Liu3Beng-A/Dummy/docs/地轨PID默认值调整_20261017.md

# 地轨 PID 默认值调整（2026-10-17）

## 用户要求与范围

按用户截图，将地轨（节点7、57电机）默认位置环参数调整为：

| 参数 | 调整前的电机工厂默认 | 本轮默认 |
|---|---:|---:|
| KP | 350 | 150 |
| KV | 320 | 180 |
| KI | 25 | 25 |
| KD | 50 | 50 |

电机固件和新上位机保持一致，文档同步记录要求、修改和生效条件。截图中的“最近回读KP=250”是当时设备值，不作为旧工厂默认值。其他节点默认值、控制算法、控制频率、保护及存储分区均不调整；未授权或执行自动写入设备、烧录及Git提交。

## 源码改动

- `firmware_new/dummy-motor-fw/UserApp/main.cpp`：仅修改 `MOTOR_TYPE == 57` 工厂默认初始化的KP/KV及日期注释。CMake的 `motor-57` 目标显式定义该类型，运行时固定节点7。35、42、夹爪仍为原来的200/80/300/250。
- `Dummy上位机/app/protocol/constants.py`：定义 `RAIL_PID_DEFAULTS`，值为150/180/25/50。
- `Dummy上位机/app/core/parameter_edits.py`：首次创建motor/7的PID编辑状态时使用上述默认；其他节点和非PID参数沿用原逻辑。已有编辑状态不重建，不改界面布局。
- 新上位机模型、控制器及UI的参数测试覆盖节点7默认、切换节点、保留草稿和真实回读优先；此前PID内联说明检查一并回归。
- 本记录、上位机README、地轨方案、旧PID协议记录及SESSION同步最新要求；旧参数/协议历史不删除。

根目录 `串口助手_old.py` 没有电机工厂默认表，其PID初始0只是查询前占位，仍通过查询显示实际值；本轮未新增接口或改变其占位行为，也未改只供参考的 `串口助手.py`。

## 生效方式

电机配置加载仍是有效EEPROM优先。无有效配置或用户显式执行恢复默认流程时，新工厂默认才写入配置；仅升级固件不会覆盖已保存的PID，不需要为改PID清除编码器校准表。

新上位机选择节点7、首次尚未回读时，编辑框使用150/180/25/50，最近回读仍为空，不把本地初始值当成设备值，也不会自动发送。未改过的字段收到实际回读后采用真实值；已有草稿保留，回读单独更新。切换页面或节点不会用新默认覆盖草稿。

若现有设备也要采用这组值，可在失能后选择节点7，填入150/180/25/50，点击“保存PID”，再“读取PID”核对。该保存沿用现有 `#SET_PID 7 150 180 25 50`，直接写EEPROM；普通转发确认不等于EEPROM物理保存完成。本轮未替用户下发该指令。

## 构建与验证

统一构建命令：

```powershell
powershell -NoProfile -ExecutionPolicy Bypass -File .\tools\build_firmware.ps1 -ReleaseId 2026101703
python .\tools\verify_firmware_artifacts.py
```

五套ELF/MAP/HEX/BIN/manifest均在唯一当前目录 `firmware_artifacts/`：

- release：`2026101703`
- buildset：`B60B807480C2475D`
- source SHA256：`84e03afc0323228bb53b0d03328496539217f6faa8b604118e2b8efd3d177390`
- 相对17.02的生产源码摘要仅 `dummy-motor-fw/UserApp/main.cpp` 改变。主控、35、42、夹爪BIN去掉56字节固件身份后均与原版一致；只需为本次默认值变化更新57电机，仍遵守EEPROM优先。

| 目标 | Flash使用/余量（B） | linked RAM使用/余量（B） |
|---|---:|---:|
| 主控 | 615820 / 301684 | 125312 / 5760 |
| motor-35 | 96660 / 620 | 15576 / 4904 |
| motor-42 | 96660 / 620 | 15576 / 4904 |
| motor-57 | 96652 / 628 | 15576 / 4904 |
| motor-gripper | 96444 / 836 | 15576 / 4904 |

各目标Flash、linked RAM及相关 `.su` 栈记录相比17.02均无增量。电机的流式执行、编码器更新、20kHz回调和位置闭环六个热路函数，去除符号目标前的重定位地址后，解码指令及调用结构一致。最初逐字节比较因57链接中数学库地址重定位而拒绝，已保留该方法修正说明，没有将其当成控制算法变化或掩盖实机失败。

新上位机参数模型、控制器、UI及PID说明共51项测试通过，耗时32.348秒；覆盖未回读默认不伪造回读、不自动发送、节点往返保留草稿、实际值更新未修改字段并保留已修改字段。静态构建/栈记录不能代替实机调参、栈水位或20kHz周期测量，未声称这组PID已在本轮实机验证。

## 留证与后续

`firmware_artifacts/verification.json`、`CURRENT_RELEASE.txt`、`SHA256SUMS.txt`为本次当前产物记录。`firmware_artifacts/rail-pid-defaults-2026101703/`保留上一批48个正式产物/校验文件、基线哈希、链接差异审计及本轮测试/源码记录；历史包不是当前烧录来源。

现有17.02主控纯计算诊断能力保持，不据此恢复普通MoveL、连续手柄或任何尚未通过实机验收的路径。并行离线研究已获知正式身份与电机默认源发生外部授权变化，应继续使用其原冻结副本，不把新批次替代原研究证据。
