Liu3Beng-A/Dummy/docs/地轨电机加入方案.md

# 地轨电机加入方案（地轨仅加入 MoveJ，不加入 MoveL 逆解）

> **2026-10-17 当前参数**：按用户新要求，J7（57）工厂默认PID调整为 `KP=150、KV=180、KI=25、KD=50`，新上位机节点7未回读的初始编辑值同步。有效EEPROM仍优先，未自动覆盖设备现有值；其他节点默认值不变。要求、改动和验证见[地轨PID默认值调整记录](地轨PID默认值调整_20261017.md)。下文加入方案及旧参数均为历史记录，最新运动能力以源码及SESSION_STATUS为准。

> **2026-10-08 历史参数**：整体回退后，用户要求单独恢复J7（57）源码默认PID为`KP=350、KV=320、KI=25、KD=50`，已修改默认表并编译motor-57。已有有效EEPROM仍优先，不自动覆盖已保存参数。其余代码维持87288fb，PID事务/独立SAVE_PID仍未恢复。详见[SESSION_STATUS](SESSION_STATUS.md)。

> **2026-10-08 回退时状态（历史）**：已按用户要求恢复`87288fb23b20e1f35513e5a044fa25099d4d7122`，J7源码默认PID恢复`KP=300、KV=50、KI=30、KD=100`，有效EEPROM仍优先。本轮350/320/25/50默认值和PID事务改动均已撤销；下条保留为历史记录。详见[SESSION_STATUS](SESSION_STATUS.md)。

> **2026-10-08 历史参数试改（已撤销）**：按用户指定，J7（57）默认 PID 更新为 `KP=350、KV=320、KI=25、KD=50`，已有有效 EEPROM 仍优先；PID 应用/保存流程见 [PID调参与保存协议及测试说明](PID调参与保存协议及测试说明.md)。后续 2026-10-06 参数与测试结果保留为历史记录，不能视为新参数的实机验证。

> 编制日期：2026-10-01
> 编制人：Cursor Agent（用户授权任务）
> 涉及模块：`firmware_new/dummy-ref-core-fw`（主控）、`firmware_new/dummy-motor-fw`（电机驱动）
> 参考：`firmware/ref_core_f405`、`firmware/motor_fw_f103_57`
> 当前任务范围：**仅**加入地轨并打通 MoveJ 闭环。MoveL 逆解等高级特性本次**不**纳入。

> 2026-10-06 参数更新：J7（57）位置环 DCE 默认值采用用户实机确认的 `KP=300、KV=50、KI=30、KD=100`。100档地轨±90mm的三组SEQ往返方向差为16、25、23ms；仅降低KD到100的前一组仍相差547ms。新默认值只在EEPROM配置无效、启动初始化默认表时使用，已有有效EEPROM参数继续优先生效，不自动覆盖用户设置。57电流命令设置上限已开放到3.0A，默认电流仍为2.5A；本轮成功实测采用此前已回读确认的3.0A设置。其余章节保留加入地轨时的历史范围和方案，后续功能以当前源码及SESSION_STATUS为准。

---

## 1. 背景与目标

### 1.1 当前 firmware_new 状态（v2026-10-01）

`firmware_new` 是从 `firmware_old` 出发、逐步把 `firmware` 已积累功能搬迁过来的"重构目标树"。截至本次任务开始：

- **主控** `firmware_new/dummy-ref-core-fw/Robot/instances/dummy_robot.{h,cpp}`
  - `motorJ[0]` = ALL 广播代理（nodeID=0）
  - `motorJ[1..6]` = J1~J6 关节（nodeID=1~6，使用 `CtrlStepMotor`）
  - `hand` = `DummyHand`（**nodeID=7**，走 0x01 电流限制 / 0x02 角度协议，不走 0x07 限速位置环）
  - `motorJ[]` 数组长度只有 7（含 index 0），没有地轨位
  - `MoveJ()` 仅接 j1~j6 六个关节角
  - `MoveJoints()` / `IsMoving()` / `UpdateJointAngles()` / `Reboot()` 全部按 J1~J6 实现
  - 命令解析 `ParseCommand()` 解析 `>` / `&` / `@` 时只解 6 个浮点关节角 + 速度
  - OLED 显示 6 个关节角 + XYZ/ABC 笛卡尔位姿

- **电机端** `firmware_new/dummy-motor-fw/UserApp/`
  - `configurations.h` 中**已定义** `RAIL_FIXED_NODE_ID = 7`、`GRIPPER_FIXED_NODE_ID = 8`
  - `main.cpp` 中**仅**在 `#if MOTOR_TYPE == 8` 时强制 canNodeId = GRIPPER_FIXED_NODE_ID=8；57 电机段目前走的还是 DIP 拨码读到的 defaultNodeID（**未**强制为 7）
  - `main.cpp` 中 57 电机的默认 PID/DCE 参数 `(kp=200, kv=80, ki=300, kd=250)` 仍然等同于 35/42 通用值，**未**采用 `firmware/motor_fw_f103_57` 的 57 电机专属参数
  - `main.cpp` 中 57 电机电流限 3000 mA、`ratedCurrentAcc = 2*1000`（与 35/42 一致，**未**采用参考版本的 50 A/s 慢爬坡）
  - `CMakeLists.txt` 已配置 4 个目标 `motor-35 / motor-42 / motor-57 / motor-gripper` 一次产出 3+1 个 hex/binary

- **电机端** `firmware_new/dummy-motor-fw/Ctrl/Motor/`
  - `motor.h` 中**没有** `StallMode_t` 状态机、`ResetGoalsToCurrentPosition()` 等 57 电机专属字段
  - `motor.cpp` `CloseLoopControlTick()` 中**没有** STALL_LOCKED 闭环维持、`stallStartTick` 检测、`stallDetectRisingEdge` 上升沿等逻辑
  - `interface_can.cpp` 中**没有** 0x09 广播急停、0x5A/0x5B/0x5C 堵转相关命令、SetEnable 重构逻辑

### 1.2 PROJECT_GUIDANCE 协议（目标态）

依据 `.cursor/rules/PROJECT_GUIDANCE.mdc §1.1`：

| nodeID | 含义 | 备注 |
|---|---|---|
| 0 | ALL 广播代理 | 1 帧触发所有电机响应 |
| 1~6 | J1~J6 关节 | 与 MoveJ 顺序对齐 |
| **7** | **地轨** | **与关节同级别**，参与 `IsMoving()`、OLED 屏幕位置显示等 |
| **8** | **夹爪** | 最低级别，**不**参与 `IsMoving()`、**不**进 OLED |

也就是说：**当前代码里夹爪占了 ID=7，地轨尚不存在**。加入地轨要做的不只是新增 `motorJ[7]`，还要把夹爪的 ID 从 7 → 8 同步挪位。

### 1.3 本次任务目标（用户明确）

1. 主控固件：在 `firmware_new/dummy-ref-core-fw` 中加入地轨（nodeID=7），与 J1~J6 同级。
2. 电机固件：`firmware_new/dummy-motor-fw` 必须按 57 电机专属参数加入；保持 CMakeLists.txt 一次编译出 3 个电机固件（35 / 42 / 57）+ 1 个夹爪固件。
3. 地轨 ID **必须**为 7，电流、限速、PID/DCE、加速度等参数**参照**之前的版本（即 `firmware/motor_fw_f103_57` 与 `firmware/ref_core_f405` 的取值）。
4. **本次只加入 MoveJ**（点位同步），**不**做 MoveL 的地轨逆解；`MoveL()` 维持当前 J1~J6 IK，地轨位置保持不变。
5. 完成后输出一份方案文档（本文档），描述需要做什么工作。

---

## 2. 总体方案

### 2.1 节点表（最终态）

```
nodeID=0   → ALL 代理（占位）             CtrlStepMotor(_hcan, 0, …)
nodeID=1~6 → J1~J6 关节                   CtrlStepMotor(_hcan, 1..6, …)
nodeID=7   → J7 / 地轨                    CtrlStepMotor(_hcan, 7, true, 1, -250, 250)
nodeID=8   → 夹爪                          StepHand（继承 CtrlStepMotor, hcan, 8）
```

**`motorJ[]` 数组长度由 7 → 8**（索引 0 是 ALL 代理，1..6 是 J1~J6，7 是地轨）。`hand` 仍是独立指针，ID 由 7 改为 8。

### 2.2 复用现有 `CtrlStepMotor` 而不是新增类

参考 `firmware/ref_core_f405` 的做法：地轨电机使用与 J1~J6 **完全相同**的 `CtrlStepMotor` 类，不引入新的地轨驱动类。理由：

1. 电机端协议栈（0x01/0x07/0x14/0x15/0x17~0x1A 等）已通用，57 电机端固件只要烧同一份，**主控侧无需差异代码**。
3. reduction=1（直连丝杆 1605，5 mm/圈）；位置含义以"圈数 × 5 = mm"换算；
4. `angleLimitMin/Max = -250 / 250`（mm 单位）作为软限位栅栏，越界 MoveJ 一律拒绝（仿照参考 `firmware/ref_core_f405`）。

`firmware/ref_core_f405` 中地轨类多做了"伪°"换算和 `inverse=true`，本次实现要保留这个语义。

### 2.3 关于 StepHand（夹爪）

当前 `DummyHand` 实现类独占通道阶（独立 `CAN_TxHeaderTypeDef txHeader`、独立协议 0x01/0x02），但参考 `firmware/ref_core_f405` 已改用 `StepHand : public CtrlStepMotor`，更通用、命令集与关节一致。本期**保持**当前 `DummyHand` 类结构不变（最小变动原则），但把构造时的 nodeID 7 改为 8 即可。

如果将来要统一为 `StepHand`，可作单独一期任务。

---

## 3. 主控侧改动（`firmware_new/dummy-ref-core-fw`）

### 3.1 文件清单

| 文件 | 改动 |
|---|---|
| `Robot/instances/dummy_robot.h` | ① 增加 `RAIL_FIXED_NODE_ID = 7` 声明；② `motorJ[]` 长度 7→8；③ 加地轨成员（位置/目标位置）；④ 加 MoveJ 7 参数签名；⑤ 增加速度单位/上限常量；⑥ `hand` 注释更新 ID；⑧ 把 `jointAll` protocol 对象名仍指向 motorJ[ALL]，但要在 protocol list 里加 `rail`（可选）。 |
| `Robot/instances/dummy_robot.cpp` | ① 构造里 `new motorJ[7]` 并填构造参数；② `Delete` 循环 0..6 → 0..7；③ `Reboot()` 里给 motorJ[7] 多发一帧 0x7F 广播或保留现有 ALL 代理 1 帧（前者更稳）；④ `MoveJ()` 改为 7 参数（j1~j6 + j7_mm + speed），做地轨限位校验、计算 7 轴同步速度；⑤ `MoveJoints()` 改为 J1~J6 + 地轨电机分别下发；⑥ `UpdateJointAngles()` 轮询 1..7；⑦ `UpdateJointAnglesCallback()` 增加地轨位置回填；⑧ `IsMoving()` flag 改为 `0b01111110` (J1~J6 位为 1，地轨位 bit0 恒 0)；⑨ `Reboot()` 含 ALL 代理 1 帧即可，已能广播到 7 个电机。 |
| `UserApp/protocols/can_protocol.cpp` | 无需改动（`dummy.motorJ[id]->UpdateAngleCallback(...)` 已按 id 寻址，新加的 motorJ[7] 自动支持）。 |
| `UserApp/main.cpp` | ① `ThreadControlLoopFixUpdate()` 中 `MoveJoints()` 和 `UpdateJointPose6D()` 调用保持，UpdateJointAngles 轮询已包含地轨。② `ThreadOledUpdate()` 中加地轨显示位（详见 §3.6）。 |
| `Robot/instances/dummy_robot.h/.cpp` 增加地轨速度换算常量。 | `RAIL_MM_PER_CIRCLE = 5.0f`（丝杆 1605：5 mm/圈）。 |

### 3.2 `dummy_robot.h` 关键修改示意

```cpp
#define ALL 0
#define RAIL_FIXED_NODE_ID 7   // 与 configurations.h 对齐
#define RAIL_MM_PER_CIRCLE 5.0f // 丝杆1605

class DummyRobot {
    // ... 既有 REST_POSE 等 ...

    // 地轨状态变量（mm）
    float currentRailPos = 0.0f;
    float targetRailPos  = 0.0f;

    // 7 个电机的速度缓存（电机轴 r/s, 索引 0=地轨, 1..6=J1~J6）
    float dynamicJointSpeeds7[7] = {0};

    // motorJ: 0=ALL, 1..6=J1..J6, 7=J7/地轨
    CtrlStepMotor* motorJ[8] = {nullptr};
    DummyHand* hand = {nullptr};

    // MoveJ 加 2 个参数：_j7_mm 和 _speed
    bool MoveJ(float _j1, float _j2, float _j3, float _j4,
               float _j5, float _j6, float _j7_mm, float _speed = 0);

    // ... 其他既有 API ...

    auto MakeProtocolDefinitions() {
        return make_protocol_member_list(
            make_protocol_function("homing",         *this, &DummyRobot::Homing),
            make_protocol_function("resting",        *this, &DummyRobot::Resting),
            make_protocol_object("joint_1", motorJ[1]->MakeProtocolDefinitions()),
            make_protocol_object("joint_2", motorJ[2]->MakeProtocolDefinitions()),
            make_protocol_object("joint_3", motorJ[3]->MakeProtocolDefinitions()),
            make_protocol_object("joint_4", motorJ[4]->MakeProtocolDefinitions()),
            make_protocol_object("joint_5", motorJ[5]->MakeProtocolDefinitions()),
            make_protocol_object("joint_6", motorJ[6]->MakeProtocolDefinitions()),
            make_protocol_object("joint_all", motorJ[ALL]->MakeProtocolDefinitions()),
            make_protocol_object("hand", hand->MakeProtocolDefinitions()),
            make_protocol_function("reboot", *this, &DummyRobot::Reboot),
            make_protocol_function("set_enable", *this, &DummyRobot::SetEnable, "enable"),
            // ... 其他既有协议项保持 ...
            // move_j 参数加 j7 和 speed（默认 11 维持兼容，但本期以 8 参数为主）
            make_protocol_function("move_j", *this, &DummyRobot::MoveJ,
                                 "j1", "j2", "j3", "j4", "j5", "j6", "j7", "speed"),
            make_protocol_function("move_l", *this, &DummyRobot::MoveL,
                                   "x", "y", "z", "a", "b", "c")
            // ... 其他保持 ...
        );
    }
};
```

### 3.3 `dummy_robot.cpp` 关键修改

**构造与析构**：

```cpp
DummyRobot::DummyRobot(CAN_HandleTypeDef* _hcan) : hcan(_hcan) {
    motorJ[0] = new CtrlStepMotor(_hcan, 0, false, 1, -180, 180);
    motorJ[1] = new CtrlStepMotor(_hcan, 1, false, 50, -175, 175);
    motorJ[2] = new CtrlStepMotor(_hcan, 2, true,  50,  -75,  90);
    motorJ[3] = new CtrlStepMotor(_hcan, 3, true,  50,    0, 180);
    motorJ[4] = new CtrlStepMotor(_hcan, 4, true,  50, -270, 270);
    motorJ[5] = new CtrlStepMotor(_hcan, 5, true,  50, -100, 100);
    motorJ[6] = new CtrlStepMotor(_hcan, 6, true,  30, -180, 180);
    // [NEW] 地轨：直连丝杆1605, 5mm/圈, 软限位 -250~250 mm
    motorJ[7] = new CtrlStepMotor(_hcan, 7, true, 1, -250, 250);

    hand = new DummyHand(_hcan, 8);    // [FIX] 夹爪 ID: 7 → 8

    dof6Solver = new DOF6Kinematic(...);
}

DummyRobot::~DummyRobot() {
    for (int j = 0; j <= 7; j++)   // [FIX] 0..6 → 0..7
        delete motorJ[j];
    delete hand;
    delete dof6Solver;
}
```

**MoveJ**（核心：仿参考 `firmware/ref_core_f405` 的 7 轴版本，按当前 `firmware_new` 简化）：

```cpp
bool DummyRobot::MoveJ(float _j1, float _j2, float _j3, float _j4,
                       float _j5, float _j6, float _j7_mm, float _speed) {
    DOF6Kinematic::Joint6D_t targetJointsTmp(_j1, _j2, _j3, _j4, _j5, _j6);

    // 地轨限位
    if (_j7_mm > motorJ[7]->angleLimitMax || _j7_mm < motorJ[7]->angleLimitMin)
        return false;
    // 关节限位
    for (int j = 1; j <= 6; j++) {
        if (targetJointsTmp.a[j-1] > motorJ[j]->angleLimitMax ||
            targetJointsTmp.a[j-1] < motorJ[j]->angleLimitMin)
            return false;
    }

    // 本期简化版：先按用户给定 speed 直接下发（按各轴距离反推电机轴 r/s）
    // 后续同步抵达算法可参考 ComputeSyncSpeeds 实现，但本期不要求
    float slider = _speed > 0 ? _speed : (jointSpeedSlider); // 1~100
    float baseRps = slider * 0.30f;  // 100 → 30 r/s

    DOF6Kinematic::Joint6D_t deltaJoints = targetJointsTmp - currentJoints;
    float deltaRail = _j7_mm - currentRailPos;
    uint8_t idx;
    float maxJointAngle = AbsMaxOf6(deltaJoints, idx);
    float maxAbs = maxJointAngle;
    if (fabsf(deltaRail) > maxAbs) maxAbs = fabsf(deltaRail);
    // 单轴限速 30 r/s；地轨直连 reduction=1 直接 rps；关节 reduction=50 转/°×s/360
    for (int j = 1; j <= 6; j++) {
        float rps = fabsf(deltaJoints.a[j-1]) * motorJ[j]->reduction / 360.0f / maxAbs * baseRps;
        dynamicJointSpeeds7[j] = rps;
    }
    dynamicJointSpeeds7[0] = fabsf(deltaRail) / 5.0f / maxAbs * baseRps;

    jointsStateFlag = 0;
    targetJoints = targetJointsTmp;
    targetRailPos = _j7_mm;
    return true;
}
```

> ⚠️ **修订（2026-10-01 续）**：上示"按距离比例限速"是中间稿方案，存在**单位混用 + 没有物理上限 + 没有加速度约束**三大缺陷（详见 §3.3.1 §A）。**该方案将被 §3.3.1 物理同步算法替换**，但为了便于对照"为什么需要升级"，原始简化版保留在此处作为参考。下文 §3.3.1 为加强版方案，将由本次工作一并落地。
>
> 本期实现用最简单的"按距离比例限速"，**不**上 v2.7 那种"按梯形曲线模型+加速度感知的迭代同步抵达"。**为什么**：当前任务边界是"打通 MoveJ"，不是"上整套同步抵达算法"。`ComputeSyncSpeeds` 涉及加速度回填、梯形时间、迭代收敛，工程量大；本期先做基础联调，留 TODO 在 `MoveJ` 注释里。
>
> 如果用户后续要升级，再独立安排任务。

### 3.3.1 加强版：物理同步算法（梯形曲线 + 迭代收敛）

> **状态**：在 §3.3 简化版"按距离比例限速"基础上加强。本节方案与参考版本 `firmware/ref_core_f405/Robot/instances/dummy_robot.cpp:31-128` 的 `ComputeSyncSpeeds` v2.7 对齐。
>
> **简化版与加强版的关系**：简化版代码保留在 §3.3 作为对照（中间稿）；加强版代码将直接替换 §3.3 中 `MoveJ` 的速度分配段落。
>
> **索引约定**：本节数组索引 `[0..6]` 7 个槽位 — `i=0`=地轨，`i=1..6`=J1~J6。与 §3.3 的 `dynamicJointSpeeds7[7]` 索引相反（那里 `dynamicJointSpeeds7[0]`=地轨，`[1..6]`=关节）；调用时需做一次索引映射。

#### A. 为什么做加强版

简化版"按距离比例限速"存在三个根本缺陷，无法满足"7 轴同步抵达"的物理语义：

| 缺陷 | 说明 |
|---|---|
| **单位混用** | `maxAbs = max(maxJoint(°), |Δrail(mm)|)` 把"度"和"毫米"直接比大小。当 `J1=90°`+`rail=100mm` 时，`maxAbs=100`（mm 更大），关节会被压速；反之 `J1=180°`+`rail=50mm` 时，`maxAbs=180`，地轨被压速。同步语义取决于"哪个数字碰巧更大"，与物理无关。 |
| **没有物理上限** | 不查每轴 `ratedVelocity`（电机端 EEPROM 上限速 `velocityLimit`）。简化版下发的速度可能超过电机端能力，被电机端梯形曲线再次压回，结果是"主控说 3.33s 跑完，电机端 4.2s 才到位"，IsMoving() 的 FINISH 时间与主控预估不一致。 |
| **没有加速度约束** | 电机端 PositionTracker 走梯形加减速，主控的"瞬时到顶速"模型与电机端不一致。短距离运动（如 `J1=5°`）时，电机端因为距离太短会退化为三角形曲线（无匀速段），主控以为的匀速段在电机端根本不存在。 |

**对比示例**（`slider=100`、`V_max=30 r/s`、地轨与 J1 同跑、J1 用 `A=150 r/s²`）：

| 输入 | 简化版预估时间 | 加强版预估时间 | 差异原因 |
|---|---|---|---|
| `J1 90°`，`rail=0` | 3.0s | 0.825s（电机轴 20 r/s × 360/50=144°/s） | 简化版用 `baseRps=30` 给关节分摊，关节角速度 = 30°/s；加强版按 J1 物理 V_max=30 r/s 走，速度=144°/s |
| `J1 0°`，`rail=100mm` | 3.33s | 0.97s | 简化版按数值归一化；加强版按 rail 物理 V_max=30 r/s 走 |
| `J1 90°`，`rail=100mm` | 3.33s | ~1.1s | 加强版迭代收敛到 T_sync ≈ max(T_j1, T_rail) ≈ 1.1s |

物理同步版能正确利用每轴的物理上限，同步时间显著紧凑，且每轴速度不超过电机端 `velocityLimit`。

#### B. 算法概述

每个电机端跑自己的梯形曲线（`firmware_new/dummy-motor-fw/Ctrl/Motor/motion_planner.cpp PositionTracker`）。主控要为 7 个轴算出"同一时刻到达"的匀速段速度 `v_i`：

```
已知：
  D_i   — 各轴电机轴转数（关节: |Δ°| × reduction/360；地轨: |Δmm| / 5）
  V_max_i — 各轴额定速度（电机端 EEPROM velocityLimit；本期用主控常量）
  A_i   — 各轴额定加速度（电机端 EEPROM velocityAcc；本期用主控常量）
  sliderSpeed — 用户意图上限（slider × 0.30 r/s，slider∈[1,100]）

约束：
  各轴匀速段速度 v_i ≤ min(V_max_i, sliderSpeed)
  梯形曲线时间 T_i = timeTrapezoid(D_i, v_i, A_i)
  同步时间 T_sync = max_i(T_i) 最小化
```

**步骤 1**：把每个轴目标位移换算成电机轴圈数
```
D_motor[0] = |Δmm| / RAIL_MM_PER_CIRCLE   // 地轨 reduction=1
D_motor[i] = |Δ°| × MOTOR_REDUCTION[i] / 360   // i=1..6
```

**步骤 2**：单轴梯形曲线总时间 `timeTrapezoid(D, v, a)`
```
d_acc = v² / (2a)            // 单边加速距离
if 2*d_acc >= D:              // 距离太短 → 三角形（无匀速段）
    T = 2 × sqrt(D / a)
else:                          // 梯形（加速→匀速→减速）
    T = 2v/a + (D - 2*d_acc)/v = v/a + D/v
```

**步骤 3**：迭代收敛（最多 10 轮，一般 2~3 轮收敛）

- **初始预算**：`T_sync = max_i timeTrapezoid(D_i, min(V_max_i, sliderSpeed), A_i)`
- **每轮**：对每个轴解二次方程反推匀速段速度
  ```
  T = v/a + D/v
  → v² - (T·a)·v + D·a = 0
  → v = (T·a - sqrt((T·a)² - 4·D·a)) / 2
  ```
  - 钳制：`v = min(v, V_max_i, sliderSpeed)`
  - 用 `v` 重算 `timeTrapezoid(D_i, v, A_i)` → 新一轮的 `T_sync`
- **收敛**：`|T_new - T_sync| < 1e-3` 退出

**步骤 4**：输出 `outSpeeds[7]`（电机轴 r/s）+ `timeBudget`（同步总时间，秒）

> ⚠️ 二次方程判别式 `< 0` 处理：当 `T_sync` 不足某轴跑完所需最低三角形时间时，`disc<0`。钳到 0 让反推公式自然算出"刚够用"的速度，避免短距离运动突然飙到 cap。

#### C. 改动清单

**主控** `firmware_new/dummy-ref-core-fw`：

| 文件 | 改动 |
|---|---|
| `Robot/instances/dummy_robot.h` | ① 加 `constexpr uint8_t MOTOR_REDUCTION[7] = {1, 50, 50, 50, 50, 50, 30}`；② 加 `constexpr float SLIDER_CAPS_V[7] = {30, 30, 30, 30, 30, 30, 30}`（电机轴 r/s 上限，本期统一 30）；③ 加 `constexpr float JOINT_ACC_FALLBACK[7] = {30, 150, 100, 200, 200, 200, 200}`（r/s²，主控常量兜底）；④ 加 `float jointAccRuntime[7] = {30, 150, 100, 200, 200, 200, 200}`（运行时回填槽，本期用上面常量初始化，异步回填逻辑属 §9 #7 不在本期） |
| `Robot/instances/dummy_robot.cpp` | ① 加静态函数 `timeTrapezoid(D, v, a)`；② 加静态函数 `ComputeSyncSpeeds(deltaRails[7], sliderCaps[7], accel[7], sliderSpeed, outSpeeds[7])`；③ `MoveJ` 内的"按距离比例限速"段落替换为调用 `ComputeSyncSpeeds` 输出 `dynamicJointSpeeds7[7]`；④ 顺手把 `motorJ[7]` 构造参数从字面量 `7` 改为 `RAIL_FIXED_NODE_ID`（**已改**） |

**电机端** `firmware_new/dummy-motor-fw`：**不动**。

**串口助手** `串口助手_old.py`：**不动**。

**文档**：本文档 §3.3.1（新增）。

#### D. 关键参数取值

| 轴 | MOTOR_REDUCTION | SLIDER_CAPS_V (r/s) | JOINT_ACC_FALLBACK (r/s²) | 来源 |
|---|---|---|---|---|
| 地轨 (`id=7`) | 1 | 30 | 30 | 电机端 57 段 `velocityLimit`/`velocityAcc`（`main.cpp:75-76`） |
| J1 (`id=1`) | 50 | 30 | 150 | `DEFAULT_JOINT_ACCELERATION_BASES.a[0]=150` |
| J2 (`id=2`) | 50 | 30 | 100 | `.a[1]=100` |
| J3 (`id=3`) | 50 | 30 | 200 | `.a[2]=200` |
| J4 (`id=4`) | 50 | 30 | 200 | `.a[3]=200` |
| J5 (`id=5`) | 50 | 30 | 200 | `.a[4]=200` |
| J6 (`id=6`) | 30 | 30 | 200 | `.a[5]=200`（注意 reduction 与其它不同） |

> 注：`MOTOR_REDUCTION[6]=30` 对应 `motorJ[6] = new CtrlStepMotor(_hcan, 6, true, 30, -180, 180)`；地轨/其余关节 reduction 在主控 `dummy_robot.cpp:24-31`。

> 后续 §9 #7（PID/DCE/电流的运行时查询）落地时，可加入 `#GET_ACC` 协议回填 `jointAccRuntime[i]`，自动替换 `JOINT_ACC_FALLBACK[i]`。

#### E. 关键代码示意

```cpp
// dummy_robot.cpp（新增静态函数，文件作用域）

static float timeTrapezoid(float d, float v, float a) {
    if (d < 1e-6f || v < 1e-6f || a < 1e-6f) return 0;
    float d_acc = v * v / (2.0f * a);
    if (2.0f * d_acc >= d)
        return 2.0f * sqrtf(d / a);          // 三角形曲线
    return 2.0f * v / a + (d - 2.0f * d_acc) / v;  // 梯形曲线
}

static float ComputeSyncSpeeds(const float deltaRails[7],
                               const float sliderCaps[7],
                               const float accel[7],
                               float sliderSpeed,
                               float outSpeeds[7]) {
    // 步骤 1：距离 → 电机轴圈数（索引 0=地轨 mm，1..6=关节°）
    float distMotor[7];
    for (int i = 0; i < 7; i++) {
        distMotor[i] = (i == 0)
            ? fabsf(deltaRails[i]) / RAIL_MM_PER_CIRCLE
            : fabsf(deltaRails[i]) * (float)MOTOR_REDUCTION[i] / 360.0f;
    }

    // 步骤 2：初始预算 = 各轴在 sliderSpeed（钳到 cap）下的梯形时间，取 max
    float timeBudget = 0;
    for (int i = 0; i < 7; i++) {
        if (distMotor[i] < 1e-6f) continue;
        float a = (accel[i] > 1e-6f) ? accel[i] : JOINT_ACC_FALLBACK[i];
        float v = fminf(sliderSpeed, sliderCaps[i]);
        float t = timeTrapezoid(distMotor[i], v, a);
        if (t > timeBudget) timeBudget = t;
    }
    if (timeBudget < 1e-6f) {
        for (int i = 0; i < 7; i++) outSpeeds[i] = 0;
        return 0.0f;
    }

    // 步骤 3：迭代收敛（最多 10 轮）
    for (int iter = 0; iter < 10; iter++) {
        float newTimeBudget = 0;
        for (int i = 0; i < 7; i++) {
            if (distMotor[i] < 1e-6f) { outSpeeds[i] = 0; continue; }
            float a = (accel[i] > 1e-6f) ? accel[i] : JOINT_ACC_FALLBACK[i];
            float vc = sliderCaps[i];
            float disc = timeBudget * timeBudget - 4.0f * distMotor[i] / a;
            if (disc < 0) disc = 0;     // 临界抖动
            float v = (timeBudget - sqrtf(disc)) * a * 0.5f;
            if (v > vc) v = vc;
            if (v > sliderSpeed) v = sliderSpeed;
            outSpeeds[i] = v;
            float t = timeTrapezoid(distMotor[i], v, a);
            if (t > newTimeBudget) newTimeBudget = t;
        }
        if (fabsf(newTimeBudget - timeBudget) < 1e-3f) {
            timeBudget = newTimeBudget;
            break;
        }
        timeBudget = newTimeBudget;
    }
    return timeBudget;
}
```

`MoveJ` 中替换段：

```cpp
// 替换 §3.3 MoveJ 中"按距离比例限速"段（dummy_robot.cpp:103-122）
float slider = _speed > 0 ? _speed : 50.0f;
if (slider < 1) slider = 1;
if (slider > 100) slider = 100;
float sliderSpeedRps = slider * 0.30f;          // 100 → 30 r/s

// 各轴目标位移：索引 0=地轨 mm，1..6=关节°
float deltaRails[7] = {
    _j7_mm - currentRailPos,                    // 地轨 mm
    targetJointsTmp.a[0] - currentJoints.a[0],
    targetJointsTmp.a[1] - currentJoints.a[1],
    targetJointsTmp.a[2] - currentJoints.a[2],
    targetJointsTmp.a[3] - currentJoints.a[3],
    targetJointsTmp.a[4] - currentJoints.a[4],
    targetJointsTmp.a[5] - currentJoints.a[5],
};
float jointAcc[7] = {
    jointAccRuntime[0], jointAccRuntime[1], jointAccRuntime[2],
    jointAccRuntime[3], jointAccRuntime[4], jointAccRuntime[5],
    jointAccRuntime[6],
};

float outSpeeds[7] = {0};
float timeBudget = ComputeSyncSpeeds(deltaRails, SLIDER_CAPS_V, jointAcc,
                                    sliderSpeedRps, outSpeeds);
// （可选）Respond(*uart4StreamOutputPtr, "ok t=%.3f", timeBudget);

// 写回 dynamicJointSpeeds7：[0]=地轨，[1..6]=J1..J6
dynamicJointSpeeds7[0] = outSpeeds[0];
for (int j = 1; j <= 6; j++) {
    dynamicJointSpeeds7[j] = outSpeeds[j];
    dynamicJointSpeeds.a[j - 1] = outSpeeds[j];   // ServoJ 兼容旧字段
}

jointsStateFlag = 0;
targetJoints = targetJointsTmp;
targetRailPos = _j7_mm;
return true;
```

#### F. 测试用例（烧录后）

| 输入 | 期望同步时间 | 验证方式 |
|---|---|---|
| `>0,0,0,0,0,0,0,100`（不动） | 0（所有轴距离=0） | 串口助手日志；电机端无 CAN 0x07 下发 |
| `>0,0,90,0,0,0,0,100` | 0.825s | J3 电机端 0x22/0x23 回包 FINISH 时间 |
| `>0,0,0,0,0,0,100,100` | 0.97s | 地轨电机端 FINISH 时间 |
| `>0,0,90,0,0,0,100,100` | ~1.1s | 7 个电机 FINISH 时间聚集在 ±50ms |
| `>90,90,90,90,90,90,100,100`（全轴大动作） | ~2.5s | 7 个电机同时完成 |
| `>0,0,5,0,0,0,0,100`（短距离） | ~0.3s（三角形曲线） | 验证距离太短时退化为三角形 |

#### G. 不在本节范围（与 §9 一致）

- 电机端回填 `jointAccRuntime[i]`（task §9 #7）— 本节用 `JOINT_ACC_FALLBACK[i]` 兜底
- 串口助手 `_fill_joints` 修复（task 范围外，已知 bug）
- `#GETJPOS` 含 rail + `#REBOOT` 支持 7/8（task 范围外，已知 bug）

**MoveJoints**：分别下发 J1~J6 + 地轨。

```cpp
void DummyRobot::MoveJoints(DOF6Kinematic::Joint6D_t _joints) {
    for (int j = 1; j <= 6; j++) {
        motorJ[j]->SetAngleWithVelocityLimit(_joints.a[j-1] - initPose.a[j-1],
                                             dynamicJointSpeeds.a[j-1]);
    }
    // 地轨：mm → 电机轴圈数 = mm / 5
    motorJ[7]->SetAngleWithVelocityLimit(targetRailPos, dynamicJointSpeeds7[0]);
}
```

**UpdateJointAngles / UpdateJointAnglesCallback / IsMoving**：

```cpp
void DummyRobot::UpdateJointAngles() {
    // 简单轮询：本期先每帧查一个轴，1~7 循环（仿参考 v3.2 方案C）
    static int idx = 1;
    motorJ[idx]->UpdateAngle();
    idx = (idx >= 7) ? 1 : idx + 1;
}

void DummyRobot::UpdateJointAnglesCallback() {
    for (int i = 1; i <= 6; i++) {
        currentJoints.a[i-1] = motorJ[i]->angle + initPose.a[i-1];
        if (motorJ[i]->state == CtrlStepMotor::FINISH)
            jointsStateFlag |= (1 << i);
        else
            jointsStateFlag &= ~(1 << i);
    }
    // 地轨：motorJ[7]->angle 单位是"电机轴圈×360"（reduction=1）
    // 反推 mm: motorJ[7]->angle / 360 × 5
    currentRailPos = motorJ[7]->angle / 360.0f * RAIL_MM_PER_CIRCLE;
    // 地轨回包到位也置 bit7 标记（与 J1~J6 同样算"已到位"）
    // 但本期 IsMoving 用 6 个关节就够（地轨与臂同步），简化起见：
    // 地轨位 bit7 不强制置位，IsMoving 主要看 J1~J6 bit1~6
}

bool DummyRobot::IsMoving() {
    return jointsStateFlag != 0b01111110;  // bit1~6 全置位 → FINISH
    // 注：bit0/7 不参与判定。地轨走 motorJ[7]->state 自行判定。
}
```

**Reboot / SetEnable / !STOP**：参考 `firmware/ref_core_f405` 的设计：

```cpp
void DummyRobot::Reboot() {
    // ALL 代理 1 帧 → (0<<7)|0x7F = 0x7F, 触发 J1~J7 同时重启
    motorJ[ALL]->Reboot();
    hand->Reboot();
    osDelay(500);
    HAL_NVIC_SystemReset();
}

void DummyRobot::SetEnable(bool _enable) {
    motorJ[ALL]->SetEnable(_enable);   // ALL 代理广播使能（含地轨）
    hand->SetEnable(_enable);
    isEnabled = _enable;
    if (_enable) motorJ[ALL]->UpdateAngle();  // 预发一次回包请求
}
```

> 后期 `!STOP` 软停（按 PROJECT_GUIDANCE §1.1：夹爪不参与急停）接入时，本期 `Reboot/SetEnable` 不需要改；仅在 `CommandHandler::EmergencyStop` 中跳过 hand 即可。

**Homing / Resting**：仿参考实现：

```cpp
void DummyRobot::Homing() {
    float lastSpeed = jointSpeed;
    SetJointSpeed(10);
    MoveJ(0, 0, 90, 0, 0, 0, 0, 10);   // J1~J6 = 0,0,90,0,0,0 + 地轨 = 0mm
    MoveJoints(targetJoints);
    while (IsMoving()) osDelay(10);
    SetJointSpeed(lastSpeed);
}
```

**ParseCommand (`>`、`&` 命令解析)**：本期将命令格式由 6 关节改为 7 关节 + speed（参考实现）：

```cpp
case COMMAND_TARGET_POINT_SEQUENTIAL:
case COMMAND_TARGET_POINT_INTERRUPTABLE:
case COMMAND_CONTINUES_TRAJECTORY:
    if (_cmd[0] == '>' || _cmd[0] == '&') {
        // 新格式：>j1,j2,j3,j4,j5,j6,j7(rail),speed
        float j1, j2, j3, j4, j5, j6, j7, speed = 0;
        int argNum;
        if (_cmd[0] == '>')
            argNum = sscanf(_cmd.c_str(), ">%f,%f,%f,%f,%f,%f,%f,%f",
                            &j1, &j2, &j3, &j4, &j5, &j6, &j7, &speed);
        else
            argNum = sscanf(_cmd.c_str(), "&%f,%f,%f,%f,%f,%f,%f,%f",
                            &j1, &j2, &j3, &j4, &j5, &j6, &j7, &speed);

        if (argNum == 8) SetJointSpeed(speed);
        if (argNum >= 7) {
            if (MoveJ(j1, j2, j3, j4, j5, j6, j7, speed)) {
                MoveJoints(targetJoints);
                // 立刻回应 ok
                Respond(*usbStreamOutputPtr, "ok");
                Respond(*uart4StreamOutputPtr, "ok");
            }
        }
    }
    break;
```

> ⚠️ 串口助手_old需要同步支持新格式（`>j1,j2,j3,j4,j5,j6,j7,speed`）。`串口助手_old.py` 改起来不大，但要列入交付清单。

### 3.4 `MoveL` 不改

按用户明确要求，本期 **MoveL 不动**。`MoveL()` 仍只解 J1~J6 IK，地轨位置保持不变。在 `MoveL` 末尾补一句：

```cpp
// 本期：MoveL 不动地轨；地轨保持当前位置
targetRailPos = currentRailPos;
return MoveJ(/* new IK joints */, currentRailPos, 0);
```

（或者保持现有 `MoveL` 不返回地轨参数，在 caller（ParseCommand）处把 `targetRailPos` 同步为 currentRailPos。）

### 3.5 Reboot 验证

参考 `firmware/ref_core_f405` 的"ALL 代理 1 帧 + 夹爪 1 帧"模式，已经能把 J1~J7 + 夹爪（共 8 个电机）全部重启，无需在主控多发 1 帧地轨的 0x7F 帧。

### 3.6 OLED 显示（ThreadOledUpdate）

`firmware/ref_core_f405` 把地轨作为单独的 OLED 行，本期至少要在 J1~J6 行后加一项地轨 mm 值：

```cpp
oled.setCursor(0, 30);
oled.printf(">%3d|%3d|%3d|%3d|%3d|%3d|%3dmm",
            (int) roundf(dummy.currentJoints.a[0]),
            (int) roundf(dummy.currentJoints.a[1]),
            (int) roundf(dummy.currentJoints.a[2]),
            (int) roundf(dummy.currentJoints.a[3]),
            (int) roundf(dummy.currentJoints.a[4]),
            (int) roundf(dummy.currentJoints.a[5]),
            (int) roundf(dummy.currentRailPos));
```

按 PROJECT_GUIDANCE §1.1 "参与 OLED 屏幕位置显示"，地轨 mm 值需要显示。

### 3.7 串口助手同步

`串口助手.py` 中发送 `>` / `&` 指令处需要支持新格式（7 个关节 + 地轨 mm + 速度）。这是上位机层面的配套改动，**不**改固件逻辑。

---

## 4. 电机端改动（`firmware_new/dummy-motor-fw`）

### 4.1 文件清单

| 文件 | 改动 |
|---|---|
| `UserApp/configurations.h` | 已定义 `RAIL_FIXED_NODE_ID = 7`，无需改。 |
| `UserApp/main.cpp` | ① 57 电机段（`#if MOTOR_TYPE == 57`）的 boardConfig 默认值：电流2500mA、DCE kp=300/kv=50/ki=30/kd=100（2026-10-06实测更新）、stall protect 默认 true；② 57 电机段增加 `boardConfig.canNodeId = RAIL_FIXED_NODE_ID` 强制设置；③ 57 电机段 `ratedCurrentAcc = 50 * 1000`（mA/s）。 |
| `Ctrl/Motor/motor.h` | **本期不引入** StallMode 状态机（用户边界只到 MoveJ）。Stall Protect 默认开启在 main.cpp 里写死即可。 |
| `Ctrl/Motor/motor.cpp` | **本期不引入** STALL_LOCKED 闭环维持等代码。 |
| `UserApp/protocols/interface_can.cpp` | **本期不引入** 0x09 广播急停、0x5A/0x5B/0x5C 等命令。 |
| `CMakeLists.txt` | 已有 4 个目标，无需改。 |

### 4.2 `main.cpp` 中 57 电机参数改造

默认表最初参考 `firmware/motor_fw_f103_57/UserApp/main.cpp`，其中DCE四项已按2026-10-06的J7实机结果更新，结合 `firmware_new/dummy-motor-fw` 现有格式：

```cpp
#elif MOTOR_TYPE == 57
    boardConfig = BoardConfig_t{
        .configStatus = CONFIG_OK,
        .encoderHomeOffset = 0,
        .defaultMode = Motor::MODE_COMMAND_POSITION,
        // 57地轨电机：参考版本 currentLimit=2500~2800mA
        .currentLimit = 2500,                  // mA
        .velocityLimit = 30 * Motor::MOTOR_ONE_CIRCLE_SUBDIVIDE_STEPS,  // 30 r/s
        .velocityAcc   = 30 * Motor::MOTOR_ONE_CIRCLE_SUBDIVIDE_STEPS,  // 30 r/s²
        .calibrationCurrent = 2000,
        // J7 DCE defaults confirmed by the 2026-10-06 bidirectional 100-speed test.
        .dce_kp = 300, .dce_kv = 50, .dce_ki = 30, .dce_kd = 100,
        .motor_temperature = 0.0,
        .enableMotorOnBoot = false,
        .enableStallProtect = true,   // 57 地轨默认开启堵转保护
        .enableTempWatch = false,
    };
```

并在 57 段底部加：

```cpp
#if MOTOR_TYPE == 57
    motor.config.motionParams.ratedCurrentAcc = 50 * 1000;  // mA/s
    // 强制 nodeID（不读 DIP 开关）
    boardConfig.canNodeId = RAIL_FIXED_NODE_ID;
#elif MOTOR_TYPE == 8
    motor.config.motionParams.ratedCurrentAcc = 2 * 1000;   // mA/s（与通用一致）
    boardConfig.canNodeId = GRIPPER_FIXED_NODE_ID;
#endif
```

> 注：57 电机的 PID 参数（kp/ki/kd）和堵转保护开关的差异化逻辑（motor.config.ctrlParams.pid 与 .stallProtectSwitch）**本期不在 motor.h/.cpp 引入**，仅在 main.cpp 中通过 boardConfig 写 eeprom 默认值即可。这避免了与本期任务边界外的代码改动交叉。

### 4.3 一次产出 3 个电机固件

`firmware_new/dummy-motor-fw/CMakeLists.txt` 现状已经满足：

```cmake
set(MOTOR_TARGETS motor-35 motor-42 motor-57 motor-gripper)
set(MOTOR_TYPES 35 42 57 8)
foreach ... add_executable(${TARGET_NAME}.elf ...) ...
```

构建命令（PowerShell，参照 PROJECT_GUIDANCE §4.2）：

```powershell
cd E:\Dummy-code\firmware_new\dummy-motor-fw\build
cmake -G Ninja ..
ninja           # 默认 Debug；一次产出 4 个 hex/binary
```

产物：

- `build/motor-35.{elf,hex,bin}`
- `build/motor-42.{elf,hex,bin}`
- `build/motor-57.{elf,hex,bin}` ← **地轨固件，烧到 57 电机板**
- `build/motor-gripper.{elf,hex,bin}` ← 夹爪固件，烧到夹爪板

### 4.4 motor.h/motor.cpp/interface_can.cpp 不动

明确：**本期**（仅 MoveJ）**不**引入堵转状态机 / 0x09 广播急停 / 0x5A/0x5B/0x5C 命令。这意味着：

- 电机端 `motor.controller->stallMode`、`ResetGoalsToCurrentPosition()` 等不实现；
- 主控 `dummy_robot.cpp` 的 `Reboot()` 仍走 ALL 代理 1 帧（已覆盖 J1~J7），无需新增 0x09 广播帧；
- `!STOP` 软停本期沿用当前 `EmergencyStop` 实现（`MoveJ(currentJoints)`），夹爪保持不参与（按 PROJECT_GUIDANCE，但本期 `!STOP` 软停分支也不一定启用）。

---

## 5. 主控构建与烧录

### 5.1 构建命令

```powershell
cd E:\Dummy-code\firmware_new\dummy-ref-core-fw\build
cmake -G Ninja ..
ninja
```

产物：`build/dummy-ref-core-fw.elf` + `.hex` + `.bin`。

### 5.2 烧录

`stlink.cfg` 已存在，烧录：

```powershell
ST-LINK_CLI.exe -c SWD -p build/dummy-ref-core-fw.hex -V
```

---

## 6. 验收清单（测试矩阵）

| 项 | 命令 / 操作 | 期望 |
|---|---|---|
| ① ALL 广播使能 | `!START` | 电机反馈收到 0x01 帧，扭矩释放（地轨 J7 同步） |
| ② 关节点位同步 | `>0,0,90,0,0,0,0,30` | 7 轴同步抵达 ~30°/s 速度（地轨 6 mm/s ≈ 0.2 r/s）；IsMoving() 在末端返回 false |
| ③ 地轨单独走 | `>0,0,0,0,0,0,90,30` | 仅地轨运动；地轨 mm 位回读到主控；OLED `J7=90mm` |
| ④ 地轨限位 | `>0,0,0,0,0,0,300,30` | 返回 `error: joint out of limits` |
| ⑤ ALL 代理 reboot | `!REBOOT` | J1~J7 同时重启；地轨电机按相同策略重启 |
| ⑥ 夹爪 ID 验证 | `hand.set_enable(true)` | 0x01 帧 StdId = `(8<<7)\|0x01 = 0x401`，不是 0x381 |
| ⑦ OLED 显示 | 看主控 OLED | 显示 6 关节 + 1 地轨 mm |
| ⑧ 串口助手兼容 | `串口助手.py` `>` 指令 | 默认按新格式 `>j1,j2,j3,j4,j5,j6,j7,speed` 发 |

---

## 7. 风险与缓解

| 风险 | 缓解 |
|---|---|
| MoveJ 改 7 参数签名后，旧 `>` / `&` 6 参数指令不能用了 | 文档强制更新 + 串口助手同步；调试期保留 6 参数分支（仅 J1~J6，地轨不动）。 |
| ALL 代理 + 夹爪两帧 Reboot 时，地轨若已断电会被"延迟响应" | ALL 帧 + 500ms 延时足够；夹爪独立帧兜底；本期不增加 0x09 急停帧。 |
| 地轨 7 轴同步算法本期只按距离比例限速 | ~~后续单独任务上 v2.7 `ComputeSyncSpeeds`（按梯形曲线模型）。本期留 TODO。~~ **已升级**：本期由 §3.3.1 物理同步算法替换；参考 `firmware/ref_core_f405` 的 v2.7 实现，含梯形曲线 + 迭代收敛。每轴速度受 V_max 物理上限钳制，时间预算通过二次方程反推匀速段速度。 |
| 电机端 57 段参数与参考版本不完全一致（缺少 stall 状态机） | 用户明确边界如此；本期 main.cpp 仍按参考值写默认值，参数差异不影响正常 MoveJ。 |
| EEPROM 现有数据残留（非 57 的 boardConfig 结构） | 57 电机烧录后首次上电会因 `configStatus != CONFIG_OK` 走默认表，自动覆盖；不需要手动擦 flash。 |

---

## 8. 改动文件总结

### 8.1 主控（firmware_new/dummy-ref-core-fw）

- [x] `Robot/instances/dummy_robot.h`（加 `RAIL_FIXED_NODE_ID`、`RAIL_MM_PER_CIRCLE`、电机数组 8 槽、地轨字段、MoveJ 7 参数签名）
- [x] `Robot/instances/dummy_robot.cpp`（构造/析构/限位校验/MoveJ 限位/Reboot/Homing/Resting/ParseCommand 8 参数/EmergencyStop）
- [x] `UserApp/main.cpp`（OLED 加地轨显示）
- [x] `UserApp/protocols/can_protocol.cpp`（无需改，确认电机端 ID 回包协议兼容）
- [x] **统一性补丁**：把 `motorJ[7]` 构造参数从字面量 `7` 改为 `RAIL_FIXED_NODE_ID`（`dummy_robot.cpp:31`）
- [x] **§3.3.1 物理同步算法**：加 `timeTrapezoid` + `ComputeSyncSpeeds` 静态函数，`MoveJ` 速度分配从"按距离比例限速"替换为梯形曲线 + 迭代收敛

### 8.2 电机端（firmware_new/dummy-motor-fw）

- [ ] `UserApp/main.cpp`（57 电机参数 + RAIL_FIXED_NODE_ID 强制）

### 8.3 上位机

- [ ] `串口助手.py`（`>`/`&` 指令支持 7 关节 + speed）

### 8.4 文档

- [x] 本文档 `docs/地轨电机加入方案.md`

---

## 9. 不在本期范围（后续任务）

1. 堵转状态机（StallMode_t / ResetGoalsToCurrentPosition / 0x5A/0x5B/0x5C）。
2. 0x09 ALL 广播急停（`!STOP` 软停统一路径）。
3. MoveL 地轨逆解（地轨位置由 IK 输出联动）。
4. SRV / TRQ / MOTOR_TUNING 模式对接地轨。
5. `DummyHand` → `StepHand` 重构（与 J1~J7 共用 `CtrlStepMotor`）。
6. ~~v2.7 7 轴同步抵达算法（梯形曲线 + 加速度感知 + 迭代收敛）。~~ **已迁入 §3.3.1**，作为本期加强项。
7. PID/DCE/电流的运行时查询（jointAccRuntime[] / jointCurrentLimitRuntime[]）。
8. RGB 灯效模式与电机状态绑定。

---

## 10. 实施顺序（建议）

1. **电机端先**：改 `firmware_new/dummy-motor-fw/UserApp/main.cpp` 57 段参数；编译 4 个 hex/binary 验证 CMakeLists.txt 不破。
2. **主控先静态化**：改 `dummy_robot.h` 加地轨字段、改签名（不改语义），确保编译过。
3. **主控加功能**：改 `dummy_robot.cpp` 构造/析构/MoveJ 限位/Reboot/SetEnable/IsMoving/Homing/Resting/ParseCommand。
4. **主控 OLED**：在 `ThreadOledUpdate` 加地轨显示。
5. **主控统一性补丁**：把 `motorJ[7]` 构造参数从字面量 `7` 改为 `RAIL_FIXED_NODE_ID`。
6. **§3.3.1 物理同步算法集成**：在 `dummy_robot.h` 加 `MOTOR_REDUCTION[7]` / `SLIDER_CAPS_V[7]` / `JOINT_ACC_FALLBACK[7]` / `jointAccRuntime[7]`；在 `dummy_robot.cpp` 加 `timeTrapezoid` + `ComputeSyncSpeeds`，替换 `MoveJ` 速度分配段。
7. **串口助手**：更新发送格式。
8. **联合调试**：烧主控 + 烧 57 电机固件，按 §6 + §3.3.1 §F 验收清单逐项过。

---

## 附录 A：参考依据文件路径

- 主控参考：`firmware/ref_core_f405/Robot/instances/dummy_robot.{h,cpp}`
- 电机端参考：`firmware/motor_fw_f103_57/UserApp/{main.cpp,configurations.h}`
- 协议常量：`firmware_new/dummy-motor-fw/UserApp/configurations.h`（已有 RAIL_FIXED_NODE_ID）
- 现有主控：`firmware_new/dummy-ref-core-fw/Robot/instances/dummy_robot.{h,cpp}`
- 项目指南：`.cursor/rules/PROJECT_GUIDANCE.mdc`

---
