Liu3Beng-A/Dummy/docs/MoveL离线研究记录_20261015.md

# MoveL离线研究记录：七轴协调、速度损失与快速改向

日期：2026-10-15，时区Asia/Shanghai。本文是持续维护的研究记录，不是论文，也不是生产实施或硬件验收结论。

最新更新：第10.6～10.8节保存本轮最终结论：滑块永久延期根因修复且全帧动态合规，但快接续/短停车都存在响应退步，手柄快速改向仍未普遍解决，尚无可直接移植生产的统一候选。全部原B/D对照、失败、超出原探索计划的协议修订、新留出及独立审查保留。第9节588组守护exit0及第8节历史5448组exit3异常各自保留，不混写。

## 1 当前任务、授权与用途

用户要求继续集中研究主控轻量七轴跟随，报告分析结果，并及时保留过程和数据；未来可能根据最终方案写论文。本轮可继续修改两份既有离线测试源码，更新研究文档及生成离线产物；不改生产固件、协议或上位机，不连接/操作设备，不自动提交。论文目的不扩大授权，不预设已具有论文新颖性。

当前三项需求须同时考察：TCP近似直线；手柄/滑块快速短距离更新；地轨协调参与。用户未接受以逐点停稳替代连续跟随。主控继续求解，PC发送意图或目标；主机离线实验不等于采用PC运动后端。

源码入口：`tools/tests/cartesian_follow_lite_test.cpp`、`tools/tests/run_cartesian_follow_lite_test.py`。当前生产已有原生有限MoveL，不能把历史“仅终点IK转MoveJ”误写为现状；本离线原型不等于该生产执行链已验证。

## 2 证据保存规则

每批使用新的`firmware_artifacts/cartesian-follow-lite-*`目录，不覆盖已有结果，保留：

1. 冻结源码及SHA256、源身份清单、全部参数和初始姿态；实验分组的唯一标识与相对原方案差异。
2. Python、编译器、平台和数学实现模式，编译/运行实际命令及日志；环境不能确定时标未知，不补造版本。
3. 原始`results.json`、`traces.csv`、控制更新与电机分支观察，以及生成汇总和图的脚本。
4. 完成、拒绝、超限、停止、未完成样例；不得只挑好看的轨迹或把故意断反馈与普通失败混合平均。
5. 假设、预期可否证结果、实际观察、解释限制和后续变更。运行中的保护哈希批次不得同时修改受保护文档，研究文档在批次前后更新。

证据分层：研究假设→模型内观察→单因素/交互反事实对照→板上完整计算预算→硬件动态和几何测量。低一层证据不能替代高一层。当前未做真实PID、机械、编码器噪声、CAN/RTOS或完整F405周期测量；不声称实时预算、实机性能或新颖性已通过。

## 3 已有方案与可复现批次

保留A=`baseline`旧轻量跟随，B=`coordinated`最小共同进度/联合约束，C=`coordinated_brake_lead`制动相关前瞻。B/C仍发送位置目标＋各轴速度上限，无七轴共同执行时间戳；各电机PositionTracker独立决定加减速。七轴分工为选择地轨位后转换TCP，再调用六轴解析IK，不是通用七轴数值逆解器。

前一轮只读诊断批次：`firmware_artifacts/cartesian-follow-lite-20261015T062322788475Z`。精确数学与cmsis512插值数学各1548组，总3096组。每模式包含3控制器×12参数组×43场景/姿态组合。主要产物：`comparison.md`、`slowdown_analysis.md/.json/.png`、`slowdown_reasons.csv`、各数学模式`results.json`、`traces.csv`、`control_updates.csv`、`motor_observations.csv`、`observation_regression.json`、`snapshot/`和`source_identity.json`。最新研究矩阵另见第8节，不覆盖此批。

复现命令：

```powershell
python tools/tests/run_cartesian_follow_lite_test.py
```

以批次冻结脚本及编译日志为实际环境和命令依据。新增观察后每模式1548组原指标最大变化0，完整旧`traces.csv`字节一致；每模式约10.43亿次20kHz分支观察一致性检查无失败。该回归仅证明已比较样例输出未被观察器改变，不证明控制方案成功。

模型复用真实六轴IK/FK、TCP刚体变换和PositionTracker。20kHz执行电机参考，1ms采样FK，原轨迹5ms输出，速度使用20ms位移窗口。默认20ms主更新、60ms前瞻、TCP40mm/s；电机默认30r/s²，地轨5mm/转对应150mm/s²。三个主姿态；TCP朝向固定。没有实际电机位置闭环、载荷/摩擦/机械误差或真实通信时序。

## 4 最近诊断：已观察，未做因果消融

### 4.1 地轨配合为什么TCP约19mm/s

口径：19.36～19.39mm/s是TCP窗口均速，地轨约29.54mm/s；要求分别40/60mm/s。

|环节|默认B三个姿态的窗口均值|
|---|---:|
|输入、转向后、关节/曲率界后|40mm/s|
|反馈缩速后|20.948mm/s|
|共同参考推进|20.217mm/s|
|模型TCP|19.361～19.395mm/s|

J7在940ms主控窗口一直是主要误差来源，平均归一化倍率1.963，对应约0.982mm位置落后；0.5mm误差标尺使允许速度明显缩小。反馈缩速触发900ms。TCP主要是进度落后，平均横向偏离约0.001～0.015mm。

约950ms电机窗口内，J7距离制动456.15ms，加速493.80ms，巡航和速度帽制动0。0.500s快照：速度29.497mm/s，速度帽43.870mm/s，目标距离2.8987mm，按150mm/s²计算的制动距离2.9002mm。要求60mm/s时制动距离12mm；60ms前瞻仅对应3.6mm地轨行程，但实际目标距离还含小段和跟随误差，不可直接画等号。

结论范围：外层误差缩速和近目标本地制动同时存在；尚未确定各自独立因果贡献，不能把阶段速度差直接当成删项收益。

### 4.2 快速改向为什么延迟

短反向0.250s改向，0.500s松手；主控0.260s首次处理。B三个姿态参考归零为0.340/0.420/0.420s，新方向参考启动0.360/0.440/0.440s；原反向延迟120/195/200ms。参考转向制动100/180/180ms；改向到松手反馈缩速均0。

90°转向姿态0存在另一限制：新方向共同加速度约41mm/s²，由J4局部约束主导，曲率速度界约23mm/s；0.480s共同速度仍约5.76mm/s。它来自当前有限差分和保守系数，尚不能解释为实机物理极限。0.25～0.50s B三个姿态新Y净位移约0.346/0.203/0.639mm，须与偏差一并报告。

### 4.3 其他已知失败与未完成

C默认地轨配合f0/f1出现`branch_jump_over_12deg`，f2完成。不能一味加长前瞻或直接放宽12°门限。固定TCP移轨仍有明显途中漂移。80mm/s部分转向退化。排除故意丢反馈后B仍有有限目标较A失去完成，不能以多数改善宣称普遍通过。

10%介入/25%回收只是讨论基线，当前简化搜索只将一个样例最差余量约6.1%改善至13.6%。朝向拖动、完整工作空间、动态轨目标缓存策略、板上实时预算均未完成。

## 5 指标口径与公平比较

- 原`path_max_mm`对应控制器自身参考路径；主对照用独立用户意图路径的`intent_path_max_mm`。平滑转向若改变参考，必须同时保留原始意图、可执行参考和实际路线三者偏差，不能靠改参考获得虚假收益。
- 同时报告实际TCP/轨速度、沿线落后、横向偏离、操作净位移、停止/反向延迟、完成/拒绝、关节限位与动态边界。更慢、更少位移不能只记作几何改善。
- 主控原因按更新后保持时间统计且可重叠；电机分支按20kHz tick统计，不同窗口不得直接相加。CV包含启动/转向/停止时不得称稳态波动。
- “原反向延迟”和新增实际新方向启动阈值不同；参考归零不等于电机停止。1ms采样峰值不等于连续时间严格上界。
- 控制更新CSV在派送前取样，区分`sent_goal`和`goal_before_dispatch`。固定TCP移轨零切向时不直接使用沿线/横向分解。
- A旧停止使用模型内部速度，B/C不使用；不得在停止性能上隐去这一信息差异。外部IK次数不包括解析IK内部候选FK，不能换算完整F405预算。

## 6 本轮研究预注册：运行前计划保留

本节先于新批次写入；正式执行分组、任何必要偏离及新增假设须在结果中明确记录。本节是研究计划，不是测试通过声明。

### 6.1 研究R1：误差治理缩速×前瞻

假设H1：约19mm/s由外层进度误差缩速与本地制动耦合形成，单独归咎速度能力不足不充分。保留原A/B/C作回归锚点，在B旁加入仅供离线诊断的因子组合。正式预注册主要矩阵为固定前瞻60/120/240ms × 全局反馈缩速启用/禁用，共6组；其余普通B控制及安全门限保持，尤其保留反馈过期停止、过大误差连续停止、IK连续性拒绝和限位检查。每次清楚标记删改的唯一规则，不能静默取消其他检查。禁缩速组仅为机制消融，不能直接视作可部署候选。

主要参数组预定为`base60`、`acc10`、`speed20`、`speed2x`、`feedback20ms`、`zero_skew`、`skew6ms`；场景为`short_line_x`、`short_line_xyz`、`slider_short`、`rail_line`、`rail_hold_tcp`、`rapid_short_reverse`、`rapid_short_corner`，各3姿态。另加入第6.2节的2个诊断组后，8控制变体×7参数×7场景×3姿态=1176组/数学模式。旧A/B/C原1548组/数学模式全部继续运行回归；研究R0对应B的匹配组逐指标核对，以隔离分组开关本身的实现变化。

先用默认地轨配合三个姿态及固定TCP移轨检查机制，再对必要候选扩展原场景和反馈延迟对照。记录共同速度各阶段、地轨目标/制动距离、距离制动占时、误差来源、实际速度/几何偏差、完成/拒绝与调用量。单因素和交互结果分别列出，不把原因计时换算成因果百分比。

否证/降级条件：去缩速仍低速、增加前瞻不能稳定改善、速度提高但偏差/限位/失败恶化，都必须保留；结论只限定已测姿态、速度和模型。长前瞻若触发连续性拒绝，先记录失败位置与种类，不自动放宽12°门限。

### 6.2 研究R2：改向规则与局部约束审查

假设H2：短改向延迟部分由大于约20°的先停再转门限主动造成；90°转向f0重新起步还受局部导数/加速度限制。先还原触发、归零、新参考启动和模型实际响应各时间；分开90°与180°，不能把180°必经零速度当成可完全消除的算法开销。

本轮增加的2个消融组固定前瞻60ms，禁用先停再转，分别保留/禁用全局反馈缩速。它们仅回答门限的机制影响，不保证动态可执行。新增关节参考边界差分速度/加速度相对能力的倍率，防止参考方向突然切换制造表面跟手收益；该差分仍不是连续时间严格极值证明。普通安全门限维持不变。

审查路径参数的一阶/二阶有限差分是否在不同采样间距、缩小探测步长和数值数学模式下稳定；检查由哪个轴、哪项系数形成约41mm/s²，区分真实运动需求与数值/保守性。若开展速度矢量平滑候选，明确几何偏差预算与停止语义，不自动补走已松手的旧手柄位移；原先停再转作为对照保留。

如独立导数审查暴露新问题而需要追加实验，须作为独立批次/分组记录原因、假设及事后性，不将新增研究伪装成上述矩阵的预先计划。

评价必须同时使用原意图偏差、净位移、实际方向启动、停止距离、关节速度/加速度和失败率。单纯提前改变参考切向、实际电机尚未响应不能算收益。

### 6.3 本轮结果登记

运行前状态为待完成，未预填结果。现已完成主矩阵，正式批次、结果、完整性异常、独立审查及事后诊断追加在第8节；本节预注册设计保留，不能按观察结果倒改研究计划。

## 7 与后续论文的关系

潜在研究主题是资源受限主控中七轴冗余分配、既有位置执行器与笛卡尔在线协调的关系，尚未确定论文问题、贡献、文献差异或目标刊会。本文及冻结批次可作为未来复现材料；未做文献审查前不宣称方法新颖，未做实机前不声称实机精度、速度或实时性。失败、撤回方案及负结果同样保留。

本轮结束后优先根据可否证数据选择下一步，而不是为了论文形成而保留无收益复杂度。生产移植、协议变化、资源预算和硬件验收另行按用户授权讨论。

## 8 本轮执行结果与新的问题定位（2026-10-15）

### 8.1 实际执行、环境与结果入口

主批：`firmware_artifacts/cartesian-follow-lite-20261015T065643160059Z`。命令为：

```powershell
python tools/tests/run_cartesian_follow_lite_test.py --research
```

UTC起止为06:56:43.458285～07:04:52.485606，对应北京时间14:56:43～15:04:52。Python3.11.7 64位，Windows10.0.26200；MSVC按日志使用C++17、O2、W4、EHsc、fp:precise构建，cmsis512另定义CMSIS_INTERPOLATED。实际完整命令、可执行文件与输入SHA256见`source_identity.json`，不以此主机运行总时长代替F40520ms预算。

实际执行原计划的8控制变体×7参数×7场景×3姿态=1176组/模式，两模式新增2352组；旧A/B/C各1548组/模式继续运行，共5448组。未把研究失效组或故障停止组从矩阵删除。禁用全局反馈缩速时，位置/速度修正、硬误差停止、限位和IK检查仍保留，不能简称去掉全部反馈。

模型回归：各模式旧1548组原指标最大差0、旧trace字节一致；R0匹配原B各147组全部结果字段一致（仅标签不同）。旧观察每模式约10.43亿、新研究约7.32亿次分支一致性检查通过，控制CSV/结果导出核对通过。模型执行无error；不等于全部运动完成。

入口清单：

- 主批`research_analysis.md`、`research_results.csv`、`research_feedback_pairs.csv`、`rail_distance_envelope.json`、`protocol.json`、`protocol_snapshot/`、`source_identity.json`、`evidence_manifest.json`及两数学模式`research/`原始数据。
- `firmware_artifacts/movel-turn-analysis-20261015/phase2_matrix_analysis.md`：主矩阵完成后的独立解释与qref指标重构核对，不是新增运动控制实验。
- `firmware_artifacts/movel-derivative-audit-20261015/report.md`：4860条逐轴导数及55条/模式远点失败的独立离线审查，保留全部输入、源码、编译命令、哈希和失败。
- 同目录`phase2_report.md`及`phase2_extract.json`、`phase2_windows.json`、逐轴FK替换CSV、`phase2_manifest.json`：固定世界TCP移轨最大漂移的分段时间定位与几何重建，属于看到终点参考问题后的独立诊断。
- `firmware_artifacts/movel-research-notes-20261015/posthoc-20261015T070448590608Z/report.md`：明确标记的事后辅助速度窗口。
- `firmware_artifacts/movel-research-notes-20261015/primary_sources.md`：一手资料起点，不是系统文献综述，未移植其中算法或形成新颖性判断。

### 8.2 完整性异常：不得标整批全部通过

主批`source_identity.json`保留`exit_code=3`、`sources_unchanged=true`、`protected_unchanged=true`、`formal_artifacts_unchanged=false`。运行期间17份源码inputs及6份保护文档的哈希未变，但`firmware_artifacts/`顶层30项正式产物被并行构建改写。当前主控manifest的release2026101505、buildset BF63E123A86A4079及约06:59UTC写入时间仅用于佐证并行变化；本研究没有构建或修改生产固件，也不将离线结果绑定该正式版本。

此异常不通过改写退出码、覆盖源身份或回滚并行产物消除。可以报告模型运行、冻结输入、原运动输出回归和诊断导出核对成功；不能写成完整批次所有检查通过。后续复现实验应避开同目录正式产物的并行构建，或明确协调隔离运行时段。

逐项变化与写入时刻证据另存`firmware_artifacts/movel-research-notes-20261015/artifact_guard_incident.md/.json`，保留完整性异常的独立索引。

### 8.3 H1结果：前瞻与治理缩速确实耦合，直接禁缩速不可用

默认地轨配合，precise三个姿态全部列出于主报告。以下均为原先定义的主窗口，包含部分启动：

|固定前瞻/全局缩速|TCP主窗口均速mm/s（三姿态）|同例完成|主要情况|
|---|---|---:|---|
|60ms/开|19.361 / 19.393 / 19.395|3/3|距离制动约456ms，缩速900ms|
|60ms/关|27.922 / 26.608 / 28.046|0/3|全部tracking_over_12x_for_3updates|
|120ms/开|27.361 / 27.392 / 27.394|3/3|距离制动约415ms，缩速720ms|
|120ms/关|32.271 / 32.300 / 32.301|3/3|有更大参考落后，仍有距离制动|
|240ms/开或关|36.403 / 36.411 / 36.411|3/3|该例距离制动和缩速均0，两组输出一致|

两数学模式在这些主要趋势上一致。60ms仅取消缩速不能维持原轨速，且积累误差直至保护；说明原缩速既造成减慢，也在约束跟随误差，不能整体删除。增加前瞻能改善该场景的本地制动条件并减少误差缩速，但不足以证明固定长前瞻适合全部路径。

理想化必要距离解释：轨60mm/s、加速度150mm/s²需12mm制动距离；60ms＋20ms下一段名义领先4.8mm，仍需约7.2mm落后才能达到该目标间距，而硬误差标尺0.5mm×12为6mm并连续3次触发停止。120ms对应8.4mm名义领先、需约3.6mm落后；240ms对应15.6mm名义领先。该估算解释潜在冲突，不是闭环稳定性、精确速度或全路径可执行性的证明。

全矩阵负结果必须同时报告，precise如下。每设置有147个运动样例，其中105个有限目标；“拒绝组数”分母为147，不应与有限目标未完成数直接等同：

|设置|有限目标完成/105|拒绝组数/147|参考离散加速度>1.01倍组数/147|
|---|---:|---:|---:|
|60ms/开（原B）|100|4|36|
|60ms/关|78|29|38|
|120ms/开|100|4|36|
|120ms/关|93|14|36|
|240ms/开|89|18|35|
|240ms/关|86|21|35|
|60ms禁转向gate/缩速开|99|21|75|
|60ms禁转向gate/缩速关|73|55|77|

CMSIS两项禁缩速设置的完成数略有差异，完整表保留在主报告。240ms缩速开有16条branch_jump和2条跟随停止，有限完成降到89/105，不能作为默认最终值。固定世界TCP移轨最差漂移由约4.04mm改善到约3.86mm后基本不再改善，也没有解决全程固定TCP问题。

### 8.4 事后辅助速度窗口：单独保存，不替换主指标

看到主矩阵启动轨迹后，另提出0.8～1.2s与1.0～1.2s辅助窗口，属于事后诊断。以保存的5ms轨迹中的20ms位移速度求均值，口径不同于主指标1ms采样。所有8设置、3姿态、两模式及失败一并保留，未挑选最优时窗替组背书。

240ms默认地轨例1.0～1.2s三个姿态约40mm/s（precise40.004/40.013/39.999），说明该主窗口36.4包含启动影响；60ms缩速开同窗口约19.7，120ms开约28.2。不得因此用事后40替换预注册36.4，不能将失败组的辅助速度当正常巡航。完整原始值、主窗口对照及失败标记见posthoc报告。

### 8.5 H2结果：禁转向gate变快但参考动态不可接受，原B也有漏洞

默认短反向禁gate、保留缩速后，三个姿态原定义延迟从120/195/200降到46/78/67ms，但关节qref边界差分加速度最高为模型能力4.554/11.018/9.208倍；独立路径偏差由0.363/0.058/1.181mm升到1.764/7.278/5.054mm，姿态1触发跟随停止。90°转向最高约27.66倍且出现保护，不能把更早响应当作可执行改进。

更重要的新发现：原B并非已经动态自洽。默认`slider_short`三个姿态参考加速度约7.18/3.40/1.59倍；`rail_hold_tcp/base60/f2`约13.51倍的终点参考突变仍被原样保留。方向变化未超过gate、终点收尾等环节可能绕过标量共同速度的预期约束。先停再转或反馈开关均未修复这些路径/方向变化下的参考问题。

**固定TCP最大漂移的后续时间定位，不能称为巡航漂移。** 独立phase2审查对默认姿态2严格分段，保留全程最大为主指标：

|precise前瞻|t<2.0s最大漂移mm|t<2.12s最大漂移mm|全程最大mm/峰值时刻|
|---|---:|---:|---|
|60ms|0.076585|1.917895|4.040862 / 2.174s|
|120ms|0.051565|1.644090|3.858089 / 2.175s|
|240ms|0.051565|1.644090|3.858089 / 2.175s|

共同地轨参考在2.14s到40mm并置共同速度为零，最大漂移在其后34～36ms出现；CMSIS同样集中在停止阶段。该分段是事后机制诊断，不能用前两秒小误差替代全程最大验收，也不能外推其他姿态或实机。

但并非只在最终硬夹持时才出问题：120ms样例2.0s共同速度仍15.6386mm/s、允许速度已5.0291、剩余路径2.355mm、局部加速度界仅5.6121mm/s²。按该局部界恒定估算停止距离约21.8mm，说明当前状态已无法依靠同一局部界在剩余距离停下；这不是整条变化路径的严格停止证明。J3参考加速度2.08s已为模型界1.10倍，2.12s升到3.15倍，2.16s前馈骤零达13.51倍。必须先处理终点前可制动性及最后几步连续接续，不能只改最后一次位置夹持就宣称解决。

峰值时刻模型实际参考相对共同参考，J3落后约1.188°而轨只落后0.0626mm。FK重建误差约4.2e-8mm；将六轴替换为共同参考、保留实际轨，漂移约0.0626mm；只替换轨仍3.819mm。说明该时刻主要几何不一致在机械臂多轴组合，但单轴几何替换没有重跑动态，误差也互相抵消，不能计算独立因果贡献或仅凭J3误差最大判单轴根因。不能把3.858mm直接当作普通位置/速度接口巡航能力不足的独立证据；接口剩余能力应在参考修复后复测。

这里的倍率来自关节参考边界离散差分，揭示主控参考可能要求电机无法忠实追随的变化；不是实际电机超过加速度，也不是连续时间严格极值。Phase2逐点回归36组旧参考序列摘要一致，CSV重构与C++日志微差来自10位有效数字后二次差分。Phase2原文“CMSIS仍在运行”为当时阶段性说明；目前两模式主矩阵已完成，最新以主报告为准。

### 8.6 独立导数与远guide审查：41不主要是数值噪声，部分跳支拒绝是时间范围混淆

导数审查使用前一诊断批次冻结状态，共18状态×3数学模式×多种差分/步长，保留4860条逐轴结果，无失败过滤。double_reference仅是离线机械类型替换参考，不是固件位级参考。

姿态0在0.36s转Y，原0.5mm前向差分J4梯度3.399044°/mm、曲率−0.116638°/mm²，复现41.305731mm/s²。中心0.25mm double参考为3.426484°/mm、−0.107301°/mm²，同规则40.974951mm/s²。因此约41主要来自局部几何敏感与保守预算，不能靠改float或缩步长期待变成400。未计算完整雅可比奇异值，不直接定性为严格奇异点。

65%起步加速度预算把该状态约63.04的全额局部上界降至40.97；30%曲率预算也有保守性。带符号链式关系`q_ddot=q_s*s_ddot+q_ss*s_dot²`可形成共同加速度区间；本次仅静态核对，0.65预算下40mm/s该状态不可行，全额预算下存在区间。不能因此取消余量或保证整条路线40mm/s。公式属于既有运动学关系，非项目新贡献。

从既有CSV可重建的C远点失败55条/模式（不是全矩阵所有失败），按0.1mm连续求解且每步保留12°门限：precise47条连续到达、8条仍无IK；cmsis51248/7；double47/8。默认rail_line f0/f1累计约12.06°被直接拒绝，但小步最大仅约0.125°/0.119°，这两例不支持真实分支跳变解释。0.1mm密集链可能需约100次IK，仅为离线证据，不能照搬20ms主控循环。端点几何可连续也不保证独立电机实际沿中间路径走。

### 8.7 结论调整、未完成与下一候选

本轮主要预注册矩阵按计划执行；另保存独立导数审查、完成后矩阵解释和明确事后窗口。它们不回填成预先计划，不因有利数据改主指标。

当前没有可直接移植的最终控制器。推荐后续分别验证：

1. 先保证终点前仍有可制动路径及最后几步连续接续，再修小角度切向变化和松手/路径切换的qref约束；比较关节参考及电机20kHz输出，不仅限制一个路径速度标量。固定TCP例不能只修最终硬夹持，也不把停止阶段峰值误称为巡航能力不足。
2. 远guide采用有界、可缓存的中间路径连续验证；近下一段仍保留严格检查，真正no_ik/限位/分支变化继续拒绝。原47条只是验证机制入口，不采用无界密集搜索。
3. 再单独研究与速度、制动和正常滞后相关的前瞻，以及区分沿线落后/横向偏差的误差治理；不直接全关缩速，不直接固定240ms。
4. 七轴动态分配和带符号加速度区间之后做独立对照，保持余量与失效策略；当前快速转向锁轨，不把其J4约束当整个七轴系统的能力。

未完成：真实机械/PID/反馈/CAN/RTOS，F405完整周期耗时与RAM/栈/Flash，完整10%/25%回收、姿态拖动和完整工作空间、已有生产MoveL执行故障及普通MoveJ实机基线。论文一手资料只是入口，尚未系统相关工作和新颖性比较。

## 9 继续研究：终点、方向变化与远guide的独立可行性试验

### 9.1 运行前范围与否证条件

用户继续授权离线研究，保持第1、2节范围与潜在论文证据要求。先在三个全新、互不覆盖的artifact目录制作冻结副本原型，不先把候选合入两份公共测试源，更不改变生产。每个试验先保存protocol及实际源码/输入/环境/命令，再运行；中途修改算法必须另记修订，旧失败保留。其结果属于对已有问题的后续研究，不回填第6节为原始预注册。

1. **终点可制动性**：真实IK采样固定世界TCP、地轨0→40mm的整路径，审查带符号共同加速度区间，区分绝对值保守分配与未来约束收紧；先比较保留65%关节加速度预算的整路径保守速度/加速度及精确终点候选。必须同时报告完成/时间、qref离散动态与PositionTracker实际TCP漂移。若仅减小参考加速度仍漂移，不能宣称普通位置/速度接口已经可用。
2. **方向连续变化**：保留原B，对笛卡尔速度向量有界变化，并检查下一关节参考的离散速度/加速度，以固定最多12个近点IK候选回退；无可行下一步明确记录失败，不能冻结或跳变冒充通过。开发场景为三姿态的短滑块、短90°和反向，speed20及20ms反馈延迟为留出配置；轨固定，避免混入分配因素。该单步检查不自动保证后续仍可行，有限目标启发式也不是停止证明。
3. **远guide有界连续验证**：对既有55条/数学模式失败记录，比较固定2/4/8段或明确计数的逐级方案，顺序seed、每段保留12°及限位/FK检查；保留真实无解负例，并与旧0.1mm密集链的几何结果比较。必须报告总/最坏IK次数、失败类型和端点一致性，不能用增加段数掩盖无限工作量，也不能把几何可达当动态可执行或F405实时通过。

各试验只处理其明确的因素，不合成一个未经对照的“最终控制器”。结果后再决定哪部分值得进入两份离线公共测试文件。本轮不做实机、F405计时、固件构建或设备操作；上一批完整性异常继续保留。

### 9.2 有界guide执行对照：运行前协议

独立几何研究`movel-guide-budget-v2-20261015-20261015T072759139457Z`完成后，才新增公共两测试源的独立入口`--guide-budget-only`；这是后续新协议，不称其结果预见于9.1以前。A/B/C默认算法和旧研究矩阵保留。候选D沿用原C的制动相关前瞻，仅远guide直接失败且类型为`branch_jump_over_12deg`时，在同一路径的位置及轨位取中点，以原近点为seed检查中点，再以中点为seed检查端点。每段继续全部原IK、限位、12°检查；任一步失败拒绝，不重试直接no_ik/限位。每更新最多3次guide IK，原两probe及下一边界IK另计，本矩阵无轨搜索，整更新最多6次外部IK。调用次数不是F405耗时。

固定矩阵：原C和D各147组＝7配置（base60/acc10/speed20/speed2x/feedback20ms/zero_skew/skew6ms）×7场景（短X/XYZ、短滑块、地轨配合、固定TCP移轨、短反向/90°）×3姿态；两数学模式合计588组。原C各147组与上一冻结主批全部旧结果字段严格回归；新增计数字段不冒充旧有字段。所有配置和场景均导出20ms控制更新及原5ms轨迹，实际主指标仍为1ms FK及原速度窗口。主要指标为有限完成/105、拒绝类型/147、参考离散a超限组数及峰值、独立意图几何误差、原窗口TCP速度、响应和调用峰值。不得把避免guide拒绝等同于通过动态或终点；也不改主窗口/保护阈值来改善分数。

命令：`python tools/tests/run_cartesian_follow_lite_test.py --guide-budget-only`。运行前冻结17输入及6文档，运行后继续检查源码、文档和顶层正式产物。运行期暂停编辑保护文件；独立子研究使用各自已冻结副本。若正式产物再次并行变化仍如实记异常，不回滚他人产物。结果待运行完成后追加。

### 9.3 有界guide结果：误拒绝修复成立，动态缺陷仍在

批次`firmware_artifacts/cartesian-follow-lite-20261015T073533280234Z`，两数学模式各294组，共588组；退出码0，冻结源码、6份文档及顶层正式产物运行前后均一致。原C每模式147组全部旧字段（含嵌套诊断）严格回归，矩阵、外部IK工作上限、诊断计时/导出核对通过。新计数是观察字段，不改变旧A/B/C默认算法。默认入口和旧研究入口继续保留。

|每数学模式|原C|C＋仅跳变误拒绝时中点重试D|
|---|---:|---:|
|有限目标完成/105|86|103|
|拒绝样例/147|21|4|
|拒绝类型|18跳变、2无IK、1跟随保护|2无IK、2跟随保护|
|参考离散a>1.01倍样例/147|36|36|
|guide重试更新/成功|0/0|207/207|
|最大guide IK/完整更新外部IK|1/4|3/6|

两数学模式计数一致；precise参考a最高29.3175倍，CMSIS29.7202倍，D未修该缺陷。恢复几何求解后也可能进入后续跟随保护，不能把消除18条跳变拒绝说成18条完整成功。

默认地轨配合D三姿态均完成，原主窗口TCP速度约36.403/36.411/36.411mm/s，TCP路径max约0.228/0.286/0.024mm（precise）。原C前两姿态原本中途拒绝，第三姿态原样完成；这是C与D的单项对照。与B约19mm/s相比还包含C原有的制动相关前瞻差异，不能将全部速度收益都归因本次中点修复。

独立几何研究目录`movel-guide-budget-v2-20261015-20261015T072759139457Z`保留2401条方法/路径记录。原55失败/模式中precise47、CMSIS48条可用两段恢复；4/8段无新增覆盖，剩余为真实no_ik。合法反向全部通过，不可达与轨+251mm负例全拒绝。直接尝试＋中点重试最多3guide IK，而旧0.1mm密集诊断最多159次；密集链是离线几何参照。公共D沿用原IK内部FK位置0.1mm及旋转矩阵元素误差门限，并未额外引入几何子研究的0.05mm/0.05°独立审计阈值。局部合法几何变化仍可达约9.82°，不等于20ms动态允许变化。

公共矩阵全量导出20ms控制更新和5ms轨迹；1ms电机原始观察保持原选定子集，不声称全矩阵1ms原始轨迹齐全。所有主指标仍由1ms FK计算。详见该批`guide_budget_analysis.md`、`guide_budget_pairs.csv`、`source_identity.json`和冻结源码。

### 9.4 固定TCP移轨：几何可达余量与提前减速

独立目录`movel-stop-feasibility-v2-20261015-20261015T072438Z`保留初始协议、三次修订、真实IK/FK/PositionTracker冻结副本、路径和尾部采样、无效候选、两数学模式全部结果及原始轨迹。本研究是有限目标整路径可行基线，不是可直接合入手柄的控制器。

**问题姿态不是普通内域目标。** f2固定世界TCP移轨，沿同一数值IK支路40.155mm仍有解、40.160mm无解；40mm目标距该方向边缘仅约0.16mm，但终点最小关节限位余量约18.33%。未计算Jacobian，不能称严格奇异；此结果说明单靠10%/25%关节限位余量不足以衡量几何可达和路径动态余量。

末端J3局部q_s约−7.46°/mm、q_ss约−25°/mm²；宽±1mm拟合只得到约−5.59/−4.27，明显平滑掉端部变化。带符号共同加速度区间也可能为空，不能仅靠取消绝对值保守分配解决。原B同姿态轨目标20/30/35/40mm，precise最大漂移分别0.0579/0.1066/0.1582/4.0409mm，参考a倍率0.65/0.65/0.65/13.514；40mm压力例不能泛化为普通地轨路径都不行。

整段候选预采样40mm路径，按未来约束构造前后向可制动速度包络，初末速度0，分段恒定路径加速度精确取样；总预算65%＝曲率30%＋切向35%，导数按细尾部多窗口最大值再留系数。它是经验保守离散估计，不是连续严格极值证明。模型结果如下（precise，CMSIS趋势一致）：

|姿态|原B60ms全程漂移mm|新包络60ms漂移mm|新包络120ms漂移mm|新参考a峰值/物理A|新参考结束s|
|---|---:|---:|---:|---:|---:|
|f0|1.496|4.052|0.069|0.306|2.674|
|f1|0.996|2.889|0.091|0.398|2.491|
|f2|4.041|0.065|0.051|0.292|2.807|

三姿态新包络120ms在两数学模式均完成，全部漂移约0.05～0.10mm、参考a<0.41倍；CMSIS结束约2.48～2.89s。此结果表明该位置＋速度帽接口在这个模型和修复参考下存在可行停止样例，未证明通用接口/实机性能。相同包络60ms仍有f0/f1严重漂移，说明参考合规后前瞻和独立电机跟随问题仍须处理。原B60ms与新包络120ms不是单因素对照，不能把全部改善只归提前减速。

候选使用预定整段时序，替换了旧在线推进/全局误差缩速，保留原局部前馈/位置与估速修正及goal/cap；未实现完整在线陈旧反馈/硬误差停止契约。只覆盖固定世界TCP、轨正向、三姿态，不得将其整体直接移植生产。固定V1/2的f2虽能完成却需40.1/24.1s，5s原时限不完成，负面时间代价完整保留；原B另跑45s并确认前5s轨迹相同。

固定计划参数按precise筛选，再由两数学模式共用；不能称每模式所有标记valid候选均已动态仿真。`settled_at`为100ms稳定窗口起点，实际完成识别再晚99ms；当前样例距离5s边界充足，不改变完成计数，后续边界例必须按识别时刻判断。参考结束时间与稳定/完成识别时刻分别保留。

计算量：全路径0.05mm采样801节点/姿态，另有尾部0.005mm密扫及拟合；每数学模式主路径与尾部共6118次外部IK，不含ModelChecks与解析内部FK。前后各800次松弛，运行每20ms仍2次外部IK，未缓存。t/s/v三列double运行表裸数据19,224B，容器容量另计；改float为9,612B仅估算，未实施。若同时保留2×801×7的double导数系数还需89,712B裸数据，不能只按运行表估主控内存；现实现是主机诊断，不是固件资源设计。该完整离线预扫描并未证明适合每20ms在线重做。主机耗时不等于F405，实际RAM/栈/Flash与保护集成尚未验证。新增汇总未独立统计姿态旋转误差，不能把XYZ小漂移写成完整TCP姿态合格。

### 9.5 方向连续候选被否决：单步动态合规不足

独立目录`movel-turn-feasibility-v2-20261015-20261015T072459Z`第一阶段108组＝原B/矢量候选×3配置×3场景×3姿态×2数学模式。base60为开发，speed20和feedback20ms为留出；原B各27组全部旧字段严格回归，运行期输入/文档/正式产物哈希均未变。候选最多12次近点回退IK＋1guide，所有接受步离散参考a≤0.64914倍物理能力；未取得F405预算证据。

候选仍不可用：base60滑块f0在0.66s找不到其预设搜索线上的可接受步，明确失败；这不代表所有控制方向都无解。90°转向f0意图偏差从B0.413mm增至12.323mm；反向延迟120/195/200变为116/237/222ms，没有普遍收益。看到失败后未调参覆盖。

第二阶段仅分析冻结数据：f0在0.26s候选速度仍vx39.293、vy0.707mm/s，0.48s仍vx35.050、vy4.950；改向到松手继续旧X9.237mm，松手后再走4.623mm，参考也如此，反馈缩速始终为1。其沿“旧速度→期望速度”单线缩小修正保留了太多旧方向速度；缺少拐角偏差预算、替代制动方向与未来可停止性，不能归咎电机滞后。

原B反向延迟按事件拆分：采样10ms＋参考减速间隔80/160/160ms＋归零到新方向更新20ms＋到原TCP指标10/5/10ms。gate累计100/180/180包含零速更新后的一个20ms统计区间，不应全部称物理必需制动时间。按当时实际轴速/完整物理A算“全部轴归零”的独立轴必要下界约45/109/92ms；忽略笛卡尔和曲率、余量等约束，且不是TCP开始反向紧下界，不能相减承诺优化量。

### 9.6 当前判断与下一步边界

1. 主控路线继续，没有算力不足的证据。本轮唯一合入公共离线源的是有界远guide重试及独立对照入口；生产没有修改。
2. 有限目标优先研究“整路径可达/动态预检→提前减速→连续终点”，先把密集离线包络压缩成有界节点和保守验证，再测算力，不直接搬801节点扫描。
3. 手柄不能照搬整段预扫描，也不能仅逐步矢量滤波或q/a限幅。下一候选应明确允许的拐角偏差、偏差预算内可停止/可转向的短前瞻，以及无可行过渡的受控退路；保留先制动再转向作保守对照，不直接禁gate。
4. 地轨策略需同时考虑关节限位余量、沿目标方向的几何可达余量和未来可制动能力。完整10%/25%分配、姿态输入、真实反馈保护、F405资源与耗时及硬件验证仍未完成。

论文用途保持：同等保存成功与失败、组合改动与单因素区别、留出配置、修订协议和原始指标，不用模型结果声明实机或新颖性。第8节旧批完整性异常不被新批exit0覆盖。

### 9.7 本轮证据复核入口

`firmware_artifacts/movel-v2-synthesis-20261015/validate_and_index.py`只读重核各批冻结manifest与原始结果，另存新的UTC时间戳索引，不改实验。首次复核：guide公共批56文件、几何子研究54文件、方向子研究74文件、停止子研究131文件，全部SHA256零差异；公共原C各147组全部旧字段严格一致，D没有触发重试的样例也逐字段一致（仅标签不同），工作次数上限再次确认。索引包含四批全部文件、后续独立交叉评审和6份最终文档哈希；后续再次执行产生新索引，旧索引保留。

几何子研究`review.md`为公共代码只读交叉检查；`stop_cross_review.json`及配套评审为终点独立核对：44组候选qref离散v/a匹配原始20ms重构，22对60/120ms的参考路径/时间/v/a完全相同，可用于分离这两前瞻的模型执行差异。完整停止对照74动态组（另6次扫描阶段重复原B），方向108组，公共guide588组分别保留，不把几何采样点数混作运动实验组数或统计独立重复。

## 10 继续研究：手柄快速改向与滑块连续更新

### 10.1 用户授权与运行前方向

用户明确要求重点解决快速改向和滑块连续更新，保留现有对照，过程和数据及时保存，不改生产固件或操作设备。先在全新artifact独立目录冻结副本做候选；原B、D及上一轮失败矢量方案都保留。根维护本文和SESSION_STATUS，只有有证据支持的候选再考虑进入两份公共离线源，不把研究授权扩大到生产、协议、上位机或提交。

- **手柄**：验证显式旧方向制动、停车锚点/有界短路径预检，按实际20ms边界连续接续到最新意图。小角变化也须受关节动态约束；先建立未来可停止的保守基线，再判断是否获得响应收益。不能简单硬删一个20ms等待而忽略最后梯形位移。
- **滑块**：验证从当前参考/运动状态接到最新完整目标的缓存短路径，目标不变时继续原路径，有变化才重新接续；固定候选时长和固定未来检查站，检查末端及参考速度归零帧。每包不重新从零速起步，不排队消费历史目标。路径可圆滑但必须报告相对用户意图和实时目标的偏离。
- **共同边界**：先锁轨，分离在线输入因素；继续真实IK/FK、20ms位置反馈/估速、原硬误差和陈旧保护、普通goal/cap及PositionTracker，不用oracle速度作控制。目标离散参考v/a≤.75物理V/.65物理A，全部失败保留。每候选有明确IK/检查次数上限；主机可运行不代表F405实时或资源通过。

各子研究先保存独立protocol再运行。开发base60三姿态；speed20、speed2x、feedback20ms为不调参留出。保留既有短90°/反向/滑块突变场景，增加连续小角方向变化、平滑拖动、往返及突变后保持；新场景公式、随机性、指标与修改时点记入各protocol。最多两阶段探索，失败后改参数须先登记修订，不能覆盖原批。

### 10.2 指标补充：保留旧口径，防止低运动量获益

旧reverse_delay只需20ms位移达到微弱反向阈值，不能等同有用响应；全局意图折线最近距离在180°回走时可能很小，也不能单独证明跟随好。继续保存旧指标，并增加：改向后50/100/200ms及到松手的新方向净进展、达到10%/50%请求速度并保持40ms的时间、从改向实际点算旧向最大尾行、松手后总路程/旧向尾行、对当前目标的同步误差和停止后稳定误差。所有值带完成/保护/拒绝状态，不跨失败样例做不加标记的均值。

qref离散动态须覆盖启动、每次目标替换、松手、终点及速度归零，失败前后也需单独核对，不能只统计接受步后声称完整安全。1mm/2mm等偏差预算仅作研究候选，用户尚未确认产品容差。当前姿态朝向固定，不把结果扩展为姿态拖动或完整地轨自动回收。

### 10.3 阶段检查点：成功、否决与指标纠正均保留

以下为继续实验前保存的阶段事实，不是本轮最终结论。三个独立研究目录：

- `movel-joystick-v3-20261015T074918857Z`：四主批918组及15只读重放，B/D原字段和轨迹严格回归；全部运行期公共源/保护文档/正式产物哈希一致。固定32帧停车尾巴的第一版虽动态合规却走偏，否决；第二版最短{4,8,16,32}尾巴及局部投影出现零刹车候选抢先接受、掩盖进展的缺陷，失败保留。2b只改静止优先级，仍低速；2c才在同三个可行候选中按到请求速度距离选取，属于目标选择策略变化，不能称观测等价。此确定性缺陷纠正和后续策略变化在各自protocol先记后跑，明确超出最初两阶段探索计划，所有旧结果保留；看到过的留出不再称未调参，新加speed30。
- 最终2c参考全帧a≤.644倍物理A，0拒绝，但不等于跟手：base60 f0反向10%/50%速度响应102/137ms，对照B129/169ms；f0转90°新Y仅.084mm。f1转90°新Y.916mm、旧X尾行5.430mm（B3.958），f1/f2反向至松手仍净沿旧方向。只读原因记录确认f0局部提案有效，停车后缀却被旧向tailCeiling挡住，不能归因算力或完全物理不可行。更新平均约18次外部IK、最高134，未测F405。
- `movel-slider-v3-20261015T0747581122820Z`：第一版9站之前候选36组出现尾部拒绝；第二版288组每数学45/48完成，但speed2x三例永久延期，四时长全部过短。第三版看到留出后明确再登记（旧留出变已观察），引入关节位移/加速度时长估计、完整20ms关节缓存及≤128帧上限，新增1.5x速度/10ms反馈＋6ms偏斜/70Hz输入留出，540组内候选180/180到最新目标，0拒绝，全帧a≤.598；旧B/D严格回归，守护通过。峰值136外部IK/更新，理论520，双精度双缓存约20KB，不能直接当生产小改。
- 滑块第三版的完成性不等于响应全部改善：base60 f0突变保持进1mm并持续100ms延迟2596→938ms、延期54→4；但往返f0仍1149ms，smooth三个姿态525/236/364ms，较第二版262/197/278ms更慢。拖动期同步最新目标误差均值约5.6～6.0mm，含最初6mm目标跳变，不能冒充纯几何偏差。第三版固定时长估计已静态证实会排除可行短曲线：smooth f0 t=.30旧快.54s完整可行，却首选.66s；t=.60快.60s可行却首选.62s。往返hold附近两组候选均失败，还受非零初速/4mm几何控制点界限制，不全是时长问题。

独立审查`movel-online-audit-v3-20261015T074633Z`保存全帧、事件进展、尾行、同步目标与速度表。旧accepted-only会漏故障冻结：上轮矢量候选slider f0在.66s失败的完整游标二差分约9.024A，但不能直接等同故障实际发送的制动曲线。原B降至20mm/s后反向进展和尾行显著改善，代价每段请求位移减半；不能把降速称纯算法收益，也不能把必要独立轴停时当可达最优时间。

根的`movel-local-steering-v3-20261015`另存静态3D投影两批：.65线性预算仅17/36下一步通过，改.60线性裕量/.65真验后36/36通过，两数学一致，但不是整段控制器；可能引入Z和短暂反向Y，仍须几何预算。第一批raw失败导出回退速度的观测错误在下一批修正并保留说明。输入要求审查显示旧短滑块活动目标采样差分峰值123mm/s、二差分7013mm/s²；这是目标变化要求，非实际机器人速度。最新绝对目标并非必须逐点到达，条件性速度误差下界不能替代完成/响应检验，也不能为停止更新后长期死等开脱。

### 10.4 后续修订的先验登记范围

看到上述阶段结果后，增加一轮有明确依据的滑块对照，属于探索性后续，不能回填为最初预注册：保留第三版全部曲线/关节预算/完整缓存验收/保护/128帧上限，先尝试原四个快速时长（全帧验证），全失败才试加速度相关四时长救援，重复时长去重，最多8候选，理论外部IK上限1036。验证是否兼得可接受的短接续与不永久死等，非预设一定改善。已观察过的配置全部标探索，新增1.25x速度、80Hz和不同跳变时刻作为新留出，不再据这些结果调参。若仍继续旧缓存造成长尾，明确保留问题，不把最终完成当快速跟手。

另做一次手柄停车约束一致性的独立静态审计：提案限制Cartesian Δv，但旧停车尾巴是否允许更大Cartesian减速，从而让tailCeiling比新提案可停车范围更紧。先验证代码与冻结状态，不直接放宽偏差或宣称根因，若假设不符同样保存否定。

### 10.5 第四阶段完成后的判断与最后一个机制对照

滑块第四阶段`movel-slider-v3-20261015T0747581122820Z/phase4`共1176组，两数学模式各588＝B/D/E/F×147场景；F294/294到最新目标、无拒绝，全帧a≤.599402，最高188外部IK/更新，全部旧B/D/E540组旧字段完全一致、运行期守护通过。独立配对F对E：进1mm持续100ms的延迟192例变快、68变慢、34相同，配对中位改善26ms；base60 f0 smooth525→380ms、往返1149→234ms、突变938→933ms。

但新留出`jump_shift/speed125x/f2`退步876ms（322→1198ms），hold后500ms同步误差.050→14.716mm，两数学一致；旧意图全程max仍达6.115mm。F不能据多数改善选作统一默认。已排除“只要更快首个可行时长就解决连续更新”的判断；新目标无法接续时继续旧终点，仍会制造明显尾行。

手柄静态审计`movel-joystick-consistency-v3-20261015T081421542Z`确认：旧N4缓存允许500mm/s²，而新提案速度球按400约束，搜索族与缓存停车锚点不一致。原协议400仅是提案球，并未承诺全轨迹Cartesian硬上限；不能称物理关节A违规。把400也施于停车尾后，N4→N8，余停车距离1.2→2.8mm，但原primary N8仍需2.886893mm（超.086893），N4又需401.195mm/s²，单改不能解决f0新Y响应；独立32X刹车可行。未追加手柄控制器矩阵，旧918组及416文件索引保留。

基于上述明确失败，增加第五阶段**单机制**探索，另建独立目录，不覆盖F：只在最新目标接续全部失败时，尝试沿当前参考切向制动的停车cache，时间固定4/8/16/32个20ms帧；全帧真实IK、原.60A/.75V、终端静态帧和该停车段Cartesian400检查。停车不冒充接受最新目标。停车cache建立后不因再次失败重建推迟终点；继续该已验cache，每轮仍可试接最新目标。无可行停车cache保留原已验cache，明确计数，不冻结或放宽保护。

先precise/base60三姿态×四输入的G/F共24组开发，F严格回归；若无实质改善或出现硬拒绝，保留否决不扩。若有改善，再按其运行前protocol覆盖已知反例和新的输入时序/速度留出，不据留出调参。这个对照是看到第四阶段留出后追加的机制研究，不能回填为原先未见留出或预注册；它可能偏离新目标路线，必须同时报告同步误差、旧向尾行和完成，不以停车可行代替跟手。此轮仍不改公共两源、生产或设备。

### 10.6 第五阶段：短停车能救部分长尾，不能一律启用

独立目录`movel-slider-stop-fallback-v5-20261015T0825289937840Z`，开发24组F/G均完成，原F旧字段严格回归。独立门限发现往返f2的1mm持续100ms响应707→184ms，改善523ms；但突变保持f1/f2慢140/234ms。按先验至少一项≥100ms真实收益、无新增完成/动态失败的扩条件，保留全部退步后执行768组既定验证，不再调参。新增未见速度55mm/s、全新点及.18/.38s时序，旧配置明确已观察。

|第五阶段扩展，两数学合计|F快接续＋慢救援|G接不上时试短停车|
|---|---:|---:|
|到最新目标/样例|384/384|384/384|
|硬拒绝|0|0|
|全帧参考a最高/物理A|同原F约.600|.599094|
|观察最高外部IK/更新|188|189|
|理论外部IK/更新上限|1036|1100|

G对F384配对：78更快、146更慢、160相同，配对中位变化0；两组边际保持响应中位380→407ms，不能拿边际中位替代配对结果。最大改善548ms、最差退步440ms；新90对为34快/28慢/28同。没有证据支持统一默认G。

**机制有效的明确样例**：已知`jump_shift/speed125x/f2`最后目标.44s到来，F到.78才受理、G.48受理，受理等待340→40ms；停车cache_kind2不计受理。真正1mm持续100ms响应1198→745ms，500ms同步误差14.716→4.845mm，保持后实际路程22.922→10.298mm，旧全局路径误差4.619→.998mm，确有减少旧目标追赶的收益。

**必须保留的新反例**：新55mm/s、新时序/点的f0，1mm响应227→667ms，退440ms，500ms误差.027→2.106mm。停车在此延缓了更好的后续接续。smooth/base60拖动期同步误差f0均值6.315→6.363mm，f1/f2基本不变，不能把救部分停止长尾说成拖动全程跟手改善。

两模式G合计264次停车切换、412次停车时长试探、488次沿同一停车缓存继续；最新目标延期752帧＝264切换＋488继续，不是752条不同目标。四停车时长全失败0，停车未冒充目标受理、停车cache未因重试重建/延期终点；独立语义审查通过。停车段重构Cartesian A最高382.701mm/s²，满足其400预算；原目标Hermite和完整G轨迹不据此宣称Cartesian全程硬限400。

### 10.7 本轮最终判断：哪些已解决，哪些仍不满足

**已解决/确认**：

1. 滑块长期不受理最新目标的一个确定根因是候选时间全部过短，反复重试相同候选不会恢复；关节加速度相关时长救援和完整20ms缓存验证消除了本矩阵永久延期。
2. 参考启动/替换/终点/零速的完整动态可以约束在预算内，不能继续用仅接受帧的统计掩盖故障冻结。最后滑块E/F/G普通运行没有该隐藏超限。
3. “新目标接不上就跑完整旧目标”会制造可避免长尾，短停车是可行备选，但不是统一规则；只选最短可行T也不是统一规则。
4. 手柄的局部速度投影、有限停车后缀确能生成动态合规参考，f0反向有真实收益；旧候选顺序抢占和停车集合保守性已用等价观测/完整回归定位。

**仍未解决/不作生产结论**：

- 手柄40mm/s快速转90°/反向仍有姿态没有足够新向进展，不能靠低误差、无拒绝或微弱起动阈值宣布通过。
- 滑块虽然最终全到位，仍有约0.5～1.3s甚至更长的目标追赶和数毫米同步误差；拖动时和松开后收尾要分开评价。输入停止后的静态目标不能继续用高频目标解释死等/长尾。
- E/F/G各有更好、更差的历史状态，不能事后按单例选最好结果合成一个并不存在的控制器。下一策略必须明确偏差/旧向尾行/响应与速度的预算，以及何时继续旧cache、何时停车、何时接受新段；不能无目的叠加开关或只缩时间。
- 地轨本轮锁定以分离在线输入，TCP朝向固定；不外推完整七轴余量回收、旋转拖动、碰撞/负载/真实传输与生产STOP契约。

下一研究优先方向：手柄先比较速度与可停车时间协同的低工作量策略，保留20/30/40mm/s的运动量和响应对照；不把降速伪装成同等速度的算法提速。滑块以完整验证缓存为可行基线，研究按当前状态/新意图选择过渡，并区分连续目标流与释放后有限目标收尾；目标流估速/前馈等尚未试验，不能当本轮已实现。原重计算候选暂不合入公共两源或生产。

### 10.8 工作量、保存与论文证据边界

本轮主仿真组次：手柄918；滑块前三阶段864＋第四1176＋第五开发24/扩展768，共3750组次，包含重复对照，不是3750个统计独立样本。另有至少111组只读重放、静态机制诊断与全网格；不能把几何采样点/指标重读累加成新的运动实验组数。

原B/D及重复E/F全部已有JSON字段和相应完整轨迹按批严格回归；运行期公共源码、6保护文档及顶层正式产物守护均通过。原测试源本轮未改，全部新算法仅存独立artifact生成副本。本轮未构建/修改生产固件、协议、UI或操作设备/提交；第8节旧异常仍保留。

成本依然偏大：手柄最终最高134外部IK/更新、滑块F188、G189，原B/D对应最多4/6；内部候选FK和其他工作另计。模型求解不推进模拟时钟，所有计算假定在该控制边界完成，**50Hz离线运行不能证明F405在20ms内算完**，也不能由此反推F405算力不足。缓存每份最多130点（起点＋128运动＋静态终帧），双q/XYZ cache裸double内容20,800B，不含vector容量/分配器/临时IK栈；float/static/分批/压采样均未实施或验资源。

证据入口：

- 手柄：`movel-joystick-v3-20261015T074918857Z/LATEST_RESULT.md`及918组/只读机制/轨迹等价核对；一致性审计另在`movel-joystick-consistency-v3-20261015T081421542Z/report.md`。
- 滑块：`movel-slider-v3-20261015T0747581122820Z/report.md`、`phase4/`，第五阶段独立`movel-slider-stop-fallback-v5-20261015T0825289937840Z/`；旧阶段和每次失败索引不覆盖。
- 独立指标：`movel-online-audit-v3-20261015T074633Z`、`movel-online-audit-v4-20261015T081654Z`、`movel-online-audit-v5-20261015T082852Z`，含全部配对/同步/完成/延期/停车语义以及新留出。
- 根补充：`movel-local-steering-v3-20261015`保存静态投影与输入条件性界；`movel-online-synthesis-v3-20261015`保存独立索引、报告插图/PNG/PDF/采样CSV及绘图脚本。图是结果之后选取的两项收益和两项反例说明，不替换原全量主指标。
- 主机编译器当前安装信息另只读补录，注明为post-run，不能据此证明过去编译器二进制始终未变；一次Windows编码导出失败及修复保留，未改实验数据。

每批冻结原型/输入、协议与修订、新留出身份、实际编译运行命令/环境、原始1ms/20ms数据、失败/未完成/延期、保护与预算、独立审计及SHA256均保留。未来可能论文用途不变；这仍是模型工程研究，未做系统文献/新颖性比较或硬件/实时验收，不预设论文贡献。

最终根复核入口：`python firmware_artifacts/movel-online-synthesis-v3-20261015/final_validate_and_index.py`，读取8份冻结索引（416/257/66/114/56/58/108/80文件）全部SHA256零差异，重复E/F原字段再次严格一致，并确认两份公共测试源与本轮开始原件完全相同。每次另写UTC索引，含全部证据与6份更新后文档哈希；旧索引不覆盖。`audit_run_counts.py`另逐结果JSON核对3750主组次，与静态点/只读重放分离。

## 11. 解释当前方案并准备F405实测（2026-10-15）

用户要求先解释方案，再准备主控实际测试，确认具备USB虚拟串口和ST-Link。当前只读核对与资料准备，不改/构建/烧录固件、不连接串口/调试目标、不发运动、不提交。新增`docs/MoveL主控实测准备_20261015.md`说明最新意图、参考状态连续接续、完整缓存验证、普通位置/速度上限与生产有限q/v/a路径区别；F/G仍是各有退步的候选，锁轨固定朝向研究不外推在线七轴回收。

只读确认本地正式五套当前产物15.05/buildset4C897E4408E84445、20份ELF/MAP/BIN/HEX哈希与verification一致，设备版本未知。主控linked RAM余37184B，原型double双cache裸20800B不能放8KB栈，float化/固定容器须独立回归。command task阻塞队列，当前无在线50Hz follower调度；不能插进1kHz泵冒充接入。

新发现现有IKCHECK的wall_us使用HAL_GetTick(TIM6)与SysTick拼接的micros，代码没有保证两时基相位同步，存在约1ms跳变风险。现有命令仅做FK/IK数值初筛；正式建议局部DWT单源计时，不改全局micros。先身份/数值初筛→有界组件工作量→冻结原型完整20ms无运动回放→计算与普通MoveJ基线通过后另议运动。全更新墙钟含抢占、重建帧与缓存帧分开、P95/P99/max/超期/截断/栈heap均记录；不以单IK平均推导整轮通过。

具体诊断固件改动文件与门禁已列准备文档，尚待确认后实施；USB初筛也未执行。只读审计、文档与哈希另存新artifact准备批次，旧3750研究/失败/索引不改，论文用途和边界持续保留。

## 12. 15.06主控组件计算诊断实现与构建检查（2026-10-15）

用户批准纯计算诊断、编译/资源、一次工作区快照与持续保存数据；审计发现Fibre启动可绕过ASCII忙门禁后，用户另外批准dummy_robot.cpp启动/标定补充。实现及协议见[主控纯计算诊断_2026101506](主控纯计算诊断_2026101506.md)，本轮未打开串口/ST-Link目标、烧录或发设备运动。

新增独立无设备依赖的CartBench核心、USB #CBENCH v1、普通command任务有界执行、DWT单源计时和采集器。仅B层组件工作量：FK、预先位姿IK、FK+IK、TCP/限位连续选解、单轨候选、不可达IK；不把重复189次IK称完整F/G更新。128条固定结果区3584B，不新增任务栈/双轨迹缓存、不更改真实关节/轨目标或原运动算法。START公共入口与独立标定lease封住诊断预约竞态；STOP/DISABLE仍保留，诊断取消仅置标志。

构建两次，第一批71B5D52A759245DF保存first-build；明确补入IsMotionBusy门禁后重新生成身份，最终五套2026101506/A44FF1D6374E4FE0/source8a2abcfc02666c29ca7f2258892ea09034932f9492bd4ff8d6a9bbffc357da1a，epoch1792071728。Core Flash537904（比15.05+11076）、SRAM静态80316/linked97728（+3840，余33344）；四电机除56B身份外BIN一致、20k热路一致、最小Flash余620及linked RAM余4904保持。现有RWX链接警告保留，未改分区。

主机语义验证：核心precise/CMSIS512各478断言/61样本；适配真实片段各876断言，涵盖门禁、重入、DWT、状态、容量、内部checkpoint取消/环境变化、预算和真实启动/标定包装；采集器25项覆盖真实紧凑协议、64B响应边界、异步身份/Fake USB及零周期异常。原有限MoveL集成两模式各10277338检查通过，大量来自整数步进点穷举，不作为独立性能实验数。所有假时钟数据只检验逻辑，不是F405或PC真实耗时。

反例/修订继续保存：核心第二批133449因并行header API追加产生hash守护失败（计算断言通过，但不标整批通过）；适配早期测试未匹配CSV协议及假时钟预算预期过紧两失败批保留；原先设计长行超现Respond限制，在实现中改为DATA/RESULT紧凑CSV并测试最大字段，未实际发板。最终成功核心133607、适配134158和主批采集器日志明确分开。

主批`firmware_artifacts/movel-core-compute-diagnostic-20261015T132944589870Z/`保留改前git差异/源哈希/15.05镜像、首试编、最终五套镜像/日志/verification/源码冻结、resource-and-isolation-audit.json、既有回归、组件/适配/采集器证据索引与提交身份。旧离线批次保持不动。后续仍可能用于论文，未定贡献、不作新颖性或实机合格结论。

尚待硬件：独立DWT与HAL尺度初筛、真实FK/IK/完整组件耗时、栈水位、开串口行为与负载；20ms是目标节拍，尚无唤醒抖动证明。预算只能在work边界检查，可能超一个work；checksum/计数/守护包含在样本内，setup单列。完整F/G在线回放、手柄普遍快速改向、滑块接续策略及七轴回收仍未完成，不由此次编译通过替代。新snapshot包含工作区此前已存在的退回/灯效/上位机改动，其范围和提交号在主批另存，未推送。
