Liu3Beng-A/Dummy/docs/固件STOP异常调查交接_20261010.md

# Dummy机械臂固件STOP异常调查交接

截至北京时间2026年10月10日15:49这轮实机日志。项目在 `E:\Dummy-code`，目标是 `firmware_new` 主控和电机固件，以及根目录的 `串口助手_old.py`。

当前尚未解决的问题是：普通堵转检测开启时，HOME或MoveJ运动会出现保护通信超时，最近集中在J6。用户把电源输出限流从1A改到10A后，先前校准过程中疑似多板重新初始化的问题不再出现；后续通信超时仍存在，应分别审视这两组现象。

用户本次要求暂停继续分析和优化，先交接已有信息给新的对话及模型。最新建议的 `.04` 优化没有实施、没有构建、没有实机结果。当前最后交付为 `.03`。文中的根因推断供独立复核，不作为后续修改的前提。

## 工作范围与授权状态

必须遵守仓库及用户提供的AGENTS.md。修改任何代码、配置或项目文件前，明确文件与内容，等用户确认。只读分析可继续；不自行连接设备、发送串口、烧录、擦EEPROM、改参数或Git提交。已完成的历史修改不能作为新修改的无限授权。

- 主控：`firmware_new/dummy-ref-core-fw/`。
- 电机：`firmware_new/dummy-motor-fw/`，同一工程生成35、42、57、gripper四目标。修改前核对板型定义，不能手改全局类型让多个目标混淆。
- 目标助手：`串口助手_old.py`；`串口助手.py`仅供参考，禁止修改。Tkinter更新须走UI线程。
- `firmware/`为已知积累缺陷的参考版，只对照思路；`firmware_old/`为较早基线。
- `esp32/`禁止修改。
- 另一聊天正在修改 `Dummy上位机/` 和 `docs/SESSION_STATUS.md`。不要碰这些文件，也不要把其中其他任务状态当作本调查结论。
- 本调查独立记录为 `docs/固件版本查询与同步烧录_20261010.md`；冻结交付包不可覆盖或改写历史清单。
- 夜间调查自动化已暂停，当前不依赖定时任务继续工作。

## 系统背景与命令语义

硬件为STM32F405主控、8块STM32F103电机驱动。主控项目使用FreeRTOS；电机控制为20kHz回调，F103没有硬件浮点单元，诊断报告CPU为72MHz。CAN标准帧ID为 `(nodeID << 7) | cmdCode`。

| 节点 | 实物与本次烧录目标 | 系统行为 |
|---|---|---|
| 0 | ALL代理；版本查询中另定义为主控CORE | 不可把FW_VERSION的0当广播 |
| J1～J3 | M42，motor-42 | 机械臂关节 |
| J4～J6 | M35，motor-35 | 机械臂关节，当前重点J6 |
| J7 | M57，motor-57 | 地轨，参与IsMoving和OLED |
| J8 | GRIPPER，motor-gripper | 夹爪，不参与IsMoving和OLED |

校准命令 `!CALIBRATION`：J1～J6不进行寻限位运动，只将真实REST姿态当前位置绑定为 `{0,-75,180,0,0,0}`；J7/J8执行SEEK、BACKOFF、RETOUCH、RETURN，完成后八轴失能并保存。不能在任意机械姿态把当前坐标标成REST。

`!HOME`与 `!RESET`都是运动命令；RESET为回REST，不是MCU复位。`#ENC_CAL n`为磁编码器校准，成功后电机软件复位，协议仅确认dispatched，没有完成回执。START不会自动开启普通堵转检测，SYNC_ACC只读取加速度并更新主控缓存。

当前日志为INT模式（mode=2）。`accepted MOVEJ`只表示任务被接受，不能单凭该行证明到位。速度、加速度单位已经统一为r/s、r/s²；MOTION里的goal、real、d为电机圈，不能直接当关节角度。

## 用户确认的实物信息

1. 使用ST-LINK Utility，主要烧录BIN，选择的是两个 `firmware_new/.../build` 目录，不是旧 `cmake-build-debug`。历史烧录没有全片擦除。
2. 曾用助手手动恢复电机默认参数，之后仍有失败；不支持通过重复恢复默认定位当前故障。
3. 校准失败早期，用户实测电源最大输出限流误设为1A；改为10A后校准通过。10A是电源允许输出上限，不是每轴实际电流。未测板端电压，也没有RCC复位原因快照，因此电压跌落机制仍是解释而非直接测量结果。
4. 后续09:51测试时所有ST-LINK线已拔掉。通信使用USB串口。不要继续默认当前问题是ST-LINK连接造成。
5. 用户看到夹爪有小幅松开、再夹紧、最后张开；有一轮失败发生在地轨碰物理限位时。后来另一次失败发生于夹爪闭合。
6. 最新“J6重新安装”已澄清为拆装电机／驱动板，不是重新烧录。日志随后包含ENC_CAL6和完整机械校准，仍复现通信超时。没有证据表明已经替换为另一块已知正常驱动板。

## 历次交付与当前构建

| 发布版本 | 批次 | 主要变化与实机状态 |
|---|---|---|
| 20261010.01 | C4D78A5E8C046679 | 九板版本查询、old助手同步、同批身份和构建依赖。09:48九板查询一致。未实现RCC启动原因诊断。 |
| 20261010.02 | AE3091CF257B46DA | 增加CAN_DIAG：主控真实QUERY发送、电机QUERY接收、PROBE队列与真实发送、主控匹配／拒收、DWT控制与轮询计时。11:01启用检测的HOME仍失败。 |
| 20261010.03 | F08D62A917C34EB5 | 两层STOP/CAL中的精确MOTION_STATUS查询门禁修复；电机ADC DMA关闭无业务用途HT/TC通知，采样、DMA更新和TE保持。11:37以后HOME通过，J6有实际运动时仍失败；15:45～15:49再次复现。 |
| 拟议20261010.04 | 尚无 | 正常编码器样本跳变预算改用等价32位除法。用户尚未同意实施；当前暂停分析。 |

`.03`冻结目录：`E:\Dummy-code\build\firmware_release\20261010_03_F08D62A917C34EB5`。两个生产build目录曾与该包的BIN／HEX核对一致，时间戳相同本身不是身份依据。新对话如需确认当前状态，应读取manifest和文件摘要，不自行构建覆盖。

`.03`共同身份：release `2026101003`，epoch `1791602124`，UTC `2026-10-10T03:15:24+00:00`，北京时间11:15:24；生产输入SHA256 `a995daf385ad410e5053db105abfbf3b1128aaf39e48e5185e9bfac9d7836582`，486个生产输入。

| BIN | 字节数／精确读回长度 | 应用区余量 | SHA256 |
|---|---|---:|---|
| Core-STM32F4-fw.bin | 453724／0x6EC5C | sector0～7内70564B | 7016BDA98839EC32AD5291A6FC4BBD785FFDBDD2A1C89F481FCC5C61F719CF38 |
| motor-35.bin | 96476／0x178DC | 804B | 016896395EFC86EFAB8156178D91CCF9122DE6C8E3BA30C977FDB926E3824769 |
| motor-42.bin | 96476／0x178DC | 804B | E9AFE4268B40711E2C0E8C901C9A8170222ACD59C3FFE8A84F4E3701B5167054 |
| motor-57.bin | 96460／0x178CC | 820B | 3541C8D08685496D3844830000AC70FF0C7E457B185DAF2C644DF874534DD62B |
| motor-gripper.bin | 96420／0x178A4 | 860B | B4A7D97E198CAF4977927BBFB42F5F6372333D1730FEEA6621BB328EAC464386 |

35和42代码逻辑相同不意味着BIN相同；本批嵌入的板型身份不同，摘要不同。最后几份实机日志没有九板版本查询，不能仅凭本地存在`.03`产物就证明当时每块板均烧了`.03`。已确认九板`.02`身份的10:56日志也不能替后来的`.03`测试证明身份。

已完成离线验证包括主控命令／诊断1652项、old助手隐藏Tk与FakePort507项、ADC/DMA143项，以及既有主控TX512项、电机CAN148项和四板型选择器各21313项的测试记录／源摘要核对。两工程Release/Ninja构建成功，五目标身份、容量、HEX记录与BIN覆盖字节核对通过。离线HAL及输入有桩，不能证明真实ISR时间或实机故障已修复。原RWX链接警告仍存在。

### 生产文件的已完成修改

版本身份涉及两工程CMakeLists、`firmware_new/cmake/firmware_identity.cmake`、共享协议、主控解析、电机回复、old助手。身份包含实际生产源码、共享头、CMake、链接脚本及主控实际CMSIS库，排除build、文档和上位机。已补源码增删／身份重算／链接输入依赖；不能把旧依赖缺口继续当作当前构建机制。历史改动的完整清单见独立调查文档及各批manifest。

`.02`诊断涉及：共享 `firmware_new/protection_protocol.h`；电机 `Core/Src/can.c`、`Core/Inc/can.h`、`UserApp/main.cpp`、`Ctrl/Motor/stall_protection.cpp`；主控 `Bsp/communication/interface_can.cpp/.hpp`、`Robot/instances/protection_coordinator.cpp/.h`、`UserApp/protocols/ascii_protocol.cpp`；根目录old助手。

`.03`新增修改仅三个源码文件：

- `串口助手_old.py`：入队和写线程共用只读白名单加入精确 `#MOTION_STATUS`。
- `firmware_new/dummy-ref-core-fw/UserApp/protocols/ascii_protocol.cpp`：锁判定前处理精确MOTION查询。
- `firmware_new/dummy-motor-fw/Core/Src/adc.c`：HAL_ADC_Start_DMA成功后关闭DMA_IT_HT和DMA_IT_TC，保留DMA_IT_TE。

当前Git工作区包含已授权固件改动和另一聊天上位机改动，没有由本聊天执行Git提交。不要把未提交状态误判为当前版本未构建，也不要清理或回滚他人的改动。

## 主要测试时间线

| 时间 | 操作与结果 | 判读限制 |
|---|---|---|
| 10月9日21:38～22:16 | 校准中BAD_TASK、task0、失能、疑似重新初始化；MoveJ后启动假定坐标再现 | 缺RCC原因；早期与新版恢复参数／重烧交错，不能将所有日志视为同一版本 |
| 10月10日09:03～09:51 | 地轨或夹爪校准失败，ST-LINK已拔、恢复默认仍失败 | 用户后来发现电源限流1A |
| 09:58～10:01 | 电源改10A，校准成功；检测开启的HOME仍J2通信超时，关闭检测后运动通过 | 供电问题与后续通信问题应分别复核 |
| 10:14～10:15 | J2/J3 LAST无触发记录，HOME通信超时，九板`.01`查询一致 | 尚无CAN_DIAG计数 |
| 10:56 | 九板`.02`一致；只有失能诊断，没有运动 | 不能作为修复通过证据 |
| 11:01 | `.02`启用检测HOME失败；J2/J3轮询停顿约971/976ms，时钟偏移新增相近幅度 | MOTION查询被助手拦截，失能后才可读，后来`.03`修复 |
| 11:37～11:40 | 校准及HOME成功；后续MoveJ／RESET两次J6通信超时 | 成功HOME中J6 d=0，未覆盖J6位移；缺J6诊断 |
| 15:31～15:33 | J6 detect0；HOME4391ms、RESET6238ms完成，六次MoveJ被接受，无保护STOP | 仅失能基线，无结束诊断；accepted不证明各任务到位 |
| 15:45～15:46 | 七轴ENABLE1并SAVE；HOME4356ms完成；MoveJ、RESET均J6超时，取得前后诊断 | 该轮有SAVE，但已在运动前约31秒完成 |
| 15:46～15:49 | J6拆装后ENC_CAL6、机械CAL完成；HOME4413ms完成，相同MoveJ仍J6超时 | ENC_CAL预期复位，禁止跨该复位直接对比累计数 |

## 最新实机证据

### J6开启检测时的同次启动前后对比

以下来自最新完整日志前半段，三次boot均65361，电机和主控统计连续。

| J6诊断 | START后运动前 | MoveJ失败后 | RESET失败后 |
|---|---:|---:|---:|
| up／m_at，ms | 43178／43240 | 61418／62480 | 82770／84800 |
| m_at减up，ms | 62 | 1062 | 2030 |
| ctl_max，CPU周期 | 3069 | 3345 | 3345 |
| ctl_max，us | 42.625 | 46.458 | 46.458 |
| ctl_gap，CPU周期 | 1592442 | 1592442 | 1592442 |
| ctl_late | 812 | 1316 | 1382 |
| pollgap，ms | 100.339 | 995.947 | 995.947 |
| 电机query_rx／probe_q／txok | 256／256／256 | 369／369／369 | 498／498／498 |
| 主控m_txok／m_match | 256／256 | 376／369 | 511／498 |
| merge／full／age／tries／m_reject | 全0 | 全0 | 全0 |
| rx_ovr位图 | 512 | 512 | 512 |

日志事实：两次STOP直接报PROTECTION_STATUS_TIMEOUT，probe年龄1002／1003ms；随后COMMUNICATION_TIMEOUT、CANCELLED_STOP；两次J6 LAST无触发记录。加速度实际为30r/s²，仍复现此前a200条件下同类错误。

既有推断：同板主控与电机HAL时基差先新增1000ms、再新增968ms，接近DWT约996ms轮询停顿；控制入口峰值没有新增一秒间隔，支持低优先级CAN、主循环和SysTick服务受阻而控制回调继续执行。此解释较强，但仍需新模型复核时基、计数和调度实现，不能直接宣布完整ISR超预算为唯一根因。

主控TXOK与J6软件QUERY接收累计差为0→7→13，收到QUERY后电机入队、真实回复TXOK、主控匹配均相等。关注缺口在主控发送到电机接收入口之间，但两芯片快照不同步，TXOK只说明总线发送成功，不能说目标J6收到，也不能精确称丢了7／13帧。

基线已存在约22ms控制入口间隔、100ms轮询峰值和FIFO0溢出位图；不能归给之后运动。位图512不是512次，且不变不能排除新增同类溢出。保存已完成后才回复saved，当前没有延迟31秒至运动才擦写的证据。

### 重新校准后的第三次失败

15:46:56发送ENC_CAL6；15:47:35开始机械CAL，15:48:01完整完成。15:49:03 HOME开始并成功4413ms。15:49:15.901发送 `>90,0,90,90,90,90,90,35`，15:49:17.000 J6 PROTECTION_STATUS_TIMEOUT，probe1005ms、rx902ms、flags03；之后COMMUNICATION_TIMEOUT、CANCELLED_STOP。

结束J6诊断：up132737、m_at260840、boot65362，ctl_max3372周期＝46.833us、pollgap69695658周期＝967.995ms、ctl_late1101；query_rx／probe_q／txok均666，merge/full/age/tries0。主控累计统计跨ENC_CAL继续增长，不能与重启后电机666直接相减算丢帧。

LAST无触发记录，LIVE detect1、fb1、bad_total0、peak_ms0、event0、trigger_reasonNONE。重新校准没有消除故障，但这些查询是事后快照，不是连续实时轨迹。

boot65361→65362与磁校准成功后HAL_NVIC_SystemReset相符，源码在 `Ctrl/Sensor/Encoder/encoder_calibrator_base.cpp:381–382`。没有第三轮运动前同boot基线，不能用这次boot变化证明第三次MoveJ自发复位。flags07→03与机械坐标捕获清除ASSUMED_BOOT相符。

### 检测关闭的成功对照

15:31日志START前J6为SWITCH_OFF、detect0、enabled0。START及SYNC_ACC不修改ENABLE，后续没有开启检测命令。HOME、RESET明确完成，MoveJ只确认被接受，期间无保护STOP。

唯一J6诊断在失能时：ctl_max2021周期＝28.069us、ctl_late0、pollgap7174周期＝99.64us，query／TX／match均133，rx_ovr0。该基线不是运动路径，因此不能把28.07→42.63us直接称为检测开启带来的纯耗时增量。通信看门狗在ENABLE门禁前，关闭普通检测并没有直接关闭这两个通信超时保护。

## 已核实的代码入口

行号为本次交接时定位，后续改动可能移动；新模型应以实际文件为准。

| 文件与位置 | 已核实行为 |
|---|---|
| 主控Robot/instances/protection_coordinator.cpp:578–612 | Health以HAL时钟判断超过1000ms保护回复失效；HealthFault调用BeginStop(false)。 |
| 电机Ctrl/Motor/stall_protection.cpp:606–644 | TickProtection先处理编码器和通信watchdog，再检查普通检测ENABLE；通信watchdog按20kHz调用次数计时。 |
| 同文件:559–569 | 只有isLocal且reason为STALL才冻结普通堵转触发快照；COMMUNICATION_TIMEOUT采用非本地STALL路径。 |
| 电机Core/Src/can.c:426附近 | 保护QUERY接收计数位于软件接收入口；不是CAN总线上所有收到帧的计数。 |
| 主控Bsp/communication/interface_can.cpp:88附近 | m_txok来自真实发送完成结果，不只是放入邮箱。 |
| 电机UserApp/main.cpp:217–238 | DWT起止包围入口统计、清UIF、编码器SPI和motor.Tick20kHz；尾部统计及异常出入栈不在测量内。 |
| 电机Core/Src/stm32f1xx_it.c:359附近 | TIM4_IRQHandler直接调用回调后return；generic HAL_TIM_IRQHandler不可达，ELF为直接跳转。 |
| 电机Core/Src/adc.c:78–82 | `.03`关闭ADC DMA HT/TC；持续采样和DMA数据更新保持。 |
| 电机Ctrl/Motor/motor.cpp:83–99 | 编码器有效性和单圈跳变预算；当前正常样本调用软件64位除法。 |
| 电机UserApp/protocols/interface_can.cpp:185附近 | velocityLimit可运行时修改，不能把预算在启动时永久缓存。 |
| 电机Ctrl/Motor/motion_planner.cpp:233附近 | 制动距离原表达式含binary32舍入，直接换精确整数不保证等价。 |
| 电机Ctrl/Sensor/Encoder/encoder_calibrator_base.cpp:381–382 | ENC_CAL成功后软件复位。 |
| 主控Robot/instances/dummy_robot.cpp:1569附近 | MOTION复制任务缓存；real与f/age可能来自不同更新时间，不能把事后打印当报错瞬间一致快照。 |

### 计时解释的边界

20kHz周期为50us。现有ctl_max包含SPI重试及motor控制链，但不覆盖异常硬件入出栈、开始读DWT前的少量指令、结束读DWT后的max/late更新及函数尾部。ctl_max46.46～46.83us接近预算不等于已经证明完整ISR超过50us；最大值也不是平均占用。不能凭静态指令数报告WCET。

TIM4为priority0，CAN和SysTick为3。历史ADC两通道、两半字DMA circular的HT/TC通知机会约47.6k/s，同为priority0；`.03`已关闭HT/TC。DMA采样总线活动仍在，不能把它等同于47.6k次普通IRQ，也不能继续把旧IRQ当当前产物必然原因。I2C未启用。SPI最多三次尝试在现有ctl_max范围内；最终成功的重试未必增加bad_total。

既有解释认为：通信中断／主循环受压制，约一秒后按控制tick推进的通信watchdog进入保护，跳过普通检测等工作后低优先级恢复。这与时长相容，但还没有完整ISR累计占用、入口相位或外部波形证据。

## 已排除或削弱的方向

- 普通堵转阈值直接触发最近三次J6 STOP：日志入口为通信超时，LAST无触发，event及peak为0。实物是否有阻挡与该软件入口是不同问题。
- 只靠降低加速度解决：a200和a30均复现。不要把高加速度作为必要条件。
- 机械校准或编码器表旧数据单独解释：重新ENC_CAL与机械CAL后仍失败，方向已削弱；不能据此完全排除SPI、硬件接触或重试负荷。
- 最近两次失败自发MCU重启：boot和计数连续。第三轮boot变化有ENC_CAL前置复位，应单独对待。
- 新回复在PROBE队列过期／队满、主控nonce拒绝就是本轮原因：相关计数均0。本地确有“合并PROBE只换负载，不刷新创建时间／重试预算”代码行为，但本轮没有计数支持它触发。
- MOTOR_DEFAULT主控残留批量任务，等未来失能再同时复位：夜间核实没有这种后台队列；电机受理即擦／核验／复位或清失败状态，旧nonce／txn只重放结果；GUI超时不自动恢复参数重试。不能拿首次裸ok证明受理。
- 主控EEPROM损坏、必须全片擦除：没有支持本轮根因的证据。重复擦除会丢失校准和参数并增加变量。
- 用户始终烧错旧cmake-build-debug：旧路径确实陈旧，但用户明确手动选择build，且曾九板版本一致。后续每轮身份仍需单独核对。

以上是既有审计结论，允许新模型用具体反证推翻；不要把“未见证据”写成全系统永不可能。

## 尚未实施的方案与其他问题

最后提议只改 `Ctrl/Motor/motor.cpp`：transportMissingTicks为0时，以32位有符号velocityLimit除20000，再扩成64位加64；非零保留原64位乘除。运行时速度上限每tick读取，不改变跳变拒绝、计数和坐标更新。现motor-35 ELF正常路径确实调用__aeabi_ldivmod；可确定减少一次软件除法，尚不能保证改善多少时间或解释为何仅J6受影响。35／42使用公共逻辑。

该提议未获实施授权，`.04`不存在。此前仅做了内存中的数学设计对照，包含正负边界与随机值；不是生产回归、ARM实测或完整ISR验证。其他反馈有效性复用、电流上限重复查询优化、制动公式调整也未实施。

直接将浮点制动距离改为精确整数会改变舍入。例如a=30×51200、v=1535999时，原binary32链得到767998，精确整数v²/(2a)为767999。不可把“看似等价”的大改混入首次优化。

夜间曾识别其他独立问题：主控一次反馈无效即保护，而电机本地连续5ms才故障；START接受ASSUMED_BOOT坐标，多圈原点在重启后无法只靠单圈编码器恢复；J8复位丢CAL上下文影响STOP受理；context合并可能覆盖失败信息；ENC_CAL与机械CAL门禁存在特定前置操作下互斥缺口；RGB正常DMA回调造成errors与frames同增的假错误计数。这些没有作为本次控制逻辑修复实施，应复核现代码再确认。RCC_CSR／FLASH_OBR启动原因和独立boot计数也没有实现，不要把CAN_DIAG原有boot命名空间当新BOOT诊断。

## 烧录和持久数据边界

现有交付推荐BIN，起始地址0x08000000。主控只擦sector0～7，保留sector11 RGB；电机只擦page0～94，95～126编码器表、127参数必须保留。电机应用限95KiB＝97280B，新增诊断／优化须实际链接核容量。

编码器表0x08017C00～0x0801FBFF，参数0x0801FC00～0x0801FFFF。应用区显式擦除后Program & Verify选BIN、Skip Flash erase、Verify after programming；九板同批完成后断开ST-LINK，再正常上电核对身份。遇RDP读保护，不自行解除，解除可能全片擦除。

版本身份不等于应用逐字节一致。只读核验使用HotPlug下Compare device memory with file，或从起始地址按manifest精确BIN长度读回比较SHA256，不能用Program & Verify冒充只读比较。HEX覆盖记录与BIN一致但含padding空洞：主控56B，电机4B。按HEX烧录后的整个范围不能不加区分地与BIN完整SHA比较。

## 现有查询与复测约束

以下记录既有查询能力，当前交接不要求用户立即重做测试。`#FW_VERSION 0`查主控，1～8查电机；九板逐条等待end，可带请求号1～65535。`#CAN_DIAG 6`查J6，不支持0广播，也可带请求号。`#STALL_STATUS 6 LAST`读取普通堵转触发快照，`#STALL_STATUS 6`为LIVE；校准快照对应CAL_STATUS。`.03`中的精确 `#MOTION_STATUS`可在STOP内直接读取，不需要先DISABLE。

后续若复测，先核对九板身份、可信坐标和相同起点，仅RAM切换ENABLE，不额外STALL_SAVE／CAL_SAVE／恢复默认。读START后的基线，再执行单次有实际位移的任务，成功或STOP后先LAST、CAN_DIAG，再LIVE、MOTION；每条等待end。取证前不要START、失能、复位或重校准，运动中不持续刷诊断。

CAN_DIAG统计本次启动累计值，查询自身也增加收发统计。PROBE、诊断、MOTION的flags字段属于不同消息，不能互套位含义。MOTION ms是任务计时，START／运动可改变起点，不是通用uptime。原boot为启动命名空间，存在初始化seed和回绕规则，不能独立当严格单调启动次数；应结合uptime和同启动累计数。

## 原始日志索引

所有文件名均为 `已粘贴的文本.txt`，完整路径统一为 `C:\Users\Liu3Beng\.codex\attachments\<下表ID>\已粘贴的文本.txt`。附件文件保留原样。交接后的新对话如在同一机器可直接读取；如果迁移环境，本文件后面的摘录可先使用，但不能替代完整上下文。

| 日期及日志时间 | 附件ID | 用途 |
|---|---|---|
| 10月9日21:38 | 7a6a48f8-3c33-489a-9d00-105f920b337f | 最初校准／MoveJ异常，含旧版与重烧交错 |
| 10月9日22:04 | f61dccb1-74c3-4799-8c4d-ca48772115b9 | 默认恢复相关测试 |
| 10月9日22:16 | 8dae8bb1-f4c9-4e66-9ae0-ae57339da23b | 校准BAD_TASK／重新初始化疑点 |
| 10月10日09:03 | 72d3ac4a-4638-4c4d-8de4-7b225b45d8f3 | 校准失败 |
| 09:05 | 1099fbbe-384b-4d27-b467-7a7ed03f1524 | 第二轮校准／运动报告 |
| 09:48 | 9c34c205-2684-4866-a48f-9e6f8dcfdb4a | 九板版本、J7返回时失败；较早另贴04334f14-ded1-407b-b10a-bca33342c74f |
| 09:51 | 20a79da6-bb51-4796-9ebb-67aee9aaecf5 | 恢复默认后校准仍失败，用户补充夹爪闭合；另贴d8605648-c905-4c46-83a9-c57bb6a1f8d9 |
| 09:58 | 53595737-988f-4be1-bc2c-690927fe7ac7 | 电源修正后校准成功、HOME超时及关闭检测对照；另贴90b4bd9b-2180-4552-8aa1-27cf96e971c9 |
| 10:14 | 6fabf87a-c054-47f0-ba20-64e13eb2073b | 无STALL记录，版本一致 |
| 10:56 | 2651552d-55b3-4f6c-aa44-fd4f1cfc6c8c | `.02`九板查询、只有失能诊断 |
| 11:00～11:02 | e30b106c-608f-4fbe-b7e3-467e6eb6e0d7 | `.02`HOME失败、J2/J3时序证据、MOTION门禁 |
| 11:37～11:40 | 4cb21b55-50c7-4a6a-9116-cd90d9b0e07d | HOME通过，MoveJ／RESET J6失败 |
| 15:31～15:33 | 694b706b-07f3-4308-b7f9-61060cfdc756 | J6检测关闭成功对照 |
| 15:45～15:46 | b505337a-0146-4ea5-8f58-417637576da3 | ENABLE1、前后诊断、两次J6失败 |
| 15:45～15:49 | 468d0363-7b54-442a-8b1f-0df0006ca7ca | 最新完整扩展版，应优先读；增加ENC_CAL、机械CAL后第三次失败 |

RGB配置返回中包含字面量RGB_STATE STOP，它只是状态灯配置名称，不能按字符串STOP计作保护停机。应读取PROTECT／STALL／STOP locked实际事件。

## 原始日志摘录

下面由附件原文按明确条件选取。分段可以不连续，省略行不代表没有发生；每个代码块内保留原时间、内容和顺序。后续模型应先看最新完整扩展日志，再查对照与历史。

### 检测关闭时的LIVE状态和HOME结果

来源：`C:\Users\Liu3Beng\.codex\attachments\694b706b-07f3-4308-b7f9-61060cfdc756\已粘贴的文本.txt`。按时间范围 15:31:26.000 至 15:31:39.079 选取，共38行。

```text
[15:31:27.065] [TX] #STALL_STATUS 6
[15:31:27.075] [RX] ok STALL_STATUS [6] pending
[15:31:27.137] [RX] STALL_STATUS [6] req=48770 session=0 at_ms=30079
[15:31:27.138] [RX] STALL_STATUS [6] mode=0 reqmode=0 phase=0 gate=SWITCH_OFF
[15:31:27.139] [RX] STALL_STATUS [6] intent=0 fb=1 enabled=0 detect=0
[15:31:27.139] [RX] STALL_STATUS [6] unmet=0 stop_lock=0
[15:31:27.160] [RX] STALL_STATUS [6] I_cmd=0 I_filt=0 I_thr=1.5 A
[15:31:27.162] [RX] STALL_STATUS [6] v_raw=0 r/s
[15:31:27.163] [RX] STALL_STATUS [6] v_filt=0 v_thr=0.02 r/s
[15:31:27.163] [RX] STALL_STATUS [6] err=0 err_thr=0.0416602 r
[15:31:27.183] [RX] STALL_STATUS [6] timer_ms=0 need_ms=300
[15:31:27.183] [RX] STALL_STATUS [6] peak_ms=0
[15:31:27.184] [RX] STALL_STATUS [6] clear=NONE detail=0
[15:31:27.184] [RX] STALL_STATUS [6] last_ms=0
[15:31:27.205] [RX] STALL_STATUS [6] bad_total=0
[15:31:27.206] [RX] STALL_STATUS [6] bad_run_peak_ms=0
[15:31:27.207] [RX] STALL_STATUS [6] startup_left_ms=0
[15:31:27.208] [RX] STALL_STATUS [6] record=LIVE event=00000000
[15:31:27.217] [RX] STALL_STATUS [6] v_ref=0 r/s
[15:31:27.217] [RX] STALL_STATUS [6] goal_err=0 r
[15:31:27.219] [RX] STALL_STATUS [6] dir=0 stall_dir=0
[15:31:27.219] [RX] STALL_STATUS [6] trigger_reason=NONE
[15:31:27.241] [RX] STALL_STATUS [6] end req=48770
[15:31:27.849] [TX] #STALL_STATUS 6 LAST
[15:31:27.853] [RX] ok STALL_STATUS [6] pending
[15:31:27.904] [RX] STALL_STATUS [6] no_trigger_record req=48771
[15:31:27.904] [RX] STALL_STATUS [6] end req=48771
[15:31:31.236] [TX] !HOME
[15:31:31.243] [RX] error DISABLED
[15:31:32.847] [TX] !START
[15:31:32.894] [RX] Start pending
[15:31:34.154] [TX] #GET_CMDMODE 1
[15:31:34.154] [RX] Started ok
[15:31:34.164] [RX] ok CMDMODE mode=2 busy=0 issued=0 req=1
[15:31:34.676] [TX] !HOME
[15:31:34.683] [RX] queued HOME id=1 mode=INT
[15:31:34.684] [RX] Home pending
[15:31:39.079] [RX] ok HOME id=1 ms=4391
```

### 检测关闭时RESET完成

来源：`C:\Users\Liu3Beng\.codex\attachments\694b706b-07f3-4308-b7f9-61060cfdc756\已粘贴的文本.txt`。按时间范围 15:33:10.000 至 15:33:16.632 选取，共4行。

```text
[15:33:10.384] [TX] !RESET
[15:33:10.386] [RX] queued RESET id=8 mode=INT
[15:33:10.397] [RX] Reset pending
[15:33:16.632] [RX] ok RESET id=8 ms=6238
```

### 七轴检测开启并保存

来源：`C:\Users\Liu3Beng\.codex\attachments\468d0363-7b54-442a-8b1f-0df0006ca7ca\已粘贴的文本.txt`。按时间范围 15:45:22.479 至 15:45:24.904 选取，共18行。

```text
[15:45:22.479] [TX] #STALL_SET 0 ENABLE 1
[15:45:22.482] [RX] ok #STALL_SET pending
[15:45:22.544] [RX] ok STALL_SET [1] ENABLE=1
[15:45:22.608] [RX] ok STALL_SET [2] ENABLE=1
[15:45:22.660] [RX] ok STALL_SET [3] ENABLE=1
[15:45:22.723] [RX] ok STALL_SET [4] ENABLE=1
[15:45:22.785] [RX] ok STALL_SET [5] ENABLE=1
[15:45:22.848] [RX] ok STALL_SET [6] ENABLE=1
[15:45:22.900] [RX] ok STALL_SET [7] ENABLE=1
[15:45:24.164] [TX] #STALL_SAVE 0
[15:45:24.176] [RX] ok #STALL_SAVE pending
[15:45:24.259] [RX] ok STALL_SAVE [1] saved
[15:45:24.363] [RX] ok STALL_SAVE [2] saved
[15:45:24.467] [RX] ok STALL_SAVE [3] saved
[15:45:24.562] [RX] ok STALL_SAVE [4] saved
[15:45:24.666] [RX] ok STALL_SAVE [5] saved
[15:45:24.780] [RX] ok STALL_SAVE [6] saved
[15:45:24.904] [RX] ok STALL_SAVE [7] saved
```

### START后J6诊断基线

来源：`C:\Users\Liu3Beng\.codex\attachments\468d0363-7b54-442a-8b1f-0df0006ca7ca\已粘贴的文本.txt`。按时间范围 15:45:37.196 至 15:45:42.001 选取，共33行。

```text
[15:45:37.196] [TX] !START
[15:45:37.233] [RX] Start pending
[15:45:38.464] [TX] #GET_CMDMODE 1
[15:45:38.464] [RX] Started ok
[15:45:38.471] [RX] ok CMDMODE mode=2 busy=0 issued=0 req=1
[15:45:41.673] [TX] #CAN_DIAG 6 17601
[15:45:41.680] [RX] ok CAN_DIAG [6] req=17601 pending
[15:45:41.743] [RX] CAN_DIAG [6] req=17601 schema=1 type=M35 dwt=1
[15:45:41.743] [RX] CAN_DIAG [6] req=17601 up=43178 cpu=72000000
[15:45:41.744] [RX] CAN_DIAG [6] req=17601 ctl_max=3069 ctl_gap=1592442
[15:45:41.744] [RX] CAN_DIAG [6] req=17601 ctl_late=812 pollgap=7224430
[15:45:41.765] [RX] CAN_DIAG [6] req=17601 rx_ovr=512 query_rx=256
[15:45:41.767] [RX] CAN_DIAG [6] req=17601 probe_q=256 merge=0
[15:45:41.767] [RX] CAN_DIAG [6] req=17601 txok=256 alst=0
[15:45:41.768] [RX] CAN_DIAG [6] req=17601 terr=0 full=0
[15:45:41.791] [RX] CAN_DIAG [6] req=17601 age=0 tries=0
[15:45:41.792] [RX] CAN_DIAG [6] req=17601 nonce_rx=48282 nonce_tx=48282
[15:45:41.792] [RX] CAN_DIAG [6] req=17601 last_tx=43128 last_rx=43128
[15:45:41.793] [RX] CAN_DIAG [6] req=17601 depth=0 peak=3 head=00 flags=00
[15:45:41.803] [RX] CAN_DIAG [6] req=17601 head_age=0 boot=65361
[15:45:41.805] [RX] CAN_DIAG [6] req=17601 m_q=256 m_txok=256
[15:45:41.805] [RX] CAN_DIAG [6] req=17601 m_alst=0 m_terr=0
[15:45:41.806] [RX] CAN_DIAG [6] req=17601 m_abort=0 m_rx=256
[15:45:41.828] [RX] CAN_DIAG [6] req=17601 m_match=256 m_reject=0
[15:45:41.828] [RX] CAN_DIAG [6] req=17601 m_sent=48282 m_got=48282 m_txn=48282
[15:45:41.829] [RX] CAN_DIAG [6] req=17601 m_rxage=85 m_pbage=90
[15:45:41.831] [RX] CAN_DIAG [6] req=17601 m_at=43240
[15:45:41.851] [INFO] CAN_SUMMARY J6 req=17601 已确认完整诊断 type=M35 boot=65361 up=43178ms；计数包含查询本身，需比较同次启动的前后读数
[15:45:41.929] [INFO] CAN_SUMMARY J6 req=17601 probe 收到=256 入队=256 合并=0 TXOK=256 过期丢=0 尝试丢=0 队满=0
[15:45:41.944] [INFO] CAN_SUMMARY J6 req=17601 nonce 电机RX/TX=48282/48282 主控sent/got/TXOK=48282/48282/48282 匹配=256 拒绝=0 RX溢出位图=0x00000200
[15:45:41.967] [INFO] CAN_SUMMARY J6 req=17601 控制观测max=42.62us/3069cycles 周期预算=50us/3600cycles 占比=85.2%
[15:45:41.978] [INFO] CAN_SUMMARY J6 req=17601 控制入口gap=22117.25us late=812 主循环gap=100339.31us；观测值需结合前后计数，不能单独判定 STOP 根因
[15:45:42.001] [RX] CAN_DIAG [6] req=17601 end
```

### 首次MoveJ失败和J6结束诊断

来源：`C:\Users\Liu3Beng\.codex\attachments\468d0363-7b54-442a-8b1f-0df0006ca7ca\已粘贴的文本.txt`。按时间范围 15:45:47.203 至 15:46:04.392 选取，共47行。

```text
[15:45:47.203] [TX] !HOME
[15:45:47.209] [RX] queued HOME id=1 mode=INT
[15:45:47.211] [RX] Home pending
[15:45:51.566] [RX] ok HOME id=1 ms=4356
[15:45:54.899] [INFO] 已存储: #1 [90.0,0.0,90.0,90.0,90.0,90.0,90.0]
[15:45:55.658] [TX] >90,0,90,90,90,90,90,35
[15:45:55.663] [RX] queued MOVEJ id=2 mode=INT
[15:45:55.664] [RX] accepted MOVEJ id=2
[15:45:56.757] [RX] PROTECT J6 failed reason=PROTECTION_STATUS_TIMEOUT
[15:45:56.758] [RX] PROTECT J6 age rx=878 probe=1002 flags=07
[15:45:56.759] [RX] PROTECT J6 queued=350 rx=344 retry=3
[15:45:56.760] [RX] PROTECT CAN alst=3 terr=0 full=0
[15:45:56.877] [RX] STALL J6 phase=6 reason=COMMUNICATION_TIMEOUT
[15:45:56.883] [RX] STALL J6 phase=5 reason=CANCELLED_STOP
[15:45:57.240] [RX] STOP locked
[15:46:00.939] [TX] #CAN_DIAG 6 17602
[15:46:00.945] [RX] ok CAN_DIAG [6] req=17602 pending
[15:46:00.987] [RX] CAN_DIAG [6] req=17602 schema=1 type=M35 dwt=1
[15:46:00.989] [RX] CAN_DIAG [6] req=17602 up=61418 cpu=72000000
[15:46:00.990] [RX] CAN_DIAG [6] req=17602 ctl_max=3345 ctl_gap=1592442
[15:46:00.991] [RX] CAN_DIAG [6] req=17602 ctl_late=1316 pollgap=71708214
[15:46:01.011] [RX] CAN_DIAG [6] req=17602 rx_ovr=512 query_rx=369
[15:46:01.012] [RX] CAN_DIAG [6] req=17602 probe_q=369 merge=0
[15:46:01.013] [RX] CAN_DIAG [6] req=17602 txok=369 alst=0
[15:46:01.014] [RX] CAN_DIAG [6] req=17602 terr=0 full=0
[15:46:01.024] [RX] CAN_DIAG [6] req=17602 age=0 tries=0
[15:46:01.025] [RX] CAN_DIAG [6] req=17602 nonce_rx=49238 nonce_tx=49238
[15:46:01.027] [RX] CAN_DIAG [6] req=17602 last_tx=61329 last_rx=61328
[15:46:01.029] [RX] CAN_DIAG [6] req=17602 depth=0 peak=3 head=00 flags=00
[15:46:01.048] [RX] CAN_DIAG [6] req=17602 head_age=0 boot=65361
[15:46:01.051] [RX] CAN_DIAG [6] req=17602 m_q=376 m_txok=376
[15:46:01.052] [RX] CAN_DIAG [6] req=17602 m_alst=0 m_terr=0
[15:46:01.053] [RX] CAN_DIAG [6] req=17602 m_abort=0 m_rx=369
[15:46:01.071] [RX] CAN_DIAG [6] req=17602 m_match=369 m_reject=0
[15:46:01.073] [RX] CAN_DIAG [6] req=17602 m_sent=49238 m_got=49238 m_txn=49238
[15:46:01.074] [RX] CAN_DIAG [6] req=17602 m_rxage=65 m_pbage=130
[15:46:01.075] [RX] CAN_DIAG [6] req=17602 m_at=62480
[15:46:01.085] [INFO] CAN_SUMMARY J6 req=17602 已确认完整诊断 type=M35 boot=65361 up=61418ms；计数包含查询本身，需比较同次启动的前后读数
[15:46:01.086] [INFO] CAN_SUMMARY J6 req=17602 probe 收到=369 入队=369 合并=0 TXOK=369 过期丢=0 尝试丢=0 队满=0
[15:46:01.087] [INFO] CAN_SUMMARY J6 req=17602 nonce 电机RX/TX=49238/49238 主控sent/got/TXOK=49238/49238/49238 匹配=369 拒绝=0 RX溢出位图=0x00000200
[15:46:01.089] [INFO] CAN_SUMMARY J6 req=17602 控制观测max=46.46us/3345cycles 周期预算=50us/3600cycles 占比=92.9%
[15:46:01.090] [INFO] CAN_SUMMARY J6 req=17602 控制入口gap=22117.25us late=1316 主循环gap=995947.42us；观测值需结合前后计数，不能单独判定 STOP 根因
[15:46:01.093] [RX] CAN_DIAG [6] req=17602 end
[15:46:04.335] [TX] #STALL_STATUS 6 LAST
[15:46:04.339] [RX] ok STALL_STATUS [6] pending
[15:46:04.390] [RX] STALL_STATUS [6] no_trigger_record req=17603
[15:46:04.392] [RX] STALL_STATUS [6] end req=17603
```

### 随后RESET失败和同次启动诊断

来源：`C:\Users\Liu3Beng\.codex\attachments\468d0363-7b54-442a-8b1f-0df0006ca7ca\已粘贴的文本.txt`。按时间范围 15:46:14.000 至 15:46:23.420 选取，共44行。

```text
[15:46:14.563] [TX] !START
[15:46:14.572] [RX] Start pending
[15:46:15.776] [TX] #GET_CMDMODE 2
[15:46:15.777] [RX] Started ok
[15:46:15.786] [RX] ok CMDMODE mode=2 busy=0 issued=2 req=2
[15:46:16.328] [TX] !RESET
[15:46:16.340] [RX] queued RESET id=3 mode=INT
[15:46:16.340] [RX] Reset pending
[15:46:17.462] [RX] error RESET id=3 reason=CANCELLED
[15:46:17.472] [RX] PROTECT J6 failed reason=PROTECTION_STATUS_TIMEOUT
[15:46:17.474] [RX] PROTECT J6 age rx=953 probe=1003 flags=07
[15:46:17.475] [RX] PROTECT J6 queued=475 rx=462 retry=7
[15:46:17.475] [RX] PROTECT CAN alst=11 terr=0 full=0
[15:46:17.526] [RX] STALL J6 phase=6 reason=COMMUNICATION_TIMEOUT
[15:46:17.547] [RX] STALL J6 phase=5 reason=CANCELLED_STOP
[15:46:17.754] [RX] STOP locked
[15:46:23.242] [TX] #CAN_DIAG 6 17603
[15:46:23.249] [RX] ok CAN_DIAG [6] req=17603 pending
[15:46:23.314] [RX] CAN_DIAG [6] req=17603 schema=1 type=M35 dwt=1
[15:46:23.314] [RX] CAN_DIAG [6] req=17603 up=82770 cpu=72000000
[15:46:23.315] [RX] CAN_DIAG [6] req=17603 ctl_max=3345 ctl_gap=1592442
[15:46:23.317] [RX] CAN_DIAG [6] req=17603 ctl_late=1382 pollgap=71708214
[15:46:23.327] [RX] CAN_DIAG [6] req=17603 rx_ovr=512 query_rx=498
[15:46:23.327] [RX] CAN_DIAG [6] req=17603 probe_q=498 merge=0
[15:46:23.328] [RX] CAN_DIAG [6] req=17603 txok=498 alst=1
[15:46:23.329] [RX] CAN_DIAG [6] req=17603 terr=0 full=0
[15:46:23.350] [RX] CAN_DIAG [6] req=17603 age=0 tries=0
[15:46:23.350] [RX] CAN_DIAG [6] req=17603 nonce_rx=50311 nonce_tx=50311
[15:46:23.351] [RX] CAN_DIAG [6] req=17603 last_tx=82680 last_rx=82680
[15:46:23.351] [RX] CAN_DIAG [6] req=17603 depth=0 peak=3 head=00 flags=00
[15:46:23.373] [RX] CAN_DIAG [6] req=17603 head_age=0 boot=65361
[15:46:23.374] [RX] CAN_DIAG [6] req=17603 m_q=511 m_txok=511
[15:46:23.375] [RX] CAN_DIAG [6] req=17603 m_alst=0 m_terr=0
[15:46:23.375] [RX] CAN_DIAG [6] req=17603 m_abort=0 m_rx=498
[15:46:23.395] [RX] CAN_DIAG [6] req=17603 m_match=498 m_reject=0
[15:46:23.396] [RX] CAN_DIAG [6] req=17603 m_sent=50311 m_got=50311 m_txn=50311
[15:46:23.398] [RX] CAN_DIAG [6] req=17603 m_rxage=5 m_pbage=130
[15:46:23.399] [RX] CAN_DIAG [6] req=17603 m_at=84800
[15:46:23.409] [INFO] CAN_SUMMARY J6 req=17603 已确认完整诊断 type=M35 boot=65361 up=82770ms；计数包含查询本身，需比较同次启动的前后读数
[15:46:23.410] [INFO] CAN_SUMMARY J6 req=17603 probe 收到=498 入队=498 合并=0 TXOK=498 过期丢=0 尝试丢=0 队满=0
[15:46:23.410] [INFO] CAN_SUMMARY J6 req=17603 nonce 电机RX/TX=50311/50311 主控sent/got/TXOK=50311/50311/50311 匹配=498 拒绝=0 RX溢出位图=0x00000200
[15:46:23.412] [INFO] CAN_SUMMARY J6 req=17603 控制观测max=46.46us/3345cycles 周期预算=50us/3600cycles 占比=92.9%
[15:46:23.412] [INFO] CAN_SUMMARY J6 req=17603 控制入口gap=22117.25us late=1382 主循环gap=995947.42us；观测值需结合前后计数，不能单独判定 STOP 根因
[15:46:23.414] [RX] CAN_DIAG [6] req=17603 end
```

### J6磁校准及机械校准过程

来源：`C:\Users\Liu3Beng\.codex\attachments\468d0363-7b54-442a-8b1f-0df0006ca7ca\已粘贴的文本.txt`。按时间范围 15:46:56.107 至 15:48:01.155 选取，共54行。

```text
[15:46:56.107] [TX] #ENC_CAL 6
[15:46:56.111] [INFO] 磁编码器校准 CAN 帧已提交；协议没有完成回执，请观察电机校准及重启结果
[15:46:56.169] [RX] ok ENC_CAL [6] dispatched
[15:47:35.436] [TX] !CALIBRATION
[15:47:35.462] [RX] !CALIBRATION pending
[15:47:35.625] [RX] CAL J3 phase=8 reason=NONE
[15:47:35.635] [RX] CAL J4 phase=8 reason=NONE
[15:47:35.656] [RX] CAL J5 phase=8 reason=NONE
[15:47:35.677] [RX] CAL J6 phase=8 reason=NONE
[15:47:35.698] [RX] CAL J7 phase=8 reason=NONE
[15:47:35.719] [RX] CAL J8 phase=8 reason=NONE
[15:47:35.740] [RX] CAL J1 phase=8 reason=NONE
[15:47:35.762] [RX] CAL J2 phase=8 reason=NONE
[15:47:35.844] [RX] CAL J3 phase=13 reason=NONE
[15:47:35.897] [RX] CAL J6 phase=13 reason=NONE
[15:47:35.919] [RX] CAL J1 phase=13 reason=NONE
[15:47:35.939] [RX] CAL J2 phase=13 reason=NONE
[15:47:35.960] [RX] CAL J4 phase=13 reason=NONE
[15:47:35.982] [RX] CAL J5 phase=13 reason=NONE
[15:47:35.982] [RX] CAL WAIT 1000ms
[15:47:36.982] [RX] CAL J7 SEEK
[15:47:36.982] [RX] CAL J8 SEEK
[15:47:37.005] [RX] CAL J7 phase=9 reason=NONE
[15:47:37.026] [RX] CAL J8 phase=9 reason=NONE
[15:47:39.703] [RX] CAL J8 phase=10 reason=NONE
[15:47:40.462] [RX] CAL J8 phase=11 reason=NONE
[15:47:41.741] [RX] CAL J8 phase=12 reason=NONE
[15:47:44.462] [RX] CAL J8 phase=13 reason=NONE
[15:47:44.577] [RX] CAL J7 phase=10 reason=NONE
[15:47:45.803] [RX] CAL J7 phase=11 reason=NONE
[15:47:48.159] [RX] CAL J7 phase=12 reason=NONE
[15:47:59.905] [RX] CAL J7 phase=13 reason=NONE
[15:47:59.905] [RX] CAL DISABLING
[15:48:00.000] [RX] Disabled ok
[15:48:00.001] [RX] CAL SAVING
[15:48:00.104] [RX] CAL J1 phase=16 reason=NONE
[15:48:00.228] [RX] CAL J2 phase=16 reason=NONE
[15:48:00.344] [RX] CAL J3 phase=16 reason=NONE
[15:48:00.467] [RX] CAL J4 phase=16 reason=NONE
[15:48:00.582] [RX] CAL J5 phase=16 reason=NONE
[15:48:00.728] [RX] CAL J6 phase=16 reason=NONE
[15:48:00.843] [RX] CAL J7 phase=16 reason=NONE
[15:48:00.960] [RX] CAL J8 phase=16 reason=NONE
[15:48:00.981] [RX] CAL J3 phase=0 reason=NONE
[15:48:01.001] [RX] CAL J4 phase=0 reason=NONE
[15:48:01.024] [RX] CAL J5 phase=0 reason=NONE
[15:48:01.045] [RX] CAL J6 phase=0 reason=NONE
[15:48:01.067] [RX] CAL J7 phase=0 reason=NONE
[15:48:01.086] [RX] CAL J8 phase=0 reason=NONE
[15:48:01.107] [RX] CAL J1 phase=0 reason=NONE
[15:48:01.129] [RX] CAL J2 phase=0 reason=NONE
[15:48:01.130] [INFO] 校准、八轴失能与 EEPROM 保存完成；再次 START 将保持当前位置
[15:48:01.154] [RX] !CALIBRATION ok
[15:48:01.155] [RX] Disabled ok
```

### 机械校准后再次MoveJ失败及J6诊断

来源：`C:\Users\Liu3Beng\.codex\attachments\468d0363-7b54-442a-8b1f-0df0006ca7ca\已粘贴的文本.txt`。按时间范围 15:49:02.073 至 15:49:19.476 选取，共48行。

```text
[15:49:02.073] [TX] !START
[15:49:02.079] [RX] Start pending
[15:49:03.328] [TX] #GET_CMDMODE 3
[15:49:03.329] [RX] Started ok
[15:49:03.338] [RX] ok CMDMODE mode=2 busy=0 issued=3 req=3
[15:49:03.895] [TX] !HOME
[15:49:03.901] [RX] queued HOME id=4 mode=INT
[15:49:03.901] [RX] Home pending
[15:49:08.316] [RX] ok HOME id=4 ms=4413
[15:49:13.531] [INFO] 已存储: #2 [-90.0,0.0,0.0,-90.0,-90.0,-90.0,-90.0]
[15:49:15.901] [TX] >90,0,90,90,90,90,90,35
[15:49:15.906] [RX] queued MOVEJ id=5 mode=INT
[15:49:15.906] [RX] accepted MOVEJ id=5
[15:49:17.000] [RX] PROTECT J6 failed reason=PROTECTION_STATUS_TIMEOUT
[15:49:17.000] [RX] PROTECT J6 age rx=902 probe=1005 flags=03
[15:49:17.001] [RX] PROTECT J6 queued=1432 rx=1395 retry=21
[15:49:17.002] [RX] PROTECT CAN alst=58 terr=0 full=0
[15:49:17.095] [RX] STALL J6 phase=6 reason=COMMUNICATION_TIMEOUT
[15:49:17.137] [RX] STALL J6 phase=5 reason=CANCELLED_STOP
[15:49:17.468] [RX] STOP locked
[15:49:19.289] [TX] #CAN_DIAG 6 17604
[15:49:19.291] [RX] ok CAN_DIAG [6] req=17604 pending
[15:49:19.375] [RX] CAN_DIAG [6] req=17604 schema=1 type=M35 dwt=1
[15:49:19.375] [RX] CAN_DIAG [6] req=17604 up=132737 cpu=72000000
[15:49:19.376] [RX] CAN_DIAG [6] req=17604 ctl_max=3372 ctl_gap=1593429
[15:49:19.377] [RX] CAN_DIAG [6] req=17604 ctl_late=1101 pollgap=69695658
[15:49:19.399] [RX] CAN_DIAG [6] req=17604 rx_ovr=512 query_rx=666
[15:49:19.400] [RX] CAN_DIAG [6] req=17604 probe_q=666 merge=0
[15:49:19.400] [RX] CAN_DIAG [6] req=17604 txok=666 alst=1
[15:49:19.403] [RX] CAN_DIAG [6] req=17604 terr=0 full=0
[15:49:19.413] [RX] CAN_DIAG [6] req=17604 age=0 tries=0
[15:49:19.414] [RX] CAN_DIAG [6] req=17604 nonce_rx=57764 nonce_tx=57764
[15:49:19.415] [RX] CAN_DIAG [6] req=17604 last_tx=132728 last_rx=132727
[15:49:19.416] [RX] CAN_DIAG [6] req=17604 depth=0 peak=3 head=00 flags=00
[15:49:19.435] [RX] CAN_DIAG [6] req=17604 head_age=0 boot=65362
[15:49:19.435] [RX] CAN_DIAG [6] req=17604 m_q=1447 m_txok=1443
[15:49:19.436] [RX] CAN_DIAG [6] req=17604 m_alst=4 m_terr=0
[15:49:19.438] [RX] CAN_DIAG [6] req=17604 m_abort=0 m_rx=1410
[15:49:19.457] [RX] CAN_DIAG [6] req=17604 m_match=1410 m_reject=0
[15:49:19.458] [RX] CAN_DIAG [6] req=17604 m_sent=57764 m_got=57764 m_txn=57764
[15:49:19.458] [RX] CAN_DIAG [6] req=17604 m_rxage=50 m_pbage=50
[15:49:19.461] [RX] CAN_DIAG [6] req=17604 m_at=260840
[15:49:19.469] [INFO] CAN_SUMMARY J6 req=17604 已确认完整诊断 type=M35 boot=65362 up=132737ms；计数包含查询本身，需比较同次启动的前后读数
[15:49:19.470] [INFO] CAN_SUMMARY J6 req=17604 probe 收到=666 入队=666 合并=0 TXOK=666 过期丢=0 尝试丢=0 队满=0
[15:49:19.470] [INFO] CAN_SUMMARY J6 req=17604 nonce 电机RX/TX=57764/57764 主控sent/got/TXOK=57764/57764/57764 匹配=1410 拒绝=0 RX溢出位图=0x00000200
[15:49:19.473] [INFO] CAN_SUMMARY J6 req=17604 控制观测max=46.83us/3372cycles 周期预算=50us/3600cycles 占比=93.7%
[15:49:19.474] [INFO] CAN_SUMMARY J6 req=17604 控制入口gap=22130.96us late=1101 主循环gap=967995.25us；观测值需结合前后计数，不能单独判定 STOP 根因
[15:49:19.476] [RX] CAN_DIAG [6] req=17604 end
```

### 第三次失败后J6 LAST和LIVE

来源：`C:\Users\Liu3Beng\.codex\attachments\468d0363-7b54-442a-8b1f-0df0006ca7ca\已粘贴的文本.txt`。按时间范围 15:49:25.113 至 15:49:25.753 选取，共27行。

```text
[15:49:25.113] [TX] #STALL_STATUS 6 LAST
[15:49:25.118] [RX] ok STALL_STATUS [6] pending
[15:49:25.170] [RX] STALL_STATUS [6] no_trigger_record req=17606
[15:49:25.172] [RX] STALL_STATUS [6] end req=17606
[15:49:25.592] [TX] #STALL_STATUS 6
[15:49:25.595] [RX] ok STALL_STATUS [6] pending
[15:49:25.658] [RX] STALL_STATUS [6] req=17607 session=1 at_ms=139018
[15:49:25.658] [RX] STALL_STATUS [6] mode=1 reqmode=1 phase=5 gate=PROTECTED
[15:49:25.659] [RX] STALL_STATUS [6] intent=0 fb=1 enabled=1 detect=1
[15:49:25.659] [RX] STALL_STATUS [6] unmet=0 stop_lock=1
[15:49:25.670] [RX] STALL_STATUS [6] I_cmd=-0.267 I_filt=0 I_thr=1.5 A
[15:49:25.670] [RX] STALL_STATUS [6] v_raw=-0.0250195 r/s
[15:49:25.671] [RX] STALL_STATUS [6] v_filt=0 v_thr=0.02 r/s
[15:49:25.671] [RX] STALL_STATUS [6] err=5.85937e-05 err_thr=0.0416602 r
[15:49:25.693] [RX] STALL_STATUS [6] timer_ms=0 need_ms=300
[15:49:25.694] [RX] STALL_STATUS [6] peak_ms=0
[15:49:25.696] [RX] STALL_STATUS [6] clear=NONE detail=0
[15:49:25.699] [RX] STALL_STATUS [6] last_ms=0
[15:49:25.717] [RX] STALL_STATUS [6] bad_total=0
[15:49:25.717] [RX] STALL_STATUS [6] bad_run_peak_ms=0
[15:49:25.718] [RX] STALL_STATUS [6] startup_left_ms=0
[15:49:25.720] [RX] STALL_STATUS [6] record=LIVE event=00000000
[15:49:25.730] [RX] STALL_STATUS [6] v_ref=0 r/s
[15:49:25.731] [RX] STALL_STATUS [6] goal_err=5.85937e-05 r
[15:49:25.732] [RX] STALL_STATUS [6] dir=0 stall_dir=-1
[15:49:25.733] [RX] STALL_STATUS [6] trigger_reason=NONE
[15:49:25.753] [RX] STALL_STATUS [6] end req=17607
```

## 给新对话的读取顺序

先读本文件和最新完整468d日志，再读15:31关闭检测对照。确认同一原始测试的b505与468d前半段没有被重复统计为四次失败。随后读独立调查文档、.03 manifest、当前源码和近期diff，必要时再核对11:01及11:37完整日志。

先区分直接保护入口与根因；重新验证DWT范围、HAL时基、CAN实际收发和普通检测开关的执行路径。可以推翻既有推断，但须给出日志时刻及代码依据。若发现新的修改方向，先列文件、作用、风险及验证范围，等待用户确认。本交接没有承诺继续执行.04。

可复制提示词位于同目录 `固件STOP异常_新对话提示词_20261010.txt`。
