Liu3Beng-A/Dummy/docs/固件版本查询与同步烧录_20261010.md

# 固件版本查询与同步烧录（2026-10-10）

当前交付 `20261010.03`：在已有九板版本查询和 CAN_DIAG 诊断基础上，修正 STOP/CAL 期间的精确 `#MOTION_STATUS` 查询门禁，关闭电机 ADC DMA 无业务用途的半传输/完成中断通知。已同步 `串口助手_old.py`，主控和四种电机完成同批构建。运动、校准、STOP/START、堵转判断、CAN重试及Flash布局保持原逻辑；没有操作设备、重写EEPROM、烧录或提交Git。HOME是否恢复正常仍需下述实机测试。

## 20261010.03：本次修改与交付

用户“执行，执行完告诉我怎么测试”确认后，实施此前明确列出的三个源码文件及本文更新：

| 文件 | 修改及作用 |
|---|---|
| `串口助手_old.py` | 在入队与写线程共用的只读白名单增加精确 `#MOTION_STATUS`，STOP/CAL下无需先失能即可发送 |
| `firmware_new/dummy-ref-core-fw/UserApp/protocols/ascii_protocol.cpp` | 在STOP/CAL锁判定前处理精确查询，USB/UART4入口均有效；其它指令仍按原门禁处理 |
| `firmware_new/dummy-motor-fw/Core/Src/adc.c` | 仅在 `HAL_ADC_Start_DMA` 成功后关闭 `DMA_IT_HT | DMA_IT_TC`；ADC连续采样、两通道、DMA circular内存更新及TE错误通知保留 |

此前HOME直接触发的是 `PROTECTION_STATUS_TIMEOUT`，随后部分电机发生 `COMMUNICATION_TIMEOUT`，并无普通STALL触发记录，所以不会执行堵转回退。`.02`已测到J2/J3主循环发送轮询最大间隔接近971/976ms，电机HAL毫秒进展也落后相近幅度。ADC空回调通知每秒约4.76万次，与20kHz控制同为最高优先级，是已核实的额外中断负担。本次先移除这项负担，未放宽保护超时或堵转阈值；仍不能仅凭离线构建断言它解释了全部实机延迟。

### 同批身份与文件

- 版本：`20261010.03`
- 批次：`F08D62A917C34EB5`
- UTC时间：`2026-10-10T03:15:24+00:00`（北京时间11:15:24）
- 共同生产输入SHA256：`a995daf385ad410e5053db105abfbf3b1128aaf39e48e5185e9bfac9d7836582`，486个输入
- 冻结目录：[20261010_03_F08D62A917C34EB5](../build/firmware_release/20261010_03_F08D62A917C34EB5/)
- 烧录说明：[烧录说明.txt](../build/firmware_release/20261010_03_F08D62A917C34EB5/烧录说明.txt)
- 文件摘要：[manifest.json](../build/firmware_release/20261010_03_F08D62A917C34EB5/manifest.json)

| 板卡 | BIN文件 | 长度/精确读回长度 | 电机应用区余量 |
|---|---|---|---:|
| 主控 | Core-STM32F4-fw.bin | 453724 B / 0x6EC5C | — |
| J1～J3，M42 | motor-42.bin | 96476 B / 0x178DC | 804 B |
| J4～J6，M35 | motor-35.bin | 96476 B / 0x178DC | 804 B |
| J7，M57 | motor-57.bin | 96460 B / 0x178CC | 820 B |
| J8，GRIPPER | motor-gripper.bin | 96420 B / 0x178A4 | 860 B |

主控与八块电机板全部更新同批BIN，起始地址均为 `0x08000000`。主控只擦sector0～7，电机只擦page0～94；之后Program & Verify选择BIN、Skip Flash erase及Verify after programming。保留电机编码器表/参数页与主控RGB配置，不全片擦除、不恢复默认、不重写EEPROM。完成九板后断开ST-LINK，再正常上电。详细保留区及只读核验见本文烧录章节。

### 测试流程：先保持检测启用

1. 关闭旧助手，运行更新后的根目录 `串口助手_old.py`，开启完整日志。供电保持已验证的10A输出限流设置。烧录后先用“整组版本查询”核对九板：均为 `.03`、上述批次/时间/摘要，板型按上表。手动查询则按 `#FW_VERSION 0` 到 `#FW_VERSION 8` 逐条发送；0是主控，不能只查0判断九板一致。
2. 建立可信坐标。按此前成功的流程，在J1～J6真实处于REST姿态 `{0,-75,180,0,0,0}` 时执行机械校准，等 `!CALIBRATION ok`。烧录重启后不能直接沿用旧RAM多圈原点，也不要在任意姿态把当前位置标成REST。地轨和夹爪校准应正常退让、复触和返回。
3. 仅RAM启用普通堵转检测，不SAVE、不恢复默认。逐条发送，上一条成功后再发下一条；ENABLE需等七轴确认，START需等成功回执：

```text
!DISABLE
#STALL_SET 0 ENABLE 1
!START
```

4. 从有实际位移的REST起点读取基线，每条等 `end`，然后执行HOME。运动中不连续轮询诊断：

```text
#CAN_DIAG 2
#CAN_DIAG 3
!HOME
```

5. 不论HOME成功或STOP，都尽快逐条读取下面完整记录。每条等 `end` 或明确错误再发下一条。若先报其他轴的错误，优先查该轴的CAN_DIAG与LAST，再补J2/J3。**STOP期间现在直接查MOTION，无需先DISABLE**；取证完成前不要START、失能、复位、重校准或改参数。

```text
#CAN_DIAG 2
#CAN_DIAG 3
#STALL_STATUS 2 LAST
#STALL_STATUS 3 LAST
#STALL_STATUS 2
#STALL_STATUS 3
#MOTION_STATUS
```

6. 若HOME成功，在运动完成后可额外发送 `!STOP`，等STOP确认，再发送精确 `#MOTION_STATUS`，验证助手确有TX且主控返回状态，随后才 `!DISABLE`。查询不要附加参数或后缀。若HOME已自行STOP，第5步已覆盖此检查。
7. 第一轮成功后，用此前成功的方式回到相同REST起点，启用检测再重复2～3次有实际位移的HOME。已经到HOME时再次零位移HOME不能证明负载运动正常。若再次失败，先保存第5步证据，暂停重复运动；把从连接、版本、校准、START到结束查询的完整日志发回，并注明实际运动/停机情况及任何断电复位时刻。

### 如何判断

- 功能通过：启用检测时真实HOME完成，未再出现 `PROTECTION_STATUS_TIMEOUT` / `COMMUNICATION_TIMEOUT`；STOP中MOTION查询产生TX并正常回包。
- 时序改善：同次启动的前后 `pollgap` 不再新增接近一秒的最大间隔，`m_at-up` 的差值增长不再接近一秒。两芯片起始计时有偏移，应比较同板前后差值，不要求绝对差等于零。
- `ctl_late`看前后增量；`rx_ovr`是累计位图，不是次数。若基线已有0x200且结束仍为0x200，不能声称本轮新溢出，也不能证明没有再溢出。
- `ctl_max`只量控制函数观测区域。移除其它ADC中断后，它仍可能接近原46μs，不能要求该值明显下降才算改善，也不能只凭它小于50μs认定完整CPU预算健康。
- 若仍为通信超时且LAST无触发记录，继续沿CAN接收/前台调度证据定位。若出现真实STALL及LAST快照，再依据电流、速度、误差和持续时间讨论阈值及回退。

验证：主控实际命令/诊断源码抽取1652项（含旧版本协议339项）、助手隐藏Tk与入队/写线程门禁507项、ADC/DMA初始化及HAL错误处理143项通过；未改变的主控TX512项、电机CAN148项、四板型选择器/旧STALL/CAL各21313项回归记录已重新核对被测源码摘要。两个工程Release/Ninja构建成功，五个BIN内身份均匹配，HEX记录校验和及覆盖字节与BIN一致，未占保留区。生产输入在构建前后摘要一致。

新的ADC硬件采样及HOME效果尚未在实物上验证；原链接器的RWX段警告仍存在，本次未改链接布局。最终测试结果归档在本批包的 `tests/` 和 `manifest.json`。两个旧批次冻结包保留原样，以下 `.02/.01` 章节属于历史记录。

## 后续实机证据与当前状态（2026-10-10）

### 最新15:45～15:49：J6拆装、磁编码器校准及机械校准后仍通信超时

用户确认“重新安装”指拆装电机／驱动板，并非重新烧录。完整日志 `468d0363-7b54-442a-8b1f-0df0006ca7ca/已粘贴的文本.txt` 先启用并保存七轴普通检测，START后HOME成功4356ms，随后的MoveJ及RESET分别在15:45:56.757、15:46:17.472因J6 PROTECTION_STATUS_TIMEOUT停止。两次匹配探测回复年龄1002/1003ms，随后J6报告COMMUNICATION_TIMEOUT及CANCELLED_STOP；LAST均no_trigger_record。RESET在此处为回REST运动，不是MCU复位。

| J6同次启动诊断 | START后运动前 | MoveJ失败后 | RESET失败后 |
|---|---:|---:|---:|
| boot | 65361 | 65361 | 65361 |
| up / m_at，ms | 43178 / 43240 | 61418 / 62480 | 82770 / 84800 |
| m_at减up，ms | 62 | 1062 | 2030 |
| ctl_max，us | 42.625 | 46.458 | 46.458 |
| ctl_late | 812 | 1316 | 1382 |
| pollgap，ms | 100.339 | 995.947 | 995.947 |
| 电机query/probe/TXOK及主控匹配 | 256 | 369 | 498 |
| 主控TXOK | 256 | 376 | 511 |

boot及累计计数连续；主控与电机HAL时基差先增加1000ms，再增加968ms，和约996ms的DWT发送轮询间隔相符。控制入口最大间隔仍为原约22ms，未出现一秒入口间隔。这支持运动期间电机前台、CAN及SysTick服务受阻，而控制中断继续执行；不支持把这两次异常直接解释为整板重启。约22ms入口峰值和100ms轮询峰值在运动前已存在，不能指定为MoveJ新增。STALL_SAVE在运动前约31秒已完成，代码在saved回复前清除待保存标志，无证据为运动中延迟保存造成停顿。

电机合并、队满、过期丢、尝试丢及主控编号拒收均为0。主控TXOK与电机QUERY_RX累计差由0增至7、13，值得查接收执行机会和FIFO；两芯片快照不同步，不能严格说恰好丢7/13帧，TXOK也不证明目标J6已经接收。rx_ovr=512是早已置位的黏滞位图，其不变不能排除新增同类溢出。本轮实际J6加速度30r/s²，仍发生旧a200条件下的同类超时，故高加速度并非必要触发条件。15:31检测关闭对照的基线是在失能状态采集，不能将其28.07us与本轮START后42.625us的差直接当普通检测纯增量。

后半段15:46:56执行ENC_CAL6，15:47:35开始机械校准，15:48:01完整成功并保存。随后START和HOME成功4413ms；15:49:15.901相同MoveJ再次在15:49:17.000报J6 PROTECTION_STATUS_TIMEOUT（probe1005ms、rx902ms），随后COMMUNICATION_TIMEOUT、CANCELLED_STOP。J6 LAST仍无触发记录，LIVE的bad_total、peak_ms、event均为0，trigger_reason=NONE。结束诊断ctl_max46.833us、pollgap967.995ms，说明重新校准未消除这一运行时问题。

此时boot65361变为65362；`Ctrl/Sensor/Encoder/encoder_calibrator_base.cpp:381–382`在ENC_CAL成功后本就调用HAL_NVIC_SystemReset，且电机uptime减少符合该前置操作。不能把这次boot变化宣称为第三次MoveJ中的自发重启，也不能跨该复位用主控／电机累计计数相减。前两次flags07、机械校准后flags03的变化也符合清除ASSUMED_BOOT。

当前源码与实际motor-35 ELF已确认正常编码器样本在`Ctrl/Motor/motor.cpp:89–90`调用软件64位除法。候选最小优化是在transportMissingTicks为0时使用等价32位有符号除法，再扩为64位并加64；缺帧时保留原64位乘除补偿及有效性／累计规则。每tick读取动态速度上限，不在启动时缓存，不改保护阈值、时限、控制频率或制动公式。该候选尚未获新文件范围确认，未修改motor.cpp、未生成新批次。

现有DWT观测包括编码器SPI及整条motor.Tick20kHz，但不包含硬件异常入出栈和观测结束后的统计／函数尾部。TIM4_IRQHandler实际为直接跳转，通用HAL_TIM_IRQHandler不可达；当前`.03`产物已关闭ADC HT/TC，不能继续用旧约47.6kHz空DMA中断解释当前源码。46.46～46.83us并非完整ISR占用，单项最大值也不是平均CPU占用；尚需优化后的同条件对照，必要时再独立测完整时序。最新日志未查询九板版本，当前板上身份仍须在下一轮确认。

本阶段仅同步此前已授权的本调查文档，没有新增固件／助手修改、构建或设备操作；冻结`.03`包和另一聊天的SESSION_STATUS均未改动。下一步不重复恢复默认或全片擦除，先确认最小等价优化范围，再同批交付与复测。

### 最新15:31～15:33：J6检测关闭时未再报告通信超时

用户日志 `694b706b-07f3-4308-b7f9-61060cfdc756/已粘贴的文本.txt`：HOME明确完成4391ms，六次MoveJ均接受，最终RESET明确完成6238ms，期间没有PROTECTION_STATUS_TIMEOUT、COMMUNICATION_TIMEOUT或STOP。INT模式的accepted MOVEJ只表示接受计划，不能单凭这些回包判定六次都到位。

关键前提：START前J6为gate=SWITCH_OFF、detect=0、enabled=0，随后没有STALL_SET开启。START只使能驱动、更新坐标边界和方向profile，不修改原ENABLE；SYNC_ACC只查询加速度并更新主控缓存，也不会开启检测。因此本轮是J6普通检测关闭时的成功对照，不能据此宣布开启检测条件下已修复。电机通信看门狗及主控通信保护不依赖普通检测ENABLE，故本轮仍有通信保护在运行。

CAN_DIAG6仅在START前采集，up22079ms、m_at22119ms，ctl_max28.07us、ctl_late0、pollgap99.64us、rx_ovr0；电机query/probe/TXOK及主控match均133，merge/full/age/tries/reject均0。这证明失能基线正常，不能代表运动期间耗时。日志没有九板身份查询、启用检测反向对照或运动结束后的J6诊断。下一步在可信且相同起始姿态，仅RAM执行STALL_SET0 ENABLE1并确认J6 detect1，再START，读取J6基线、重复相同运动并读取J6结束/故障快照，不SAVE、不恢复默认或重刷。没有新增源码修改。

### 最新11:37～11:40：HOME通过，J6运动仍发生通信超时

用户日志 `4cb21b55-50c7-4a6a-9116-cd90d9b0e07d/已粘贴的文本.txt`：校准完整成功，11:38:49.844 HOME开始，4377ms后成功。J2/J3在HOME、后续MoveJ和RESET前后，累计pollgap均保持约82.812/83.189ms，主控m_at减电机up的差约57～60ms，没有再增加旧日志中的约一秒滞后。HOME前已存在的ctl_gap约22ms/pollgap约83ms不是本轮HOME新增停顿；此前已经进行CAL保存，不能仅凭累计峰值定位发生阶段。ctl_late仍增长，故不能宣布全部控制时序问题已解决。

两次后续失败均是J6：MoveJ在11:39:29.053报PROTECTION_STATUS_TIMEOUT（probe1001ms、rx965ms）；RESET在11:39:58.958报同类错误（probe1003ms、rx894ms）。随后J6均报告COMMUNICATION_TIMEOUT及CANCELLED_STOP。主控HealthFault调用普通STOP，电机通信看门狗也以非本地STALL方式停止；日志统一的STALL事件前缀不等于普通堵转触发，因此此路径不执行堵转回退。RESET在此处是回REST的运动命令，不是MCU复位。

重要覆盖差别：成功HOME中的J6规划位移d=0、速度v=0；MoveJ才让J6走7.5电机圈，RESET随后让J6走4.3398圈，两次都失败。因此HOME通过不能证明J6负载运动正常。MOTION记录支持J6目标曾送达并被接受，合格运动回复在任务开始约0.2～0.25s后停止更新。real坐标缓存和f/age来自不同更新路径，不能拿较晚打印的real作为该回复停止时刻的实测坐标。

本轮只查询了J1～J3的CAN_DIAG和STALL，没有J6，也没有九板版本查询。不能凭健康节点排除J6运行停滞、重启或固件批次不匹配。两次STOP内MOTION_STATUS均TX并正常返回，查询门禁修复已获得用户实测证据。

下一步先只读取：九板整组版本，及 `#CAN_DIAG 6`、`#STALL_STATUS 6 LAST`、`#STALL_STATUS 6`。如果当前仍是同次启动，末尾失能不清除CAN_DIAG累计峰值，这些读数仍有价值；不要为此恢复默认或全片擦除。后续需要运动复测时，必须在相同起点取J6基线，并在STOP后优先读取J6，再补其它节点。本次仅同步调查文档，没有新增固件/助手修改，没有改动已冻结交付包。

### 最新 11:01：HOME 已复现，低优先级执行明显停滞

日志 `e30b106c-608f-4fbe-b7e3-467e6eb6e0d7/已粘贴的文本.txt`：11:01:19 START成功；11:01:29.942 HOME；约1063ms后取消，主控J2 `PROTECTION_STATUS_TIMEOUT`（probe1002ms、rx889ms），随后J1～J5出现 `COMMUNICATION_TIMEOUT`。J2/J3 LAST均无STALL触发记录。直接STOP原因依然是保护通信超时，不是普通堵转阈值触发，因此没有堵转回退。

| 观测 | J2：START后基线→HOME失败后 | J3：START后基线→HOME失败后 |
|---|---|---|
| 控制函数观测最大耗时 | 2977→3345周期（41.35→46.46μs） | 2962→3337周期（41.14→46.35μs） |
| ctl_late | 48→486（新增438） | 19→267（新增248） |
| 主循环发送轮询最大间隔 | 53002→69904673周期（0.736→970.898ms） | 50757→70285542周期（0.705→976.188ms） |
| RX FIFO溢出位图 | 0→0 | 0→512（新增FIFO0溢出证据，不是512次） |
| PROBE合并/队满/年龄丢弃/尝试耗尽 | 均0→0 | 均0→0 |
| 主控编号拒收 | 0→0 | 0→0 |
| 控制入口最大间隔 | 4832周期，仍67.11μs | 4840周期，仍67.22μs |

同时比较同板主控 `m_at` 与电机 `up`：J2差从30ms增至1001ms，新增971ms；J3差从31ms增至1008ms，新增977ms，几乎与DWT轮询大间隔一致。两次查询到首行均约70ms，不是诊断收集多等了一秒；源码的DWT读数使用32位无符号减法，正常跨回绕不会虚增一秒。这强烈支持运动期间电机前台/CAN/SysTick的进展被持续压制。控制入口仍连续，区别于整板停住或一次一秒长的控制ISR。观察不是完整ISR WCET，不能用46μs小于50μs排除其它高优先级中断与进入退出开销共同耗尽余量。

本日志没有SAVE、默认恢复或磁编码器校准；正常HOME/START未发现会触发长时间Flash写入的路径。主控TXOK累计比电机QUERY_RX多6，但两芯片快照不同步，不能严格解释为正好丢6帧。已获得J3 RX FIFO0溢出实证，但尚不能唯一认定ADC、TIM4完整开销或连续CAN ISR哪项造成全部延迟。此轮应优先处理执行预算与接收处理延迟，不先改堵转阈值或1000ms保护时限。

已核实一个不承担业务处理的高频中断来源：电机 `Core/Src/adc.c` 配置ADC连续两通道、DMA circular长度2，ADC时钟12MHz、每转换252周期，HT/TC硬件通知机会合计约47.62k/s。DMA1_Channel1与TIM4都priority0，CAN/SysTick为3。半/全回调只有HAL weak空业务函数；应用仅直接读取DMA数组取温度，没有依赖这些回调或HAL_ADC_GetState的控制路径。该项现已在用户确认后的`.03`实施最小修改，实际改善仍待实机复测。

### STOP期间 MOTION_STATUS 被拦截：已确认两层原因

用户在11:01:40、11:01:49、11:02:13收到助手WARN，未产生TX；11:02:18 DISABLE后才成功查询。这是助手的只读白名单缺 `#MOTION_STATUS`，且主控也在处理该命令之前先返回STOP_LOCKED。助手 `串口助手_old.py:1975` 的同一白名单用于send_cmd入队和写线程；主控 `ascii_protocol.cpp:207` 的锁判定先于 `HandleMotionCommand:227`，USB/UART均按此顺序。仅改助手仍会被主控拒绝。

此前测试流程遗漏了这项现有门禁。此轮CAN_DIAG与STALL查询均发生在DISABLE之前，关键数据已保留；后来读取的MOTION仍能显示被取消任务的1063ms记录，但它的age已经增加、控制现场也已失能，不能当即时现场。`.03`现已修正两层门禁，后续STOP中直接读取MOTION。

用户已确认这三个文件和本文的修改及同批构建，结果见顶部`.03`交付章节。MOTION查询只复制/打印缓存，不发CAN、不发运动指令或写Flash；没有扩大到所有GET指令。原`.02`冻结包和其归档文档保持原样。

### 最新 10:56～10:57：诊断版已烧录，尚只有失能基线

用户新日志 `2651552d-55b3-4f6c-aa44-fd4f1cfc6c8c/已粘贴的文本.txt` 已确认九板均为 `20261010.02 / AE3091CF257B46DA`，时间、生产摘要和板型匹配。七轴仅 RAM 设置 ENABLE=1，随后查询 J1/J2/J3 的 CAN_DIAG 与 J2/J3 STALL。该日志没有 START、HOME、MoveJ 或 STOP 事件；J2/J3 明确 `gate=DISABLED、enabled=0、session=0、detect=1`，最后 MOTION 为 id0、send0、plan0、moving0。因此这份记录是失能基线，不能作为运动成功/失败或已修复证据。

J2 电机 QUERY RX/PROBE入队/TXOK 均为 366，主控匹配 366、拒收 0；主控入邮箱 367、TXOK366、ALST1。J3 相应电机计数和主控匹配均为393、拒收0，主控入邮箱396、TXOK393、ALST3；电机另有 ALST1 但重试送出成功。两个节点 merge/full/age/tries 都是0，ctl_late都是0。控制观测最大耗时 J2为2081周期（28.90μs）、J3为2080周期（28.89μs）；这是失能路径的观测，不是运动时最大耗时或全部CPU占用。控制入口最大间隔约67μs仍体现调度延迟，不能因为ctl_late=0认定所有20kHz入口严格准时。

J1的 `rx_ovr=512=0x200` 表示该板本次启动后曾出现 RX FIFO0 溢出；它是累计位图，不代表512次或512帧。无发生时刻、没有HOME复现，不能将其指定为此前J2的STOP根因。新日志没有提示再次恢复EEPROM或全片擦除的必要。

下一步保留完整日志：建立可信原点，从REST起点 START成功后重新读取J2/J3 CAN_DIAG基线，执行有实际位移的HOME，再立即读取两节点诊断以及LAST/LIVE/MOTION；具体顺序见本文诊断版测试章节。旧失能基线可用于同次启动比较，但新增START后基线更能区分准备阶段和运动阶段计数。

用户发现电源最大输出限流被设为 1A，改为 10A 后此前校准异常不再出现。09:58:52～09:59:19 日志确认 J7/J8 均完成 SEEK/BACKOFF/RETOUCH/RETURN/DONE，随后八轴失能、保存并返回 `!CALIBRATION ok`。电源限流是此前校准失败的重要原因；限流引起电压下降、使电机重新初始化，是与旧日志相符的机制推断，尚未测板端电压或读取 RCC 复位原因。10A 是电源允许的最大输出，不代表每个电机被强制输入 10A。

此前 09:48 整组查询已确认九板身份一致：版本 `20261010.01`、批次 `C4D78A5E8C046679`、时间和源码摘要均匹配；J1～J3 为 M42，J4～J6 为 M35，J7 为 M57，J8 为 GRIPPER。烧录与测试由用户执行。本聊天未连接设备。

HOME 仍有另一项未解决问题：09:59:47.591 和 10:00:53.516 均为 `PROTECT J2 failed reason=PROTECTION_STATUS_TIMEOUT`，匹配保护探测回复已过期 1004ms；任意保护帧接收年龄分别为 903ms、787ms。随后电机报告 J2 或 J3 的 `COMMUNICATION_TIMEOUT`，再出现 `CANCELLED_STOP`。这两轮直接停机入口是通信保护，不是电流/速度/误差/持续时间条件触发的 `STALL`，因此普通 STOP 不进行堵转回退。第一轮只查询了 J1 的 LAST，不能用 J1 无记录证明 J2 的检测状态。

10:01:43 用户执行 `#STALL_SET 0 ENABLE 0`，随后 `#STALL_SAVE 0`；七轴均确认。10:01:56 HOME 成功（4362ms），之后多轮 MoveJ 和 RESET 也成功，用户确认电机运动正常。源码显示主控 `Health()` 不读取检测 ENABLE；电机通信看门狗位于 ENABLE 门禁之前。因此关闭检测没有直接屏蔽这两个通信保护。该对照支持检测启用时的执行路径、运算预算或共享状态影响通信，但同时进行了参数提交和保存，还需仅切换 RAM ENABLE 的反向对照，不能宣布具体软件根因已确定。

只读核对当前 motor-42 ELF：普通检测的两次 Filter 使用 Cortex-M3 硬件 32 位 SDIV；`IsOrdinaryPositionArrival(false)` 为整数比较，没有额外 64 位除法或软件浮点调用。TIM4 20kHz 与 ADC DMA 中断优先级为 0，CAN 中断为 3，电机发送队列在主循环处理，存在负荷影响通信的可能；尚未测量 ISR 耗时、CAN 延迟或电机端 FIFO 溢出，不能用静态指令数证明超时。

当前无需全片擦除或重复恢复 EEPROM，也没有授权或实施控制/保护逻辑修复。普通堵转检测已被用户保存为关闭；这个状态用于故障对照，不能作为保护功能已修复的验收结果。

下一轮针对 HOME 的最小对照：保持同一供电、起始姿态和速度，从 REST 到 HOME 有实际位移；失能状态仅 RAM 设置 `#STALL_SET 0 ENABLE 1`，等七轴确认，不执行 SAVE，再 START/HOME。失败后在 START、DISABLE 或断电前，逐条读取报错轴及通信超时轴的 `#STALL_STATUS <node> LAST` 和 LIVE，再读取 `#MOTION_STATUS`。之后仅 RAM 关闭检测，在相同起始姿态重复。不能在已经到 HOME 时发送零位移 HOME，当作启用检测的复测。真实 STALL 才产生 LAST 触发快照，通信超时可能没有该记录。

### 10:14 反向对照已完成

新日志 `6fabf87a-c054-47f0-ba20-64e13eb2073b/已粘贴的文本.txt`：10:14:41 仅 RAM 重新启用七轴检测，没有 SAVE；10:14:56.978 HOME，约 1523ms 后取消，主控报 J2 `PROTECTION_STATUS_TIMEOUT`。报错时 `rx=120ms`、`probe=1001ms`、`flags=07`，本轮没有电机 `COMMUNICATION_TIMEOUT` 事件。因此 SAVE 不是复现必要条件；J2 近期仍有通信，但保护请求的匹配证明没有刷新，不能将本轮等同于电机整板失联。

J2/J3 的 LAST 均为 `no_trigger_record`；LIVE 均 `peak_ms=0`、`bad_total=0`、`trigger_reason=NONE`。这是通信保护停机，而非普通 STALL 触发。STOP 后的 LIVE 是事后快照，滤波值在门禁关闭后可以保留，不能把这些值视为报错瞬间的完整轨迹。10:15:31 再次九板版本查询全部一致。`flags=07` 含 ASSUMED_BOOT，但 START 可以保留该标志而绑定有效 profile，这个单独读数不能证明故障瞬间复位。较晚查询的 MOTION 数据是已取消任务的记录，不是当前实时位置。

只读新增候选：电机 `Core/Src/can.c` 合并新的 PROBE_REPLY（0x36）时只替换负载，不更新原创建时间及重试预算；发送轮询仍按原 100ms/16次预算丢弃。新回复可能继承旧帧的过期时间；PROBE 和带编号的位置回复共用有限队列，队满也没有对外丢弃统计。这些行为已在代码核实，但尚无实机计数证明本次触发了该路径，不能直接宣称为唯一根因。

针对这项证据，用户已回复“可以”，确认以下文件范围的小型只读诊断：逐段记录主控 QUERY 实际发送、板端 QUERY 收到、PROBE 入队/合并/丢弃/实际发送、主控收到/编号拒收，并测控制回调耗时。随后完成实现、离线测试与同批构建；尚未实机复测。电机应用区仍为 95KiB，没有占用编码器表或参数区。

本轮已确认并实施的文件范围如下：

| 模块 | 文件 | 拟修改内容 |
|---|---|---|
| 共享协议 | `firmware_new/protection_protocol.h` | 独立诊断 selector、标识和字段定义；旧回包不得冒充新数据 |
| 电机 CAN | `firmware_new/dummy-motor-fw/Core/Src/can.c`、`Core/Inc/can.h` | 接收/发送/合并/丢弃及最后请求编号的 RAM 统计与快照接口 |
| 电机控制入口及诊断 | `firmware_new/dummy-motor-fw/UserApp/main.cpp`、`Ctrl/Motor/stall_protection.cpp` | 控制回调耗时记录、诊断回包；不在中断打印 |
| 主控 CAN | `firmware_new/dummy-ref-core-fw/Bsp/communication/interface_can.cpp`、`interface_can.hpp` | 保护查询实际 TX 完成及失败统计 |
| 主控协调器及串口入口 | `firmware_new/dummy-ref-core-fw/Robot/instances/protection_coordinator.cpp`、`protection_coordinator.h`、`UserApp/protocols/ascii_protocol.cpp` | 保护回复匹配/拒绝统计、新只读查询及完整回包校验 |
| 目标助手及独立记录 | `串口助手_old.py`、本文档 | 同步新查询入口、结果解析和测试步骤 |

已更新两工程 build 生成物，并交付新版本、新批次的五目标冻结包和清单。此范围仅统计诊断，不包括修改队列重试策略、堵转阈值、STOP/START、运动公式、ADC 通知或 Flash 分区。首次链接超出应用区 964B；将新增计数所在的 `MotorCanProtectionResult` 保留为一个不可内联函数，避免六个 ISR 包装函数重复展开，最终四目标均通过原容量边界。原判断、重试与中断优先级未变。

## 20261010.02 诊断版：历史交付与测试流程

版本 `20261010.02`，统一批次 `AE3091CF257B46DA`，UTC 时间 `2026-10-10T02:36:17+00:00`（北京时间 10:36:17）。两工程共同生产输入 SHA256 为 `6dc1f9481446889abc92bd92559ae18c650e062f163e2333b66b2510c6831a62`，共 486 个输入。构建前后逐文件摘要均核对一致。

冻结包：[20261010_02_AE3091CF257B46DA](../build/firmware_release/20261010_02_AE3091CF257B46DA/)，文件摘要与实际编译/链接清单见包内 `manifest.json`。生产 build 目录也已更新；推荐烧录冻结包，避免后续编译覆盖。根目录 `串口助手_old.py` 已同步，包内另保存相同文件用于核对。

| 目标 | BIN 长度 | 精确读回长度 | 应用区余量 |
|---|---:|---|---:|
| Core-STM32F4-fw.bin | 453684 B | 0x6EC34 | 应用擦除 sector 0～7 内余 70604 B |
| motor-35.bin | 96460 B | 0x178CC | 820 B |
| motor-42.bin | 96460 B | 0x178CC | 820 B |
| motor-57.bin | 96444 B | 0x178BC | 836 B |
| motor-gripper.bin | 96404 B | 0x17894 | 876 B |

九板仍需全部同批：主控用 Core 文件；已确认实物 J1～J3 用 motor-42，J4～J6 用 motor-35，J7 用 motor-57，J8 用 motor-gripper。统一使用 BIN、地址 `0x08000000`。按本文烧录章节只擦应用区，随后 `Skip Flash erase` + `Verify after programming`，保留编码器表、参数页与主控 RGB 配置；无需全片擦除或重写主控 EEPROM。全部烧录完成后拔掉 ST-LINK，再正常上电。`boot` 字段不是新增 RCC 复位原因诊断。

### 查询与读数含义

```text
#CAN_DIAG 2
#CAN_DIAG 3
```

支持单个电机节点 1～8；此命令不支持节点 0。可选第二参数为请求号 1～65535，例如 `#CAN_DIAG 2 1001`。助手手动发送与按钮都会分配显式请求号；按钮“CAN诊断（参数节点）”读取电机参数页当前节点，选择 ALL 会拦截。STOP 或 CAL 锁定时仍可查询。每次等待同节点、同请求的 `end` 或明确错误再发送下一条；没有自动连续采样。

传输使用独立 selector 6，24 个 CAN word 带 CND1、schema、selector、板型与 DWT 标志；主控缓存乱序字段并验证完整 mask。文本含 43 个必需字段，助手完整校验后才生成 `CAN_SUMMARY`。旧固件会超时；旧 STALL/CAL 快照或部分行不能冒充完整诊断。原版本查询仍为 selector 7，STALL/CAL 查询含义不变。

| 字段 | 解释 |
|---|---|
| `query_rx`、`nonce_rx`、`last_rx` | 电机收到保护 QUERY 的次数、最后编号、HAL 毫秒时刻 |
| `probe_q`、`merge`、`full` | PROBE 新入队次数、合并次数、队满丢弃次数 |
| `txok`、`alst`、`terr`、`nonce_tx`、`last_tx` | 电机 PROBE 真实 TXOK、仲裁丢失、发送错误及最后成功编号/毫秒时刻；入邮箱不计为送达 |
| `age`、`tries` | 按原 100ms 年龄/16 次尝试预算丢弃的 PROBE 次数；这两个字段不是时间 |
| `depth`、`peak`、`head`、`head_age`、`flags` | 保护队列当前/历史峰值深度、队头命令及年龄；flags bit0=拥有邮箱、bit1=正在取消 |
| `rx_ovr` | RX FIFO 溢出错误累计位图：0x200=FIFO0，0x400=FIFO1；不是次数或丢帧数 |
| `m_q`、`m_txok`、`m_alst`、`m_terr`、`m_abort` | 主控对该节点 QUERY 的入邮箱、真实 TXOK、仲裁丢失、发送错误、取消次数 |
| `m_rx`、`m_match`、`m_reject` | 主控收到该节点 PROBE 的总数、按原规则匹配数、编号不匹配拒收数 |
| `m_sent`、`m_got`、`m_txn` | 主控当前已发请求编号、最后收到编号、最后真实 TXOK 的请求编号 |
| `m_at`、`m_rxage`、`m_pbage` | 主控快照真实 HAL 毫秒，以及任意保护帧/匹配探测回复的年龄 |
| `up`、`boot` | 电机 HAL 毫秒与原有启动命名空间；boot 不保证单调递增，不能独立当严格复位计数 |
| `cpu`、`dwt` | CPU Hz 与 DWT 可用标志；dwt=0 时零计时不代表健康 |
| `ctl_max`、`ctl_gap`、`pollgap`、`ctl_late` | 控制回调观测最大耗时、入口最大间隔、发送轮询最大间隔（前三者为 CPU 周期），以及耗时达到 50μs 预算或退出时 UPDATE 已置位的次数 |

计数在 RAM 中累积，不写 Flash、不提供清零命令；32 位计数可自然回绕。主控节点统计在恢复该节点默认值时可能重建，因此本测试不执行恢复参数。用同次启动的前后增量定位；计数并非故障瞬间自动冻结，而且运动结束到查询完成之间仍可能继续增长。电机 24 word 是同一快照；主控本地计数在开始打印时另取快照，两个芯片时刻没有同步，不能要求逐个请求的瞬时计数严格相等。

DWT 换算 `微秒 = 周期 × 1000000 / cpu`，20kHz 周期预算为 50μs。观测包含记录入口间隔到 Tick 返回的区域，未覆盖完整 ISR 入栈/出栈及统计尾部，不是完整硬件 WCET。最大间隔也会受 ADC 中断等影响；诊断本身增加少量 RAM 写入和执行时间。只有异常前后增量及对照实验才能支持具体根因，不能凭一个最大值宣布问题已修复或已经定位。

### 第一轮：启用检测，复现 HOME 并立即取证

1. 关闭旧助手，重新运行根目录更新后的 `串口助手_old.py`，打开日志记录。九板整组版本应全部为 `.02`、上述同批号与摘要，且板型正确。异常或缺板时先纠正烧录。
2. 使用此前成功的方法建立可信坐标与机械校准。烧录后重新上电会重新初始化坐标，需要让 J1～J6 处于规定 REST 姿态再进行校准；不要在任意姿态把当前坐标标成 REST。完成后地轨/夹爪应返回正常位置。保留同一供电、速度与起始姿态。
3. 失能后仅在 RAM 启用检测，等待七轴确认，不 SAVE：

```text
!DISABLE
#STALL_SET 0 ENABLE 1
!START
```

4. 等 START 成功，在有实际位移的 REST 起点逐条取基线，等上一条 `end` 再发送下一条，然后 HOME。若已经位于 HOME，零位移的 HOME 不能作为复测。

```text
#CAN_DIAG 2
#CAN_DIAG 3
!HOME
```

5. 出现 STOP 后保持电源和串口连接，不 START、不 DISABLE、不重新校准、不恢复默认。尽快逐条发送以下查询，均等到 `end` 或明确错误；若报错轴不是 J2，首先查实际报错轴，再查 J2/J3。

```text
#CAN_DIAG 2
#CAN_DIAG 3
#STALL_STATUS 2 LAST
#STALL_STATUS 3 LAST
#STALL_STATUS 2
#STALL_STATUS 3
#MOTION_STATUS
```

6. 若 HOME 成功，同样立即查询两个 CAN_DIAG，保存成功回执与前后完整日志。不要只发送 `CAN_SUMMARY`，原始 21 行含核对所需字段。补充停机时哪几个轴仍在运动、有无驱动灯变化；任何手动复位/断电都要注明时刻。

### 第二轮：RAM 关闭检测的相同位移对照（需要时）

第一轮取证完整后再失能、仅 RAM 执行 `#STALL_SET 0 ENABLE 0`，不 SAVE。坐标仍可信时，用此前成功方式回到相同 REST 起点；出现重新初始化证据时先重新建立坐标，不能直接用旧多圈位置继续。然后 START → 两节点 CAN_DIAG 基线 → HOME → 两节点 CAN_DIAG 结束快照。速度、供电、负载与位移尽量一致。不要在运动中频繁轮询诊断，避免额外流量干扰对照。

两轮完整日志将区分：主控 QUERY 未实际送出、板端没有收到、PROBE 被合并/过期/队满丢弃、发送失败、主控拒收编号，以及控制或发送轮询被长时间延后。ALST 增加只说明仲裁未赢，不等于线路损坏；TXOK 表示总线上被确认，不能单独证明指定主控成功处理。若计数指向 CAN 物理问题，再检查终端电阻、接线和板端供电；若计数指向软件队列或时间预算，再提出具体修复。

### 实际修改、验证与剩余问题

最新修改限于上表 12 个已确认文件以及构建/交付产物。主控查询统计使用独立邮箱标记，避免影响原 motion metadata；电机计数贴合原入队、合并、重试、丢弃路径，DWT 在控制回调与发送轮询中取值，没有在中断打印。

主控 TX 生产函数抽取测试 512 项、电机 CAN/队列/DWT 抽取测试 148 项、主控诊断/旧版本协议抽取测试 1194 项、助手完整字段及隐藏 Tk 测试 441 项均通过。四型电机选择器、版本及旧 STALL/CAL 回归各 21313 项通过（合计 85252 项，含逐字段验证的重复组合），详见交付包测试记录。两个工程 Release/Ninja 构建成功，五 BIN 嵌入身份一致；HEX 校验和与覆盖字节核对通过，只有已知对齐空洞。离线测试不能替代九板实机复现。

HOME 通信超时尚未修复；本次没有调整保护阈值，也没有新增 RCC 启动原因、修改 ADC 中断、CAN 重试或控制算法。下一步依据用户的 `.02` 前后诊断日志决定修复范围。

## 初次交付时的调查结论（保留历史）

不能认为“固件已经证明没有问题”。近期地轨日志中，MoveJ 的明确停机入口是 `PROTECTION_STATUS_TIMEOUT`：主控超过 1000ms 未得到匹配的保护状态探测回复，随后执行普通 STOP。该停机入口不会执行堵转回退。`LAST` 没有堵转记录也支持这一轮没有收到本地堵转事件，但不能据此证明实物没有阻挡。

09:04 校准中夹爪已完成 BACKOFF/RETOUCH/RETURN/DONE，随后地轨状态变为 IDLE/task0，并出现 BAD_TASK。用户确认发生在地轨物理限位处；运行上下文消失值得怀疑重新初始化，但没有启动原因寄存器证据，尚不能判定是供电、复位线、软件复位或其他原因。两份日志之间用户主动断电复位，不能跨日志拿运行计时证明异常重启。

本次版本功能先解决“板上究竟是哪份固件、是否九板同批”的证据缺口。它不提供 RCC 复位原因、启动次数或实时 ISR 耗时，也不修复以上停机问题。

## 版本查询

启动根目录 `串口助手_old.py`。连接后发送 `!DISABLE`，等主控确认失能，再点击查询区的“查询固件版本”。它逐条查询主控与 J1～J8，等待每板完整回复或超时，最后打印 `FW_SUMMARY`。

也可以逐条手动发送，等上一条 `end` 或明确错误后再查下一板：

```text
#FW_VERSION 0
#FW_VERSION 1
#FW_VERSION 2
#FW_VERSION 3
#FW_VERSION 4
#FW_VERSION 5
#FW_VERSION 6
#FW_VERSION 7
#FW_VERSION 8
```

**此命令的 0 专指主控，不是广播；其他指令原有 0=ALL 语义没有改变。** 手动版本查询只读，可在 STOP 或校准锁定期间使用。整组按钮要求已确认失能，并结束其他批量任务。

可选的第二个参数是十进制请求号 1～65535，例如 `#FW_VERSION 7 1234`。省略时主控自动分配。整组按钮显式提供请求号，按节点+请求号匹配，不把迟到回复、裸 `ok` 或部分回复当成成功。

每板有六行正式回复：

```text
FW_VERSION [7] req=1234 v=20261010.01 type=M57
FW_VERSION [7] req=1234 epoch=<UTC Unix秒>
FW_VERSION [7] req=1234 group=<16位十六进制批次>
FW_VERSION [7] req=1234 h0=<源码摘要前32位>
FW_VERSION [7] req=1234 h1=<源码摘要后32位>
FW_VERSION [7] req=1234 end
```

发布版本 `v`、UTC 时间 `epoch`、构建批次 `group`、拼接 `h0+h1` 的 SHA256 应在九板完全一致。类型应为主控 CORE、J7 M57、J8 GRIPPER；J1～J6 按实物选 M35/M42/M57，不能为了让类型相同而给不同型号刷同一个文件。

旧主控可能只返回裸 `ok`；旧电机不支持新 selector，会超时。助手会报告缺失或未匹配，不能据此认定整组已更新。版本查询显示的是固件内编译的身份，不等价于逐字节读回验证全部应用 Flash。

## 同一批构建的约束

五个目标共享同一发布版本、显式批次号、UTC 时间和生产输入摘要。摘要包含两个固件工程的生产目录、共享协议头、实际 CMake、链接脚本和主控 CMSIS 库，排除 build、文档和上位机文件。它不会把无关 Git HEAD 当成固件源码版本。

源码增删、链接脚本和实际库的依赖已登记。生产输入变化会重新配置身份；复用历史批次但改变源码、版本或时间会拒绝配置。每个 build 目录还记录编译工具和选项，历史约束依赖该目录中的登记文件，删除 build 也会删除其历史。因此以后每次交付都使用新批次号，并重新核对两工程和五产物。

主控与电机 `build/generated/fw_build_manifest.txt` 保留工具链、编译选项和各输入文件摘要。最终交付还记录五 BIN/HEX/ELF 的文件摘要、准确长度和烧录地址。

## 烧录：保留校准与参数，不全片擦除

本次没有证据表明主控持久数据损坏，不需要为了排查而重写主控 EEPROM。主控的 RGB 持久设置和电机的编码器校准表、参数页应保留。全片擦除会丢失这些数据，且无法判定 STOP 的根因。

使用 ST-LINK Utility，对九块板分别执行以下步骤。烧录是用户执行的操作，本聊天没有操作设备。

1. 用本次交付目录内的文件，核对板卡型号与文件名。必要时先备份保留区；有读保护时不要解保护，解保护可能触发全片擦除。
2. 在 `Target → Erase Sectors` 中**只选择应用范围**。不选择全片擦除。
3. 用 `Program & Verify` 选择对应 **BIN**，起始地址显式填 `0x08000000`。应用区已经擦除后勾选 `Skip Flash erase` 和 `Verify after programming`。
4. 记录板号、文件、验证结果。全部九块板完成，再断开 ST-LINK，正常上电并通过 USB 查询整组版本。

| 板卡 | 文件 | 当前应用擦除范围 | 保留范围 |
|---|---|---|---|
| STM32F405 主控 | Core-STM32F4-fw.bin | sector 0～7，0x08000000～0x0807FFFF | RGB 位于 sector 11，不能擦 |
| J1～J6 | 按实物选 motor-35.bin / motor-42.bin / motor-57.bin | page 0～94，0x08000000～0x08017BFF | page 95～126 编码器表、page 127 参数 |
| J7 地轨 | motor-57.bin | 同上 | 同上 |
| J8 夹爪 | motor-gripper.bin | 同上 | 同上 |

电机保留区：编码器表 `0x08017C00～0x0801FBFF`；参数页 `0x0801FC00～0x0801FFFF`。链接脚本仍限定应用 95KiB，没有挪用这些保留区。

BIN 从起始地址连续定义所有字节，适合按清单精确长度读回后比较 SHA256。HEX 在向量表与 `.text` 间存在对齐空洞，不能把按 HEX 烧录后的整个范围直接与 BIN 的 SHA256 比较；既有 HEX 烧录应比较 HEX 记录覆盖的地址，或重新按上述 BIN 流程烧录。

只读核验可在 HotPlug 模式使用 `Compare device memory with file`，或从 `0x08000000` 按清单 BIN 长度保存读回文件再算摘要。不要把 `Program & Verify` 当作只读比对工具。

## 初次交付建议的实机测试（历史）

先完成整组版本查询并保存完整串口日志。如果有缺失、不一致或板卡类型不符，先纠正烧录，再进行运动测试。

1. 失能状态查询 `#FW_VERSION 0` 和 `#FW_VERSION 7`，记录版本及时间，确认板上支持新协议。
2. 地轨从距物理限位有余量的位置开始，一轮只测试机械校准。记录实物碰限位、松开、再次接触、回程的阶段；不要同时测试 MoveJ 或恢复参数。
3. 出现 STOP 后先不要 START、重校准、断电或恢复默认。逐条查询 `#CAL_STATUS 7 LAST`、`#CAL_STATUS 7`、`#STALL_STATUS 7 LAST`、`#STALL_STATUS 7`、`#MOTION_STATUS`；每条等到 `end` 后再发送下一条。
4. 保存错误前后完整日志，并补充地轨停机瞬间是否卡在限位、驱动灯是否变化、有无其他板同时异常。版本查询可核对身份，不能证明有没有发生复位。
5. 若同批固件仍复现 IDLE/task0/BAD_TASK 或 PROTECTION_STATUS_TIMEOUT，下一步另行实现启动原因/计数诊断，再结合实测供电、复位线、CAN 与控制中断时序定位；不先调堵转阈值，也不通过反复撞限位寻找现象。

本次离线验证可以证明版本传输、解析、构建身份及产物布局。后续九板查询与成功校准证据见本文开头；HOME 通信超时仍需继续定位。

## 20261010.01 构建与交付（历史）

- 发布版本：`20261010.01`
- 统一批次：`C4D78A5E8C046679`
- UTC 构建时间：`2026-10-10T01:29:38+00:00`（北京时间 09:29:38）
- 生产输入 SHA256：`a28837246ed6fff5c6ba83faf9030436f7497c72603791ae7efb4fe3976ba293`
- 冻结目录：[20261010_01_C4D78A5E8C046679](../build/firmware_release/20261010_01_C4D78A5E8C046679/)
- 完整文件摘要、地址、构建命令及源清单：[manifest.json](../build/firmware_release/20261010_01_C4D78A5E8C046679/manifest.json)。生产 `build` 目录也包含同批产物；建议烧录冻结目录，避免日后编译覆盖。

| 目标 | 本次 BIN 长度 | 精确读回长度 | 电机应用余量 |
|---|---:|---|---:|
| Core-STM32F4-fw.bin | 450356 B | 0x6DF34 | — |
| motor-35.bin | 96564 B | 0x17934 | 716 B |
| motor-42.bin | 96564 B | 0x17934 | 716 B |
| motor-57.bin | 96556 B | 0x1792C | 724 B |
| motor-gripper.bin | 96516 B | 0x17904 | 764 B |

五个 BIN 均已验证包含正确的 14 字段版本标识；两工程的共同身份与当前生产源码摘要一致。五个 HEX 的记录校验和正确，覆盖字节与 BIN 一致；主控有 56 字节、电机各有 4 字节对齐空洞，均已单独核实。

验证包括提取生产代码的主控版本协议测试、电机四类型版本/既有 STALL/CAL 兼容测试、串口助手协议与隐藏 Tk 布局测试，均通过。两个工程使用原优化和原链接布局完成 Release/Ninja 构建；没有新增 BOOT 诊断或修改控制中断。

隔离构建副本验证了历史批次的拒绝规则：改变源码、发布时间、发布版本或编译选项后复用同一批次均明确失败；原输入重复配置成功。Ninja 生成依赖覆盖全部 486 个共同生产输入，并包含实际链接脚本、主控库及 HEX/BIN 产物。生产文件和交付产物在隔离测试前后摘要一致。

本聊天完成了离线构建与测试；用户随后完成九板烧录、整组版本查询及实机测试。版本已匹配，电源限流修正后校准成功；启用普通堵转检测时 HOME 的通信超时仍未解决。未新增复位/时序诊断，未修改控制或保护逻辑。
