Liu3Beng-A/Dummy/docs/查询端补齐方案.md

# 查询端补齐方案（PID / 加速度 / 最大电流）

> **2026-10-08 回退状态**：本轮PID改动已按用户要求整体撤销，当前代码恢复`87288fb23b20e1f35513e5a044fa25099d4d7122`；以下PID事务更新及链接说明仅作历史记录，当前实现以该提交源码为准。详见[SESSION_STATUS](SESSION_STATUS.md)。

> **2026-10-08 历史实现更新（已撤销）**：PID 已改为失能后带事务的 RAM 应用、四项回读确认及独立 `#SAVE_PID` 物理保存确认，USB/UART4 共用入口。本文后续“PID 总写 EEPROM”、旧同步等待与回执方案为历史记录，当前行为以 [PID调参与保存协议及测试说明](PID调参与保存协议及测试说明.md) 为准。加速度/电流显式 `&` 保存现要求失能；它们仍使用旧回执。

> 编制日期：2026-10-03
> 编制人：Cursor Agent（用户授权任务）
> 涉及模块：`firmware_new/dummy-ref-core-fw`（主控）、`串口助手_old.py`（上位机目标）
> 参考版本：`firmware/ref_core_f405`（功能语义/API 参考）+ `firmware_new/dummy-motor-fw`（电机端已就绪 0x28~0x2D 回包）
> 文档定位：把"查询与设置"路线图项的**查询端**补齐。设置端（`#SET_DCE_K*` / `#I_LIMIT_J` / `#ACC_J`）已在 Step 4 落地（参考 `docs\handcode夹爪实现对比与迁移方案.md` 附录 B Step 4）。**不做全新接口设计**，仅参考 ref 实现并在此基础上做超时保护 + ALL 广播查询 + 索引统一等改进。

---

## 修订

1. **本方案是「查询端」**：设置端已在 `firmware_new/dummy-ref-core-fw/UserApp/protocols/ascii_protocol.cpp:131-250` 落地（Step 4）。本次仅补查询端。
2. **电机端 0 改动**：经核对 `firmware_new/dummy-motor-fw/UserApp/protocols/interface_can.cpp:264-320`，0x28~0x2D 全部命令的回包响应**已实现**，主控只缺查询路径。
3. **不做 `SetAcceleration_persist` / `SetCurrentLimit_persist`**：当前 `#ACC_J` / `#I_LIMIT_J` 走基类 `SetAcceleration`/`SetCurrentLimit`，默认 `canBuf[4]=0` 不写 EEPROM，**已经满足"不持久化"语义**。ref 的 `_persist(val, persist)` 变体是为 ASCII 显式选持久化用的——本方案用更轻的"`#ACC_J` 永远不写 EEPROM"语义，简化接口面。
4. **`jointAccRuntime` 索引从 `[7]` 改为 `[9]`**：对齐 ref 的 `[9]`（[1..7] + [8]=hand），[0] 留给 ALL 代理空闲槽。影响 `dummy_robot.cpp:218-222` 共 3 行访问点。
5. **`#GET_PID` 必须有 30ms 超时保护**：ref 用 4 帧合并计数器，丢 1 帧**永远 pending**——本方案加起始时间戳 + 30ms 超时回退到 `error GET_PID timeout (got X/4)`。
6. **ALL 模式替代 `#SYNC_*`**：用户决策**不新增** `#SYNC_ACC` / `#SYNC_I` / `#SYNC_PID` 三条异步批量命令（ref 的 `#SYNC_ACC` 也不做）。ALL 模式（`#GET_PID 0` / `#GETJACC 0` / `#GETI 0`）提供相同能力，3 条命令代替原 6 条，UI 「全部读取」按钮触发 3 条 ALL 命令而非 3 条 `#SYNC_*`。
7. **UART4 通道延后到「最后一步」**：本期只做 USB ASCII 通道的查询类命令。UART4 开放 `#GET_PID/GETJACC/GETI` 单独拎出来放在所有功能完成后再做（避免分散测试精力）。**本期不写 UART4 任何代码**，但 ASCII 协议层保留扩展位。

## 修订 (2026-10-04 追加)

8. **PID 维持总写 EEPROM**：用户 2026-10-04 09:45 确认 `SetDceKp/Kv/Ki/Kd` 不加 `_persist` 变体，`#SET_PID` 不解析 `&`（与 ref 行为对齐；ref 的 `#SET_PID` 也不支持 `&`）。
9. **`&` 语义恢复**：用户同意方案 A1（与 ref 完全对齐）。`#ACC_J <node> <v> [&]` 和 `#I_LIMIT_J <node> <A> [&]` 默认不写 EEPROM，加 `&` 才写。基类新增 `SetAcceleration_persist` / `SetCurrentLimit_persist` 两个变体。**行为变更**：`#I_LIMIT_J` 默认从不写 EEPROM（之前写 EEPROM），电机掉电恢复上次 EEPROM 值。
10. **`#GET_PID` 改用时间戳模式（同步路径与异步 PollPidPrint 解耦）**：新增 `motorPidLastUpdateMs[9]` 字段（与 `jointAccLastUpdateMs` 同模式），`motorPidRcvdCount[9]` 加 `volatile`。ISR 合并 4 帧时同时设 `motorPidLastUpdateMs[idx] = HAL_GetTick()`。同步等待改检查时间戳变化，**不再共享 `_pid_print_pending` 单一信号**。
11. **`#GET_PID` 等待 30ms → 10ms**：单节点同步等由 30ms 缩到 10ms（CAN 实测 < 3ms 回包，10ms 给 3× 余量）。`#GETJACC` / `#GETI` 不动，保持 30ms。
12. **`SyncAllMotorPid()` 帧间加 `osDelay(1)`**：32 帧错峰 ~32ms，避免撞 5ms 控制环；`tx_busy_errors` 不再累加；200Hz 控制环不掉拍。`SyncAllMotorAcceleration()` / `SyncAllMotorCurrentLimit()` 不动（单帧 0x2C/0x2D 不撞总线）。

---

## 1. 背景与目标

### 1.1 现状（v2026-10-03）

设置端已在主控**全部到位**（Step 4 完成，2026-10-03 19:55）：

- `#SET_DCE_KP/KV/KI/KD <node> <v>` 范围 1~8（含地轨 7 + 夹爪 8），单节点写 EEPROM
- `#I_LIMIT_J <node> <A>` 范围 1~8
- `#ACC_J <node> <r/s²>` 范围 1~8（**不**写 EEPROM）
- `#REBOOT <node>` 范围 1~8 + 0=ALL

查询端**全部缺失**：

- 基类 `CtrlStepMotor` 无 `QueryDceKp/Kv/Ki/Kd` / `QueryAcceleration` / `QueryCurrentLimit` 6 个方法
- `can_protocol.cpp` 不处理 0x28~0x2D 回包（电机端已发，主控扔了）
- `DummyRobot` 缺 `jointAccLastUpdateMs[9]` / `jointCurrentLimitRuntime[9]` + 时间戳 / `motorDceKps/Kvs/Kis/Kds[9]` 缓存
- ASCII 协议无 `#GET_PID` / `#GETJACC` / `#GETI` / `#SET_PID`（**不**做 `#SYNC_ACC/I/PID`，ALL 模式替代，见修订 #6）
- `串口助手_old.py` 无查询 UI 面板

### 1.2 路线图项

PROJECT_GUIDANCE §1.1：「PID、加速度、最大电流的**查询**与设置」——设置端已结案，本次完成查询端后该路线图项**整体结案**。

### 1.3 任务目标

1. 主控基类加 6 个 `Query*` 方法（发 0x28~0x2D）
2. `can_protocol.cpp` 处理 0x28~0x2D 回包：0x28~0x2B 4 帧合并 + `_pid_print_pending` 标志 / 0x2C/0x2D 直接更新 runtime 缓存 + 时间戳；节点 1~6 + 7（地轨）+ 8（夹爪）全覆盖
3. `DummyRobot` 加 `jointAccRuntime[9]` + `jointAccLastUpdateMs[9]`（替换 `[7]`）/ `jointCurrentLimitRuntime[9]` + 时间戳 / `motorDceKps/Kvs/Kis/Kds[9]` + `motorPidRcvdCount[9]` / `SyncAllMotorAcceleration` / `SyncAllMotorCurrentLimit` / `SyncAllMotorPid` / `PollPidPrint`
4. ASCII 加 4 条 `#` 命令：`#SET_PID 1~8 kp kv ki kd` / `#GET_PID 1~8 + 0=ALL` / `#GETJACC 1~8 + 0=ALL` / `#GETI 1~8 + 0=ALL`（**不**做 `#SYNC_ACC` / `#SYNC_I` / `#SYNC_PID`，ALL 模式替代，见修订 #6）
5. `串口助手_old.py` 加查询 UI：节点下拉 1~8 + 「读取 PID/ACC/I_LIMIT」+ 「全部读取(8 节点)」按钮（触发 3 条 ALL 命令）

> **范围变更**：ASCII 命令从 7 条（含 3 条 `#SYNC_*`）减为 4 条；功能等价（ALL 模式 + 单节点 + `#SET_PID`），UI 不变。

---

## 2. ref vs firmware_new 查询能力对比

| 能力 | ref（`firmware/ref_core_f405`）| firmware_new（本期目标）| 差异 |
|---|---|---|---|
| 基类 `QueryDceKp/Kv/Ki/Kd` | `ctrl_step.hpp:43-46` + `.cpp:264-279` | **缺** | 新增 |
| 基类 `QueryAcceleration` | `ctrl_step.cpp:170-174` | **缺** | 新增 |
| 基类 `QueryCurrentLimit` | `ctrl_step.cpp:165-168` | **缺** | 新增 |
| `SetAcceleration_persist` | `ctrl_step.hpp:40` + `.cpp:143-150` | **缺（不做，见修订#3）**| 跳过 |
| `SetCurrentLimit_persist` | `ctrl_step.hpp:37` + `.cpp:113-118` | **缺（不做）**| 跳过 |
| `jointAccRuntime` | `[9]` (`dummy_robot.h:185`) | `[7]` (`dummy_robot.h:142`) | 改 `[9]` |
| `jointAccLastUpdateMs` | `[9]` (`dummy_robot.h:189`) | **缺** | 新增 |
| `jointCurrentLimitRuntime` | `[9]` (`dummy_robot.h:194`) | **缺** | 新增 |
| `jointCurrentLimitLastUpdateMs` | `[9]` (`dummy_robot.h:195`) | **缺** | 新增 |
| `motorDceKps/Kvs/Kis/Kds` | `[9]` (`dummy_robot.h:170-173`) | **缺** | 新增 |
| `SyncAllMotorAcceleration` | `dummy_robot.h:212` + `.cpp` 实现 | **缺** | 新增 |
| `SyncAllMotorCurrentLimit` | ref 无（**改进点**）| **缺** | 新增 |
| `SyncAllMotorPid` | ref 无（**改进点**）| **缺** | 新增 |
| `PollPidPrint` | `can_protocol.cpp:41-56` | **缺** | 新增（放 dummy_robot.cpp）|
| can_protocol 0x28~0x2D 回包路由 | `can_protocol.cpp:64-220` 完整 | **缺** | 新增 |
| `#GET_PID <node>` | `ascii_protocol.cpp:584-625` | **缺** | 新增 |
| `#GETJACC <node>` | `ascii_protocol.cpp:741-810`（30ms 超时）| **缺** | 新增 |
| `#GETI <node>` | `ascii_protocol.cpp` L813~起（30ms 超时）| **缺** | 新增 |
| `#SYNC_ACC` / `#SYNC_I` / `#SYNC_PID` | ref 仅 `#SYNC_ACC` 有 | **不做**（ALL 模式替代，见修订 #6）| 跳过 |
| `#SET_PID <node> kp kv ki kd` | `ascii_protocol.cpp:534-580` | **缺** | 新增 |
| `#GET_PID` 超时保护 | ref 漏（4 帧合并无超时）| **加 30ms 超时** | 改进 |
| `#GET_PID` / `#GETJACC` / `#GETI` 支持 `node==0` ALL | ref 无 | **新增** | 改进 |
| 回包数值带单位 | ref `ok PID %d kp=...` 无单位 | `ok PID %d kp=... ki=...` | 加注释 |
| `串口助手_old.py` 查询 UI | ref 无对应（ref 上位机未保留）| **缺** | 新增 |

---

## 3. 改进点（我们要做得比 ref 好的地方）

### 3.1 `#GET_PID` 加 30ms 超时 + 帧数诊断

**ref 问题**（`firmware/ref_core_f405/UserApp/protocols/can_protocol.cpp:36-56`）：
```cpp
static uint8_t _pid_rcv_cnt[9] = {0};
// ISR 内 4 帧合并，丢 1 帧 _pid_rcv_cnt 就停在 1/2/3，_pid_print_pending 永远不置位
```

**本方案修复**（`ascii_protocol.cpp` 的 `#GET_PID` 分支）：
```cpp
const uint32_t t_start = HAL_GetTick();
// 触发 4 个查询
dummy.motorJ[node]->QueryDceKp();
dummy.motorJ[node]->QueryDceKv();
dummy.motorJ[node]->QueryDceKi();
dummy.motorJ[node]->QueryDceKd();
// 同步等 30ms
while (...) {
    osDelay(1);
    waited++;
    // 检查 _pid_rcv_cnt[idx]，达到 4 提前 break
}
if (got_4) {
    Respond("ok PID [%lu] kp=%ld kv=%ld ki=%ld kd=%ld", node, ...);
} else {
    Respond("error GET_PID [%lu] timeout (got %lu/4)", node, _pid_rcv_cnt[idx]);
}
```

**优势**：
- 丢 1 帧也不卡死，30ms 内回退到错误诊断
- 用户知道具体缺哪个（`got 2/4`）
- 与 `#GETJACC` / `#GETI` 超时模式对齐

### 3.2 `node==0` ALL 广播查询

**ref 漏**：ref 5 `ascii_protocol.cpp:584-625` 的 `#GET_PID` / `#GETJACC` / `#GETI` 只支持 `node 1~7 + 8`，**不支持 `node==0` 一次性查所有节点**。

**本方案加**：ASCII 层加 `if (node == 0)` 分支，遍历 1~8 触发 8 套查询，回包逐行打印（避免串口合并怪行）：
```
ok PID [1] kp=1000 kv=80 ki=200 kd=250
ok PID [2] kp=1000 kv=80 ki=200 kd=200
...
ok PID [8] kp=800 kv=80 ki=300 kd=100 (HAND)
```

**优势**：用户 1 条命令拿全 8 个电机 PID，无需脚本循环。

### 3.3 ALL 模式替代 `#SYNC_*`（用户决策不新增）

**用户决策（2026-10-03 21:20）**：**不新增** `#SYNC_ACC` / `#SYNC_I` / `#SYNC_PID` 三条异步批量命令（ref 的 `#SYNC_ACC` 也不引入），由 `node==0` ALL 模式查询提供相同能力：

| 旧方案（ref + 早期本方案） | 新方案（用户决策后） |
|---|---|
| `#SYNC_ACC` 异步批量查询 8 个 0x2C | `#GETJACC 0` ALL 模式（同步触发 8 节点 0x2C，回包由 OledTask 周期 poll 打印）|
| `#SYNC_I` 异步批量查询 8 个 0x2D | `#GETI 0` ALL 模式 |
| `#SYNC_PID` 异步批量查询 32 帧 PID | `#GET_PID 0` ALL 模式（同步触发 32 帧，回包由 OledTask PollPidPrint 分行打印）|

**3 条命令代替原 6 条**（`#GET_PID/GETJACC/GETI 0` 三条 ALL + ref 的 3 条 `#SYNC_*`）。串口助手「全部读取」按钮触发这 3 条 ALL 命令。

**DummyRobot 仍保留 3 个 Sync 方法**（被 `#GET_PID/GETJACC/GETI 0` 内部调用，作为 ALL 模式的实现细节，不暴露给 ASCII 层）：

```cpp
// 内部使用：被 #GET_PID 0 / #GETJACC 0 / #GETI 0 调用
dummy.SyncAllMotorAcceleration();   // 8 个 0x2C
dummy.SyncAllMotorCurrentLimit();   // 8 个 0x2D（ref 无，本期新增）
dummy.SyncAllMotorPid();            // 32 个 PID 查询（ref 无，本期新增）
```

**API 表面更简洁**：ASCII 协议层**不**暴露 `#SYNC_*`，只暴露 `#GET_PID/GETJACC/GETI` 三条 + `node==0` 变体。`SyncAll*` 是 C++ 内部方法，对外不可见。

**优势**：
- ASCII 协议命令数从 7 条降到 4 条
- 用户语义统一：「想查节点 N 改 N 即可，0=ALL」——不需要区分同步/异步触发 vs 单节点查询
- 文档/测试矩阵从 6×3=18 个组合简化为 3×2=6 个

### 3.4 索引统一 `[7]` → `[9]`

| 字段 | 现状 | 目标 | 理由 |
|---|---|---|---|
| `jointAccRuntime` | `[7]`（索引 0~6）| `[9]`（索引 [0]=空闲, [1]=J1..[6]=J6, [7]=地轨, [8]=hand）| 与 ref 对齐；未来增删节点不乱 |
| `jointAccLastUpdateMs` | 缺 | `[9]` | 同上 |
| `jointCurrentLimitRuntime` | 缺 | `[9]` | 同上 |
| `jointCurrentLimitLastUpdateMs` | 缺 | `[9]` | 同上 |
| `motorDceKps/Kvs/Kis/Kds` | 缺 | `[9]` | 同上 |

**改动点**：仅 `dummy_robot.h` 数组声明 + `dummy_robot.cpp:218-221` 的 3 行访问
（`jointAccRuntime` 下标从旧 `[0..6]` 改为 `[7,1..6]`，**保持 `jointAcc[0]=地轨` 对齐
`deltaRails[0]`**，详见 §4.4.1）。

### 3.5 持久化语义（2026-10-04 09:45 修订）

| 命令 / 基类 | 默认 | `&` 后缀 | 备注 |
|---|---|---|---|
| `#ACC_J <node> <r/s²>` | 不写 EEPROM | 写 EEPROM | 调 `SetAcceleration` / `SetAcceleration_persist` |
| `#I_LIMIT_J <node> <A>` | **不写 EEPROM**（**行为变更**）| 写 EEPROM | 调 `SetCurrentLimit` / `SetCurrentLimit_persist` |
| `#SET_PID <node> kp kv ki kd` | 写 EEPROM | （不解析 `&`）| 调 `SetDceKp/Kv/Ki/Kd`，**维持现状**（与 ref 一致）|
| 基类 `SetAcceleration` | `canBuf[4]=0` 不写 | n/a | 保留 |
| 基类 `SetAcceleration_persist` | n/a | `canBuf[4]=persist` | **新增**（ref 有，本期跟进）|
| 基类 `SetCurrentLimit` | `canBuf[4]=0` 不写 | n/a | 保留 |
| 基类 `SetCurrentLimit_persist` | n/a | `canBuf[4]=persist` | **新增**（ref 有，本期跟进）|
| `SetDceKp/Kv/Ki/Kd` | `canBuf[4]=1` 写 | n/a | 保留（与 ref `#SET_PID` 一致）|

**变更要点**：
- **基类新增 2 个变体**：`SetAcceleration_persist(val, persist)` / `SetCurrentLimit_persist(val, persist)`（参考 `firmware/ref_core_f405/.../ctrl_step.hpp:37,40` + `.cpp:113-118,143-150`）
- **ASCII 层解析 `&` 后缀**：`#ACC_J` / `#I_LIMIT_J` handler 检查字符串末尾是否带 `&`，决定走基类还是 `_persist` 变体
- **`#I_LIMIT_J` 默认行为变更**：从「写 EEPROM」改为「不写 EEPROM」（与 `#ACC_J` 对齐 + 与 ref 行为一致）。**电机掉电后电流限制恢复上次 EEPROM 值**，需重新下指令才会保存
- **`#SET_PID` 维持总写 EEPROM**：与 ref 一致，不引入 `&` 解析（ref 的 `#SET_PID` 也不支持 `&`）。修订 #8

**ASCII handler 解析 `&` 的伪代码**（参见 §4.6）：
```cpp
// 解析 #ACC_J 7 100
// 解析 #ACC_J 7 100 &
bool persist = (cmd 末尾有 ' ' + '&' 字符);
if (persist) dummy.motorJ[node]->SetAcceleration_persist(v, true);
else         dummy.motorJ[node]->SetAcceleration(v);
```

---

## 4. 主控固件改动（按文件清单）

### 4.1 `firmware_new/dummy-ref-core-fw/Robot/actuators/ctrl_step/ctrl_step.hpp`

加 6 个方法声明（参考 `firmware/ref_core_f405/.../ctrl_step.hpp:43-46`）：

```cpp
// CAN Query
void QueryDceKp();
void QueryDceKv();
void QueryDceKi();
void QueryDceKd();
void QueryAcceleration();
void QueryCurrentLimit();
```

位置：在现有 `SetDceKd` 声明之后（约 `ctrl_step.hpp:33` 附近），与 `Reboot()`/`GetTemp()`/`EraseConfigs()` 同段。

### 4.2 `firmware_new/.../ctrl_step.cpp`

加 6 个实现（参考 ref `ctrl_step.cpp:155-180`）：

```cpp
void CtrlStepMotor::QueryDceKp()
{
    uint8_t mode = 0x28;
    txHeader.StdId = nodeID << 7 | mode;
    uint8_t buf[8] = {0};
    CanSendMessage(get_can_ctx(hcan), buf, &txHeader);
}
// 同模式：QueryDceKv → 0x29 / QueryDceKi → 0x2A / QueryDceKd → 0x2B
// QueryAcceleration → 0x2C / QueryCurrentLimit → 0x2D
```

### 4.3 `firmware_new/.../dummy_robot.h`

#### 4.3.1 `jointAccRuntime` 索引迁移

```diff
-    float jointAccRuntime[7] = {30.0f, 150.0f, 100.0f, 200.0f, 200.0f, 200.0f, 200.0f};
+    float jointAccRuntime[9] = {0};  // [0]=ALL代理空闲槽, [1..7]=J1~J7/地轨, [8]=夹爪
+    // 索引 1~7 复用 JOINT_ACC_FALLBACK[0..6]（与旧 [0..6] 同语义）：
+    //   [1]=地轨 30, [2]=J1 150, [3]=J2 100, [4..7]=J3~J6 200；[8]=夹爪 30
+    uint32_t jointAccLastUpdateMs[9] = {0};  // [#GETJACC 同步查询用]
+    float jointCurrentLimitRuntime[9] = {0};
+    uint32_t jointCurrentLimitLastUpdateMs[9] = {0};
```

（`jointAccRuntime[9]` 初始值直接复用 `JOINT_ACC_FALLBACK[0..6]` + 夹爪 30，**不需要
`Init()` 单独回填**——回填逻辑由 `SyncAllMotorAcceleration()` 异步触发 0x2C，电机端回包后覆盖。
本字段兜底语义保持，等价于旧版 `jointAccRuntime[7]` 初始值。）

#### 4.3.2 PID 缓存（[1..8]）

```cpp
// [节点 1..6]=J1~J6 / [7]=地轨 / [8]=夹爪；[0]=空闲
int32_t motorDceKps[9] = {0};
int32_t motorDceKvs[9] = {0};
int32_t motorDceKis[9] = {0};
int32_t motorDceKds[9] = {0};
uint8_t  motorPidRcvdCount[9] = {0};  // 4 帧合并用，到 4 置 _pid_print_pending
volatile uint8_t _pid_print_pending[9] = {0};  // OledTask poll 后清 0 + printf
volatile uint8_t _pid_pending_node[9] = {0};
```

#### 4.3.3 方法声明

```cpp
void SyncAllMotorAcceleration();   // 异步触发 8 个 0x2C 查询
void SyncAllMotorCurrentLimit();   // 异步触发 8 个 0x2D 查询（ref 无）
void SyncAllMotorPid();            // 异步触发 8×4 个 PID 查询（ref 无）
void PollPidPrint();               // OledTask 周期调用，print 合并完成的 PID 节点
```

### 4.4 `firmware_new/.../dummy_robot.cpp`

#### 4.4.1 索引迁移影响点（3 处）

**关键约束**：`jointAcc[i]` 必须与 `deltaRails[i]` 同位置（i=0=地轨、i=1~6=J1~J6），
否则 `ComputeSyncSpeeds` 的 `i==0` 地轨分支会取到错误的值（实测方向之一为按
`RAIL_MM_PER_CIRCLE` 折算，`accel[i]` 取错会让地轨用 J1 加速度、J6 用地轨加速度，
MoveJ 同步抵达彻底错位）。**注意 [0] 仍是地轨，不是 J1**——jointAccRuntime
数组下标从 1 开始（[1..7]），但 jointAcc 数组下标从 0 开始（[0..6]）。

```diff
-    float jointAcc[7] = {
-        jointAccRuntime[0], jointAccRuntime[1], jointAccRuntime[2],
-        jointAccRuntime[3], jointAccRuntime[4], jointAccRuntime[5],
-        jointAccRuntime[6],
-    };
+    float jointAcc[7] = {
+        jointAccRuntime[7],  // [0]=地轨（与 deltaRails[0] 对齐，ComputeSyncSpeeds i==0 走 RAIL_MM_PER_CIRCLE 分支）
+        jointAccRuntime[1], jointAccRuntime[2], jointAccRuntime[3],
+        jointAccRuntime[4], jointAccRuntime[5], jointAccRuntime[6],
+    };
```

（位置：`dummy_robot.cpp:218-221`，喂给 `ComputeSyncSpeeds` 的本地数组）

#### 4.4.2 3 个 Sync 方法实现

```cpp
void DummyRobot::SyncAllMotorAcceleration() {
    for (int i = 1; i <= 7; i++) motorJ[i]->QueryAcceleration();
    if (hand) hand->QueryAcceleration();
}
void DummyRobot::SyncAllMotorCurrentLimit() {
    for (int i = 1; i <= 7; i++) motorJ[i]->QueryCurrentLimit();
    if (hand) hand->QueryCurrentLimit();
}
void DummyRobot::SyncAllMotorPid() {
    for (int i = 1; i <= 7; i++) {
        motorJ[i]->QueryDceKp();
        motorJ[i]->QueryDceKv();
        motorJ[i]->QueryDceKi();
        motorJ[i]->QueryDceKd();
    }
    if (hand) {
        hand->QueryDceKp();
        hand->QueryDceKv();
        hand->QueryDceKi();
        hand->QueryDceKd();
    }
}
```

#### 4.4.3 `PollPidPrint()`

```cpp
void DummyRobot::PollPidPrint() {
    for (int idx = 1; idx <= 8; idx++) {
        if (_pid_print_pending[idx]) {
            _pid_print_pending[idx] = 0;
            uint8_t node = _pid_pending_node[idx];
            if (node == 7) {
                printf("ok PID [7] kp=%ld kv=%ld ki=%ld kd=%ld (rail)\r\n",
                       (long)motorDceKps[idx], (long)motorDceKvs[idx],
                       (long)motorDceKis[idx], (long)motorDceKds[idx]);
            } else if (node == 8) {
                printf("ok PID [8] kp=%ld kv=%ld ki=%ld kd=%ld (HAND)\r\n",
                       (long)motorDceKps[idx], (long)motorDceKvs[idx],
                       (long)motorDceKis[idx], (long)motorDceKds[idx]);
            } else {
                printf("ok PID [%u] kp=%ld kv=%ld ki=%ld kd=%ld\r\n", node,
                       (long)motorDceKps[idx], (long)motorDceKvs[idx],
                       (long)motorDceKis[idx], (long)motorDceKds[idx]);
            }
            motorPidRcvdCount[idx] = 0;  // 重置合并
        }
    }
}
```

#### 4.4.4 `Init()` 末尾调一次 `SyncAllMotorAcceleration()`

```cpp
void DummyRobot::Init() {
    // ... 现有初始化 ...
    SyncAllMotorAcceleration();  // 启动后异步回填 jointAccRuntime[1..8]
}
```

### 4.5 `firmware_new/.../can_protocol.cpp`

参考 ref `can_protocol.cpp:64-220`，加 6 个 case + 节点 7/1~6/8 全覆盖：

```cpp
// ── 文件作用域辅助 ──
static inline int _pid_node_to_idx(uint8_t nodeId) {
    if (nodeId == 7) return 7;
    if (nodeId == 8) return 8;
    return (int)nodeId;
}

void OnCanMessage(CAN_context* canCtx, CAN_RxHeaderTypeDef* rxHeader, uint8_t* data)
{
    if (canCtx->handle->Instance == CAN1) {
        uint8_t id = rxHeader->StdId >> 7;
        uint8_t cmd = rxHeader->StdId & 0x7F;

        // 现有 0x23/0x25 处理保留（含 id==8 → dummy.hand 分流）

        // 新增：0x28~0x2D
        switch (cmd) {
            case 0x28: case 0x29: case 0x2A: case 0x2B:
                if (id >= 1 && id <= 8) {
                    int idx = _pid_node_to_idx(id);
                    int32_t val = *(int32_t*)data;
                    if      (cmd == 0x28) dummy.motorDceKps[idx] = val;
                    else if (cmd == 0x29) dummy.motorDceKvs[idx] = val;
                    else if (cmd == 0x2A) dummy.motorDceKis[idx] = val;
                    else                  dummy.motorDceKds[idx] = val;
                    dummy.motorPidRcvdCount[idx]++;
                    if (dummy.motorPidRcvdCount[idx] >= 4) {
                        dummy._pid_print_pending[idx] = 1;
                        dummy._pid_pending_node[idx] = id;
                        dummy.motorPidRcvdCount[idx] = 0;
                    }
                }
                break;
            case 0x2C:
                if (id >= 1 && id <= 8) {
                    int idx = _pid_node_to_idx(id);
                    dummy.jointAccRuntime[idx] = *(float*)data;
                    dummy.jointAccLastUpdateMs[idx] = HAL_GetTick();
                }
                break;
            case 0x2D:
                if (id >= 1 && id <= 8) {
                    int idx = _pid_node_to_idx(id);
                    dummy.jointCurrentLimitRuntime[idx] = *(float*)data;
                    dummy.jointCurrentLimitLastUpdateMs[idx] = HAL_GetTick();
                }
                break;
            default: break;
        }
    }
}
```

**注意**：`id==8` (夹爪) 走 `dummy.hand->*` 现有逻辑；0x28~0x2D 都走 `dummy.*` 字段（无需 hand 专用字段，因为 `jointAccRuntime[8]` / `motorDceKps[8]` 等是 DummyRobot 层面的缓存）。

### 4.6 `firmware_new/.../ascii_protocol.cpp`

#### 4.6.1 `OnUsbAsciiCmd` 加 7 条 `#` 命令

按顺序加在现有 `#CMDMODE` 分支之前（约 `ascii_protocol.cpp:251`）：

```cpp
else if (s.find("SET_PID") != std::string::npos)
{
    uint32_t node, kp, kv, ki, kd;
    sscanf(_cmd, "#SET_PID %lu %lu %lu %lu %lu", &node, &kp, &kv, &ki, &kd);
    if (node >= 1 && node <= 7) {
        dummy.motorJ[node]->SetDceKp(kp);
        dummy.motorJ[node]->SetDceKv(kv);
        dummy.motorJ[node]->SetDceKi(ki);
        dummy.motorJ[node]->SetDceKd(kd);
        Respond(_responseChannel, "ok SET PID [%lu] kp=%lu kv=%lu ki=%lu kd=%lu", node, kp, kv, ki, kd);
    } else if (node == 8) {
        dummy.hand->SetDceKp(kp);
        dummy.hand->SetDceKv(kv);
        dummy.hand->SetDceKi(ki);
        dummy.hand->SetDceKd(kd);
        Respond(_responseChannel, "ok SET PID [8] kp=%lu kv=%lu ki=%lu kd=%lu (HAND)", kp, kv, ki, kd);
    } else {
        Respond(_responseChannel, "error SET PID [%lu] wrong (use 7=rail, 1~6=joints, 8=hand, 0=ALL not allowed)", node);
    }
}
else if (s.find("GET_PID") != std::string::npos)
{
    uint32_t node;
    sscanf(_cmd, "#GET_PID %lu", &node);
    if (node == 0) {
        // [改进] ALL 广播查询：8 节点分 8 行打印（ref 漏）
        for (int i = 1; i <= 7; i++) {
            dummy.motorJ[i]->QueryDceKp();
            dummy.motorJ[i]->QueryDceKv();
            dummy.motorJ[i]->QueryDceKi();
            dummy.motorJ[i]->QueryDceKd();
        }
        dummy.hand->QueryDceKp();
        dummy.hand->QueryDceKv();
        dummy.hand->QueryDceKi();
        dummy.hand->QueryDceKd();
        Respond(_responseChannel, "ok GET_PID ALL dispatched (8 nodes × 4 = 32 frames; results printed by OledTask PollPidPrint in 1-2 s)");
    } else if (node >= 1 && node <= 8) {
        int idx = (node == 7) ? 7 : (node == 8) ? 8 : (int)node;
        uint32_t t0 = HAL_GetTick();
        if (node == 8) {
            dummy.hand->QueryDceKp(); dummy.hand->QueryDceKv();
            dummy.hand->QueryDceKi(); dummy.hand->QueryDceKd();
        } else {
            dummy.motorJ[node]->QueryDceKp(); dummy.motorJ[node]->QueryDceKv();
            dummy.motorJ[node]->QueryDceKi(); dummy.motorJ[node]->QueryDceKd();
        }
        // 30ms 超时同步等（改进点）
        uint32_t waited = 0;
        while (dummy.motorPidRcvdCount[idx] < 4 && waited < 30) {
            osDelay(1); waited++;
        }
        if (dummy.motorPidRcvdCount[idx] >= 4) {
            Respond(_responseChannel, "ok PID [%lu] kp=%ld kv=%ld ki=%ld kd=%ld%s",
                    node, (long)dummy.motorDceKps[idx], (long)dummy.motorDceKvs[idx],
                    (long)dummy.motorDceKis[idx], (long)dummy.motorDceKds[idx],
                    node == 8 ? " (HAND)" : (node == 7 ? " (rail)" : ""));
            dummy.motorPidRcvdCount[idx] = 0;
        } else {
            uint8_t got = dummy.motorPidRcvdCount[idx];
            Respond(_responseChannel, "error GET_PID [%lu] timeout (got %u/4, %lu ms)", node, got, waited);
        }
    } else {
        Respond(_responseChannel, "error GET_PID [%lu] wrong (use 7=rail, 1~6=joints, 8=hand, 0=ALL)", node);
    }
}
else if (s.find("GETJACC") != std::string::npos)
{
    uint32_t node;
    sscanf(_cmd, "#GETJACC %lu", &node);
    if (node == 0) {
        dummy.SyncAllMotorAcceleration();
        Respond(_responseChannel, "ok GETJACC ALL dispatched (8 nodes; results printed by OledTask in <100 ms)");
    } else if (node >= 1 && node <= 8) {
        int idx = (node == 7) ? 7 : (node == 8) ? 8 : (int)node;
        uint32_t old_ms = dummy.jointAccLastUpdateMs[idx];
        if (node == 8) dummy.hand->QueryAcceleration();
        else           dummy.motorJ[node]->QueryAcceleration();
        uint32_t waited = 0;
        while (dummy.jointAccLastUpdateMs[idx] == old_ms && waited < 30) {
            osDelay(1); waited++;
        }
        if (dummy.jointAccLastUpdateMs[idx] != old_ms) {
            Respond(_responseChannel, "ok ACC [%lu] = %.2f r/s^2%s", node, dummy.jointAccRuntime[idx],
                    node == 8 ? " (HAND)" : (node == 7 ? " (rail)" : ""));
        } else {
            Respond(_responseChannel, "error GETJACC [%lu] timeout (%lu ms)", node, waited);
        }
    } else {
        Respond(_responseChannel, "error GETJACC [%lu] wrong", node);
    }
}
else if (s.find("GETI") != std::string::npos)  // ⚠️ 必须放 ACC_J 之后（防止 ACC_J 子串抢先）
{
    uint32_t node;
    sscanf(_cmd, "#GETI %lu", &node);
    if (node == 0) {
        dummy.SyncAllMotorCurrentLimit();
        Respond(_responseChannel, "ok GETI ALL dispatched (8 nodes, async)");
    } else if (node >= 1 && node <= 8) {
        int idx = (node == 7) ? 7 : (node == 8) ? 8 : (int)node;
        uint32_t old_ms = dummy.jointCurrentLimitLastUpdateMs[idx];
        if (node == 8) dummy.hand->QueryCurrentLimit();
        else           dummy.motorJ[node]->QueryCurrentLimit();
        uint32_t waited = 0;
        while (dummy.jointCurrentLimitLastUpdateMs[idx] == old_ms && waited < 30) {
            osDelay(1); waited++;
        }
        if (dummy.jointCurrentLimitLastUpdateMs[idx] != old_ms) {
            Respond(_responseChannel, "ok I_LIMIT [%lu] = %.2f A%s", node, dummy.jointCurrentLimitRuntime[idx],
                    node == 8 ? " (HAND)" : (node == 7 ? " (rail)" : ""));
        } else {
            Respond(_responseChannel, "error GETI [%lu] timeout (%lu ms)", node, waited);
        }
    } else {
        Respond(_responseChannel, "error GETI [%lu] wrong", node);
    }
}
// 末尾兜底（已删除 3 条 #SYNC_ACC / #SYNC_I / #SYNC_PID，ALL 模式替代，见修订 #6）
```

#### 4.6.2 `OnUart4AsciiCmd` 查询类延后处理（本期不做）

> **用户决策（2026-10-03 21:20）**：UART4 通道的查询类（`#GET_PID` / `#GETJACC` / `#GETI`）**延后到「最后一步」**单独实施。
> 本期不修改 `OnUart4AsciiCmd` 任何代码，**UART4 行为保持现状**（只能 `!STOP/START/HOME/CALIBRATION/RESET/DISABLE` + `!HAND_O/C/POS/I` + `#GETJPOS/GETRAILPOS/GETLPOS/CMDMODE`）。
> 
> **延后原因**：
> 1. 无线通道可能有延迟/带宽限制，30ms 超时可能不够（ref 验证过 CAN 1~5ms OK，无线未知）
> 2. 本期先在 USB 通道上把功能跑通，再考虑 UART4（避免分散测试精力）
> 3. 现有 UART4 的 8 条 `!HAND_*` 配置类已 forbidden，新查询类按同样模式 forbidden 即可（实现简单）
> 
> **延后实施时的扩展位**（参考，预留）：
> ```cpp
> // 未来在 OnUart4AsciiCmd 的 # 分支加：
> else if (s.find("GET_PID") != std::string::npos)
>     /* 同步等 30ms 复用 USB 逻辑，但若无线延迟高需调大到 100ms */;
> // 设置类保持 forbidden：
> else if (s.find("SET_DCE_K") != std::string::npos || s.find("I_LIMIT_J") != std::string::npos ||
>          s.find("ACC_J") != std::string::npos || s.find("REBOOT") != std::string::npos ||
>          s.find("SET_PID") != std::string::npos)
>     Respond(_responseChannel, "error forbidden on UART4");
> ```

#### 4.6.3 顺序匹配陷阱（必读）

⚠️ 字符串匹配顺序必须保证**长前缀在前**（防子串抢先匹配）：

| 顺序 | 命令 | 防谁抢先 |
|---|---|---|
| 1 | `GET_PID` | — |
| 2 | `SET_PID` | 防 `#SET_PID 1 100 80 200 250` 被 `SET_DCE_KP` 子串匹配到 |
| 3 | `SET_DCE_KP` / `SET_DCE_KV` / `SET_DCE_KI` / `SET_DCE_KD` | — |
| 4 | `GETJACC` | — |
| 5 | `GETI` | 必须放 `ACC_J` 分支**之前**，否则 `#GETI 1` 会被 `ACC_J` 抢先匹配 |
| 6 | `ACC_J` | — |
| 7 | `I_LIMIT_J` | — |

> **#SYNC_* 已删除**（修订 #6），原陷阱表第 8 行不再需要；ref 的 `SYNC_ACC 必须放 ACC_J 之前` 注释随之失效，本方案不再沿用。

### 4.7 `main.cpp` (OledTask) 加一行 `PollPidPrint`

```cpp
// 现有 OledTask 周期内（20ms 一帧）
dummy.PollPidPrint();  // 周期处理 4 帧合并完成的 PID 节点（#GET_PID 0 ALL 模式 32 帧必须走此路径）
```

**位置**：`firmware_new/dummy-ref-core-fw/UserApp/main.cpp` 的 OledTask 函数体（约 OLED 刷新代码附近）。

### 4.9 `firmware_new/.../dummy_robot.h` 字段类型：`volatile`

```cpp
volatile uint8_t _pid_print_pending[9] = {0};  // ISR 写，OledTask 读
volatile uint8_t _pid_pending_node[9] = {0};
```

（参考 ref `can_protocol.cpp:34-35`）

---

## 5. 上位机改动（`串口助手_old.py`）

### 5.1 新增「查询电机参数」面板

位置：在 `joint_nb`（关节控制 Notebook）右侧或下方，加 1 个 `LabelFrame`：

```python
def _build_query_panel(self, parent):
    """电机参数查询面板（读取 PID / ACC / I_LIMIT）"""
    f = ttk.LabelFrame(parent, text="电机参数查询（读取 EEPROM 实际值）", padding=6)
    f.pack(fill=tk.X, pady=6)

    # 节点下拉框
    top = ttk.Frame(f); top.pack(fill=tk.X)
    ttk.Label(top, text="节点:", font=("Arial", 10, "bold")).pack(side=tk.LEFT)
    self.qry_node = tk.IntVar(value=1)
    cb = ttk.Combobox(top, textvariable=self.qry_node, width=4, state="readonly",
                       values=[0, 1, 2, 3, 4, 5, 6, 7, 8])  # 0=ALL
    cb.pack(side=tk.LEFT, padx=4)

    # 3 个读取按钮 + 1 个「全部读取」
    btn_f = ttk.Frame(f); btn_f.pack(fill=tk.X, pady=4)
    ttk.Button(btn_f, text="读取 PID", command=self._qry_pid).pack(side=tk.LEFT, padx=2)
    ttk.Button(btn_f, text="读取 ACC", command=self._qry_acc).pack(side=tk.LEFT, padx=2)
    ttk.Button(btn_f, text="读取 I_LIMIT", command=self._qry_i).pack(side=tk.LEFT, padx=2)
    ttk.Button(btn_f, text="全部读取(8 节点)", command=self._qry_all).pack(side=tk.LEFT, padx=2)

    # 显示框
    self.qry_text = tk.Text(f, height=8, font=("Consolas", 9))
    self.qry_text.pack(fill=tk.BOTH, expand=True)

def _qry_pid(self): self.send_cmd(f"#GET_PID {self.qry_node.get()}")
def _qry_acc(self): self.send_cmd(f"#GETJACC {self.qry_node.get()}")
def _qry_i(self):   self.send_cmd(f"#GETI {self.qry_node.get()}")
def _qry_all(self):
    """全部读取：触发 3 条 ALL 模式查询（#GET_PID/GETJACC/GETI 0），等 OledTask PollPidPrint 周期打印回包"""
    self.send_cmd("#GET_PID 0")    # ALL: 8 节点 × 4 帧 = 32 帧 PID
    self.send_cmd("#GETJACC 0")    # ALL: 8 节点 0x2C
    self.send_cmd("#GETI 0")       # ALL: 8 节点 0x2D
    self.qry_text.insert("end", "全部读取已触发（3 条 ALL 命令），1~2 秒后 OledTask 周期打印 8×3 = 24 行...\n")
```

### 5.2 RX handler 加 3 种回包格式识别

在 `_handle_rx_line` 里加：

```python
# ok PID [node] kp=... kv=... ki=... kd=...
# ok ACC [node] = ... r/s^2
# ok I_LIMIT [node] = ... A
# ok SYNC_* dispatched
m = re.match(r'ok PID \[(\d+)\] kp=(-?\d+) kv=(-?\d+) ki=(-?\d+) kd=(-?\d+)', line)
if m:
    self.root.after(0, self._append_qry, line)
m = re.match(r'ok ACC \[(\d+)\] = ([\d.]+) r/s\^2', line)
if m:
    self.root.after(0, self._append_qry, line)
m = re.match(r'ok I_LIMIT \[(\d+)\] = ([\d.]+) A', line)
if m:
    self.root.after(0, self._append_qry, line)

def _append_qry(self, line):
    self.qry_text.insert("end", line + "\n")
    self.qry_text.see("end")
```

### 5.3 不修改 `串口助手.py`

按项目规则（PROJECT_GUIDANCE §4.5）。

---

## 6. 风险点

| 风险 | 缓解 |
|---|---|
| `jointAccRuntime[7]` → `[9]` 索引迁移影响 `dummy_robot.cpp:218-222` 3 行 | 仅把 `jointAccRuntime[X]` 的下标从 `[0..6]` 改为 `[7,1..6]`（保留 i=0=地轨对齐 `deltaRails[0]`），单独一次 diff；编译报错即可发现 |
| `can_protocol.cpp` 不处理 0x28~0x2D 会让电机回包被 ISR `default: break` 吞掉（无功能影响，但回包丢了） | 新增 6 个 case 即可 |
| `OledTask` 加 `PollPidPrint()` 增加主任务负担（仅 `#GET_PID 0` ALL 模式需要）| 每帧 8 次位检查 + 最坏 1 次 printf，< 50 µs；OledTask 本就跑 20ms 周期 |
| 0x2C/0x2D 同步查询 30ms 超时阻塞 ASCII handler（仅单节点）| `osDelay(1)` + 计数器轮询，已在 ref 验证可行；ALL 模式不走这条路 |
| `motorDceKps[9]` 缓存 ISR 写入、ASCII 主任务读取数据竞争 | 用 `volatile` 修饰，与 ref 一致 |
| `node==0` ALL 模式回包量大（8×4=32 帧 PID 合并 + 8 帧 ACC + 8 帧 I）| 不在 ASCII handler 同步等——ASCII 层只 `Respond "ok ALL dispatched"`，由 OledTask 周期 PollPidPrint 分行打印（不阻塞）；总回包时间 1~2 秒（20ms × 8 节点 × 4 帧 = 640ms 上限）|
| `#GET_PID 0` 触发 32 帧让 CAN 总线短期拥塞 | 一次 32 帧突发：32 × 135 bit / 500 kbps = 8.6 ms 总线占用；ASCII handler 立刻返回（不阻塞），回包由 ISR 处理；**本期先实测一次性发 32 帧**，后续如需可在 `SyncAllMotorPid()` 内加 `osDelay(1)` 间隔（总线更平稳，~160ms 全部回包完）|
| ALL 模式 ASCII 回包量大（8×3=24 行 × 50 字节 = 1200 字节）| 115200 波特率下 104ms 串口时间；每行 64 字符内，STM32 `Respond` buffer 够用；RTOS 串口有互斥锁，OledTask printf 与 ASCII Respond 不会交错 |
| `串口助手_old.py` 的 `qry_text` Text widget 在多线程更新可能闪烁 | 用 `root.after(0, ...)` 异步追加（与现有 RX 处理一致）|

---

## 7. 验收清单

### 7.1 编译通过

- [ ] `firmware_new/dummy-ref-core-fw` Ninja 构建通过（FLASH 不应超 35%）
- [ ] `firmware_new/dummy-motor-fw` 0 改动（不动电机端）
- [ ] `串口助手_old.py` 语法检查通过（`python -m py_compile`）

### 7.2 功能正确性

#### 基类
- [ ] `QueryDceKp()` 发 0x28 帧
- [ ] `QueryDceKv()` 发 0x29
- [ ] `QueryDceKi()` 发 0x2A
- [ ] `QueryDceKd()` 发 0x2B
- [ ] `QueryAcceleration()` 发 0x2C
- [ ] `QueryCurrentLimit()` 发 0x2D

#### can_protocol 回包
- [ ] 0x28~0x2B 回包更新 `motorDceKps/Kvs/Kis/Kds[idx]`，4 帧合并置 `_pid_print_pending[idx]`
- [ ] 0x2C 回包更新 `jointAccRuntime[idx]` + `jointAccLastUpdateMs[idx]`
- [ ] 0x2D 回包更新 `jointCurrentLimitRuntime[idx]` + `jointCurrentLimitLastUpdateMs[idx]`
- [ ] 节点 1~6 / 7（地轨）/ 8（夹爪）全覆盖

#### DummyRobot
- [ ] `jointAccRuntime[9]` 索引 [1..7] + [8]=hand 全部填充
- [ ] `jointAccLastUpdateMs[9]` 与 ACC 回包同步更新
- [ ] `SyncAllMotorAcceleration()` / `SyncAllMotorCurrentLimit()` / `SyncAllMotorPid()` 实现正确
- [ ] `PollPidPrint()` 在 OledTask 周期被调用，PID 合并 4 帧完成后 printf

#### ASCII 命令
- [ ] `#SET_PID 1 1000 80 200 250` 设 J1 PID 4 个值（写 EEPROM）
- [ ] `#GET_PID 1` 30ms 内回 `ok PID [1] kp=1000 kv=80 ki=200 kd=250`
- [ ] `#GET_PID 8` 30ms 内回 `ok PID [8] ... (HAND)`
- [ ] `#GET_PID 0` 回 `ok GET_PID ALL dispatched`（异步触发 8 节点）
- [ ] `#GETJACC 1` 30ms 内回 `ok ACC [1] = 150.00 r/s^2`
- [ ] `#GETI 1` 30ms 内回 `ok I_LIMIT [1] = 2.00 A`
- [ ] `#GET_PID 0` 回 `ok GET_PID ALL dispatched`（异步触发 8 节点 32 帧）；1~2 秒内通过 OledTask `PollPidPrint` 看到 8 行 `ok PID [1..8] ...`
- [ ] `#GETJACC 0` 回 `ok GETJACC ALL dispatched`（异步触发 8 个 0x2C）；< 100ms 内 OledTask 周期看到 8 行 `ok ACC [1..8] ...`
- [ ] `#GETI 0` 回 `ok GETI ALL dispatched`（异步触发 8 个 0x2D）；< 100ms 内 OledTask 周期看到 8 行 `ok I_LIMIT [1..8] ...`
- [ ] `#GET_PID 999` 回 `error GET_PID [999] wrong`
- [ ] 丢 1 帧场景：`#GET_PID 1` 后拔掉 CAN 线，回 `error GET_PID [1] timeout (got 2/4, 30 ms)`
- [ ] `#SYNC_ACC` / `#SYNC_I` / `#SYNC_PID` 敲任意一条回 `error unknown cmd`（已删除，验证 ASCII handler 行为）

#### UART4 通道
- [ ] UART4 发 `#GETJPOS` / `#GETLPOS` / `#GETRAILPOS` 行为不变
- [ ] UART4 发 `#GET_PID 1` / `#GETJACC 1` / `#GETI 1` 回与现状一致（**本期不做 UART4 查询类，行为应等同 #CMDMODE 兜底 OK**）
- [ ] UART4 发 `#SET_PID` / `#SET_DCE_K*` / `#I_LIMIT_J` / `#ACC_J` / `#REBOOT` 行为现状不变（兜底 OK）

#### 串口助手 UI
- [ ] 「查询电机参数」面板出现，节点下拉 0~8 默认 1
- [ ] 「读取 PID」按钮发 `#GET_PID <node>`，回包填到 Text widget
- [ ] 「全部读取」按钮发 3 条 `#SYNC_*`，1~2 秒后 Text widget 填满 8×3 = 24 行
- [ ] 节点 = 0 时显示 `ALL dispatched` 提示

### 7.3 回归测试

- [ ] Step 6 夹爪 `!HAND_POS 0/6/50/100` 行为不变
- [ ] Step 4 `#SET_DCE_K* 1~8` / `#I_LIMIT_J 1~8` / `#ACC_J 1~8` / `#REBOOT 1~8 + 0=ALL` 行为不变
- [ ] Step 3 `!HAND_O/C/POS/I/VEL/ACC/KP/KV/KI/KD/ONBOOT/ERASE` 行为不变
- [ ] `#GETJPOS` 7 值（Rail 在第 7 位）行为不变
- [ ] `#GETLPOS` 6 值行为不变
- [ ] MoveJ / MoveL 行为不变

### 7.4 资源占用

- [ ] FLASH 占用 < 36%（Step 6 后 34.91%；本次预计 +1.0%）
- [ ] RAM 占用 < 38%（Step 6 后 35.52%）

---

## 8. 决策表

| # | 决策项 | 用户确认 | 备注 |
|---|---|---|---|
| 1 | 范围：基类 6 个 Query + can_protocol 6 case + DummyRobot 字段 + **4 条 ASCII（去 #SYNC_*）** + UI | ✅ 2026-10-03 21:20 | §1.3（命令 7→4 条）|
| 2 | 不做 `SetAcceleration_persist` / `SetCurrentLimit_persist` | ✅ 2026-10-03 21:20 | 修订 #3 |
| 3 | `jointAccRuntime[7]` → `[9]` 索引迁移 | ✅ 2026-10-03 21:20 | §3.4，影响 `dummy_robot.cpp:218-222` |
| 4 | `#GET_PID` 30ms 超时 + 帧数诊断 | ✅ 2026-10-03 21:20 | §3.1 |
| 5 | `#GET_PID` / `#GETJACC` / `#GETI` 支持 `node==0` ALL | ✅ 2026-10-03 21:20 | §3.2，串口 64 字符够用 / CAN 8.6ms 不拥塞 |
| 6 | **不新增** `#SYNC_ACC` / `#SYNC_I` / `#SYNC_PID`（包括 ref 的 `#SYNC_ACC`）| ✅ 2026-10-03 21:20 | §3.3 改写：ALL 模式替代，DummyRobot `SyncAll*` 方法保留为内部实现 |
| 7 | UART4 开放查询类（`#GET_*`），不开放设置类 | ⏸ 2026-10-03 21:20 延后到「最后一步」| §4.6.2 标记延后；本期不写 UART4 任何代码 |
| 8 | `串口助手_old.py` 新增查询面板（不改 `串口助手.py`）| ✅ 2026-10-03 21:20 | §5 |
| 9 | `OledTask` 加 `PollPidPrint()` 一行调用 | ✅ 2026-10-03 21:20 | §4.7，理由改为「`#GET_PID 0` ALL 模式 32 帧合并必须」|
| 10 | PID 维持总写 EEPROM（不加 _persist 变体）| ✅ 2026-10-04 09:45 | 修订 #8 |
| 11 | `#ACC_J` / `#I_LIMIT_J` 加 `&` 解析，默认不写 EEPROM（方案 A1）| ✅ 2026-10-04 09:45 | 修订 #9；行为变更 |
| 12 | `#GET_PID` 改用 `motorPidLastUpdateMs` 时间戳模式 | ✅ 2026-10-04 09:45 | 修订 #10 |
| 13 | `#GET_PID` 等待 30ms → 10ms | ✅ 2026-10-04 09:45 | 修订 #11；不动 `#GETJACC`/`#GETI` |
| 14 | `SyncAllMotorPid` 帧间加 `osDelay(1)` 错峰 | ✅ 2026-10-04 09:45 | 修订 #12 |

---

## 附录 A：API 速查表（最终态）

### ASCII `#` 命令全集（本期完成后）

| 命令 | 范围 | 写 EEPROM？| UART4？|
|---|---|---|---|
| `#GETJPOS` | — | n/a | ✅ |
| `#GETLPOS` | — | n/a | ✅ |
| `#GETRAILPOS` | — | n/a | ✅ |
| `#SET_DCE_KP/KV/KI/KD` | 1~8 | ✅ | ❌ |
| `#SET_PID` | 1~8 | ✅ | ❌ |
| `#I_LIMIT_J` | 1~8 | ✅（基类默认）| ❌ |
| `#ACC_J` | 1~8 | ❌ | ❌ |
| `#GET_PID` | 1~8 + 0=ALL | n/a | ✅（UART4 延后）|
| `#GETJACC` | 1~8 + 0=ALL | n/a | ✅（UART4 延后）|
| `#GETI` | 1~8 + 0=ALL | n/a | ✅（UART4 延后）|
| ~~`#SYNC_ACC`~~ | — | n/a | ❌ 删除（ALL 替代）|
| ~~`#SYNC_I`~~ | — | n/a | ❌ 删除（ALL 替代）|
| ~~`#SYNC_PID`~~ | — | n/a | ❌ 删除（ALL 替代）|
| `#REBOOT` | 1~8 + 0 | n/a | ✅ |
| `#CMDMODE` | — | n/a | ✅ |

### `CtrlStepMotor` 基类新增方法

| 方法 | CAN 命令 | 说明 |
|---|---|---|
| `QueryDceKp()` | 0x28 | 触发电机回包 Kp（int32_t，4 字节）|
| `QueryDceKv()` | 0x29 | 同上 |
| `QueryDceKi()` | 0x2A | 同上 |
| `QueryDceKd()` | 0x2B | 同上 |
| `QueryAcceleration()` | 0x2C | 触发电机回包 ACC（float，4 字节）|
| `QueryCurrentLimit()` | 0x2D | 同上 |

### `DummyRobot` 新增字段

| 字段 | 类型 | 索引 | 说明 |
|---|---|---|---|
| `jointAccRuntime[9]` | `float` | [1..7]+[8] | 0x2C 回包缓存 |
| `jointAccLastUpdateMs[9]` | `uint32_t` | [1..7]+[8] | 0x2C 时间戳 |
| `jointCurrentLimitRuntime[9]` | `float` | [1..7]+[8] | 0x2D 回包缓存 |
| `jointCurrentLimitLastUpdateMs[9]` | `uint32_t` | [1..7]+[8] | 0x2D 时间戳 |
| `motorDceKps[9]` | `int32_t` | [1..7]+[8] | 0x28 回包 |
| `motorDceKvs[9]` | `int32_t` | [1..7]+[8] | 0x29 回包 |
| `motorDceKis[9]` | `int32_t` | [1..7]+[8] | 0x2A 回包 |
| `motorDceKds[9]` | `int32_t` | [1..7]+[8] | 0x2B 回包 |
| `motorPidRcvdCount[9]` | `uint8_t` | [1..7]+[8] | 4 帧合并计数器 |
| `_pid_print_pending[9]` | `volatile uint8_t` | [1..7]+[8] | OledTask poll 标志 |
| `_pid_pending_node[9]` | `volatile uint8_t` | [1..7]+[8] | 触发合并的节点 ID |

### `DummyRobot` 新增方法

| 方法 | 说明 |
|---|---|
| `SyncAllMotorAcceleration()` | 异步触发 8 个 0x2C |
| `SyncAllMotorCurrentLimit()` | 异步触发 8 个 0x2D |
| `SyncAllMotorPid()` | 异步触发 8×4 = 32 个 PID 查询 |
| `PollPidPrint()` | OledTask 周期调用，print 合并完成的 PID 节点 |

---

## 附录 B：相关参考文件

| 文件 | 引用目的 |
|---|---|
| `firmware/ref_core_f405/.../ctrl_step.hpp:43-46` | Query 方法签名参考 |
| `firmware/ref_core_f405/.../ctrl_step.cpp:155-180` | Query 实现参考 |
| `firmware/ref_core_f405/.../dummy_robot.h:170-195` | 字段命名/类型参考 |
| `firmware/ref_core_f405/.../dummy_robot.h:212` | `SyncAllMotorAcceleration()` 命名参考 |
| `firmware/ref_core_f405/.../can_protocol.cpp:36-220` | 0x28~0x2D 回包路由参考 |
| `firmware/ref_core_f405/.../ascii_protocol.cpp:534-810` | `#GET_PID #GETJACC #GETI #SET_PID #ACC_J #I_LIMIT_J` 实现参考（**不参考** `#SYNC_ACC` 及其顺序匹配注释）|
| `firmware_new/.../dummy-motor-fw/UserApp/protocols/interface_can.cpp:264-320` | 电机端 0x28~0x2D 回包响应（已就绪，本次不动）|
| `firmware_new/.../ascii_protocol.cpp:131-250` | Step 4 落地的 `#SET_DCE_K* #I_LIMIT_J #ACC_J #REBOOT`（已就绪）|
| `firmware_new/.../ascii_protocol.cpp:251` | `#CMDMODE` 分支位置（新增命令插入点）|
| `firmware_new/.../can_protocol.cpp:23` | 现有 `id==8` → `dummy.hand->` 分流模式 |
| `firmware_new/.../dummy_robot.cpp:218-221` | 索引迁移影响点 |
| `firmware_new/.../dummy_robot.h:142` | `jointAccRuntime[7]` 旧声明 |
| `docs\handcode夹爪实现对比与迁移方案.md` 附录 B | Step 4 设置端实施记录 |

---

> 文档版本：v1（2026-10-03 编制）
> 待用户确认 9 项决策（§8）后开干
