Liu3Beng-A/Dummy/docs/堵转保护与自动回退及校准方案.md

# 堵转保护、自动回退与 CALIBRATION 方案

## 当前默认：J7/J8采用用户最终实测参数（2026-10-07）

用户反馈校准、保存以及随后START/HOME/RESET测试没有问题，明确要求将20:04最后CAL_GET7/8回读的整组值写为固件默认。此次速度、加速度、退让与重复容差也发生变化，并非前轮建议的单变量验证；仅记录整组实测通过，不把成功单独归因于POSITION_TOL_R。最终参数以第13.3节表格为准；下方此前150ms/30%共享等描述保留为历史轮次记录。

只更新电机`UserApp/protection_config.cpp`的J7/J8校准默认及`串口助手_old.py`未回读编辑初值；普通堵转参数、PID、总电流上限、J1～J6默认、CAN/EEPROM格式及STOP/校准状态机保持已有实现。CAL_CURRENT_A仍不超过节点当前总电流限制：J7=min(2.5A,总限流)、J8=min(1A,总限流)，这保留原整组参数合法性约束，不提升总限流。有效EEPROM记录仍优先，烧录不自动迁移或覆盖旧参数；校准成功自动保存当前整组参数及坐标。

接触仍按电流命令/实际速度/跟随误差三条件连续100ms判断；参考结束后的有限确认窗口为1000+100=1100ms。到位仍使用真实编码器、配置容差与连续50ms稳定窗口，未改严格判稳。J7 REPEAT_TOL_R=.05圈=.25mm、POSITION_TOL_R=.005圈=.025mm；J8分别.1圈=2.25模型开度、.01圈=.225模型开度，不作为毫米描述。BACKOFF_R对应J7 5mm、J8 11.25模型开度。退让仍共用RETOUCH_TIMEOUT_MS=5000，错误名RETURN_TIMEOUT的已记录问题未在本轮扩展修改；当前实机通过不代表该命名已修正。

## 当前修复：校准接触确认预留独立收敛时间（2026-10-07）

用户已授权实施。18:50夹爪复触失败点连续候选107.25ms未满150ms；18:58改为100ms后实际need已生效，但连续候选69.15ms、阶段峰值75.6ms仍不足，且此前速度条件失效导致清零。旧期限随TRIGGER同步缩短，使等待实际收敛的余量没有增加。源码与冻结记录证明期限在有效候选完成前终止；并不证明所有速度波动的唯一机械原因。

电机`Ctrl/Motor/stall_protection.cpp`只调整CAL_SEEK/CAL_RETOUCH参考停止后的有限确认期限为**1000ms独立收敛余量 + CAL_TRIGGER_MS**。TRIGGER100时为1100ms，默认150时为1150ms；收敛余量为代码固定值，本轮不新增串口/CAN参数或EEPROM字段。它是参考停止后的最长等待，不是强制延迟，也不保证一定形成连续证据。三个条件连续达到配置时长立即接受接触，随后仍需减速、实际50ms稳定、复触点一致性和实际返回到位；不得把规划器到达当作接触成功。

参考位置固定于原目标，不增加搜索行程；电流/速度/误差阈值、滤波、启动豁免与间歇条件清零不改变。候选重计不刷新期限，完全没有接触或不断出现短候选仍有限报CONTACT_NOT_CONFIRMED。阶段总超时、实际编码器最大行程、反馈/租约保护、STOP/DISABLE打断继续有效，先触发的保护结束本阶段。确认期限只在CAL搜索参考结束后使用，普通MOVEJ、同步规划、普通堵转回退不改。

真实生产电机代码离线复现旧期限在约69.2ms/100ms候选时抢先失败；修复后同一受控输入在参考停止后430.85ms连续满100ms时即接受。输入依据日志计时设计，不是重建实机完整波形。覆盖J7/J8、寻端/复触、20/100/150/2000ms触发时间、反复短候选、无接触、实际越界、总超时、反馈失效和STOP/DISABLE；原完整校准、普通保护与主控并行/取消/保存回归也通过。四电机Ninja通过，主控无新源码改动且Ninja无待构建工作；产物与完整校验记录见SESSION_STATUS当前首节。实机复触、返回与全轮保存仍待用户烧录验证。

本节覆盖下文旧450ms确认期限。退让共用复触超时及RETURN_TIMEOUT含义问题继续单独记录，不包含在此次修改内。

## 当前修复：校准搜索边界与失败取证（2026-10-07）

用户已授权实施。CAL_SEEK/CAL_RETOUCH仅把内部参考约束于已经计算好的有界目标，触及终点即清该内部规划器的位置/速度积分并固定参考；实际编码器最大行程独立检查，接触判据、方向、预计限位窗口、退让/复触一致性、返回实际到位及STOP优先级保留。普通共享规划器与同步运动不修改。六轴坐标确认后一秒并行J7/J8、全部成功后自动失能保存、校准/保存时START busy不挂起的已确认决策继续有效。

该轮参考到终点后的接触证明窗口原为CAL_STARTUP_MS + CAL_TRIGGER_MS + 5×(CURRENT_FILTER_MS+SPEED_FILTER_MS) + 50ms，默认450ms；现已由上节的1000ms独立收敛余量 + CAL_TRIGGER_MS替代，阶段超时仍有效。不把规划到达当成功；无接触证据明确CONTACT_NOT_CONFIRMED，实际越界或计算目标溢出仍SEARCH_TRAVEL。失败取消整轮并停止同伴，不保存不完整校准。新增原因号26，不重排旧原因号。

### CAL_STATUS 数据和生命周期

`#CAL_STATUS 7`/`8`读取本次LIVE，`#CAL_STATUS 7 LAST`/`8 LAST`读取首次失败冻结记录。独立RAM记录在失败处理/转普通保护/取消前冻结；STOP、START、DISABLE及其他动作不覆盖，下一次新的CAL_BEGIN被节点实际接受或重启才清除。重复BEGIN或同request重试幂等；新request取新LIVE，LAST保持首次故障。无记录返回no_failure_record。成功校准无失败时LAST仍无记录；并行同伴取消的记录会显示CANCELLED_STOP等，不能把它当独立接触失败。取证前不要重新CAL或断电。普通STALL LAST记录另行保留，不因CAL诊断覆盖。

输出包括mode/reqmode、故障前phase/任务/门禁、运动意图、有效反馈/使能/接触检测是否活动、I_cmd/I_filt/I_thr及实际命令限流I_cap、v_raw/v_filt/v_thr、参考跟随误差及阈值、候选连续时间/所需时间/该子阶段最长连续时间、最近一次非零候选被清零的原因和位掩码、实际和参考相对搜索起点的电机圈数、max_travel、参考速度、失败原因。unmet为1电流命令不足、2实际估计速度过高、4误差不足，可相加；clear=CONDITIONS的detail同该掩码。门禁失效清零时detail为门禁号，不能按条件位解读。候选0不意味着从未接触，看peak/last/clear；条件不连续不能累加。阶段间重置该阶段统计，避免把前阶段成功接触峰值冒充当前失败证据。CAL_BACKOFF/RETURN的再次受阻连续时长显示REBLOCK_MS；接触SEEK/RETOUCH显示CAL_TRIGGER_MS。

focCurrent/I_cmd是控制器电流命令，I_filt是其绝对值滤波；均不能称为实测绕组电流或等同电源表读数。电流单位A，速度是减速箱前电机r/s，误差/行程是电机r；J7乘5换算mm，J8乘360/16换算开度0–100单位，符号按各电机真实方向。J8搜索正电机方向对应开度减小；J7负电机方向对应地轨位置正向增加。阈值用实际整数转换后值，非仅配置显示值。

### 通道与实施范围细化

复用CAN0x37/0x38、DIAG_VERSION=2、24字段、request绑定重试、低优先级分包；新增selector3 CAL_LIVE、4 CAL_FAILURE、5无失败标记。CAL专用字段映射：BAD_TOTAL=有效命令限流mA、BAD_PEAK=最大搜索步数、EVENT=task、GOAL_ERROR_LOW/HIGH分别为有符号实际/参考搜索行程，DIRECTION低字节为搜索方向、reason字节为首次原因；其他字段沿用单位和结构。普通selector0/1及其24字段含义不变、J8普通堵转仍排除、EEPROM VERSION=1不变。主控100ms重试，1500ms未收齐明确缺字段超时，不输出半快照；查询不续租、不解锁，不参与运动完成或参数busy。

必要配套修改主控ascii_protocol.cpp只读门禁，将CAL_STATUS和原STALL_STATUS一起送严格协调器解析；否则快照功能在锁定期间不可用。old助手CAL页新增运行/失败快照按钮，并同步发送线程严格白名单；不修改串口助手.py。协调器.h无需为诊断再增状态成员。为容纳95KiB，限定原stall_protection.cpp内非周期启动/参数缓存、查询与单次阶段转换/失败捕获函数Os；20kHz周期控制/检测/判稳编译选项不变，未扩大Flash或侵占编码器/EEPROM区域。源文件、测试及产物详见SESSION_STATUS当前首节。

本轮未修改速度/误差阈值，不证明实机接触条件已经满足。软件参考越界缺陷通过真实源离线复现和修复对照，物理闭合仍失败则先通过冻结证据判明条件，再决定后续参数或速度估计方案；不反复长时间顶物理端点。

以下“搜索边界待修复/不支持校准快照”等是历史轮次状态，由本节覆盖。

## 六轴确认后延迟1秒，J7/J8并行校准（2026-10-07）

用户明确把先J8后J7的串行顺序改为同轮并行，并要求J1～J6校准后等1秒再启动。1秒从本次六轴坐标修正完成确认全部收齐开始计时；等待期START仍busy，STOP/DISABLE可以取消，取消后不再发CAL_RUN。主控只调度J7/J8的已有内部校准任务，分别寻端、退让、慢速复触、标坐标、返回0/100并实际判稳；先完成轴固定保持，等另一轴完成。

J7/J8共用本次任务号，各自100ms幂等CAL_RUN回读/重试与未完成轴的80ms续约，CAN忙时轮转；单播帧按现有发送预算依次发送，不承诺同毫秒启动/同时到位。两轴本任务CAL_DONE、无失败原因、有限实际位置及300ms内新鲜回执同时成立，才自动八轴失能、顺序保存。任一轴拒绝/失败/超时/离线，取消整轮并停止另一轴，不保存不完整校准；J7异常接触触发普通保护时仍取消校准并接管原串行回退。

这项决策覆盖下文先J8后J7的历史顺序建议，不改变普通堵转回退串行策略、30%接触比例或电机内部动作。搜索参考边界缺陷仍待单独修复；改并行不是该缺陷的修复。

主控实现及Ninja编译完成，实际主控/STOP与理想CAN同行离线24572项、隐藏Tk72项检查通过，覆盖延迟边界、独立完成、通信重试和取消。主控BIN434360B，电机沿用上一轮30%版本，实际EEPROM仍优先；完整结果及SHA见SESSION_STATUS当前首节。本轮未烧录、未提交，实机效果待用户验证。

## 校准接触比例补充决策（2026-10-07）

用户反馈80%接触电流门槛过高，明确决定J7/J8的CONTACT_RATIO默认改为0.3。实际判据仍为滤波电流命令绝对值≥本次实际校准限流×30%，并与实际低速、跟随误差条件连续成立150ms；例如实际校准限流1A时门槛0.3A。普通堵转CURRENT_A仍为初始化限流40%，校准速度、误差、计时、复触/返回及STOP流程本轮不变。下文80%旧记录为历史，当前CAL参数表已同步30%。

电机默认及old助手编辑初值同步；合法EEPROM记录和助手已回读值优先，新固件不会自动覆盖保存的80%。失能后显式CAL_SET对应节点的CONTACT_RATIO=0.3，回读确认后再CAL_SAVE。本轮只改比例，搜索参考微过冲触发SEARCH_TRAVEL的已确认缺陷仍待单独修复；不能把本次参数调整宣称为校准全流程实机验收。

## 已确认的日常堵转默认值（2026-10-07）

用户反馈上一轮普通运动末端修复“测试没有什么问题”，并确认以下默认值，授权修改、编译后提交已验收的保护工作。此轮只把普通检测TRIGGER_MS默认值从300改为100ms，保留其余现有常规默认值；old助手编辑初值同步。前轮极敏感诊断设置不是日常默认。本轮不改CALIBRATION参数或流程，提交后再讨论校准。

| 参数 | J1～J6 | J7地轨 |
|---|---|---|
| ENABLE | 1 | 1 |
| CURRENT_A | 初始化电流上限×40%，最低0.1A | 同左 |
| SPEED_RPS | 0.02电机圈/s | 0.02电机圈/s（0.1mm/s） |
| ERROR_R | 对应关节0.5°；J1～J5为0.0694444电机圈，J6为0.0416667电机圈 | 0.1电机圈（0.5mm） |
| TRIGGER_MS / STARTUP_MS | 100 / 200ms | 100 / 200ms |
| CURRENT_FILTER_MS / SPEED_FILTER_MS | 10 / 20ms | 10 / 20ms |
| BACK_DEG / BACK_MM | 5° | 5mm |
| BACK_RPS | 3电机圈/s，减速箱前 | 0.5电机圈/s（2.5mm/s） |
| BACK_ACCEL | 5电机圈/s² | 5电机圈/s² |
| BACK_CURRENT_A / HOLD_CURRENT_A | 初始化电流上限 | 初始化电流上限 |
| BACK_POS_TOL_R | 0.001电机圈 | 0.001电机圈（0.005mm） |
| BACK_TIMEOUT_MS | 5000ms | 5000ms |
| REBLOCK_MS / GRANT_WAIT_MS | 100 / 500ms | 100 / 500ms |
| 位置/方向约束 | START沿现有流程下发各关节实际软限位，DIRECTION_MASK=3 | START下发±250mm对应±50电机圈，DIRECTION_MASK=3 |

J8普通堵转检测强制排除。检测仍需位置运动意图、有效反馈、滤波电流命令/实际低速/跟随误差三个条件连续达标；任一条件失效清零，不累计间歇时间。实际及参考均进入普通到位范围时暂停候选，完成后清意图；实际完成窗口、STOP判稳和内部回退证明不放宽。

100ms相对300ms只减少连续候选部分约200ms；物理接触到回退还受启动豁免、滤波、误差形成、联动STOP及授权影响，不承诺总延迟100ms。这组值是用户确认的日常起点，默认100ms尚无全轴带载实测证据。初始化40%取启动时已加载的总限流；合法保护EEPROM记录随后优先覆盖默认值，提高总限流也不会自动提高已有检测阈值。回退/保持电流同样受实际总限流约束，不自动修改用户总限流/PID。

烧录保留EEPROM及磁编码器校准表，不能用整片擦除来强制默认值生效。已经保存的试验值应在DISABLE完成后逐项STALL_SET、等最终回执、STALL_GET回读，再按节点STALL_SAVE；主控不自动迁移或覆盖已有参数。old助手CURRENT_A=1A等只是未回读前的编辑初值，真实值以节点回读为准。

### 重新进入CALIBRATION讨论的边界

此前已确认：只能失能发起；J1～J6仅把当前姿态标记为REST_POSE，J7正向找物理端点标记250mm后回0，J8负向找端点标记开度0后回100；全部成功后自动失能、保存EEPROM，失败/取消不保存不完整结果也不返回成功。校准及保存期间START返回busy且不挂起；堵转回退中提前START策略保持原决定。接下来以现有代码重新核查这些流程和独立接触参数，不因普通堵转默认TRIGGER_MS改动而自动修改校准触发时间。

## 当前实施补充：普通位置运动末端检测与完成融合（2026-10-07）

用户已确认并授权修复14:58～15:06普通运动末端误触发；代码与离线验证、五目标编译完成，尚待本轮实机验收。回退入口143/165ms的前轮实机改善已确认，本轮不继续缩短入口或放宽STOP。

主控普通MOVEJ/HOME/RESET的COMMAND_POSITION链路，运动意图启动使用普通位置容差；实际位置与规划参考均在末端普通容差内时仅清堵转候选并等待原有完成证明，离开范围连续计时重来。完成仍需规划到达、速度0、有效编码器及50ms位置/平均速度窗口，完成后清意图/旧方向/滤波，保持原目标和位置环。同目标容差内重发不重新武装，新的实际运动重新启动检测。J7普通±.1mm、关节约±.1°、完成稳定范围及同步规划不变；不会仅凭规划器停止关闭未实际到位的堵转检测。直接电机Trajectory/PWM/STEP_DIR原退出路径保留，不扩展普通完成窗口；内部回退/CAL实际完成与再次受阻门槛不随本轮改变。

首次本地普通STALL在进入软停前冻结RAM运行数据，`#STALL_STATUS n LAST`读取；原命令仍查询LIVE。冻结模式/意图/反馈/电流命令/速度/误差/连续时间/阈值及新增event、goal_err、v_ref、dir/stall_dir可用于区分末端误差/超调/真实受阻。STOP/START/DISABLE、新指令、同伴停止及回退失败不覆盖，下一次本地普通STALL或重启才更新/清除；无记录明确报告，不伪造触发。该查询可经过保护锁定，仅只读，不新增解锁入口。old助手新增对应按钮；查询协议0x37/0x38保留，DIAG_VERSION=2/24字段，主控与电机需配套更新；控制协议/EEPROM VERSION=1不变。

常规实现细化：末端参考仍运动但已与实际同时进入允许范围时也暂停候选，避免最后几个周期误报；实际完成仍必须原严格参考终点。新快照只在初次普通STALL捕获，不拓展校准接触/NO_ENCODER/回退失败独立快照。新查询/捕获及低频CAN位置采纳局部Os用于原95KiB应用区，20kHz闭环/检测/判稳优化不改；原EEPROM/PID/默认参数与当前运行设置不自动更改。详细文件、测试证据和烧录流程以`docs/堵转误报修复与实机测试流程.md`首节为准。本轮无commit。

## 当前实施状态补充（2026-10-07）

用户已授权实现，基础STOP、堵转回退、校准及后续普通完成/发送确认修复均已有当前代码；下面最初“只分析/待实施”范围属于历史，不再代表本轮状态。最新构建和实机测试步骤见`docs/堵转误报修复与实机测试流程.md`首节。

本轮经用户另外确认解除暂缓，首个堵转EVENT从ISR执行CancelMotion改为只锁定/变更epoch/记录trigger，任务原子接管后清旧目标/队列。普通目标0x23的TARGET_READY与运行阻断/电流命令饱和分开，新0x20/0x40只用于0x23的flags字节，不与Protection EVENT flags混用。内部普通运动失败使用保留保护的STOP_PROTECTION，接管晚到的真实LOCAL_STALL；用户STOP/DISABLE仍取消并抑制事件。回退GO仍依赖真实事件和全机实际停稳，饱和、通信失败或目标变化本身不能冒充堵转事件。完成判稳、回退参数、提前START及校准START busy等用户决策不变。

常规实现决策：增加命令饱和自动提示及失败flags RAM快照；局部Os只用于电机低频CAN普通状态查询以保持95KiB应用区，Flash/EEPROM布局与20kHz控制环不变。PID默认未变，合法EEPROM不会因烧录被覆盖。绝对速度判据、稀疏反馈、本地/主控停稳截止及联合参数校验留待后续证据和授权，不在本轮顺手扩改。

更新日期：2026-10-07。本文保留已确认决策及历史设计；当前已实现范围、限制和验证以最新实施状态及测试报告为准，历史建议不等同已实现或实机验收。

## 1. 授权与开发边界

- 当前允许：读取代码、分析、记录本方案及 SESSION_STATUS。
- 固件、配置、上位机的实现仍需先列文件和作用，取得用户确认；本轮不实现、不构建、不烧录、不提交 commit。
- 当前开发：`firmware_new/dummy-ref-core-fw/`（STM32F405）、`firmware_new/dummy-motor-fw/`（STM32F103，35/42/57/gripper 四种构建）。
- `firmware/ref_core_f405/`、`firmware/motor_fw_f103_35/42/57/` 仅对照功能思路，不直接复制参考代码。
- 上位机目标仅 `串口助手_old.py`；禁止修改 `串口助手.py`、`esp32/`。
- STOP 以当前代码及 `docs/STOP软停实现与测试报告.md` 为依据。报告中的历史构建大小和旧行号不能代替当前源码与产物。

## 2. 已由用户明确决定

| 项目 | 已确认决策 |
| --- | --- |
| 普通堵转检测参与轴 | J1～J7；**J8 夹爪完全排除**，正常夹持不触发全机堵转保护 |
| 关节回退距离 | J1～J6 各 5°，单位为减速箱后的关节角度 |
| 地轨回退距离 | J7 为 5mm |
| 关节回退速度上限 | J1～J6 统一 **减速箱前电机轴 3r/s**；接受 J6 的减速比 30 与 J1～J5 的 50 导致关节速度不同；不为 J6 增加一种 35 固件构建 |
| 地轨回退速度上限 | 电机轴 0.5r/s；当前导程 5mm/r，对应地轨 2.5mm/s |
| 回退超时 | **5 秒**，替代此前 2 秒建议 |
| 其余检测参数 | 采用本文建议初值；实机验证后仍可调，不宣称这些初值已验证适配全部载荷 |
| 提前 START | 回退中挂起；全部参与节点保护流程成功、停点固定并同步后，自动保持当前位置并解锁；失败不自动解锁 |
| 解锁入口 | 只有 `!START` 或 `!DISABLE`；不新增 STALL_UNLOCK |
| 用户 STOP | J1～J7 按各自加速度软停并固定停点；正常 STOP 排除 J8 |
| DISABLE | J1～J8 全部失能 |
| 地轨已确认行程 | 当前位置零点为 0mm，可在 −250～+250mm 移动；CALIBRATION 正端记录为 +250mm，再返回 0mm |
| 夹爪已确认行程 | HAND 中现有 0～100 **开度映射**，沿用该行程；不得把 100 当成 100 电机圈 |
| CALIBRATION | J1～J6 当前位置只修正为 REST_POSE={0,−75,180,0,0,0}，不移动六关节；J8 朝开度 0 寻物理限位，限位记为 0，然后回到 100；J7 朝逻辑 +250 正方向寻物理限位，限位记为 +250mm，然后返回 0mm；全部完成才返回 `!CALIBRATION ok` |
| CALIBRATION入口（2026-10-06补充） | 必须处于失能状态；若不是，主控提示先DISABLE，目标串口助手参考顺序发送提示使用独立弹窗；不自动执行入口DISABLE或排队等候后自行校准 |
| CALIBRATION收尾（2026-10-06补充） | J7返回0、J8返回100并实际判稳后，**自动使J1～J8全部失能，确认后保存EEPROM**；全部保存并回读确认后才返回`!CALIBRATION ok`，最终保持失能 |
| CALIBRATION期间START及失败处理（2026-10-06用户同意） | **校准及保存期间START返回busy，不挂起**；堵转回退中的提前START仍沿用原决策；失败或取消时不保存不完整校准、不返回成功。已开始的Flash写入按第12.6节处理，明确报告部分保存结果 |
| 夹爪上电默认位置（2026-10-06确认） | **将电机上电当前位置作为开度100**，与J1～J7的默认参考方式一致，保持默认失能；只有触发CALIBRATION才向0寻限位并返回100；上电不自动运动 |
| RGB | 本期仅定义堵转灯效触发/恢复时机，不扩展 RGB 模块 |

注意：J8 排除的是**普通堵转保护**。CALIBRATION 中的专用、受控限位接触判定可以使用类似电流命令/低速/持续时间条件；它是预期限位完成事件，不进入全机堵转自动回退流程。

## 3. 当前源码已确认事实（前一轮核查，实施前按当前行号复核）

### 3.1 STOP

- 主控 `Robot/instances/dummy_robot.cpp` 的 RequestSoftStop/RequestStart/RequestDisable/PollSoftStop：运动世代取消旧任务、清队列，以 token、节点阶段和有限位置确认状态；STOP 收集 J1～J7，DISABLE 收集 J1～J8。START 包括 QUERY 与 ENABLE_HOLD，pending 只表示接受请求，最终 ok 才是完成。
- 主控 `dummy_robot.h`：冷启动为 DISABLED；NORMAL 与 DISABLED 以外阶段属于 STOP 锁定。USB/UART 入口已统一检查锁定。现有锁定入口中的 STOP 顺序需要在融合时调整，使重复 STOP 可以打断内部回退。
- 电机 `Ctrl/Motor/motor.cpp` 的 RequestSoftStop/TickSoftStop/CaptureStopPosition：使用本地 ratedAcceleration 减速；停稳后一次捕获 realPosition，位置保持不逐周期追随 estPosition。
- 20kHz STOP 判稳：参考速度归零后，50ms 窗口真实位置峰峰值≤8 内部单位，估计速度有符号均值的绝对值≤0.01 电机 r/s。此窗口用于判稳，不等同于回退目标实际到位；回退还必须验证真实位置误差及位移。
- 电机内部 51200 单位/电机圈；J1～J5 减速比 50，J6 为 30，J7 为 1、导程 5mm/r。正逻辑地轨方向经过 inverse 转换，不能直接硬编码为正电机速度。
- `firmware_new/stop_protocol.h`：CAN 标准帧 ID `(nodeID << 7) | cmdCode`；0 为 ALL。0x0A 现有 QUERY/STOP/RELEASE/ENABLE_HOLD/DISABLE 数值和确认语义应保留。

### 3.2 新版已有基础保护

- `Ctrl/Motor/motor.cpp` 旧检测使用 focCurrent 命令值、低估速和约 1 秒计时，旧计时复位不等同于严格三条件连续成立。
- isStalled 会令驱动 Sleep，同时阻止 ENABLE_HOLD；该标志还被电角度编码器校准流程使用。它不能直接作为新“可回退、可保持、可由 START 解锁”状态。
- softNewCurve 清除旧 isStalled；新版保护必须单独锁存，普通新目标不能清除保护。
- estPosition 含速度前馈；DCE 的位置误差被限幅。堵转跟随误差应使用未限幅的实际位置与当前参考差值，不能复用限幅后的 PID 误差。
- focCurrent 是输出给驱动的**电流命令值**，不是 ADC 实测电流。方案、查询、界面均须使用这一名称。
- MT6816 当前校验失败可能保留旧角度，IsCalibrated 只说明校正表有效，不能证明本次反馈有效；SPI HAL_MAX_DELAY 也不满足保护动作有界等待要求。
- 电机 CAN 发送失败可能进入 Error_Handler；接收只向本机和 ALL 分发，不会自动接收其他节点的保护事件。保护发送及联动需要专门的非阻塞路径和有效性检查。
- 主控 TryCanSendMessage 当前会拒绝 STOP 锁定状态；普通 CanSendMessage 对 0x0A/0x23 有例外。内部保护帧必须明确纳入允许列表，避免锁定自己的保护通信。

## 4. 推荐职责与融合状态机

### 4.1 电机端

在 20kHz 控制路径内持续检测、严格连续计时、锁存本次事件并撤销旧目标。首先本地软停和固定位置保持；即使主控未收到事件，也不能继续冲向旧目标。

保持可重发的每节点事件记录，带会话/事件编号、状态、失败原因；收到事件确认只停止相应重发，不解除保护。只有收到主控本次有效的回退授权、机械范围配置及有效反馈，才执行内部回退。

回退使用独立规划上下文。禁止改写普通 ratedVelocity、ratedAcceleration、正常电流限制或 PID 后忘记恢复。限制回退实际输出电流及相关积分；普通参数在所有退出路径保持一致。

### 4.2 主控端

收到事件立即设置运动入口锁定和取消世代；CAN ISR 仅记录事件/快速门禁，队列清理、状态转换、输出在任务中进行。撤销 SEQ/INT/TRJ/TUN 旧运动、队列、旧目标、未完成系统任务及迟到帧。

联动停止 J1～J7，收齐有效停稳位置后，按机械范围和方向配置授权回退。推荐**一次只回退一个节点**，其余节点保持。多节点的机械兼容性无法确定时不假定安全，报 MULTI_STALL_CONFLICT 并保持；任一回退失败，取消剩余计划并逐节点报告原因。

回退完成/失败后同步真实保持位置，重新播种主控目标、规划起点与到位状态。START 只解除锁定并保持捕获位置，不恢复堵转前目标。

### 4.3 状态与关键转换

采用现有 STOP 状态机扩展保护原因和内部阶段，避免两套控制器同时给电机发目标。下列为语义状态，最终枚举命名待实现时确定：

| 状态/事件 | 动作与去向 |
| --- | --- |
| NORMAL + 堵转事件 | 立即运动锁定、清旧任务；PROTECT_STOPPING；七轴联动软停 |
| PROTECT_STOPPING + 全部停稳、范围和方向有效 | 等待/执行本次授权的 RETREATING |
| RETREATING + 单节点实际到位并判稳 | 捕获位置并 HOLD；下一节点或 PROTECT_HOLD_SUCCESS |
| 任一准备/回退异常 | 取消余下授权、软停可控节点并固定保持；PROTECT_HOLD_FAILED，报告原因 |
| 回退成功 + 没有提前 START | 保持锁定，等待 START/DISABLE |
| 回退成功 + 提前 START | 七轴最终位置同步并确认保持后自动解锁；Started ok |
| 准备/回退中 + START | 仅记录 pending，不打断回退、不恢复旧目标 |
| 回退失败 + 先前 pending START | 清 pending，不自动解锁；要求新的明确 START 或 DISABLE |
| 回退成功/失败保持中 + 新 START | 反馈、范围、节点健康且保持确认成功后解锁；仍不可安全保持则明确失败并维持保护 |
| 准备/回退中 + STOP | 撤销回退授权、待执行回退与 pending START；七轴软停、捕获当前停点，转用户 STOP 锁定，不再次自动回退 |
| 任意阶段 + DISABLE | 最高用户优先级；撤销授权和 pending START，八轴失能确认；Disabled ok 后解除锁定 |
| 用户 STOP 减速中 + START | 沿用现有 STOP：记录 pending，七轴停稳固定后保持解锁 |

STOP、DISABLE 的撤销编号必须使迟到 GO/续约/目标失效。重复 STOP/GO/事件应幂等；重复回退授权不得再次增加 5°/5mm 距离。DISABLE 已受理不能被较低优先级请求覆盖成重新运动。

无有效反馈时不能声称固定位置保持成功；健康反馈下承重关节使用位置保持及原有合理电流限制，不默认断电。无反馈时只能进入不可定位保护并报告，机械承重需要实际机械支撑；电气制动不能宣称等同机械抱闸。

## 5. 检测参数、单位与计时

初值用于开始验证，按节点配置。正常锁定期间不接收外部修改/查询类命令，沿用只有 START/DISABLE 解锁及 STOP 可中断的规则；诊断与内部保护查询不受外部命令入口限制。

| 参数 | 单位 | 合法范围/约束 | 初值 |
| --- | --- | --- | --- |
| CURRENT_A | 电流命令 A | 0.1～本机有效电流上限 | max(0.1A, 初始化有效上限×0.4)；2.5A时1.0A、3A时1.2A（第17节修订） |
| SPEED_RPS | 电机轴 r/s | 0.001～0.2 | 0.02 |
| ERROR_R | 电机圈 | 0.0002～1 | J1～J5：0.06944444；J6：0.04166667；J7：0.1（关节0.5°/地轨0.5mm） |
| TRIGGER_MS | ms | 20～2000 | 300（第15节修订） |
| STARTUP_MS | ms | 0～500 | 200（第15节修订） |
| CURRENT_FILTER_MS | ms | 1～100 | 10 |
| SPEED_FILTER_MS | ms | 1～100 | 20 |
| BACK_DEG（J1～J6） | 关节 ° | >0，且受机械允许范围限制 | **5** |
| BACK_MM（J7） | mm | >0，且受机械允许范围限制 | **5** |
| BACK_RPS（J1～J6/J7） | 电机轴 r/s | >0 且≤本机额定上限 | **3 / 0.5** |
| BACK_ACCEL | 电机轴 r/s² | 0.1～100，且≤本机额定加速度 | 5 |
| BACK_CURRENT_A | 电流命令 A | >0 且≤现有电流上限 | 默认现有电流上限，承重关节不盲目降低 |
| HOLD_CURRENT_A | 电流命令 A | >0 且≤现有电流上限 | 默认现有电流上限 |
| BACK_POS_TOL_R | 电机圈 | 0.0002～0.01 | 0.001 |
| BACK_TIMEOUT_MS | ms | 250～30000 | **5000** |
| REBLOCK_MS | ms | 20～500 | 100 |
| GRANT_WAIT_MS | ms | 100～2000 | 500 |
| 机械范围/方向许可 | 绝对编码器单位/许可位 | 必须来自有效坐标映射和已确认机械范围 | 不凭空给安全范围 |

三条件为：滤波后的绝对电流命令≥阈值、绝对实际速度≤阈值、未限幅实际跟随误差≥阈值，且当前模式/运动意图适用。全部连续成立才计时；任一条件失效立即清零候选计时，不累计间歇满足时间。锁存的保护不随条件失效自动解除。

先取绝对值再滤波，避免正负振荡抵消。初版使用上述滤波和严格清零，不用保留历史候选时间的迟滞；可另设解除阈值供诊断，但不能改变连续计时语义。

启动豁免只适用于从静止开始的有效新运动，不应每次 INT/SRV 数据包重置，否则连续目标更新会永久豁免。模式切换、参数变化、方向变化复位候选计时；STOP/DISABLE 取消普通候选检测；START 解锁后重新建立启动上下文，不能清掉尚未处理的锁存保护事件。

静态承重、高电流命令且零速不独立构成堵转。必须有适用运动意图/跟随误差，避免位置保持误触发。持续运行保护的范围不能仅由“模式枚举存在”推断。

## 6. 自动回退的安全边界与完成条件

- 方向取触发前稳定参考运动方向的反向，结合实际运动历史及未限幅误差检查。方向不可确定时 NO_DIRECTION，不默认选择正方向。
- 将 5°/5mm 转为每节点电机绝对编码器目标，统一坐标系；不得把已包含 homeOffset 的绝对目标再次送入自动加偏移的普通 setter。
- 目标受本机有效位置范围、方向许可、机械约束限制；空间不足时允许截短并报告请求距离/实际距离，低于最小有效位移报 NO_SPACE。软件关节限位不能证明整臂无碰撞。
- 地轨沿用 −250～+250mm，关节沿用当前各轴限制；校准改变坐标原点后必须重新同步范围配置与版本，否则禁止授权回退。
- 距离为上限，速度为上限。J1～J5 的 5°折合 0.6944 电机圈，J6 为 0.4167圈；在 5r/s² 下为三角速度曲线，峰值约 1.863/1.443r/s，通常达不到 3r/s 上限。
- J7 的 5mm 折合 1 电机圈，0.5r/s、5r/s² 下规划时间约 2.1 秒，另需判稳及通信时间；故使用用户确认的 5 秒超时。
- 成功必须同时满足：内部参考速度归零、**实际编码器位置**进入目标容差、实际位移有效、现有 50ms STOP 稳定窗口成立。仅 softPosition/softVelocity 达目标不算成功。
- 再次受阻、实际到位超时、无方向、无空间、无有效编码器、范围版本无效、授权超时/撤销、节点离线都应分别报告。禁止循环回退或隐式不断重试机械动作。
- 用固定捕获位置保持，不能 LOCKED 每周期拿 estPosition 更新目标；完成或失败都不自动恢复旧运动。

## 7. 模式、CAN 与持久化

### 7.1 各模式

- 当前主控实际支持 SEQ、INT、TRJ（当前与 SEQ 同分支处理）、TUN；在这些位置参考模式检测有效运动跟随误差，触发后统一取消并锁定。
- TRQ/SRV 枚举存在但当前主控未完整实现，不借此扩大本次任务。未来 TRQ 静态力矩不能套用位置误差三条件；SRV 需独立运动意图及更新超时约束。
- J8 正常 HAND 操作无普通堵转检测，不参与七轴联动堵转；CALIBRATION 接触检测只在专用、限时、限速、限流上下文开启。

### 7.2 CAN 方案（拟定，最终占用须在实现前复核）

保留 StdId=nodeID<<7|cmdCode 与现有 0x0A 数值。复用 STOP token/确认/重试/位置同步流程，扩展内部保护动作和状态，不另建独立解锁通道。

| 命令码 | 拟定用途 |
| --- | --- |
| 0x0A | 现有软停控制/确认，扩展本次保护准备、回退授权/续约、保持等内部动作 |
| 0x0B | 保护事件/状态：事件号32位、阶段、原因、版本/标志，总长8字节 |
| 0x0C | 对指定节点、会话及事件的确认；确认不解锁 |
| 0x30 / 0x31 / 0x32 | 设置暂存参数 / 查询参数 / 参数响应 |
| 0x33 | 配置事务 BEGIN/COMMIT/SAVE；整组验证后原子发布到单节点 |
| 0x34 / 0x35 | 内部受控动作上下文及确认，供寻限位等专用动作使用，具体定义在校准分析后补齐 |

配置载荷建议：操作/参数号、16位事务号、32位值，共8字节；整数或 float32 按参数类型明确规定，不能同一个参数同时解释两种单位。

事件必须按节点保存；主控采用 ISR 安全的每节点状态记录，避免单全局 event/node/cmd 被覆盖。事件带启动会话与递增编号，重复可确认、旧事件不覆盖新事件。CAN 忙使用非阻塞有界重试，不因输出失败进入永久 Error_Handler。

电机接收有效保护事件后可本地联动停止；需专门接受该协议的其他节点帧，不放宽所有外部命令。总线完全失效时无法保证远端联动，各节点本地保护及通信看门狗仍应生效；没有有效主控授权不自主盲退。

内部回退授权需有限有效期并续约；STOP/DISABLE 撤销后迟到授权不得重启。会话、事件、阶段、参数版本均要匹配。物理寻限位与普通回退不共用一份可被覆盖的目标。

### 7.3 串口、查询与 EEPROM

建议命令：`#STALL_GET n`、`#STALL_SET n KEY value`、`#STALL_SAVE n`。n=1～7 指定节点；n=0 对该功能仅展开 J1～J7，不能改变 CAN ALL=所有八节点的现有定义；n=8 查询明确报告 EXCLUDED，设置普通保护参数拒绝为 UNSUPPORTED。

示例：`#STALL_SET 4 CURRENT_A 1.0`（仅2.5A上限时）、`#STALL_SET 7 CURRENT_A 1.2`（仅3.0A上限时）、`#STALL_SET 0 TRIGGER_MS 300`、`#STALL_SET 4 BACK_DEG 5.0`、`#STALL_SET 7 BACK_MM 5.0`。ALL 设置为逐节点事务，不能声称跨八节点原子提交；部分成功要列失败节点，全部同步有效前禁止使用混合版本保护配置。

建议支持显式 EEPROM 保存：扩展使用独立版本、长度、CRC，保持旧 BoardConfig 布局兼容；不直接往旧结构中插字段破坏已有数据。仅在允许的失能/安全阶段持久化，不在20kHz中断中擦写。CRC不能代替掉电原子性，应定义异常配置回退/锁定行为。

当前 FLASH 校正表/用户区与链接区重叠边界需加入构建检查，避免新代码增长侵占数据区。是否需要扩容先测算实际空间，不先改所有分区。

## 8. RGB 时机

堵转锁存即切入堵转灯效意图；成功回退但保持锁定时仍保留。pending START 不恢复；最终 Started ok 或 Disabled ok 后恢复相应状态灯效。回退失败仍为保护灯效。本期仅预留调用/状态，不扩展灯效实现。

## 9. 参考版问题的处理结论

| 已核查问题 | 本方案处理 |
| --- | --- |
| LOCKED 使用动态 estPosition | 固定捕获实际编码器位置 |
| 固定回退步数、不匹配减速比 | 主控按关节°/地轨mm映射每节点电机圈及范围 |
| 只用目标差符号判断方向 | 稳定运动意图和实际历史校验，无方向明确失败 |
| 仅 softPosition/softVelocity 判断成功 | 实际目标误差、位移、判稳窗口全部通过 |
| 三条件内重复验证且间歇计时未清零 | 单一有效条件，任一失效严格清零 |
| 回退改写参数按编译默认值恢复 | 独立回退上下文，普通运行参数不改写 |
| 绝对目标再次叠加 homeOffset | 内部绝对坐标统一，避免普通 setter 双重偏移 |
| 事件单槽、发送后清除、ISR与任务覆盖 | 每节点/每事件记录、确认及重发、原子发布 |
| 本地保护只睡眠，START无法正常清除 | 分离旧不可恢复 isStalled 与新保护锁存，健康反馈使用保持 |

## 10. 实施前修改模块清单（已于2026-10-06获授权；实际调整见第13节）

| 文件/模块 | 拟修改作用 |
| --- | --- |
| `firmware_new/stop_protocol.h`；新增 `protection_protocol.h` | 共用状态、动作、事件原因、版本和载荷定义，保持原数值兼容 |
| 电机 `Ctrl/Motor/motor.cpp/.h`；新增 `stall_protection.cpp/.h` | 替换旧检测、严格计时、固定保持、独立回退规划与输出限制、动作仲裁 |
| 电机 `UserApp/protection_config.cpp/.h`（拟新增）、`configurations.h` 的外围兼容处理 | 参数校验、版本化扩展存储及查询；不破坏旧 BoardConfig |
| 电机 `UserApp/protocols/interface_can.cpp`、`interface_uart.cpp`、`UserApp/main.cpp` | 内外部动作门禁、协议、事件输出和持久化任务 |
| 电机 `Core/Src/can.c`、`Core/Inc/can.h` | 保护专用非阻塞发送、事件联动接收 |
| 电机 Encoder 基类、MT6816 基类及 STM32 端口 | 有效反馈、校验失败/无磁标志和有界 SPI 等待 |
| 电机 `STM32F103CBTx_FLASH.ld` | 检查代码不侵占校正表/EEPROM 保留区 |
| 主控 `Robot/instances/dummy_robot.cpp/.h` | 融合保护阶段、联动/串行回退、方向范围配置、旧任务取消和位置同步 |
| 主控 `Robot/actuators/ctrl_step/ctrl_step.cpp/.hpp` | 内部动作与配置收发、坐标转换 |
| 主控 `UserApp/protocols/can_protocol.cpp` | 每节点状态/事件接收和确认 |
| 主控 `Bsp/communication/interface_can.cpp/.hpp` | 保护允许帧、有界非阻塞发送 |
| 主控 `UserApp/protocols/ascii_protocol.cpp`、`UserApp/main.cpp` | 串口参数入口、后台阶段轮询、诊断与 RGB 状态意图 |
| `串口助手_old.py` | 参数设置/查询/保存、保护状态和正确解锁提示，Tkinter 更新用 root.after |
| 本方案、`docs/SESSION_STATUS.md`、STOP 报告 | 经批准实现后记录实际修改与验证，历史与当前事实分开 |

新增源码进入现有 CMake GLOB 目录后需重新配置再构建；不因新增文件默认修改全部构建配置。CALIBRATION 的具体文件与作用在只读核查后补齐。

## 11. 验证计划

1. 误触发：启动、换向、连续 INT、TUN、承重静止、编码器噪声、间歇满足，J8正常夹持不参与；确认计时严格清零。
2. 真实堵转：各轴、正反方向、不同速度/电流/误差/持续时间及边界值；确认本地先停止与事件重发。
3. 自动回退：5°/5mm、不同减速比、实际反馈到位、边界截短、固定保持、不恢复旧目标。
4. 回退失败：再次受阻、无方向、无空间、超时、无有效反馈、掉线、总线忙/丢包、范围过期；每类原因明确可查询，失败不自动解锁。
5. 联动：主控漏收事件、重复/乱序事件、多节点同时触发、串行回退及冲突；无法保证通信时明确保护能力边界。
6. 全阶段 STOP/START/DISABLE：STOP打断，DISABLE八轴失能；提前START全部成功才自动解锁，失败清pending；迟到GO不重启。
7. 参数：运行修改/模式切换与计时、事务/部分失败、EEPROM旧数据迁移及损坏、回退前后普通参数完全一致。
8. 队列：SEQ/INT/TRJ/TUN、系统命令、旧epoch、USB/UART半包和迟到CAN目标均不在解锁后恢复。
9. 编译：主控与35/42/57/gripper四构建，FLASH保留区检查；主机反馈测试不替代用户实机烧录验收。

## 12. CALIBRATION：本轮只读核查结果

用户已经确认地轨和夹爪沿用已确认行程，不再把行程是否存在作为未决问题。J8寻限位是专用预期接触流程，与普通堵转保护分开。以下行号来自本轮实际文件；后续文件改变时须定位函数，不以历史行号代替代码。

### 12.1 当前代码与需求的差异

| 已确认事实 | 代码依据 | 影响 |
| --- | --- | --- |
| 现有校准先 ALL 使能，将J2/J3改为0.5A，ALL置零，改变initPose并运动到REST，第二次ALL置零，J2/J3改为1A，最后重启 | [dummy_robot.cpp](E:/Dummy-code/firmware_new/dummy-ref-core-fw/Robot/instances/dummy_robot.cpp:602)，610/614/620/625/627/632/635/640 | 不符合六关节只修正坐标；ALL会触及J7/J8，不能保留旧流程再简单添加寻限位 |
| 当前回执为Calibration pending；系统任务的成功文本为calibration ok，但校准先调用重启 | [ascii_protocol.cpp](E:/Dummy-code/firmware_new/dummy-ref-core-fw/UserApp/protocols/ascii_protocol.cpp:78)、[dummy_robot.cpp](E:/Dummy-code/firmware_new/dummy-ref-core-fw/Robot/instances/dummy_robot.cpp:1139) | 新流程应显式保存结果、取消/失败原因，成功从后台最终阶段发出，不靠函数返回或重启 |
| ApplyPosAsHomeOffset取realPosition的单圈余数，改写realPosition及单圈采样链，清估算，但没有同步goalPosition、softPosition、STOP保持点、规划器及保持积分 | [motor.cpp](E:/Dummy-code/firmware_new/dummy-motor-fw/Ctrl/Motor/motor.cpp:822) | 不能在位置保持中直接复用；原点修改必须是20kHz控制路径内的受控请求 |
| 0x15把偏移再次取单圈余数，置CONFIG_COMMIT；主循环立即写EEPROM，没有原点生效/保存完成确认 | [interface_can.cpp](E:/Dummy-code/firmware_new/dummy-motor-fw/UserApp/protocols/interface_can.cpp:188)、[main.cpp](E:/Dummy-code/firmware_new/dummy-motor-fw/UserApp/main.cpp:147) | 不能直接表达J7 +250mm所需多圈原点，不能把发出0x15当校准完成 |
| J7 inverse=true、减速比1、5mm/r，反馈乘导程还原mm | [dummy_robot.cpp](E:/Dummy-code/firmware_new/dummy-ref-core-fw/Robot/instances/dummy_robot.cpp:126)、563 | 逻辑+250mm对应原点相对电机−50圈；逻辑向正端运动对应负电机方向 |
| HAND将开度线性映射到ClosedMotorAngle=0、OpenMotorAngle=100，再inverse取反并乘16/360 | [dummy_robot.h](E:/Dummy-code/firmware_new/dummy-ref-core-fw/Robot/instances/dummy_robot.h:48)、60/75；[ctrl_step.cpp](E:/Dummy-code/firmware_new/dummy-ref-core-fw/Robot/actuators/ctrl_step/ctrl_step.cpp:152) | 开度0→100对应电机0→−4.444444圈；沿用已确认映射，不按注释“100圈”实现 |
| 部分HAND注释和历史文档把100写成100圈；当前执行公式实际为上述4.444444圈 | 同上；[串口助手_old.py](E:/Dummy-code/串口助手_old.py:1103) | 校准相关注释/提示在批准实现时校正，实际映射不擅自更改 |
| 电机默认上电失能，EEPROM优先；首次控制采样只根据单圈编码器和单圈原点构造近零位置 | [main.cpp](E:/Dummy-code/firmware_new/dummy-motor-fw/UserApp/main.cpp:30)、63/74/87；[motor.cpp](E:/Dummy-code/firmware_new/dummy-motor-fw/Ctrl/Motor/motor.cpp:29)、762 | 修改默认字段不一定覆盖已有EEPROM；当前无法从单圈编码器恢复掉电后的多圈绝对位置 |
| J8收到0x0A只允许QUERY、DISABLE、ENABLE_HOLD，忽略STOP/RELEASE | [interface_can.cpp](E:/Dummy-code/firmware_new/dummy-motor-fw/UserApp/protocols/interface_can.cpp:36) | 校准中J8停止需要带有效校准上下文的内部动作，不能只向J8发普通STOP后认为已停止 |
| 主控锁定门禁先于STOP；RequestSoftStop在已锁定时直接返回 | [ascii_protocol.cpp](E:/Dummy-code/firmware_new/dummy-ref-core-fw/UserApp/protocols/ascii_protocol.cpp:24)、[dummy_robot.cpp](E:/Dummy-code/firmware_new/dummy-ref-core-fw/Robot/instances/dummy_robot.cpp:701) | 扩展回退/校准忙态时须让STOP优先受理，并撤销内部动作 |
| 控制任务200Hz轮询STOP；校准当前在独立命令任务；FIFO已携带epoch | [UserApp/main.cpp](E:/Dummy-code/firmware_new/dummy-ref-core-fw/UserApp/main.cpp:20)、67；[dummy_robot.cpp](E:/Dummy-code/firmware_new/dummy-ref-core-fw/Robot/instances/dummy_robot.cpp:1093) | 适合扩展非阻塞校准阶段，不在串口收包中等待寻限位 |
| UI校准确认仍提示“随后重启”，并立即显示失能，未按真实最终结果处理校准状态 | [串口助手_old.py](E:/Dummy-code/串口助手_old.py:1290) | 需要同步更新提示与pending/成功/取消/失败状态；不修改另一个串口助手 |

本轮未在电机GPIO定义及上述控制路径中看到机械限位开关的采集接口；方案按现有编码器与电流命令做受控接触检测，不假设另有可靠开关。

### 12.2 推荐流程

1. 收到`!CALIBRATION`先检查主控状态；使能/使能过渡/失能待确认时返回`error CALIBRATION require DISABLE`，不自动入口失能、不保留待执行校准。STOP/保护锁定中不能拿CALIBRATION解锁，须先DISABLE。主控冷启动的DISABLED标志不等于八节点已确认失能。
2. 建立本次检查编号及忙态，以新查询确认八节点全部在线、实际失能、有效编码器及控制参数；任何节点使能、缺失或状态未知都不能置原点或开始运动。再确认六轴停稳，才清旧任务/目标及普通运动世代进入校准。当前六轴姿态将被认作REST，软件不主动摆姿，也不能自行验证实际机械姿态。
3. 获取八轴真实当前位置。推荐J1～J6全程保持失能，仅对本次需要运动的J7/J8进行内部受控使能；J8的专用停止/取消不改变正常用户STOP排除J8的规则。不能借用ALL使能让六轴沿旧目标动作。
4. J1～J6将捕获位置定义为本地相对0，主控initPose及本次候选坐标同步为REST_POSE；六轴保持失能，不改电流、不发Resting、不广播ALL原点操作。后续若六轴在失能中被移动，真实反馈仍须更新，不能把显示永久写死为REST。
5. 收齐步骤4的六轴坐标完成确认，等待1000ms，然后J7/J8同轮并行启动。J8沿开度减小方向受控寻闭合端→接触后减速/固定位置→小距离退让及慢速复触确认→把最终闭合接触位置定义为开度0→按已有映射返回100→真实位置到位并判稳→捕获全开保持点。
6. J7与步骤5的J8并行：沿逻辑正方向受控寻正端→接触/停稳→退让及慢速复触确认→最终接触位置定义为+250mm→返回0mm（负逻辑方向250mm）→真实位置到位并判稳→捕获中心保持点。先完成轴保持并继续回读完成证明，不能因为单轴结束就失能/保存整轮。
7. 收齐本次坐标版本及运动完成确认，J7实际回到0、J8实际回到100并判稳；取消内部运动授权，自动向J1～J8发DISABLE，必须收齐本次失能确认。此时校准忙态仍不退出，不能把失能当校准成功。
8. 在全轴失能下逐节点保存本次校准数据到EEPROM，收集任务/版本匹配的保存结果并从实际Flash回读验证。全部确认后同步主控实际当前位置与规划起点，清旧队列和pending START，退出忙态至DISABLED，返回`!CALIBRATION ok`及最终失能状态，不重启、不自动使能。

用户已决定J7/J8并行，逐轴独立快照、续约及完成掩码避免互相覆盖。步骤4～6的原点先作为本次任务的候选坐标，内部动作使用候选坐标；外部正常运动入口始终关闭，避免部分轴刚改原点即接收普通目标。

### 12.3 受控原点设置与坐标公式

内部新增“将固定捕获位置定义为指定相对电机位置”的动作，允许设0或其他标签，并返回实际生效值与版本。不是再发送现有仅置0的0x15。

设实际连续编码器位置为Q，51200单位/圈为S，目标原点标签对应的有符号相对电机圈为r：

`runtimeHomeOffset = Q_capture − r × S`

- J1～J6：r=0，主控加REST_POSE，因此当前位置显示REST。
- J7正限位：r=−250/5=−50，因此runtimeHomeOffset=Q_limit+50×S；返回地轨0的绝对目标为runtimeHomeOffset。
- J8闭合端：r=0，runtimeHomeOffset=Q_closed；返回开度100的目标为Q_closed−(100/360×16)×S。

原点更新不改传感器给出的实际连续位置Q及单圈采样历史；在停稳且入口锁定的20kHz控制路径更新偏移/版本，并重新建立goal、soft、捕获点和规划状态。J1～J6设置坐标不解除失能；对校准中正在位置保持的J7/J8，保持积分按当前正常保持电流连续衔接，避免更新原点后沿旧目标跳动。

原点改变必须使旧范围配置、迟到目标、旧事务失效；主控缓存只能由本次确认同步，不能靠先把显示数值写成REST/250/0来证明电机完成。两阶段暂存/生效可以保证单节点原子更新，CAN上的跨节点提交并非真正原子；部分提交失败必须保持忙态/保护并报告节点及坐标版本，禁止混合坐标运动。

### 12.4 预期限位与异常堵转

普通检测与校准接触检测共用测量、滤波、严格连续计时工具，但分开动作上下文和事件原因：

- 只有本次有效的J7/J8 SEEK_LIMIT任务可以把预期方向的接触解释为CONTACT_LIMIT；不永久关闭保护开关，也不让任意CURRENT静态夹持产生此事件。
- 受控寻限位有参考速度/积分参考行程。低实际速度、高电流命令、参考与实际行程的误差连续满足阈值才是接触候选；电流命令始终按命令值命名。
- 有有效旧坐标时限制候选接触窗口：J7正端附近（建议±5mm）、J8闭合端附近（建议±5开度点）；提前远离预期端点受阻，不改原点。无可靠旧坐标时，用真实累计搜索行程、方向、复触一致性限制，并明确采用无中途障碍的操作前提。
- 建议首次接触后J7退让1mm、J8张开2开度点，再以0.25电机r/s复触。两次实际接触位置差初值≤0.01电机圈（J7为0.05mm，J8约0.225开度点），不一致报CONTACT_UNSTABLE。复触不能证明中途障碍就是机械末端，不能承诺消除该物理不可辨识性。
- 已在物理端点时允许零初始行程的接触候选，再用退让/复触确认；不能强制先移动一段才检测。若无法退让，明确失败，不能继续增大力或认作成功。
- J7寻限位期间已知位置窗口外受阻、返回0期间受阻，属于异常堵转：取消CALIBRATION并转第4节正常七轴保护/自动5mm回退流程。有可靠方向与约束才能回退，不能回退须说明原因。
- J8异常受阻仅作为CALIBRATION失败事件，取消整个校准并停止内部动作；J8不因此加入普通全机堵转检测，不给J8套用5°/5mm保护回退。
- 无有效编码器、搜索超时/超行程、无高电流接触但参考已走完、坐标确认缺失，都不得记录物理限位或返回ok。

### 12.5 校准参数建议（新增建议，并非本轮已实机验证）

普通自动回退的5秒超时与以下寻限位/返回超时分别保存；不能共用一个超时字段。

| 参数 | J7建议 | J8建议 |
| --- | --- | --- |
| 初次寻限位/返回速度上限 | 电机0.5r/s（2.5mm/s） | 电机0.5r/s（约11.25开度点/s） |
| 复触速度上限 | 电机0.25r/s | 电机0.25r/s |
| 加速度 | 电机5r/s²，且≤本机有效上限 | 同左 |
| 电流命令上限 | 沿用本机已配置有效上限，不擅自降为1A使地轨误判 | min(HAND当前幅值，本机有效上限)，HAND默认1A |
| 接触电流命令阈值 | 本次寻限位电流上限×0.8 | 同左；不能沿用可能高于寻限位限流值的普通堵转阈值 |
| 实际速度阈值 | 0.02电机r/s | 同左 |
| 参考/实际行程差阈值 | 0.02电机圈 | 同左 |
| 接触持续时间/启动豁免 | 150ms / 100ms | 同左；反向复触重新建立上下文 |
| 电流/速度滤波 | 10ms / 20ms | 同左 |
| 最大发送参考/实际搜索行程 | 已确认500mm全行程，搜索预算505mm | 已确认100开度点，搜索预算105点（约4.667电机圈） |
| 初次搜索超时 | 220秒；最坏505/2.5约202秒 | 15秒 |
| 返回0/100超时 | 120秒；250/2.5约100秒 | 15秒；全行程约8.89秒，加减速另计 |
| 单次复触超时 | 5秒 | 5秒 |
| 实际返回目标容差 | 0.001电机圈（0.005mm） | 0.001电机圈（约0.0225开度点） |
| 判稳 | 复用STOP的50ms实际反馈窗口 | 同左 |

搜索预算的额外5mm/5开度点仅限专用寻限位上下文，用于容差；普通位置目标仍按既有范围。实际编码器行程及参考预算都须限幅，任何一个超界立即失败，避免编码器反馈异常或空转无限搜索。

上述参数独立命名为CAL_SEEK/CAL_RETURN/CAL_CONTACT等，在共用参数协议中按1～8节点查询和配置；普通STALL参数的n=8仍EXCLUDED，不把J8校准参数混入普通堵转开关。值需有限、正值、≤额定限制并通过整组合法性校验。

按保守0.5r/s初值，地轨从中心寻正端再回中心，单是运动约200秒；不能用几秒无完成作为失败。速度可独立调高后重新计算超时，但须实机确认限位冲击及停止距离。

### 12.6 STOP / START / DISABLE 与失败

| 校准期间事件 | 推荐行为 |
| --- | --- |
| STOP | 立即撤销SEEK/RETURN/复触/提交授权和pending START；停止J1～J7，另通过有效校准上下文停止J8；停稳固定后转用户STOP锁定；不会自动继续剩余校准 |
| 用户DISABLE（运动阶段） | 取消校准运动，八轴失能，收到确认后Disabled ok；报告cancelled及已生效掩码。未完成校准不自动保存部分原点，不返回校准ok |
| 自动DISABLE（正常收尾） | 仅在J7/J8全部返回并判稳后进入；八轴失能确认齐全才执行SAVE，继续保持校准忙态 |
| START（检查/运动/自动失能/保存阶段） | **用户已确认：拒绝，返回error CALIBRATION busy，不挂起**；清本次进入前遗留的pending START，避免保存过程中或完成后自动使能。校准成功最终仍DISABLED，用户之后重新START。第2/4节堵转回退中的提前START决策不改变 |
| STOP/DISABLE（保存已开始） | 保持八轴失能；不能随意中断已开始的Flash擦写。完成或明确失败当前写入，取消未开始的后续保存，报告已保存掩码及取消结果；不能因取消发完整校准ok，也不能重复擦写已成功节点 |
| 普通运动/参数/HAND/CALIBRATION重复命令 | 忙态拒绝，返回CALIBRATION busy；不排队，不覆盖保护目标 |
| 超时、反馈/节点异常、接触不一致、坐标部分提交 | 取消内部动作、停稳健康节点固定保持，报节点/阶段/原因及已完成掩码，进入保护；不返回ok、不偷偷回旧原点继续运动 |
| 失败后新的START | 健康反馈下只保持当前捕获位置并解除用户锁定；坐标无效轴的普通运动仍受坐标有效性门禁限制，可重新发CALIBRATION；不可安全保持则明确故障不放行 |

候选原点可在尚未发布时撤销；已实际生效的原点不能只把主控缓存改回旧值。记录每节点本次版本、已生效/待保存状态；取消或部分失败后用真实回包恢复一致视图，必要时保持锁定并要求重校准。

J8内部停止仅在有效校准任务中允许；普通STOP仍不停止正常夹持。CAN续约与取消编号确保主控未收回包、节点重启或迟到帧不会重新启动寻限位。

### 12.7 上电默认100与自动失能保存（2026-10-06已明确）

**用户已确认上电当前位置定义为开度100，保持默认失能，上电不运动。** 在电机首次有效编码器采样时建立本地开度100参考，不改编码器实际样本、不每个周期重新定义原点、不每次上电写Flash；正常START仍保持当前位置。只有CALIBRATION使夹爪沿开度减小方向寻0，确认闭合限位后记0，随后按已确认映射返回100。

单圈编码器无法识别掉电期间的整圈位移，EEPROM保存零点不能解决多圈绝对位置恢复。必须明确区分ASSUMED_BOOT与本次实测校准坐标；主控单独重启时查询仍运行的电机位置，不能重新把电机坐标改成启动默认值。

当前模拟EEPROM写入会擦写F103内部Flash，函数位于Flash，没有校准期间保持闭环的RAM执行链；`eeprom_buffer_flush()`返回void，也不能证明写入成功。依据：[emulated_eeprom.cpp](E:/Dummy-code/firmware_new/dummy-motor-fw/Port/Platform/Memory/emulated_eeprom.cpp:213)、[eeprom_interface.h](E:/Dummy-code/firmware_new/dummy-motor-fw/Port/Platform/Memory/eeprom_interface.h:90)、[链接脚本](E:/Dummy-code/firmware_new/dummy-motor-fw/STM32F103CBTx_FLASH.ld:79)。不能把“在主循环写而非ISR写”当成不会影响20kHz闭环。

**用户已选择自动保存工序**：运动阶段先在RAM生效；全部返回原位并判稳后自动八轴失能；确认齐全后逐节点有界保存及校验；全部保存成功才返回`!CALIBRATION ok`。成功文本同时证明本次校准运动、全轴失能和EEPROM保存完成，替代此前“用户另发DISABLE后保存”和“ok仅表示RAM完成”的建议。无需为本流程增加保持闭环的RAM Flash擦写链。

EEPROM保存方案必须补充以下确认：

- 保存命令绑定本次任务、数据/坐标版本，重发只查询/继续本次状态，不能重复擦写或叠加原点。
- 单节点保存超时建议2秒；全部采用非阻塞任务推进，不把八节点Flash写入放在主控CAN ISR内等待。超时报告节点，保持失能，不无限重试。
- 校验应读取实际Flash内容并检查版本/CRC/数据；现有eeprom.get使用RAM缓存，不能将刚写入缓存的值当持久化回读证据。
- 任一节点保存失败不返回校准ok，列missing/failed/saved掩码；所有节点继续失能，失败节点的数据有效性明确记录。
- 部分节点保存或掉电不具备跨八节点原子性；不能声称全部持久化成功。原点确认、保存确认、最终完成分别计数，迟到确认不能用于下一次任务。
- 最后自动DISABLE是用户已明确要求的流程，UI校准提示应说明最终全轴失能及需要支撑当前六轴姿态；不默默恢复使能。

### 12.7.1 校准入口与串口助手独立弹窗

现有`串口助手_old.py:141`的_motor_enabled初始为False，断连也置False；`_cmd_calibration():1298`甚至会在发送前立即把显示改成失能。这些都不是实际八轴失能证明。实际入口以主控的新查询及节点阶段确认决定。

- 若界面已明确知道使能，点击校准只弹`messagebox.showwarning`（参考`_warn_seqsend_mode():1326`的独立提示方式），提示先点击DISABLE并等待确认；不发送CALIBRATION、不自动失能、不自动排队校准。
- 刚连接或状态未知不把初始False认作确认：主控先检查节点；若实际未失能/未知，返回require DISABLE或state unavailable，UI通过root.after弹独立窗口并结束本次请求。
- 建议文本：“校准需要八轴失能。请先点击DISABLE并等待失能确认，再重新点击校准。校准完成后会自动失能并保存EEPROM。”不沿用“随后重启”的旧提示。
- 校准接受后显示阶段和busy；J7/J8内部使能不把正常运动入口开放。START建议禁用/提示busy，STOP和DISABLE始终可用；确认完成后界面显示失能。
- 本地UI门禁用于操作提示；USB直接发命令仍须经主控相同失能前置检查，不能只在Python里判断。

### 12.8 校准CAN与串口

复用前述0x34上下文、0x35状态/确认与0x0A保持/取消基础，定义SEEK_LIMIT、RETURN_TARGET、SET_CAPTURE_COORD、COMMIT_COORD、CANCEL及SAVE_COORD内部操作；操作必须带任务/阶段编号和版本，完整参数先事务暂存再提交。8字节容纳不了完整参数组时使用多帧事务，不能塞入未定义的隐含单位。

0x35每个具体回复子类型分别定义载荷：任务编号、阶段、失败原因、坐标版本，或实际捕获位置/当前位置float32；不能一个8字节包同时容纳全部字段。主控以节点/任务/阶段拼接确认并校验有限值和反馈有效性。发送忙/丢包使用同任务幂等重试，不重复寻限位、不重复偏移或写Flash。

回执建议：入口不符`error CALIBRATION require DISABLE`；接受`!CALIBRATION pending`；进度`CAL J8 SEEK`/`CAL J7 RETURN`/`CAL DISABLING`/`CAL SAVING`；成功严格按用户要求`!CALIBRATION ok`并报告最终失能；失败`error CALIBRATION J7 seek_timeout`或`error CALIBRATION J4 save_failed`；取消`error CALIBRATION cancelled STOP`。机械返回或发出保存命令都不单独回校准ok。现有Respond仅64字节缓冲，新回执每行必须小于64字节，逐行诊断，不扩大为无关长文本USB修复。

### 12.9 校准拟修改文件与作用（尚未授权）

下列叠加在第10节保护融合文件上，具体新增文件名可在实施清单中最终确定：

| 文件 | 校准相关作用 |
| --- | --- |
| `firmware_new/protection_protocol.h`（拟新增）及`stop_protocol.h` | 共用专用寻限位、原点设置、确认/取消/保存及动态参与掩码；保留普通STOP的J8排除 |
| 主控`Robot/instances/dummy_robot.cpp/.h` | 替换旧CalibrateForGeneration，候选坐标、分阶段J8/J7、忙态/结果/取消、REST与位置缓存同步、StepHand相关注释/默认参考 |
| 主控`Robot/instances/calibration_task.cpp/.h`（建议新增） | 非阻塞校准流程和独立搜索/返回超时，降低dummy_robot主文件继续膨胀 |
| 主控`Robot/actuators/ctrl_step/ctrl_step.cpp/.hpp` | 内部寻限位和任意捕获坐标动作、确认查询与方向/单位转换 |
| 主控`UserApp/protocols/ascii_protocol.cpp`、`can_protocol.cpp` | 明确校准入口/回执、每节点阶段和坐标结果接收，不在串口接收内执行机械动作 |
| 主控`UserApp/main.cpp`、CAN通信模块 | 后台轮询、内部帧门禁与非阻塞有界发送；不扩大到普通CAN调度重构 |
| 电机`Ctrl/Motor/motor.cpp/.h`、`stall_protection.cpp/.h`（拟新增） | 安全坐标变更、专用寻限位与复触、实际返回到位、J8上下文停止、异常与普通保护融合 |
| 电机`Ctrl/Motor/limit_search.cpp/.h`（建议新增） | 限流/限速/限行程搜索与接触计时；J8仅校准上下文启用 |
| 电机`UserApp/protocols/interface_can.cpp`、`main.cpp`及版本化配置模块 | 原点/上下文协议、首采样启动参考、坐标生效/保存完成确认，不直接复用旧0x15自动提交 |
| 电机`Port/Platform/Memory/eeprom_interface.h`、`emulated_eeprom.h/.cpp`及版本化配置模块 | 增加有界保存结果和实际Flash回读，不以RAM缓存伪造确认；校准全部自动失能后保存，不扩展RAM闭环写Flash链；若需要改分区仍须另列准确文件和用途 |
| `串口助手_old.py` | 增加未失能独立弹窗，取消发送前伪显示失能和“重启”旧提示；说明六轴定义REST、J7/J8会运动、最后自动失能保存；busy/进度/最终结果、STOP仍可用、状态据回包更新，root.after UI更新 |
| 本文与SESSION_STATUS | 保存用户答复和最终批准范围；不把设计写成已实现 |

### 12.10 校准验证计划

- J1～J6：只改坐标、编码器物理位置不跳、保持输出连续、各inverse方向正确，旧目标不再下发；正在运动时拒绝。
- J8：任意已确认开度、已在闭合端、正常空载寻端、复触后原点0及返回100真实到位；普通夹持仍无全机堵转事件。
- J7：−250/0/+250起点，正向寻端记录+250，反向回0，搜索/返回长超时及行程限制；中途受阻不随意改原点。
- 预期接触与异常：间歇条件严格清零、低电流无法接触、无反馈/假静止、复触不一致、寻限位与返回中阻碍、参数被其他任务覆盖。
- 每阶段STOP/DISABLE/START：J8校准停止有效、撤销迟到帧、失败清pending、成功捕获保持，解锁不继续旧校准或旧运动。
- 原点事务与EEPROM：丢包/重试/主控单独重启/电机重启/部分提交/掉电/保存失败；明确RAM与持久化状态，不伪报全部完成。
- 入口：真实使能、DISABLING未确认、主控冷启动默认DISABLED但节点实际使能、GUI缓存未知、缺失节点；不置原点、不执行运动，主控明确拒绝，目标UI独立弹窗。
- 收尾：只有J7/J8真实返回并判稳才自动八轴DISABLE，全部确认才SAVE；START在自动失能/保存阶段不被挂起自动重使能；保存失败不报ok，成功最终失能。
- 上电：J8任意物理位置首次有效采样建立开度100参考、保持失能且不运动；主控单独重启不再次改电机原点；只有CALIBRATION才寻0并返回100。
- UI：CAL回执跨读取拼接、长任务不误判2秒失败，取消/断连/失败状态；不把校准ok当裸ok推进SEQ，状态以回包确认。

**当前入口：2026-10-06用户已授权实施。以上分析保留为设计依据，实际实现、补充决策和验证以第13、14节为准；六轴校准全程保持失能已落实。未烧录、未提交commit。**

## 13. 2026-10-06 实际实现与补充决策

### 13.1 实际流程

- 普通检测硬性排除J8；J1～J7替换旧1秒基础堵转分支，保留电流命令/编码器速度/原始跟随误差三条件连续计时。任何条件失效、反馈无效、换向或模式/参数变化都清候选时间；连续INT更新不反复豁免，参数更新不永久取消原运动意图。
- 事件首先在电机本地触发软停及固定停点保持，健康同伴可直接接收专用事件联动软停。主控立即撤销运动epoch、清队列和TUN，七轴实际软停确认后按节点序号串行授权回退；晚到的低编号事件也会纳入未完成集合。
- 回退默认值按用户决策：J1～J5为0.694444电机圈、J6为0.416667圈（均5关节°），J7为1圈（5mm）；速度上限3/0.5电机r/s、加速度5r/s²且不超过额定、超时5000ms。内部规划器与普通运行参数分开。目标范围截短不得扩大位移，无法在距离预算内进入有效范围报告NO_SPACE。
- 完成以实际编码器位置、有效位移和原STOP 50ms稳定窗共同判定；失败有具体原因，健康反馈时捕获固定位置保持，无有效反馈时明确报告并进入不可定位保护。不会恢复旧目标。
- 普通回退提前START挂起，全部成功才重新核验位置/范围并保持解锁；失败清挂起，需新START。STOP取消内部动作，DISABLE最高优先级八轴失能；取消后的重复旧事件不能覆盖DISABLING或重启回退。
- 校准先发带探针的八轴QUERY，核验本次反馈有效及DISABLED标志，再用CAL_BEGIN逐节点原子重查并锁定。GUI缓存及主控初始DISABLED均不作为实际失能证明；入口不符只提示require DISABLE，不自动入口失能。
- J1～J6全程失能，实际编码器50ms稳定后捕获当前原点并定义REST；不改J2/J3电流，不运动到L姿态，不广播旧置零/重启。未稳定2秒报CAPTURE_UNSTABLE，不改该轴原点。
- 六轴坐标确认后等1秒，J7/J8并行：J8闭合寻端、退离、慢速复触、记录0、实际返回100；J7向逻辑正端寻端、退离/复触、记录250mm、实际返回0。分别实际判稳并保持，收齐两轴新鲜完成证明才收尾。J8开度仍按100/360×16约4.444电机圈映射，上电首次有效采样只建立100参考且失能，无上电运动。
- 全部返回判稳→八轴DISABLED确认→逐节点SAVE_COORD实际Flash写入及回读→全部CAL_END确认，才返回`!CALIBRATION ok`和`Disabled ok`。校准/保存期间START busy不挂起。失败或取消无校准成功回执，不继续保存未完成流程；RAM中已经生效的坐标不悄悄回滚到旧坐标。

### 13.2 对原方案的具体化及调整

1. 新增主控`protection_coordinator.{h,cpp}`统一保护、校准和参数作业，未另建`calibration_task`；电机`stall_protection.cpp`含搜索子阶段，未另建`limit_search`/重复状态机。共享协议以实际`protection_protocol.h`为准，旧`stop_protocol.h`数值未改。
2. 0x0A新增保护联动动作5，保留本地事件资格；普通用户STOP动作1撤销回退。0x34承担准备、授权、续约和校准上下文。只有取消内部校准时，额外停止并确认J8，后续新START也明确解除J8内部校准保持；普通STOP和普通堵转仍排除J8。普通J8编码器故障仅报告HAND本地保护，不用STALL文本误锁整机GUI。
3. 每次START先fresh QUERY再按当前坐标版本事务同步J1～J7机械范围，然后复用0x0A查询令牌/ENABLE_HOLD位置同步。配置COMMIT回显操作和版本，不能把BEGIN ACK当COMMIT。普通STOP中的提前START也经过该流程。
4. J7专用校准入口和确认正端后的新原点均绑定已确认±250mm范围。校准返回受阻/非预期接触时终止校准、禁止保存，转普通七轴保护并尝试5mm回退；回退成功仍报告校准失败、保持锁定并清提前START，需新START。J8校准失败不生成普通夹持堵转事件。
5. 主控200Hz循环先轮询STOP再保护协调器，用不同发送时隙轮转STOP、续约、取消、事件ACK和普通作业。每次最多成功入队1帧，八节点正常续约间隔320ms小于500ms租约；发送失败保留续约节点重试，离线低ID不能独占取消队列。普通参数GET期间并行健康探针，避免长查询造成虚假离线。
6. 本地事件带启动会话/递增编号、阶段、原因、坐标版本及标志；主控按节点记录，拒绝旧探针、旧事件/版本及逆序阶段。事件未确认20ms重发、250ms周期状态；ACK不解锁。授权严格匹配task/event/version，GO重复不重复位移，CANCEL后的迟到GO不重新运动。RENEW不产生动作成功确认，坐标切换时仅允许当前或紧邻旧版本续租。
7. 失能ACK以匹配token且DISABLED为准，无有效位置也可失能；STOP保持及START仍必须有效位置。普通0x23无效位置不污染姿态缓存。MT6816增加有界SPI、本次有效性及跳变检验；任何无效样本不计稳/计堵，持续5ms缺反馈进入NO_ENCODER保护。
8. 为保护在CAN故障下仍能推进，主控CAN1自动BusOff恢复、发送信号量等待有界，并按实际在途邮箱在complete/abort/TERR/ALST释放一次。电机24槽有界发送队列忙重试，不进入Error_Handler。此处新增修改主控`Core/Src/can.c`及CAN上下文字段，是对原清单的必要补充，并未重构全部普通运动发送。
9. 参数保存只在实际失能时执行；pending/inProgress重传不提前ACK成功。独立保存结果墓碑保证丢ACK/旧SAVE重传不重复擦写、不覆盖后续BEGIN。CAL_END终态回显原任务并支持幂等重试。用户在已开始Flash写入后取消，不能承诺撤销该次物理写入，报告`saved`确认掩码和`pending`可能完成掩码，停止后续保存且不返回校准成功。
10. EEPROM扩展从逻辑偏移128使用独立版本、长度、node身份、CRC，旧BoardConfig布局保持。保存一并提交旧区和扩展，再绕过RAM缓存直接读取实际Flash比较；旧单圈homeOffset保留取模兼容，扩展记录全运行时原点，不能据此声称恢复掉电期间多圈移动。J8每次上电仍按用户决定建立100参考。
11. 非空损坏/节点不匹配配置拒绝使能和校准，不能静默启用默认参数。先DISABLE并查询检查参数，显式合法参数组COMMIT（例如`#STALL_SET n CURRENT_A 合法值`）修复，再`#STALL_SAVE n`；J8使用相应`#CAL_SET/#CAL_SAVE 8`。单纯机械范围COMMIT不清损坏故障。
12. 电机链接FLASH限定95KiB，避免代码侵入0x08017C00编码器表及0x0801FC00用户区。新增保护文件使用短IRQ守卫且无异常，CMake仅对该文件加`-fno-exceptions/-fno-rtti`，避免异常展开代码超出保留区；其余源选项不变。这是实际构建发现后的必要清单补充。
13. RGB只保留报警意图：触发置位、回退/锁定持续、最终START或DISABLE清除；未扩展灯效模块。TRQ/SRV仍未扩展到主控现有1～4模式实现范围。

### 13.3 实际命令和参数接口

`#STALL_GET/SET/SAVE n`：n=0展开J1～J7，n=1～7指定轴，J8查询EXCLUDED并拒绝普通保护设置。GET输出节点独立键值；`BACK_DEG`仅J1～J6，`BACK_MM`仅J7，ALL分别只展开适用轴；底层`BACK_DISTANCE_R`别名单位为电机圈。机械MIN/MAX/DIRECTION是主控来源的只读查询项，不能通过外部SET绕开现有机械范围。

`#CAL_GET/SET/SAVE n`：仅n=7/8，键名为SEEK_RPS、RETURN_RPS、RETOUCH_RPS、ACCEL、CURRENT_A、CONTACT_RATIO、SPEED_RPS、ERROR_R、TRIGGER_MS、STARTUP_MS、MAX_TRAVEL_R、SEEK_TIMEOUT_MS、RETURN_TIMEOUT_MS、RETOUCH_TIMEOUT_MS、BACKOFF_R、REPEAT_TOL_R、POSITION_TOL_R、CONTACT_WINDOW_R。SET/SAVE要求实际失能；参数作业期间START明确`error START busy`，不会伪回pending。

普通初值和范围沿第5节；ENABLE为0/1、J8强制0。新增实现边界：回退距离底层0.0002～100电机圈且最终受机械范围和距离上限约束，回退/保持电流0.1A～额定，BACK_RPS≥0.001且≤额定。

| 校准键 | 单位/范围 | J7默认 | J8默认 |
| --- | --- | --- | --- |
| SEEK/RETURN/RETOUCH_RPS | 电机r/s，0.001～额定 | 5/5/0.5 | 2/2/0.5 |
| ACCEL/CURRENT_A | r/s² 0.1～min(100,额定)；命令A 0.1～额定 | 3/min(2.5A,总限流) | 5/min(1A,总限流)，还受HAND_I约束 |
| CONTACT_RATIO | 0.1～1，无量纲 | 0.3 | 0.2 |
| SPEED_RPS/ERROR_R | 0.001～0.2 r/s；0.0002～1电机圈 | 0.02/0.02 | 同左 |
| TRIGGER/STARTUP_MS | 20～2000 / 0～500 ms，整数 | 100/100 | 同左 |
| MAX_TRAVEL_R | 0.001～200电机圈 | 101（505mm） | 6（135模型开度行程） |
| SEEK/RETURN_TIMEOUT_MS | 1000～600000ms，整数 | 220000/120000 | 30000/15000 |
| RETOUCH_TIMEOUT_MS | 250～30000ms，整数 | 5000 | 5000 |
| BACKOFF_R | 0.001～2电机圈 | 1（5mm） | 0.5（11.25模型开度） |
| REPEAT/POSITION_TOL_R | 0.0002～0.1 / 0.0002～0.01电机圈 | 0.05/0.005 | 0.1/0.01 |
| CONTACT_WINDOW_R | 0.001～10电机圈 | 1（5mm） | 0.222222（5开度） |

全部ms、布尔及许可位经float32传输并校验整数；NaN/Inf拒绝。普通GET不会清保护或覆盖目标；参数更新清候选计时，原运动意图保持。ALL逐轴事务失败会报告失败轴及已应用掩码，进入锁定直至明确处理；不能宣称跨节点原子修改。GUI仅修改`串口助手_old.py`，提供18行普通参数（两种距离按轴选择）及18行独立校准参数；未知使能状态由主控判定，未失能使用独立弹窗，保护清SEQ/拖发及旧after回调。

### 13.4 代码入口及实际文件

| 实际文件 | 用途 |
| --- | --- |
| [protection_protocol.h](E:/Dummy-code/firmware_new/protection_protocol.h) | 0B/0C、30～35载荷、阶段、原因、参数及动作5 |
| [protection_coordinator.cpp](E:/Dummy-code/firmware_new/dummy-ref-core-fw/Robot/instances/protection_coordinator.cpp:83) / 同名h | 按节点事件、事务、STOP仲裁、串行回退、校准/保存、后台回执 |
| [dummy_robot.cpp](E:/Dummy-code/firmware_new/dummy-ref-core-fw/Robot/instances/dummy_robot.cpp:599) / h | 替换旧校准、统一native入口、STOP与保护门禁、固定位置同步 |
| [stall_protection.cpp](E:/Dummy-code/firmware_new/dummy-motor-fw/Ctrl/Motor/stall_protection.cpp:406)；[motor.cpp](E:/Dummy-code/firmware_new/dummy-motor-fw/Ctrl/Motor/motor.cpp:433) / h | 检测、内部规划/限位搜索、实际判稳、固定保持、优先级和原参数隔离 |
| [protection_config.cpp](E:/Dummy-code/firmware_new/dummy-motor-fw/UserApp/protection_config.cpp:36) / h | 初值、范围、整组校验、CRC和真实Flash回读 |
| 两端CAN协议/发送文件、主控ctrl_step及UserApp/main/ascii_protocol | 内部帧、状态确认重试、事件联动、任务轮询、串口命令 |
| 电机Encoder基类/MT6816及STM32端口、emulated_eeprom.cpp/h | 有效反馈和有界SPI/Flash路径、直接Flash读取 |
| 电机STM32F103CBTx_FLASH.ld / CMakeLists.txt；主控Core/Src/can.c | 存储区防重叠、保护文件构建选项、BusOff恢复 |
| [串口助手_old.py](E:/Dummy-code/串口助手_old.py)；本文、SESSION_STATUS、STOP报告 | 参数/校准UI与状态回执，实施决策及验证记录 |

参考`firmware/`、`firmware_old/`、`esp32/`、`串口助手.py`未修改；`configurations.h`和旧EEPROM.put接口无需改动。不存在“原put未初始化”问题，核对既有guard后未保留重复修改。

## 14. 初版构建、回归与待烧录验证（2026-10-06，历史记录）

主控及MOTOR_TYPE=35/42/57/8全部Release/Ninja构建成功。35/42当前使用同一控制分支，产物相同；未因J6另拆固件。主控FLASH 413428B、普通RAM 55528B、CCM64KiB为既有RTOS堆保留区；电机35/42 FLASH92948B、57 92940B、gripper92900B，RAM均9792B，均在95KiB应用区/20KiB RAM内。电机应用区余量约4.3KiB，后续功能仍必须通过链接边界检查。现有空虚函数缺return和链接RWX警告已记录，本次未修无关警告。

最终真实源码离线回归共11203断言通过：主控4042、电机/规划器/20kHz机械模型6849、配置与真实EEPROM类111、真实CAN发送及错误释放201；实际隐藏Tk界面+串口模块替身47项通过。四组脚本和源码SHA记录在[protection_regression](E:/Dummy-code/firmware_new/dummy-ref-core-fw/build/analysis/protection_regression)，`run_core.cmd/run_motor.cmd/run_config.cmd/run_can.cmd`可复跑；UI脚本在build/analysis。对生产源码再次构建、复跑，全部返回0。最后补充严格协议模型：晚到轴必须PREPARE绑定后才能GO，未完成节点失败立即取消批次；校准取消后START确实解除J8，随后普通STOP仍排除J8。

覆盖：J8闭合/半开/全开及J7正端/中心/负端完整校准；六轴失能及实际捕获；连续条件/间歇复位/J8排除；实际5°回退和规划完成但实际不动；无空间/方向/反馈/再次受阻/超时/租约失效；低ID离线不饿DIS、单次TX忙不漏续约、TERR/ALST/abort不漏信号量；晚到低编号事件串行回退；提前START、失败清挂起、全部CAL阶段START busy；缺J8/缺EVENT/错误probe/transaction不推进；保存pending不伪OK、Flash损坏失败、重复SAVE不再写/不覆盖新BEGIN、终态丢包重试；取消后的旧GO/事件/SAVED不复活旧运动；UI线程、分段回执、SEQ/拖发取消。

这些是代码/协议及理想编码器跟随+硬行程边界模型验证，尚未宣称实机通过。须由用户烧录主控及全部八节点验证实际负载、惯性、编码器噪声、阈值、承重保持及CAN硬件时序；物理接触检测在首次假定坐标下仍不能绝对区分中途障碍与真正端点，复触与行程预算不能代替限位传感器。保留原单圈启动假定，不声称掉电多圈绝对位置恢复。

建议实机顺序：先八轴DISABLE/START与参数查询；低速空载STOP和单轴堵转5°/5mm回退；回退中START/STOP/DIS及失败锁定；J8普通夹持排除；支撑六轴并失能后CAL（J7中心默认去返约200秒），观察六轴确认后1秒启动J7/J8、先完成轴保持，等两轴均结束才Disabled及实际Flash确认；最后断电重启核验默认失能/J8参考100及参数保存。异常提供完整串口阶段/原因/掩码，不只截pending。已知搜索参考边界缺陷未修复时，不要求反复顶硬限位。

未自动烧录、未提交commit。主控产物`firmware_new/dummy-ref-core-fw/build/Core-STM32F4-fw.{bin,hex}`；电机`firmware_new/dummy-motor-fw/build/motor-{35,42,57,gripper}.{bin,hex}`。

## 15. 实机误报修复及本轮决策（2026-10-06）

用户已授权先保存基线commit、再修复和编译。初版及实机待修问题已提交为`5e5eddc`；本轮修复未再次提交、未烧录。第13节的初版发送调度和第14节的旧产物/验证数据由本节及[堵转误报修复与实机测试流程](E:/Dummy-code/docs/堵转误报修复与实机测试流程.md)取代；历史决策保留以便追溯。

1. 实机7次`NODE_OFFLINE_OR_RESTART`来自主控通信/范围健康路径，不能当作7次机械堵转。分离节点通信、有效保护快照、范围/坐标版本及编码器有效性，打印PROTECT与具体原因和CAN计数；普通机械事件仍用STALL。通信故障无可靠堵转方向，沿STOP软停保持锁定，不猜测回退。
2. QUERY新增0x36原子回复，携带本次探针、坐标版本、flags、有限实际位置；不再拼接EVENT与位置作解锁证明。START范围下发COMMIT之后再fresh查询八节点确认，再复用0x0A使能保持。普通0x23/0x0A回包只计在线，不代替保护范围证明；旧EVENT不用于健康flags判断。
3. 健康探针同编号有界重试；RENEW新增非零nonce、task/version匹配确认。正常按80ms到期调度、待确认20ms重试，使用STOP未占用的控制周期；普通待授权节点继续续约，校准仅当前运动J7/J8续约，替代原八节点320ms固定轮转。1秒主控看门狗/500ms本地租约不放宽，确认不代表动作完成。两端自动重传仍关闭，未重构普通CAN目标发送。
4. 第5节普通默认值更新为90%有效电流上限、关节0.5°/地轨0.5mm误差、连续300ms、启动200ms，低速阈值及滤波不变。J6由nodeID换算，无新增35构建。回退距离、减速箱前速度、5秒超时与用户决策不变；J8继续排除普通检测。校准接触阈值独立，本轮未改。
5. EEPROM版本保持1，合法旧设置继续生效，不能宣称烧录自动调整已有阈值。必须GET确认并逐项SET，实际失能后SAVE。新的0x36和续约确认要求主控/全部八节点配套更新，混合固件不在兼容范围。GUI仅更新old，通信故障提示与机械堵转分开；事件阶段去重仍确认重传，不丢确认。
6. 五类Release/Ninja最终构建通过：主控FLASH415388B/RAM55544B；电机35/42 FLASH93068B、57 93060B、gripper93020B/RAM9792B。真实源码离线18370断言（11160/6877/132/201）及隐藏Tk/串口替身53项检查通过，包含七轴同时触发、旧快照、丢探针/续约、真实断线和NaN拒绝；不能替代实机验收。最终产物/SHA及逐条测试步骤见上述测试流程。
7. 用户日志USB ClearCommError、校准其他机械动作问题，以及既有Encoder虚函数缺return/RWX链接警告仅记录，不扩大本轮修复范围。当前仅待用户烧录复测并反馈完整日志。

## 16. 第二轮：运动期间保护回包持续仲裁（2026-10-06）

用户复测HOME/RESET时J2/J3多次PROTECTION_STATUS_TIMEOUT，通信age=4/10ms、probe=1005ms，实际参数已生效。没有机械STALL事件，不回退符合通信保护分支；本次重点从阈值转为保护回包可靠性。用户已授权继续修复；只新增修改电机`Core/Src/can.c`及文档，未新增commit、未烧录。

电机0x0A/0x0B/0x32/0x35/0x36回复独立优先队列，TXOK才出队；ALST/TERR及普通abort后保留帧，以1～4ms错开主控5ms运动周期重试。每帧最多16次尝试（含首次）/100ms生命周期，过期在途请求abort；队列满或预算耗尽不伪造完成，已有主控探针/事件/保存协议继续有界重试。未发送旧0x23合并为最新反馈，独立参数事务/配置操作和续约ACK不互相覆盖，在途帧不修改。

电机只跟踪一个在途邮箱，实际回调处理前不复用，避免旧RQCP回调误结束新保护发送。中断只更新短队列/状态，不阻塞打印或存Flash。未改主控查询时隙、1秒健康预算、500ms本地租约、两端NART设置或机械回退/校准逻辑；本轮无新GUI功能。

真实电机CAN回归新增27308断言，持续低ID运动仲裁模型（每5ms前2ms、每160msQUERY固定撞相）中基线八node3秒0条保护回复，新版各19条、最大探针年龄160ms；包含三邮箱完成/错误/abort/旧RQCP、HAL忙、16次/100ms边界、回绕和独立回包。其它四组重新运行，总45678断言通过。仲裁计数可增长，不把ALST归零作为验收条件；模型不能断言实际每次丢在哪一端。

全部Ninja/Release构建通过。主控BIN未变；电机35/42 95572B、57 95564B、gripper95524B/RAM10336B，应用区最小余量1708B。用户只需更新八电机，主控保持上一轮。当前产物/SHA、文件用途及静止2分钟→HOME/RESET10轮→STOP/真正堵转回退的步骤见[测试流程第9节](E:/Dummy-code/docs/堵转误报修复与实机测试流程.md)。实机尚待验证，USB及校准其它问题未扩大修复。

## 17. 普通堵转电流命令默认门槛改为40%（2026-10-07）

用户反馈J7总限流3.0A时，受阻过程中电源端整机电流约1.6A，并明确要求将普通堵转初始化电流命令门槛从90%改为40%。按此作为新的试验基准：`CURRENT_A = max(0.1A, 初始化有效电流上限×0.4)`；2.5A对应1.0A，3.0A对应1.2A。0.1A底限用于兼容既有参数合法范围，防止低于0.25A的额定设置生成不合法默认组，不改合法范围。电源端整机电流和focCurrent命令不能直接换算，该观察不单独证明电机实际命令值。

本轮只改普通初始化CURRENT_A及目标助手1.0A建议初值；电流、速度、误差三条件与连续300ms计时仍必须全部成立。普通回退再受阻门槛继续为`min(CURRENT_A, 0.8×BACK_CURRENT_A)`，因此较低CURRENT_A也会提高回退受阻检测敏感度。回退/保持电流、距离、速度、5秒超时、校准CAL接触参数、STOP与解锁语义均不改。

有效EEPROM仍优先，烧录不自动覆盖旧门槛；本轮实测须DISABLE完成后显式STALL_SET并GET回读，确认后另行STALL_SAVE。提高普通限流不自动重算门槛；既有“降低限流使门槛超限时改为新上限80%”逻辑未在本轮改动范围内，发生此情况后须重新GET/SET所需阈值。当前助手1.0A只作为典型2.5A节点的编辑初值，J7实际3A时应读取/设置1.2A。

第15、16节构建和实机记录为历史状态；本次实际编译和产物以SESSION_STATUS最新记录为准。
