Liu3Beng-A/Dummy/docs/堵转误报修复与实机测试流程.md

# 堵转误报修复与实机测试流程（更新至2026-10-07）

## 当前交付：按用户最终实测值更新校准默认（2026-10-07）

用户20:03日志确认CALIBRATION ok、八轴失能与保存完成，随后START、HOME约4395ms、RESET约4402ms正常完成；20:04回读的完整J7/J8参数为本轮默认依据，见方案第13.3节。用户同时调整了速度/加速度/复触容差等多项，不能把整轮成功视为仅放宽位置容差的因果验证。

- J7：SEEK/RETURN=5/5r/s，RETOUCH=.5r/s，ACCEL=3r/s²，CURRENT=2.5A，CONTACT_RATIO=.3，SPEED/ERROR=.02/.02，TRIGGER/STARTUP=100/100ms，MAX_TRAVEL=101r，SEEK/RETURN/RETOUCH_TIMEOUT=220000/120000/5000ms，BACKOFF=1r，REPEAT/POSITION_TOL=.05/.005r，CONTACT_WINDOW=1r。
- J8：SEEK/RETURN=2/2r/s，RETOUCH=.5r/s，ACCEL=5r/s²，CURRENT=1A，CONTACT_RATIO=.2，SPEED/ERROR=.02/.02，TRIGGER/STARTUP=100/100ms，MAX_TRAVEL=6r，SEEK/RETURN/RETOUCH_TIMEOUT=30000/15000/5000ms，BACKOFF=.5r，REPEAT/POSITION_TOL=.1/.01r，CONTACT_WINDOW=.222222r（源码仍精确使用5×16/360）。校准命令电流仍受总限流限制，不覆盖现有PID/HAND_I。

本轮只更新电机校准默认和old助手未回读初值；保留普通STOP/堵转、真实完成判稳、校准六轴后等待1秒再并行、失败取消和完整成功后自动失能保存的行为。编译/软件核对结果与产物以SESSION_STATUS当前首节为准，不把本轮软件检查计作额外实机验收。

如烧录，J7用motor-57.bin、J8用motor-gripper.bin（同目录HEX）；主控无本轮源码改动，无需因默认值更新重烧主控，保留EEPROM与编码器校准表。你本次实机已保存最终值，正常情况下无需再次手工设置或为默认值改动重复顶限位。已有其他合法EEPROM参数仍优先于新默认，可失能后CAL_GET回读核对；不整片擦除来强制默认。将来参数更新经SET/GET确认，独立CAL_SAVE须实际失能；整轮校准成功也会自动保存当前参数，因此不能把未发送CAL_SAVE称为只在RAM试调。

以下“本轮待烧录”等段落为此前轮次的历史记录，当前默认以本节和方案参数表为准。

## 本轮交付：校准接触确认期限修复（2026-10-07，待用户烧录）

CAL_SEEK/CAL_RETOUCH参考停止后的确认上限改为1000ms + CAL_TRIGGER_MS；100ms配置对应1100ms，默认150ms对应1150ms。连续条件一旦满配置时长即进入接触减速/实际判稳，不强制等到上限；间歇满足仍清零，期限不续期，参考位置和实际行程保护均保留。阶段总超时仍可能先到期。本轮生产源码仅改电机stall_protection.cpp，其他生产模块、默认参数、EEPROM、协议和助手沿用。

### 本轮烧录和测试

1. 只需更新J7的`firmware_new/dummy-motor-fw/build/motor-57.bin`和J8的同目录`motor-gripper.bin`（同目录HEX也已生成）。保留EEPROM和编码器表；已安装上一轮CAL_STATUS配套主控时，本轮主控无需重烧。35/42也已重新构建，但此逻辑仅J7/J8校准使用。
2. 失能状态分别回读`#CAL_GET 8`、`#CAL_GET 7`并保留完整结果。保留此次实测参数，包括用户已设的TRIGGER_MS=100，先不同时改变速度、退让距离、误差、限流或滤波；烧录不会强制覆盖有效EEPROM。本轮没有新增需要设置的确认窗口命令。
3. 在机械臂支持好、六轴姿态应标为REST_POSE且地轨/夹爪路径可运行时执行一次`!CALIBRATION`。六轴完成→WAIT1000ms→J7/J8并行；重点观察J8 phase10退开后，phase11复触能否进入phase12返回并最终phase13完成，夹爪应回到100、地轨回到0。两轴完成后才八轴失能、保存，最后返回`!CALIBRATION ok`和`Disabled ok`。允许因实际速度稳定过程多等待一段，但不是固定新增1秒。
4. 校准期间在自由行程发一次`!START`应返回busy且不挂起；本轮仍不能在校准结束后意外使能。STOP/DISABLE中断、无接触/反复候选/超时已做离线验证，不要求专门继续顶物理限位来复现失败。
5. 若本轮失败或机构出现异常，先`!DISABLE`，等Disabled ok后依次读取`#CAL_STATUS 8 LAST`、`#CAL_STATUS 7 LAST`，各等end req再查询下一项，保留完整日志及CAL_GET。先取冻结记录再重新校准或重启，避免覆盖首次原因；同伴CANCELLED_STOP不作为独立接触失败。取消或失败不得返回校准成功，也不得开始保存不完整校准。

### 本轮软件验证

旧代码受控复现22项断言通过，记录确认截止抢先于100ms连续候选；新代码专用3192594项断言通过（含大量周期/边界循环），同一输入在430.85ms接受。原搜索边界/冻结快照798869、电机完整保护/校准7040、主控STOP/并行/诊断24732项回归通过。规定输入不代表实机速度波形，也不保证最终实机验收。

五构建Ninja检查通过：四电机本轮重编译，主控无待构建工作且产物校验与前轮相同；五组BIN/HEX逐字节一致、95KiB电机区合规、原串口助手.py未改、生产范围及测试源hash校验通过。电机RAM10704B，最少Flash余量452B，既有RWX告警保留。具体产物大小、SHA和文件范围见SESSION_STATUS首节。未提交或操作硬件。

以下搜索边界/快照交付为此前已完成记录；本轮测试与烧录以本节为准。

## 本轮交付：有界搜索与校准失败快照（2026-10-07，待用户烧录）

已修复CAL_SEEK/CAL_RETOUCH参考微过冲造成的抢先SEARCH_TRAVEL，实际行程保护和连续接触条件保持；参考到达上界后有限等待，仍无证据则CONTACT_NOT_CONFIRMED。新增CAL_STATUS运行/首次失败快照，能够在STOP锁定或失能后经主控USB读取。记录在新校准任务实际接受或重启时清除，请先取证再重试。原日志对应的真实电流/速度条件未知，本次不宣称实机已验收。

### 烧录与无运动检查

1. 配套更新主控`firmware_new/dummy-ref-core-fw/build/Core-STM32F4-fw.bin`、J7的`firmware_new/dummy-motor-fw/build/motor-57.bin`、J8的同目录`motor-gripper.bin`（同目录有HEX）。四种电机均已重新编译，如需全节点统一构建可同时更新J1～J6对应35/42；本轮修复与新增CAL诊断只作用J7/J8。保留EEPROM及磁编码器表，不做全片擦除强制默认。
2. 重启使用更新后的串口助手_old.py连接主控USB，`!DISABLE`等Disabled ok。逐条`#CAL_GET 7`、`#CAL_GET 8`核对实际CONTACT_RATIO=.3和原其他设置，本轮未自动写节点参数。不要为本轮一次试验同时改一组阈值。
3. 逐条`#CAL_STATUS 8 LAST`、`#CAL_STATUS 7 LAST`，各等`end req=...`后再查询下一项。首次无记录应看到no_failure_record。再读`#CAL_STATUS 8`/`7`确认LIVE回包；不应引发运动或改变锁/使能。保护参数窗口CAL页对应“读取校准快照/读取失败快照”按钮。

### 一次受控校准与取证

1. 支撑好六轴，确认当前姿态应按既定方案标为REST_POSE，地轨及夹爪运动路径无物体阻挡、有原确认行程。在失能状态发`!CALIBRATION`，保存全日志。
2. 六轴各phase13确认→CAL WAIT 1000ms→约一秒后J7/J8 SEEK；两轴各自寻端、退让phase10、复触phase11、返回phase12、完成phase13。先完成轴保持，全部成功才自动失能、保存并返回!CALIBRATION ok。J7因J8失败停下仍是既定联动，不能当作J7接触检测独立失败。
3. 若夹爪闭合后仍无退让，或出现啸叫/异常顶压，立即`!DISABLE`；不要为等快照连续顶限位或重复校准。取消不能保存不完整结果或返回成功。确认已失能后，依次读`#CAL_STATUS 8 LAST`和`#CAL_STATUS 7 LAST`，各等end后再下一项；先读首次根因记录，再新CAL或重启。已失败随后DISABLE不覆盖原始原因，主动取消只有CANCELLED_DISABLE记录也如实保留。
4. 重点保留I_cmd/I_filt/I_thr/I_cap、v_raw/v_filt/v_thr、err/err_thr、unmet、timer/need/peak/last、clear/detail、actual_travel/ref_travel/max_travel、phase与failure_reason。unmet=1/2/4分别代表电流命令、速度、误差条件未满足，可相加；clear=CONDITIONS的detail同该掩码。SEARCH_TRAVEL配实际行程越界/目标溢出取证；CONTACT_NOT_CONFIRMED表示固定参考等待后缺连续接触证明，不是实际超行程。LIVE在DISABLE后为停机状态，不能替代LAST故障前值。
5. 正常校准能走完后，再在自由行程检查35档普通HOME/RESET/往返无末端STALL，STOP/START保持当前停点、不恢复旧目标；校准期间START仍busy不挂起。取消/START门禁已做离线回归，无需为了取证再顶限位测试。

### 已完成的软件验证与边界

主控24732、真实电机/保护/规划器与理想CAL7040、配置/EEPROM170、专用CAL边界/快照770841断言通过（含大量周期边界断言）；隐藏真实Tk诊断106及原顺序/分包/模式410通过。专用测试覆盖正负搜索/短复触参考限幅与积分清零、真实编码器行程超限、迟到接触证据接受、未达条件有限失败、间歇候选清零、反馈失效、首次快照跨STOP/START/DISABLE保留及新task清空。主控包含真实ASCII读门禁、CAN缺包重传/超时、无记录、非运动查询及原并行租约/取消/保存测试。规定输入和理想随动不是实机测得电流/速度，也不是验收。

五固件Ninja通过，BIN/HEX逐字节对应，旧参考助手校验未变，git diff --check通过；原95KiB电机区最少剩436B，RAM10704B，未扩Flash/编码器表/EEPROM区域。原RWX/编码器虚函数警告未顺手修改。完整产物校验和见SESSION_STATUS首节。无commit、设备参数写入、烧录或实机操作。

以下“搜索缺陷待修复/电机不用更新”是历史轮次交付状态，本节为当前指引。

## 六轴完成后等待1秒，J7/J8并行校准（2026-10-07）

用户已授权主控调度改为六轴坐标完成确认齐全→CAL WAIT 1000ms→J7/J8同轮并行。两轴各自寻端/退让/复触/记录坐标/实际返回并判稳，先完成轴保持；两轴本任务的新鲜完成回执齐全后才CAL DISABLING、CAL SAVING和最终!CALIBRATION ok。帧经CAN依次发送，SEEK日志表示进入并行调度，不等同于已接受本地运动或同毫秒启动。

更新主控固件后先在失能、六轴支撑好且地轨/夹爪可安全运动的状态核对CAL_GET 7/8；上一轮30%默认不覆盖已有EEPROM，应先显式设置回读。日志应在六轴全部CAL_DONE后出现CAL WAIT 1000ms，约1秒后两轴SEEK都出现；一轴完成时不会开始保存。等待期间或两轴正常低速运动期间的START必须busy、不挂起，STOP/DISABLE取消后两轴不能继续剩余校准，也不能返回校准ok。已确认的SEARCH_TRAVEL参考边界缺陷仍待单独修复，不要求再次持续顶硬限位。

主控Ninja编译成功，BIN434360B、SHA256 e3480d0085c7badff5701566e9aa54340ed96ab4090c55f66da504aed28b14ad；RAM56384B、原RWX告警保留。四电机Ninja无需重编译，沿用上一轮30%电机产物。实际主控/STOP离线24572项及隐藏真实Tk72项通过：999/1000ms边界、两种完成顺序、错误任务/NaN/过时回执、先完成轴不保存、CAN忙/续约丢回复与单帧预算、单轴失败/完成后掉线取消整轮、等待和运动阶段STOP/DISABLE及START busy。循环断言及理想CAN同行耗时不是实机接触验收。五BIN/HEX及git diff --check通过；电机内部动作、普通STOP/串行回退、EEPROM格式本轮不改，未连接设备、烧录或commit。

## 校准接触比例30%交付与应用（2026-10-07）

用户已授权J7/J8共享CONTACT_RATIO默认80%→30%，电机默认和old助手编辑初值同步。本轮普通堵转40%及其他CAL参数/流程不改；下文“本轮未改CAL”等描述属于此前默认值提交时的状态。

已有EEPROM不会被新默认覆盖。先`!DISABLE`等最终Disabled ok，然后逐条发送以下命令，每条等最终完整响应后再发送下一条：

```text
#CAL_SET 8 CONTACT_RATIO 0.3
#CAL_GET 8
#CAL_SAVE 8
```

GET确认CONTACT_RATIO=0.3后才SAVE。若需要把J7已保存参数也改为30%，对应使用节点7；不要同时改动普通STALL电流门槛或总限流。本次没有自动连接设备、应用参数、烧录或提交。实际校准限流1A时触发电流命令门槛为0.3A，不是电源实测电流；仍要求低速/误差持续150ms。

已确认的校准搜索参考越边界缺陷仍未修复，此处只交付参数调整，不保证SEARCH_TRAVEL随之消失、不要求反复顶硬限位来验证。

四电机Ninja编译通过，主控无需重编译；配置/EEPROM170项、隐藏Tk66项及实际生产电机/保护/规划器的理想校准模拟7040项通过，git diff --check通过。验证包含新默认30%和合法EEPROM保存80%仍优先加载、助手回读值优先显示。理想模拟不能证明实机空驶不会误触发。最新BIN大小及SHA见SESSION_STATUS当前首节，既有RWX链接告警保留；本轮未烧录、未提交。

## 最新验收与默认值交付（2026-10-07）

用户反馈上一轮末端修复“测试没有什么问题”，已确认日常默认值并授权本轮修改后提交。下面历史章节中的“待实机验收/未获commit授权”属于各轮当时状态。此次新增生产改动仅`dummy-motor-fw/UserApp/protection_config.cpp`普通TRIGGER_MS由300改100及单位注释、`串口助手_old.py`同项编辑初值；三份文档同步。本次提交同时包含此前已验收的目标确认/保护接管、STOP与回退入口、普通末端检测、LIVE/LAST快照及40%电流门槛改动。

日常默认：J1～J7 ENABLE=1、CURRENT_A=初始化限流40%（最低0.1A）、SPEED_RPS=.02；关节ERROR_R对应0.5°（J1～J5=.0694444圈/J6=.0416667圈），地轨=.1圈即.5mm；TRIGGER_MS=100、STARTUP_MS=200、电流/速度滤波10/20ms。回退5°/5mm，电机轴速度3/.5圈/s、加速度5圈/s²、回退及保持限流=初始化总限流、到位容差.001电机圈、超时5000ms、REBLOCK100、GRANT_WAIT500。J8排除，START下发实际软限位，不放宽方向/位置/编码器证明。100ms仍需后续各轴带载验证，不把前轮试验通过当作这组新默认全部验证完毕。

### EEPROM生效与后续实测

1. 重新烧录不会覆盖合法保护EEPROM；用`!DISABLE`等最终ok后，先回读各节点`#GETI n`和`#STALL_GET n`。40%只在生成默认值时计算，实际保存的阈值不会随着总限流提高自动变为40%。例如限流1/2.5/3A，对应默认门槛.4/1/1.2A；不自动提高限流。
2. 若需要让原J7试验设置改为本次日常值，应在失能下显式设置CURRENT_A（按实际限流40%）、SPEED_RPS=.02、ERROR_R=.1、TRIGGER_MS=100、STARTUP_MS=200、CURRENT_FILTER_MS=10、SPEED_FILTER_MS=20。逐项等最终回执，回读确认后再`#STALL_SAVE 7`；若之前改过BACK_ACCEL=10而希望整组与默认一致，还需显式设回5。不要把保存按钮当作恢复默认。
3. J1～J6同样按节点回读/必要时设置；ERROR_R不能照搬地轨值，J6减速比为30。回退和保持电流如需恢复到当前总限流，也应显式设置并回读；本轮固件不改变有效保存值。
4. 正常行程先用35档SEQ做HOME/RESET/往返，每条等对应id最终ok再停留1～2秒，验证无末端误报及STOP/START不恢复旧目标。必要时再分轮验证可立即撤开的低能量软阻挡、5mm反向空间及回退成功；不要求为默认值验收反复撞硬限位。
5. 自然出现STALL时结束动作/失能后读取`#STALL_STATUS n LAST`与LIVE保存证据。CURRENT_CMD_LIMITED为持续命令饱和诊断，不是普通STALL或实测电流报警。

本轮不改变CAL参数（CAL_TRIGGER_MS仍150ms）或流程。提交后继续讨论`!CALIBRATION`，先核对实际实现与用户已确认决定。

### 本轮编译与检查结果

四电机Ninja重新编译链接成功，主控Ninja确认当前产物已是最新；主控BIN434016B、35/42/57/gripper为97260/97260/97252/97212B，均在原Flash分区内。配置/EEPROM165项、末端和冻结快照主控123/电机182717项、隐藏真实Tk默认及诊断63项、原顺序/分包/模式410项通过，git diff --check通过。配置验证含40%换算、低电流0.1A下限、J8排除、CAL_TRIGGER_MS仍150和旧EEPROM TRIGGER_MS=50优先于新100默认；测试含循环断言并非相同数量的机械用例。原串口助手.py校验未变；既有RWX告警保留。产物路径未变，最新SHA见SESSION_STATUS首节和ignored的endpoint_fix_artifacts.json。本轮未连接设备、写参数或烧录，新默认尚待实机验证。

## 最新交付：普通运动末端误触发修复与首次触发快照（2026-10-07）

用户确认14:58～15:06日志的分析后授权“同意，开始修改”。本节覆盖当前交付；下文保留历史。固件、old助手修改完成，五目标编译和离线验证通过，未连接真实串口、烧录或提交commit，实际效果待用户验收。

### 改动与边界

- 主控普通MOVEJ/HOME/RESET使用的电机COMMAND_POSITION链路，目标启动意图改用普通到位容差（J1～J6约±0.1°，J7±0.1mm），不再借用BACK_POS_TOL_R。
- 实际编码器位置和规划参考位置都进入当前目标的普通容差时，门禁显示ARRIVAL并清连续堵转候选计时，防止末端小误差和保持电流触发；保留运动意图并继续等实际完成。只实际位置进入、只规划参考进入、反馈无效或模式不匹配，都不能用此门禁代替真实完成或保护检查。若离开该范围，计时从零重新开始；不是累积间歇条件。
- 成功回复仍依赖规划位置精确到目标、规划速度为0、编码器实际位置在普通容差内、连续50ms位置范围/平均速度证明及原有健康条件。稳定范围仍约.02°/.02mm，平均速度门槛仍.01电机r/s；不放宽普通完成、STOP或内部回退的证明，不凭规划器走完提前ok。
- 本节点首次真实普通完成后清motionIntent、连续计时、滤波和旧方向，保留固定运动目标和PID/积分控制。查询显示NO_MOTION、clear=COMPLETED。同目标且实际仍在普通容差内的重发不重启检测；新目标需要实际移动时重新建立意图、方向及启动豁免。完成锁存/OLED稳定显示、全机新鲜目标确认与同步规划不变。
- 末端门禁不要求参考速度先为0：参考与实际都已进入允许范围即可暂停候选计时，避免最后几个参考周期继续误判；但完成窗口仍要求原严格规划终点。此为落实末端修正保护的常规细化，不改变目标或运动速度。
- 回退再次受阻、物理限位/方向、联动停止、全七轴STOP确认、提前START、用户STOP/DISABLE取消和失败锁定保持原行为。直接电机Trajectory/PWM/STEP_DIR模式的旧保护退出路径不扩展50ms普通完成，本轮结论只适用于上述主控普通位置命令链；CALIBRATION仍有独立实际反馈证明。没有顺手调整REBLOCK或校准接触参数。

### 查询触发瞬间

```text
#STALL_STATUS 7          // 当前运行快照
#STALL_STATUS 7 LAST     // 最近一次本地普通STALL的冻结快照
```

实际发送命令不要带上述说明注释。节点只能为1～7，0/ALL与J8拒绝。old助手“堵转/校准参数”窗口新增“读取触发快照”，按所选节点发送第二条命令；原“读取运行快照”保留。两种只读查询可在STOP/堵转/校准锁定期间执行，不解锁、不清队列、不改参数。

触发快照在电机三条件连续达标、准备进入软停之前一次性捕获，包含原有模式/意图/反馈/滤波电流与速度/跟随误差/连续时间/阈值，再增加event、最终目标误差goal_err、规划参考速度v_ref、历史方向dir及经安全校验的stall_dir。快照的phase=0、stop_lock=0属于接管前数据，是正常现象；record=LAST及trigger_reason=STALL标识冻结记录。原来的at_ms为捕获时的电机上电时间，req只标识当前查询，不是事件发生时间。

- `err`为softPosition-realPosition；`goal_err`为goalPosition-realPosition，单位电机圈，J7乘5换算mm。`v_ref`是softVelocity，单位电机圈/秒。`I_cmd/I_filt`为输出电流命令及其滤波幅值，不能解释为实测绕组/整机电源电流。
- `dir`为检测记录的规划运动方向；`stall_dir`为触发时完成误差一致性等校验后允许用于回退的方向，0表示不可信。实际回退方向仍是其反方向；没有删除NO_DIRECTION保护。
- 记录只存在RAM，保留至下一次本地普通STALL或重启。STOP、DISABLE、START、新运动、同伴STOP、回退失败及校准接触都不覆盖原始普通堵转证据。尚未发生普通STALL时明确返回no_trigger_record，然后end req，不用当前失能数据冒充触发快照。
- 请求/版本/节点匹配和全字段收齐后再打印，重试使用首次查询复制的完整记录，即使其间出现第二次堵转也不会混合两次事件。快照捕获只做整数/RAM拷贝，不在20kHz循环打印或发送多帧诊断。
- CAN仍为0x37/0x38；请求第0字节0=LIVE、1=LAST。只读诊断版本从1升为2，字段从19增加到24；控制EVENT/STOP协议、EEPROM版本和格式不变，必须配套更新主控与相关电机才能正常查询。不能把诊断版本更新理解为修改持久化格式。

### 文件与验证

本轮修改电机`Ctrl/Motor/motor.cpp/.h`及`stall_protection.cpp`，共享`firmware_new/protection_protocol.h`，主控`Robot/instances/protection_coordinator.cpp/.h`，根目录`串口助手_old.py`；同步本文、方案文档和SESSION_STATUS。没有修改`串口助手.py`、参考firmware、PID、默认限流、默认堵转参数、运动同步、Flash分区或EEPROM布局，保留之前已有未提交工作。

新增验证直接执行当前生产源：J1～J7正负/边界残差、.001圈误差与50ms触发等敏感参数、末端两侧的位置和参考分别未到位、规划未结束不能完成、振荡/无效编码器不能完成、进出末端范围连续计时清零、完成后不重触发和新运动重新武装；LAST无记录/首次冻结/失能与使能后保留/同伴及取消不覆盖/新事件与查询重试不混合、严格ASCII语法及锁定期间查询。主控123项、电机182717项断言通过，断言数包含周期循环，不是相同数量的独立机械用例。

兼容回归：回退入口及STOP重试主控41815/电机45817项，普通完成等组合主控38830/电机45501项，保护接管主控161797项、57目标采纳172项，主控CAN5817/电机CAN54657项，配置/EEPROM132项；隐藏真实Tk新按钮54项、原顺序/分包/模式竞争410项。均为规定反馈/硬件替身的离线测试，不能冒充实机验证。脚本在忽略的`build/analysis/protection_regression/`：`run_endpoint_fix.cmd`、`endpoint_fix_ui_test.py`及既有回归；SHA/产物清单`endpoint_fix_artifacts.json`。

五个Ninja目标通过，主控BIN434016B、普通RAM56384B；35/42/57/gripper的BIN为97260/97260/97252/97212B，电机RAM10592B，仍在原95KiB应用区（最小余量20B）。快照初版曾超出164B，仅对低频CAN位置设置函数沿用局部Os，以及新查询/一次性捕获沿用Os；连续20kHz闭环、PID、检测/判稳循环的优化选项不变。保留既有RWX及编码器基类缺return告警，不扩修无关模块。

### 本次实机测试顺序

1. 主控与J1～J7配套烧录当前build下BIN/HEX；J1～J6按实际35/42类型，J7用motor-57。J8产物也已生成，可一并更新。保留EEPROM及磁编码器校准表，不做整片擦除；重启old助手加载新按钮。合法EEPROM仍优先，因此本轮敏感设置不会因烧录变成默认值。
2. `!DISABLE`并等Disabled ok，依次完整回读`#GETI 7`、`#GET_PID 7`、`#STALL_GET 7`。先保留上一轮参数作同条件对照：已知J7限流1A、CURRENT_A=.2、ERROR_R=.001、TRIGGER_MS=50、STARTUP_MS=10、SPEED_RPS=.02、BACK_MM=5。不再因复测改成3A或提前保存另一组参数。先查询LAST，应明确no_trigger_record；该查询不使能。
3. `!START`完成后，在已确认可以自由通行的行程内测试HOME/RESET与原35档正负点位；SEQ下每条等对应id的最终ok，再停留1～2秒观察是否有结束后的STALL。分别正常往返3～5轮，记录完整毫秒日志和OLED。90档仅在35档正常且行程无异常后再做，不混入首轮。
4. 普通运动中STOP→STOP locked→START，验证保持停点、不恢复旧目标；再发一条新目标验证能够重新运动，DISABLE应仍可失能。没有实际堵转时LAST仍应无记录。
5. 若自然出现STALL，先让保护动作完成或执行DISABLE，解除实际受阻，再查询LAST并等end req；另查一次普通STATUS作对照。需要event、at_ms、mode/phase/gate、I、速度、err/goal_err、timer、dir/stall_dir全套行，不能只贴最后的NO_DIRECTION。即使失能后实时电流/意图为0，LAST仍保留触发数据。不维持啸叫、不要求故障中强行查询或再次撞硬限位取证。
6. 正常运动通过后，如需要确认真实受阻保护仍可用，仅J7在已验证1A下以低速小行程遇到可立即移开的软阻挡，保证5mm反向空间；出现STALL后撤开阻挡，观察phase3→4及STALL locked。首次正常通过后再分轮验证回退中的提前START、STOP与DISABLE。此次不要求再撞硬限位，也不通过持续受阻验证。

本轮尚未单独重设计回退REBLOCK判据；5mm/.5rps动作应依旧在5秒内完成，若再出现REBLOCKED/超时，保留日志与LAST作为最初触发依据，回退失败瞬间尚无独立冻结记录，不能据LAST推断末端再次受阻的全部物理原因。

## 最新交付：目标确认与堵转保护接管修复（2026-10-07）

本节为当前烧录/验收流程，下文保留此前轮次。用户已授权本轮实施，并明确解除“首个堵转事件ISR临界区缺陷”的暂缓决定。本轮没有提交commit或连接硬件，实机验收仍待用户进行。

### 修改内容与常规决策

- 电机普通0x23扩展回复中，TARGET_READY只证明期望位置已被采纳为当前位置目标；运行健康、判稳和电流命令饱和分开。新增DRIVE_BLOCKED=0x20、CURRENT_CMD_LIMITED=0x40；原目标、位置、规划器、反馈、SETTLED和nonce字段保持。电流命令持续顶到上限约1秒仍置原overloadFlag；没有删除原诊断、提高限流或把饱和直接等同机械堵转。
- 当前命令饱和不再撤销目标确认，也不单独授权回退。主控按饱和状态由无到有自动打印`MOTION id=... J7 CURRENT_CMD_LIMITED`；它不是实测电流报警。SETTLED仍要求实际位置/速度窗口等原条件通过且无运行阻断/饱和，不能因此提前ok。
- 首次尚未收到目标确认时继续有界重试；已经采纳的目标被改掉时明确TARGET_CHANGED，运行阻断明确MOTOR_DRIVE_BLOCKED，而不是重发旧目标或混报TARGET_READY_TIMEOUT。真实丢帧的100ms TXOK、300ms初次READY预算与16次发送上限保留。失败打印冻结的各异常轴f位图；f中0x20为阻断、0x40为电流命令饱和。
- 内部投递/上述运行故障转入七轴STOP_PROTECTION保持锁定，保留已经存在或晚到的本地堵转事件。只有收到真实LOCAL_STALL事件并完成既有停稳/PREPARE/租约确认才发送RETREAT_GO。没有事件时只停稳锁定，绝不猜测堵转或回退方向。
- CAN接收中断立即禁止普通运动、更新运动epoch并记录事件；取消运动、CAN在途清理和清队列由任务执行。保护接管状态转移在任务临界区内完成，防止用户STOP/DISABLE取消后又消费旧trigger重新启动回退。
- 用户STOP/DISABLE仍取消内部动作并抑制晚到事件；回退期间提前START仍挂起，全部成功后保持当前位置解锁，失败不自动解锁。J8继续排除普通堵转检测。
- 新版电机普通状态查询函数仅此函数使用Os局部体积优化、反馈有效性只读取一次，解决新增状态使95KiB应用区超出几十字节的问题；20kHz闭环与检测源码/编译优化不变，不改CMake、Flash/EEPROM布局。

本轮生产文件：共享`firmware_new/motion_completion_protocol.h`；电机`Ctrl/Motor/motor.cpp`；主控`Robot/instances/dummy_robot.cpp/.h`和`protection_coordinator.cpp/.h`。同步本文、方案文档和SESSION_STATUS。无新串口命令或GUI控件，old助手现有原始日志/MOTION_STATUS按钮可用，本轮未改两份助手；此前已授权的诊断改动保留。未改PID默认、电流默认、速度/加速度、运动同步数学或校准行为。

### 编译及离线证据

- 主控、35/42/57/gripper五目标Release/Ninja均成功。主控BIN432184B、RAM56384B；四电机RAM10472B、BIN分别97252/97252/97244/97204B，均在95KiB内，最小余量28B。既有RWX/编码器基类缺return警告保留。
- 真实源码离线回归：含ISR任务API禁用检查及普通运动/保护/校准的主控158114项断言；电机普通完成/STOP/保护/校准45476项；新增57电机目标采纳/电流饱和/保护STOP172项；主控CAN5817项；电机CAN54657项。硬件、RTOS调度与编码器/机械反馈用替身或规定输入，不能冒充实机验收。
- 新增覆盖：J1～J7首事件ISR零任务临界区/零邮箱清理/无队列变动；任务取消；1A限流持续饱和后仍保留目标确认；真实目标变化/驱动阻断不重发旧目标；堵转先到或确认失败先到的接管；晚到事件最终PREPARE/GO/提前START完成；用户STOP/DISABLE优先取消并拒绝迟到回退；无堵转事件不发GO；失败f快照不受后续实时字段改写影响。
- 复跑脚本`firmware_new/dummy-ref-core-fw/build/analysis/protection_regression/run_handoff.cmd`，既有`run_completion.cmd/run_can.cmd/run_motor_can.cmd`；产物/源码SHA清单`build/analysis/motion_protection_handoff_artifacts.json`。build目录为忽略的分析产物。

### 烧录范围

主控和J1～J7必须配套更新；J8不参与普通完成/堵转，本轮可以保留上一轮已验证固件，也已生成夹爪产物供一并更新。保留现有EEPROM/编码器校准数据，不做整片擦除。烧录不会覆盖合法EEPROM中的KD=300或BACK_MM=20。

| 对象 | BIN完整路径 | SHA256 |
|---|---|---|
| 主控 | `E:\Dummy-code\firmware_new\dummy-ref-core-fw\build\Core-STM32F4-fw.bin` | f6e5bacc918d76b5f8a7ac6f6b15bb862c1113bb0203c42bcd003629b99ee27d |
| 35 | `E:\Dummy-code\firmware_new\dummy-motor-fw\build\motor-35.bin` | b064e2f68395bdbd03ce5a55e88129465bdd49c294374f059d2d0befdebd3253 |
| 42 | `E:\Dummy-code\firmware_new\dummy-motor-fw\build\motor-42.bin` | 同35 |
| 57/J7 | `E:\Dummy-code\firmware_new\dummy-motor-fw\build\motor-57.bin` | e78d31c72f9bf9f17127371b6c7f9b73b7b9e44dbf1ef9ce5d4c572ec42fb5f8 |
| 夹爪 | `E:\Dummy-code\firmware_new\dummy-motor-fw\build\motor-gripper.bin` | 1533024aeecfff60ad54c43a8cdd509732cf5e4f984acf7c9e67076e9c9eab5d |

### 实机步骤：先普通运动，再一次低能量软阻挡

1. 上电先DISABLE并等待Disabled ok，查询并保存`#GET_PID 7`、`#GETI 7`、`#GETJACC 7`、`#STALL_GET 7`完整输出，作为回滚依据。检查对象确实为J7，不用J1快照推定J7状态。测试不SAVE、不加&，不改变承重关节电流；J7保持1A。PID若仍KD=300，可仅在RAM按此前实测值设置`#SET_PID 7 300 50 30 100`并回读，这只是控制变量，不是本轮自动修改EEPROM。
2. 先在已有确认安全的行程内、不阻挡地轨，START完成后切SEQ，HOME↔RESET及地轨小行程正反向各3～5轮，每条等待自己的ok后再下一条，取一份MOTION_STATUS。不得出现提前ok、OLED完成标记反复重开、约1秒后因饱和变成TARGET_READY_TIMEOUT。CURRENT_CMD_LIMITED单独一行不等于堵转；若出现，保存日志，确认后续到位或明确保护，不提高限流强行通过。
3. DISABLE后逐条发送以下J7参数，等每条最终SET回执再发送下一条，并最终STALL_GET回读。它们是一次性、较易触发的RAM测试参数，不是推荐长期生产参数。BACK_MM必须恢复5；20mm/.5r/s至少8秒，与5秒超时不相容。

```text
#I_LIMIT_J 7 1.0
#STALL_SET 7 ENABLE 1
#STALL_SET 7 CURRENT_A 0.2
#STALL_SET 7 SPEED_RPS 0.2
#STALL_SET 7 ERROR_R 0.01
#STALL_SET 7 TRIGGER_MS 100
#STALL_SET 7 STARTUP_MS 200
#STALL_SET 7 CURRENT_FILTER_MS 10
#STALL_SET 7 SPEED_FILTER_MS 20
#STALL_SET 7 BACK_MM 5
#STALL_SET 7 BACK_RPS 0.5
#STALL_SET 7 BACK_ACCEL 5
#STALL_SET 7 BACK_CURRENT_A 1
#STALL_SET 7 HOLD_CURRENT_A 1
#STALL_SET 7 BACK_TIMEOUT_MS 5000
#STALL_GET 7
```

4. 在行程中部、有回退余量的位置，只让J7向空旷方向低速移动约10mm，关节保持已有当前位置；速度档位1。仅当关节确在REST、地轨坐标0确在行程中部时，示例为`>0,-75,180,0,0,0,10,1`。使用可让开/有弹性的软阻挡在滑台侧造成短时受阻，避免手接触丝杆、联轴器和传动夹缝；不撞物理硬限位，不用35档持续压住。如果约1秒仍无STALL迹象，立即STOP→DISABLE，停止这一轮，不继续压住等查询；通信失效则切断驱动电源，事先托住承重机构。
5. 预期真实事件路径是`STALL J7 phase=1 reason=STALL`→等待授权2→回退3→成功保持4→`STALL locked`，地轨相反方向回退约5mm，其他J1～J6联动停稳，J8不参与。总线打印会合并中间重复状态，不要求每个阶段恰好各有一行；实际反向位移与成功保持必须观察。phase6/7是其他轴联动停/保持，不意味着该轴也本地堵转。保留OLED FPS是否持续刷新及完整毫秒日志；软阻挡释放后可读STALL_STATUS 7/MOTION_STATUS，不以故障后查询作为唯一取证办法。
6. 只有第5步成功后才补两类操作：回退中发START，应pending并在所有保护成功后Started ok、保持回退终点；回退中发STOP或DISABLE，应取消回退并保持/失能，不能回到原受阻目标。每类最多一次低能量软阻挡，不要求再次压住硬限位。START之后等1秒，未发新MOVEJ时位置必须保持；SEQ旧队列不得继续。
7. 若仅CURRENT_CMD_LIMITED而无STALL/回退，或STALL后phase5失败，立即停止继续受阻，提交该轮完整日志及失败原因；无回退不能再用一次日志断言三条件从未成立。成功/失败后都不自动保存这组低阈值，测试结束DISABLE，按第1步回读值恢复RAM或重启恢复原EEPROM（原已保存BACK_MM=20也需按实际需求另行修正）。

### 本轮保留的问题

绝对速度滤波对往返微振的抑制、稀疏坏反馈的质量故障兜底、本地/全机保护停稳的阶段截止、距离/速度/超时联合参数校验、独立USB无pending超时原因仍未在本轮修改。堵转三条件和连续清零规则保留，不能保证上述低阈值在所有真实受阻噪声下都触发。本轮修复的是已确认的确认/接管缺陷，不宣称真实堵转敏感性或所有USB异常均已解决。

**最新交付：堵转检测运行快照**（2026-10-07）：本轮只增加 `#STALL_STATUS 1..7` 及目标助手的“读取运行快照”按钮，保持原检测条件、严格连续计时和STOP/回退/校准行为。主控保护事件ISR调用任务临界区的已确认缺陷按用户要求暂不修；FPS持续刷新时不能把它认定为此次USB超时根因。最新产物与流程见第10节，前文构建记录属于历史。

**2026-10-07阈值更新**：用户指定普通堵转初始化电流命令门槛改为电流上限40%，最低0.1A；2.5A对应1.0A，J7若实际限流3.0A则对应1.2A。已有EEPROM不自动覆盖，必须按第7.1节DISABLE后逐节点SET/GET；当前电流门槛表与操作示例已同步。原构建大小、SHA和第二轮通信问题记录保留为历史，本次产物见SESSION_STATUS。电源端整机电流不直接等于focCurrent命令，本次调整仍待实测。

## 1. 交付状态与范围

用户授权先提交基线、说明实机问题，再修复堵转并编译，由用户烧录测试。基线提交为 `5e5eddc`（`feat: 实现堵转自动回退与校准，记录实机待修问题`），使用仓库本地作者身份。本轮修复未再次提交，未烧录。

本轮完成保护状态查询、START后复核、通信健康判定、内部动作续约确认/重试、故障分类及普通堵转默认阈值调整。仅同步 `串口助手_old.py`；未修改 `串口助手.py`、参考固件或 `esp32/`。没有扩展校准机械动作，也没有宣称修复USB断连。

**第二轮更新**：用户HOME/RESET复测仍出现J2/J3保护快照超时，已补充电机发送完成确认、保护回复优先队列和错相重试。本轮生产代码只新增修改电机`Core/Src/can.c`，主控/协议/GUI保持上一轮版本；已有上一轮主控的用户只需更新八个电机。第5、6节产物已更新，第二轮依据与验收见第9节。

## 2. 已确认问题及修复

用户附件中7次异常均为 `NODE_OFFLINE_OR_RESTART`，没有 `reason=STALL` 的机械检测事件。原主控把保护探针超过1秒未更新与缓存范围无效统一打印为STALL：即使J7没有运动，也可能进入该路径。因此，日志不能证明7次都是机械堵转，更不能仅据此断言节点真实掉线或重启。

| 已确认代码问题 | 本轮处理 |
| --- | --- |
| START范围下发可能消耗接近或超过旧探针1秒预算，使能后立即检查旧时间 | 范围COMMIT全部完成后再次查询八节点，核验新位置/坐标版本/范围，然后执行既有使能保持握手 |
| 查询flags与健康判断读取的EVENT flags不是同一快照 | 新增0x36原子查询回复；健康判断只使用匹配探针的快照 |
| 普通位置回包不计在线，查询入邮箱成功后缺少充分重试 | 分开记录节点通信时间和有效保护快照时间；同编号探针重试，有界超时仍保护 |
| 八节点续约约320ms；入邮箱后丢一帧可能640ms，超过本地500ms租约 | 续约绑定task/version及非零nonce，电机刷新租约后确认；正常按80ms到期调度，待确认20ms重试，轮转避免低ID独占 |
| 校准等待/完成节点也占续约资源 | 校准只向当前J7或J8内部动作节点续约；普通保护中等待授权的节点仍续约 |
| 重复事件产生重复阶段行，校准失败也误打印普通STALL | 重复状态仍确认，但只在事件/阶段/原因变化时打印；通信保护用PROTECT、校准用CAL、机械事件用STALL |

主控通信超时仍为1000ms，电机内部动作租约仍为500ms。没有用无限宽限或假成功掩盖真实断线。STOP优先于内部续约和其他保护发送；回退期间START、STOP、DISABLE的既定语义不变。

两端CAN自动重传仍关闭，本轮通过保护业务的确认和重试处理可重试帧，避免全局重传迟到的普通运动目标。HAL入邮箱成功仍不能证明总线成功；新增ALST/TERR诊断计数用于实机核查。

## 3. 协议与参数决策

必须配套更新主控和全部八节点，包括J8。虽然J8排除普通堵转检测，但START查询和校准续约使用新协议。混用旧固件不在本轮兼容范围。

- CAN StdId仍为 `(nodeID << 7) | cmdCode`；旧0x0A动作数值不改。
- QUERY使用0x34/op=0，回复0x36：`coordinateVersion[0], flags[1], probe u16[2..3], actual motor-r float32[4..7]`，小端，8字节。未确认的有效保护事件另外重发；空闲查询不再额外发送EVENT。
- RENEW使用0x34/op=7，末4字节为非零nonce。有效task/version才刷新租约并回复0x35：`0x40[0], currentVersion[1], task u16[2..3], nonce u32[4..7]`。该确认不代表回退完成或解锁；旧确认、错task/version不会推进动作。
- EEPROM结构版本保持1，已有合法参数继续加载，烧录不会自动覆盖用户设置。需要查询后显式SET；SAVE仍要求真实失能。

普通检测仍要求运动意图成立，且电流命令高、实际速度低、跟随误差大三条件连续成立。任一条件失效即清候选计时；参数/模式切换等复位规则沿既有实现。`focCurrent`是控制器输出命令，不是实测电流。

| 参数 | 本轮新默认值 | 单位及范围 |
| --- | --- | --- |
| CURRENT_A | max(0.1A, 初始化时有效电流上限×0.4)；2.5A时1.0A、3A时1.2A | 电流命令A，0.1～有效上限 |
| SPEED_RPS | 0.02，不变 | 电机轴r/s，0.001～0.2 |
| ERROR_R：J1～J5 | 0.06944444，对应关节0.5° | 电机圈，0.0002～1 |
| ERROR_R：J6 | 0.04166667，对应关节0.5° | 同上，减速比30 |
| ERROR_R：J7 | 0.1，对应地轨0.5mm | 同上，5mm/电机圈 |
| TRIGGER_MS | 300 | 连续时间ms，20～2000 |
| STARTUP_MS | 200 | 启动豁免ms，0～500 |

电流/速度滤波10/20ms不变；回退5°/5mm、减速箱前电机轴速度3/0.5r/s、加速度上限5r/s²、超时5秒不变。普通回退和保持电流仍受既有电流上限约束。J6按nodeID使用自身减速比，无需拆分35固件。校准接触参数仍独立，未随普通阈值调整。后续显式改变电流上限时，既有阈值约束逻辑仍生效；40%是初始化值，已有配置不会持续按此比例自动重算。

## 4. 实际修改文件

| 文件（均为当前开发目录） | 修改作用 |
| --- | --- |
| `firmware_new/protection_protocol.h` | 原子查询帧、续约nonce确认及兼容边界 |
| `firmware_new/dummy-motor-fw/Ctrl/Motor/stall_protection.cpp` | 电机查询快照及有效续约确认，减少空闲EVENT |
| `firmware_new/dummy-motor-fw/UserApp/protection_config.cpp` | 普通保护新默认阈值，不覆盖EEPROM |
| `firmware_new/dummy-motor-fw/Core/Src/can.c` | 第二轮：保护回复独立队列，发送完成才出队，错误回调有界重试；普通反馈合并及邮箱完成所有权 |
| `firmware_new/dummy-ref-core-fw/Robot/instances/protection_coordinator.cpp/.h` | START复核、分离在线/保护状态、探针重试、续约调度、错误分类和阶段去重 |
| `firmware_new/dummy-ref-core-fw/Robot/instances/dummy_robot.cpp/.h` | 普通回包在线记录入口和STOP发送优先标记 |
| `firmware_new/dummy-ref-core-fw/UserApp/protocols/can_protocol.cpp` | 新查询路由、有效普通回包计在线 |
| `firmware_new/dummy-ref-core-fw/Bsp/communication/interface_can.cpp/.hpp` | 新帧门禁、CAN仲裁丢失/发送错误计数 |
| `串口助手_old.py` | 新默认参数、按轴误差值、PROTECT分段回包和通信保护提示 |
| 本文、`docs/堵转保护与自动回退及校准方案.md`、`docs/SESSION_STATUS.md` | 实施决策、当前状态、验证证据与烧录步骤 |

## 5. 编译及离线验证

主控及35/42/57/gripper全部Release/Ninja构建通过；主控RAM55544B、FLASH415388B，CCM64KiB为既有RTOS堆保留区且主控BIN与上一轮相同。第二轮电机RAM均10336B，35/42 FLASH95572B、57 95564B、gripper95524B，均在95KiB应用区/20KiB RAM内。35与42当前产物相同；电机应用区最小余量1708B，未侵入编码器校准表或用户区。

第二轮真实生产源码离线回归共45678项断言通过：主控11160、电机/规划器6877、配置/EEPROM132、主控CAN201、新增电机CAN27308。前四组本轮重新运行通过。上一轮隐藏真实Tk界面配合串口替身53项检查及分段回包检查通过；本轮未改GUI，未重复宣称新的界面验收。

新增覆盖：START范围下发超过1秒后的持续运行、旧EVENT不覆盖新健康快照、入邮箱后丢探针及同ID重试、普通位置还在回但保护状态失联、真实离线锁定、非有限编码器值拒绝、七节点同时触发后联动软停/串行回退/提前START、续约丢帧及STOP/ACK/GO竞争、旧续约确认不伪造完成、重复CAL阶段不刷屏。硬件接口及物理反馈在测试中由模型替代，不能据此宣称实机验收通过。

脚本、结果及源码SHA位于 [protection_regression](E:/Dummy-code/firmware_new/dummy-ref-core-fw/build/analysis/protection_regression)；`run_core.cmd/run_motor.cmd/run_config.cmd/run_can.cmd/run_motor_can.cmd`可复跑。第二轮产物清单见 [stall_fix_round2_artifacts.json](E:/Dummy-code/firmware_new/dummy-ref-core-fw/build/analysis/stall_fix_round2_artifacts.json)；`stall_fix_artifacts.json`保留为上一轮记录。这些均在忽略的build目录中，不属于基线提交。

保留既有警告：Encoder基类空虚函数缺return及链接RWX LOAD段。没有为本轮修复扩大到无关警告处理。

## 6. 烧录产物

| 对象 | BIN文件 | 字节数 |
| --- | --- | ---: |
| STM32F405主控 | [Core-STM32F4-fw.bin](E:/Dummy-code/firmware_new/dummy-ref-core-fw/build/Core-STM32F4-fw.bin) | 415388 |
| J1～J6按实际35型号选择 | [motor-35.bin](E:/Dummy-code/firmware_new/dummy-motor-fw/build/motor-35.bin) | 95572 |
| J1～J6按实际42型号选择 | [motor-42.bin](E:/Dummy-code/firmware_new/dummy-motor-fw/build/motor-42.bin) | 95572 |
| J7地轨 | [motor-57.bin](E:/Dummy-code/firmware_new/dummy-motor-fw/build/motor-57.bin) | 95564 |
| J8夹爪 | [motor-gripper.bin](E:/Dummy-code/firmware_new/dummy-motor-fw/build/motor-gripper.bin) | 95524 |

各BIN同目录有对应HEX。不要改变已确认的轴型号、节点ID或机械零位；不要为更新普通默认参数盲目全片擦除已有配置。烧录前关闭COM20，支撑承重关节。启动坐标仍依赖既有参考姿态/地轨参考，不保证单圈编码器恢复掉电期间多圈移动。

SHA256：

```text
Core  80AFBD0D0E337ACFE99EFF752CBBB8DA9BF2FB7AB5912A1F5BC71750FDCD9BE2
35/42 ABFF9B5ECC710F1B81A6BBD384E63468AAAD9737F2AE0ABE2485BECFF55584CC
57    511A31D3E98B70E72BEB4E49082ED9C4D8ADB9CC7DD4E5798E558E382C9CFF02
J8    DC52EF27209762D9F08A4C49BAD92656E8627C0DA58F594231ED4C8888761D44
```

## 7. 实机测试顺序

### 7.1 先确认失能与实际参数

使用新版 `串口助手_old.py`，COM20为主控USB虚拟串口，115200。发送 `!DISABLE`，等到 `Disabled ok`；pending只表示请求已接收。查询 `#GETI 0` 和 `#STALL_GET 0`，保留完整结果。每项作业完成再发下一项，ALL保护查询以J7最后一项 `DIRECTION_MASK` 回复为结束；`#STALL_GET 8`应为EXCLUDED。

若EEPROM还是旧阈值，在失能确认后逐条设置。下面CURRENT的ALL示例只适用于各轴有效上限都已确认为2.5A；上限不同则分别设置各节点的40%（最低0.1A），不改变电流上限本身。J7实际限流3.0A时，单独用`#STALL_SET 7 CURRENT_A 1.2`；例如2.0A节点用0.8A、1.5A节点用0.6A，不向不同上限节点统一套用1.0A。

```text
#STALL_SET 0 CURRENT_A 1.0
#STALL_SET 0 SPEED_RPS 0.02
#STALL_SET 0 TRIGGER_MS 300
#STALL_SET 0 STARTUP_MS 200
#STALL_SET 1 ERROR_R 0.06944444
#STALL_SET 2 ERROR_R 0.06944444
#STALL_SET 3 ERROR_R 0.06944444
#STALL_SET 4 ERROR_R 0.06944444
#STALL_SET 5 ERROR_R 0.06944444
#STALL_SET 6 ERROR_R 0.04166667
#STALL_SET 7 ERROR_R 0.1
```

**逐条发送、逐条等成功，不要一次粘贴连续发送。** ALL SET须等 `ok STALL_SET [7] ...`；单轴等该轴成功。随后再GET核对。首次可只在RAM测试；确认合适后失能并发送 `#STALL_SAVE 0`，等各轴保存成功。若出现部分应用/失败掩码，先处理该错误，不直接进入运动测试。

同时核对ENABLE、BACK_DEG/BACK_MM、BACK_RPS、BACK_TIMEOUT_MS；应为J1～J6回退5°、J7回退5mm、速度3/0.5电机r/s及5000ms。保存后重启再次GET，验证实际参数确实保留。

### 7.2 静止和启停重复测试

1. `!START`，等待 `Started ok`，保持静止2～3分钟。J7不动也应维持正常，不出现无原因STALL/PROTECT；位置持续刷新。
2. 支撑机械臂，做约10轮START/DISABLE，每次等最终ok再发送下一条。允许短暂pending；不能只有pending而无最终结果。
3. 确认上电坐标和真实姿态一致、运动空间可用，再 `!HOME`，等待 `Home ok`。当前HOME目标是 `{0,0,90,0,0,0}`、地轨0，并不是REST姿态。

### 7.3 重点复现“J7没动也报警”

从已完成HOME的位置做20轮小幅低速往返，每次实际到位再发下一条，J7目标始终0。例如：

```text
>10,0,90,10,10,10,0,10
>0,0,90,0,0,0,0,10
```

末位10是速度档位，对应电机轴最高3r/s；使用前确认这些小幅目标适合实际工作空间。然后保持六轴HOME不变，单测地轨0→10mm→0，仍用低速档位。观察有无新的PROTECT及对应诊断；不要仅凭OLED有角度就认定保护状态回复正常。

### 7.4 STOP与旧目标清除

运动中发送 `!STOP`，应见 `Stopping ok`、随后 `STOP locked`；J1～J7减速后保持固定停点，J8排除普通STOP。减速中发送START应pending，停稳后使能保持当前点，不继续旧目标。另测STOP锁定后DISABLE，八节点全部失能。锁定时点击其他运动命令产生STOP锁定警告属于正常门禁。

### 7.5 真正堵转与自动回退

先选低负载轴、中间行程及低速短距离运动，用受控限力阻挡验证，不用手接近运动夹点。建议先J4，再远离物理端点的J7；承重轴保持可靠支撑。

期望：满足本次设置的三条件连续300ms，电机本地保护并报告STALL；其他J1～J7联动软停；触发轴反向退离，关节最多5°、地轨最多5mm，受实际范围截短。完成依据实际编码器到位和STOP稳定窗，随后锁定保持；不会恢复旧目标。夹爪正常夹持不产生普通全机堵转事件。

分别测回退中提前START和回退后START：提前START应挂起，仅全部回退成功后 `Started ok`，保持新停点；失败则清挂起，不自动使能。解锁后发送新的短距离目标，确认没有残留队列继续冲向旧堵转点。

### 7.6 打断与失败

- 回退中STOP：取消内部回退、软停并保持锁定；需要新的START或DISABLE。
- 回退中DISABLE：立即走八节点失能，不等待回退完成；提前支撑承重关节。
- 受控再次阻碍或回退空间不足：应明确失败原因，例如REBLOCKED、NO_SPACE、RETREAT_TIMEOUT，5秒回退超时不能伪报成功。失败保持保护锁并清提前START。
- 通信故障测试仅在支撑/无负载台架进行：丢失节点通信应报NODE_UNRESPONSIVE；普通位置仍回但有效保护快照丢失应报PROTECTION_STATUS_TIMEOUT。健康同伴软停，不猜测方向回退；恢复后用新START复核。缺节点时DISABLE等待实际确认是正确行为，不应伪报全部失能。

### 7.7 校准只作为共享通信复测

先完成上述堵转测试，再按原方案支撑并失能，执行CALIBRATION观察共享续约。J8先寻端/返回100，J7后寻正端/返回0，全部结束失能保存才校准ok。J7从中心以0.5电机r/s去返约200秒，不能拿普通5秒回退超时判断校准失败。

重点观察J8是否还出现LEASE_TIMEOUT、是否只在阶段变化时打印，以及校准/保存期间START是否busy且不会结束后自动使能。STOP或DISABLE取消不报校准成功，不继续保存未完成流程。本轮没有据此保证其他校准问题已经修复。

## 8. 日志解读与复测反馈

| 回复 | 含义 |
| --- | --- |
| STALL阶段，reason=STALL | 电机机械堵转检测事件，再看回退及终态 |
| PROTECT ... NODE_UNRESPONSIVE | 节点通信超过1秒未到；不等于已证明节点重启 |
| PROTECT ... PROTECTION_STATUS_TIMEOUT | 有效匹配保护快照超过1秒未到，普通位置可能仍正常 |
| PROTECT ... PROFILE_INVALID / COORDINATE_CHANGED | 当前保护范围无效或坐标版本与提交范围不一致 |
| PROTECT ... NO_VALID_ENCODER | 当前快照不具备有效有限编码器反馈 |
| PROTECT ... queued/rx/retry | 查询入邮箱成功数、有效回复数、重试数；queued不代表总线成功 |
| PROTECT CAN alst/terr/full | 仲裁丢失、发送错误、接收FIFO满回调累计计数 |
| STOP锁定警告 | 锁定期间其他运动命令被丢弃，属于正常行为 |

异常保留从连接、参数查询、START到故障后的完整日志，以及轴是否实际运动、堵转/回退/校准阶段。USB ClearCommError只记录前后状态，不能把它直接归为堵转阈值问题。实机通过的最低依据是静止/J7固定/重复启停无误触发，真实堵转会退离并保持，STOP/DISABLE能打断，解锁不恢复旧目标；离线测试不能代替这些结果。

## 9. 第二轮：持续运动仲裁修复与本次复测

### 9.1 用户日志与根因边界

14:40～14:46 HOME/RESET反复触发J2/J3 `PROTECTION_STATUS_TIMEOUT`，其最近通信仅4/10ms，保护探针为1005ms，flags=07。电机仍在回包，缺的是本次有效保护快照，不是电流/速度/误差三条件的机械STALL；不回退符合原通信保护设计。J1 CURRENT=1.8A/上限2A、J2 CURRENT=1.35A/上限1.5A及300/200ms等参数已生效，不能拿统一2.25A覆盖这些不同上限。

电机原`CAN_PollTransmit()`在HAL入邮箱成功就出队，随后ALST/TERR没有保留原回复。主控固定控制周期的查询重试不能保证逃离持续重复的运动仲裁；主控累计ALST支持发送竞争方向，但不能证明每次究竟丢在请求端还是回复端。本轮直接修复已确认的电机回包缺口，不靠提高阈值或放宽保护看门狗。

### 9.2 发送决策

- 保护回复0x0A/0x0B/0x32/0x35/0x36进入独立12槽环形队列（有效容量11），优先于普通反馈。HAL入邮箱只标记在途，TXOK完成回调才移除；错误/普通abort保留帧，按节点与尝试次数做1～4ms退避，再发送。
- 每帧最多16次发送尝试（含首次），或入队后100ms到期，先达到者结束重试。到期在途帧请求有界abort，不伪造成功；主控业务重试仍负责下一次新查询。保存回复、事件和续约仍依靠已有幂等/重发协议，不新增解锁入口。
- 只合并未发送的可替代快照。不同参数/事务/配置操作的0x32回复独立；0x35续约ACK与动作完成上下文不能互相覆盖；在途帧不改写。普通0x23未发送旧样本被最新反馈替代，避免反馈积压挤掉保护回复。
- 电机只保留一个受跟踪的硬件在途发送，等实际complete/error/abort处理后才复用邮箱，避免硬件已经空闲但旧RQCP中断未处理时，把旧回调误认为新保护帧成功。所有回调均短时处理，无阻塞等待、打印或Flash写入。普通反馈仍为尽力发送，不重放运动命令。
- 主控查询时隙及1秒健康预算保持；本地保护租约500ms保持；两端自动重传保持关闭。软件重试发生在电机主循环，独立于主控5ms周期。本轮未修改阈值、回退距离/速度、校准动作或GUI。

### 9.3 新回归证据

实际生产电机CAN队列/结果回调代码，配合硬件邮箱替身及125μs总线时隙模型，覆盖三邮箱、五类保护回复、ALST/TERR、HAL忙、未处理RQCP、到期abort、计时回绕、独立事务/续约ACK、队列满和普通反馈合并。构造每5ms前2ms持续低ID运动帧、每160ms保护查询固定撞相：基线八种nodeID均3秒内0条保护回复；新版各19条，探针最大年龄160ms。仲裁计数仍可能增长，验收条件是有效回复和保护行为，不能要求ALST归零。

模型验证的是该持续碰撞路径，不能代替真实CAN波形和电机负载。若实机仍超时，应保留PROTECT分项日志继续区分请求未达、回复丢失或其它接收问题；不会把本轮通过模型测试写成实机成功。

### 9.4 本次只需更新八个电机

主控维持上一轮已经显示PROTECT分项日志的版本；本轮主控BIN SHA与上一轮完全相同。八电机使用第6节当前产物，包含J8。EEPROM不变，已确认合适的参数无需重设。

复测顺序：`!DISABLE`确认→GET核对参数→`!START`确认后静止2分钟→HOME/RESET交替10轮（每次最终ok后再下一条）。通过后再按7.4～7.6测STOP、受控机械堵转回退及打断；再次出现PROTECT应停止本轮往返，提供完整日志。机械reason=STALL应自动回退，通信PROTECT仍软停保持锁定。未烧录、未新增commit。

## 10. 堵转检测运行快照（2026-10-07）

### 10.1 范围与常规决策

- 只读 `#STALL_STATUS <node>`，单节点J1～J7，拒绝0/ALL、J8和多余参数。运动、STOP锁定、保护动作、失能及校准期间均可读；不清计时、不改参数/队列/EEPROM、不解锁，也不作为运动或保护租约。只给这一查询增加锁定例外。
- 主控独立事务不占用保护Job；100ms重试同号，1500ms缺字段打印 `error STALL_STATUS J7 req=... missing=...`，不升级全机保护。未打印完再次查询返回busy。
- 电机首次新请求号在短PRIMASK区捕获19个整数字段，同号重试重发缓存，整组来自同一时刻；主循环每毫秒最多一个普通队列回复，原保护回复优先。主控用空闲取消时隙，STOP/租约/取消/健康先处理，原每周期一帧预算保持。CAN接收只复制数据，无新增任务临界区或打印；打印任务每轮最多4行，完整一组16行，以 `req=...` 开始、`end req=...` 结束。保留原USB/UART通道归属，不加自动轮询。
- 历史峰值、最近非零候选的清零记录、无效反馈统计，在原 `ResetDetection(true)` 新运动检测会话时清空。原规则为motionIntent原本false且收到有实际位差的目标；INT中途覆盖、意图仍true时不重开会话。STOP/DISABLE/查询保留历史；内部回退/校准计时不混入普通峰值。重新上电清RAM历史。
- 初次57构建超95KiB应用区1220B，已说明后对ProcessProtectionCan及新增CaptureStallDiagnostic/PollStallDiagnostic使用GCC局部Os。20kHz控制/检测函数保留原编译选项；Flash分区、校准表、EEPROM格式与VERSION=1不变。四目标均在界内，最小余量12B，后续电机功能需重新评估体积。

源码：`firmware_new/protection_protocol.h:16` 定义0x37/0x38；电机 `Ctrl/Motor/stall_protection.cpp:130` 会话/清零、`:148` 捕获、`:174` 发送、`:478` 门控/计时观察；主控 `Robot/instances/protection_coordinator.cpp:55` 重试、`:68` 打印、`:161` ISR复制、`:688` 串口入口。本轮只加观测，原阈值、滤波及三条件连续判据保持。

### 10.2 字段与判读

| 字段 | 含义及单位 |
|---|---|
| req / session / at_ms | 查询号、运动检测会话号、电机捕获时的上电毫秒；重试不改变at_ms |
| mode / reqmode / phase | 实际运行电机模式、请求电机模式、保护阶段；不是主控SEQ/INT编号 |
| gate | 普通检测门控，按原代码短路顺序显示第一个阻断项 |
| intent / fb / enabled / detect / stop_lock | 运动意图、完整反馈有效性、goalDisable/softDisable均未置位、普通检测开关、STOP锁定；enabled不单独证明硬件在输出 |
| unmet | gate=ELIGIBLE时有效：1=滤波命令电流不足，2=滤波速度过大，4=误差不足；可相加，0=三条件全满足 |
| I_cmd / I_filt / I_thr | 有符号原始FOC输出电流命令、abs命令滤波值、运行阈值，A；不能称实测电流或电源电流 |
| v_raw / v_filt / v_thr | 有符号估计编码器速度、abs速度滤波值、阈值，减速箱前电机轴r/s；J7乘5为mm/s |
| err / err_thr | 有符号softPosition-realPosition、误差阈值，减速箱前电机轴r；判定用绝对误差，J7乘5为mm |
| timer_ms / need_ms | 当前普通连续候选时间、触发持续时间；内部保护阶段timer_ms显示0，避免混入内部接触计时 |
| peak_ms | 本会话普通三条件最长连续时间 |
| clear / detail / last_ms | 最近非零候选被清零的原因、详情、清零前时长；从未有非零候选时clear=NONE，结合gate/unmet看原因 |
| bad_total | 本会话无完整有效反馈的20kHz控制周期数，含未初始化/未校准/坏采样，不仅是SPI失败次数；饱和不回绕 |
| bad_run_peak_ms | 现有invalidFeedbackTicks连续坏采样峰值，不是所有fb=0原因的持续时长 |
| startup_left_ms | 当前启动豁免剩余毫秒；豁免期间滤波值不代表在执行三条件判定 |

电机模式：0=STOP、1=COMMAND_POSITION、2=COMMAND_VELOCITY、3=COMMAND_CURRENT、4=Trajectory、5=PWM_POSITION、6=PWM_VELOCITY、7=PWM_CURRENT、8=STEP_DIR。普通检测适用1/4/5/8；主控SEQ/INT经MoveJ通常都落为电机mode=1。

gate编号：0 ELIGIBLE=检测中；1 PROTECTED=内部保护/校准拥有控制；2 EXCLUDED=J8排除（串口快照不接受J8）；3 SWITCH_OFF=开关关闭；4 STOP_LOCKED=STOP锁；5 DISABLED=失能；6 BAD_FEEDBACK=反馈无效；7 MODE=模式不适用；8 NO_MOTION=无运动意图；9 STARTUP=启动豁免；10 FILTER=滤波时间常数无效。

`clear=CONDITIONS`的detail为unmet位图；`clear=GATE`的detail为上述gate编号。其他clear原因为DIRECTION、STARTUP、CONTROL_RESET（原STOP/失能/模式等复位）、PARAMETERS（运行参数发布）、TRIGGERED（连续到达触发时间）。只记录非零候选的实际清零，避免空闲周期覆盖有价值原因。

### 10.3 用户实测流程

1. 新主控+motor-57用于J7测试；查询J1～J6时，对应35/42节点也须新固件。J8仍排除普通堵转，不依赖夹爪快照，本轮不必单独更新J8。正常烧录保留EEPROM。
2. 用 `串口助手_old.py` 打开“堵转 / 校准参数…”，普通堵转页选7，“读取运行快照”即发送 `#STALL_STATUS 7`。先DISABLE最终确认，保存GETI 7和STALL_GET 7完整回包，保持本轮测试原参数/PID，不同时调多项。
3. START最终确认后静止读一份，确认fb/detect，通常gate=NO_MOTION；低速正常地轨MoveJ，运动中和正常结束后各读一份，核对mode/intent/速度。
4. 可控受阻时立即读，再以约200～300ms间隔手动取3～5份。每次等上一份 `end req=...`，不狂点、不延长原受阻试验。保留START→MOVEJ→所有快照→DISABLE完整日志，说明实际受阻时长、OLED J7坐标和FPS。
5. 速度不通过看gate=ELIGIBLE、unmet含2、v_filt高于v_thr，以及clear=CONDITIONS/detail含2、peak_ms始终低于need_ms。捕获瞬间unmet=0也不能否定此前速度脉冲清零，须看历史。位1对应电流、位4对应误差；fb=0/BAD_FEEDBACK优先检查反馈，不能只降机械阈值。
6. 及时DISABLE结束。确认后可再读历史，session应未变；失能复位可使当前滤波值/意图归零，因此不能只读失能后的即时值。先不要发下一条新运动，以免覆盖上一会话峰值。

若DISABLE再次连pending都没有，记录最后快照是否完整、USB错误时间和OLED FPS；仍单独定位。本轮未加入USB健康计数、未修已知保护事件ISR缺陷，不宣称失能问题已解决。取得实测后才决定是否采用编码器时间窗口位移/振幅等速度判据，继续保持连续堵转，不复制参考版间歇累计。

### 10.4 验证与产物

主控及四电机Ninja成功。实际源码提取用例覆盖一致缓存、错号/节点/版本拒绝、缺字段重试、超时不锁机、查询不阻断START/DISABLE、ASCII锁定例外、门控/条件清零、峰值/会话/无效反馈及原STOP/回退/校准。保护基线电机7015/主控11174断言；普通完成扩展主控38995/电机45476；主控CAN5817/电机CAN54657；配置/EEPROM132。真实隐藏Tk+串口替身65项（按钮、写线程锁定、报文分片、运动仍拦截）通过。模型/替身不是实机验证。

| 产物（同名hex也已生成） | BIN字节 | SHA256 |
|---|---:|---|
| dummy-ref-core-fw/build/Core-STM32F4-fw.bin | 430920 | DB922D44224DA05459F47F63082239DF85A3342B160D21E2B0E037FAB5A39C24 |
| dummy-motor-fw/build/motor-35.bin、motor-42.bin | 97268 | 10C9D33C1F22F598BC3CE3B23134C5A2C229A102EE4F416AA59FFFDC7F50D8E8 |
| dummy-motor-fw/build/motor-57.bin | 97260 | 1D27085F99DB0CEAD4E1722EB66D0848C3CF3F7CAEAC2182E0ED28C0CBAC27E3 |
| dummy-motor-fw/build/motor-gripper.bin | 97220 | 6231AEAFF020E53986A6C3E47153642F7456CEBD46A089923A741B9A478208C2 |

根目录 `E:\Dummy-code\firmware_new\`。主控RAM56368B/CCM64KiB，电机RAM10472B；既有MT6816缺return及RWX警告不扩修。未连接设备、未烧录、未commit；参考串口助手.py SHA仍为 `D07D3E90968F42706C107EC038AFD5109E6A67FC0A12F3C2BC3D98D13FF0D7E4`。
