Liu3Beng-A/Dummy/docs/速度与加速度单位统一及速度档位对齐报告.md

# 速度与加速度单位统一及速度档位对齐报告

日期：2026-10-04。开发目标：`firmware_new`。状态：代码修改与编译完成，尚未烧录及进行本轮实机测试。

## 一、功能定义

物理速度统一为**电机轴 r/s**，加速度统一为**电机轴 r/s²**。不是关节输出轴的转速；位置输入仍为 J1～J6 的角度（°）和 J7 地轨的毫米（mm）。夹爪保留独立的速度控制。

运动命令的 speed 是无单位档位，范围 1～100：

| 档位 | 电机轴速度上限 |
|---|---|
| 1 | 0.3 r/s |
| 35 | 10.5 r/s |
| 50 | 15 r/s |
| 100 | 30 r/s |

映射为 `档位 × 0.30`。这是同步规划的速度上限：短行程、加速度约束、各轴同步及电机自身限制可能使实际速度低于此值，不能把档位 100 理解成每条运动都能达到 30 r/s。

## 二、对比结论与原有问题

参考 `firmware/ref_core_f405/Robot/instances/dummy_robot.cpp` 的速度档位、直接加速度设置和正常模式保留参数的思路，保留 `firmware_new` 自身的轴索引与同步规划。

1. `firmware_new` 的 MoveJ 已使用 r/s，并已有 100→30 的换算和七轴同步规划，因此无需整体迁移参考算法。
2. 原 SetJointSpeed 修改的状态与 MoveJ 默认分支断开；省略速度时 MoveJ 固定使用 50。MoveL 虽调用 SetJointSpeed，随后转入默认 MoveJ 时仍丢失指定速度。
3. 原全局 SetJointAcceleration 把输入解释为 0～100 百分比，再乘各轴基数，并且只设置 J1～J6。
4. 原模式切换重新设置加速度，并使用 TRJ 的 0.3 速度比例；初始化也经过该入口，会覆盖电机已保存的加速度。
5. 七参数 MoveJ 已成功解析地轨目标，却随后将其替换为当前位置。
6. 电机驱动的 CAN 速度/加速度接收已分别按 r/s、r/s² 换算为内部细分步单位，查询加速度反向换算；不需修改电机算法或 EEPROM 格式。

## 三、本轮修改

| 文件 | 内容 |
|---|---|
| `firmware_new/dummy-ref-core-fw/Robot/instances/dummy_robot.cpp` | 默认 MoveJ 沿用当前速度档位，使 MoveL 设置生效；全局加速度直接传递 r/s²，应用到 J1～J7、更新规划缓存并触发回读；模式切换保留参数；保留七参数的地轨目标 |
| `firmware_new/dummy-ref-core-fw/Robot/instances/dummy_robot.h` | 更正默认速度与 API 单位注释，删除百分比加速度常量和模式速度比例字段 |
| `串口助手_old.py` | 三处速度输入标明 1～100；增加 100=30 r/s 提示；MoveJ、MoveL、点位和顺序发送统一校验，非法输入不发送，也不悄悄退回默认值 |
| `docs/SESSION_STATUS.md` | 更新当前任务、已确认事实、构建结果及待实机验证内容 |

主控默认档位仍为 50；串口助手默认档位仍为 35。Homing/Resting 的显式低速档位 10 保持原设计。

全局加速度输入的有限值限制到 1～5000 r/s²，CAN 保存标志为 false，仅运行时应用；后续电机查询确认实际值。J8 夹爪不参与全局加速度设置，保持独立控制。已有逐节点 `#ACC_J` 的应用/保存协议保持原样。

主控 Release 使用 `-Ofast`，普通 isfinite 检查可能被优化掉；本轮新增的速度/全局加速度非有限值保护检查 IEEE-754 指数位，并已核对生成的 ARM 指令仍包含该判断。此项只覆盖本轮相关参数，未扩展为全协议输入审计。

## 四、协议与兼容性

| 入口 | 含义 |
|---|---|
| `>j1,j2,j3,j4,j5,j6,j7,speed`（或 `&` 前缀） | 八参数，j7 单位 mm，speed 为 1～100 档位；显式档位同时成为后续默认值 |
| `>j1,j2,j3,j4,j5,j6,j7`（或 `&` 前缀） | 七参数，保留地轨目标，沿用当前档位 |
| `@X,Y,Z,A,B,C,speed` | 指定位姿和速度档位；通过现有 IK→MoveJ 链路执行，地轨保持当前位置 |
| `@X,Y,Z,A,B,C` | 沿用当前档位 |
| Fibre `set_joint_speed(speed)` | 设置默认档位，有限值限制到 1～100 |
| Fibre `set_joint_acc(acc)` | 设置 J1～J7 电机轴加速度，单位 r/s²；不保存 EEPROM |
| `#ACC_J <node> <acc> [&]` | 原逐节点加速度入口，acc 为 r/s²，尾随 & 表示保存 |

MoveJ C++ API 的 speed=0 保留为“沿用当前档位”的内部标记。固件中有限的非零超范围速度会限制到 1～100；串口助手严格拒绝超范围或 NaN/Inf。串口发送显式 0 时先经过全局档位设置，最终使用档位 1；不将 0 当成停止指令。

兼容性变化：七参数命令的第七个值现在明确作为地轨目标，不再被丢弃。历史调用端若使用“六关节＋速度”的七参数格式，需要升级为八参数格式。本轮不新增六参数 MoveJ 支持。

加速度从百分比改为物理量后，旧 Fibre 客户端的 `set_joint_acc(15)` 现在表示 15 r/s²，调用端需要按新单位设置。MoveL 保持原有目标位姿运动实现，本轮没有新增直线插补算法。

## 五、编译与验证

### 构建

在各自 build 目录运行 Ninja，均返回退出码 0。

| 固件 | 结果 | FLASH | RAM |
|---|---|---|---|
| 主控 Core-STM32F4-fw | 11/11 完成 | 378864 B | 55240 B，另 CCMRAM 65536 B |
| motor-35 | 成功 | 71212 B | 8136 B |
| motor-42 | 成功 | 71212 B | 8136 B |
| motor-57 | 成功 | 71204 B | 8136 B |
| motor-gripper | 成功 | 71132 B | 8136 B |

电机驱动本轮未改源文件；四种构建目标由 CMake 分别定义 MOTOR_TYPE=35/42/57/8。电机目录构建重新生成 CMake 并编译完成全部目标，共显示 41 个步骤。

产物：

- 主控：`firmware_new/dummy-ref-core-fw/build/Core-STM32F4-fw.bin`，同目录含 .hex、.elf。
- 电机：`firmware_new/dummy-motor-fw/build/motor-35.bin`、`motor-42.bin`、`motor-57.bin`、`motor-gripper.bin`，同目录含 .hex、.elf。

现有警告：各 ELF 的 LOAD segment RWX；电机端 `Ctrl/Sensor/Encoder/mt6816_base.h:42` 的非 void 虚函数缺少 return。本轮未修改这些代码，构建通过不表示警告已修复。

### 自动验证范围

- Python 语法编译通过。
- 从目标串口助手 AST 提取实际发送/校验方法，在模拟 Entry、消息框和发送接口下执行 44 项行为断言：档位 1/35/50/100 的 MoveJ、MoveL、点位发送格式正确；0、负数、100.1、NaN、±Inf、非数字与空输入均阻止四种发送入口。
- 拖发调用相同的 send_movej/send_movel，复用相同校验；未进行桌面 UI 视觉或实串口测试。
- 检查 ARM 反汇编，SetJointSpeed 的非有限值保护仍包含 0x7f800000 掩码比较。
- `git diff --check` 通过。保留原同步规划，不以本轮构建结果声称真实同步到位已完成验证。

## 六、待实机验证

1. 烧录主控后回读各轴加速度，确认启动与 SEQ/INT/TRJ 切换不改写已设置或保存的值。
2. 选择可控行程分别测试低速档位和中速档位；检查 CAN 0x07 的速度字段上限随档位变化。档位 100 的字段上限为 30，短行程可能低于上限。
3. 连续发送带速度 MoveJ、随后省略速度 MoveJ；确认沿用上一档位。七参数命令应到达指定地轨目标。
4. MoveL 分别带/不带速度，确认前者设置生效、后者继承当前档位，地轨位置保持。
5. 用 Fibre 全局加速度设置验证 J1～J7 回读相同物理值、J8 保持原值；应用后立即运动验证规划缓存生效，重启验证未保存设置不持久化。
6. 原逐节点应用/保存功能回归，检查 OLED/RGB 与命令任务栈余量。

目前没有本轮实机结论，没有执行 git commit。上一轮命令任务栈修复已由用户确认解决原卡死问题，作为本轮开发基线。

## 七、后续实机反馈：高速地轨拖尾已定位（2026-10-04）

用户在地轨+90→-90mm、档位80的运动中观察到：到约-40mm时七轴状态均为*，实际地轨位置继续缓慢到-90mm。回读参数为加速度35 r/s²、电流限制1.50A、DCE kp=180/kv=600/ki=30/kd=300；把J7限流设置并保存为2.8A后，同样80档双向运动拖尾消失。

本次高速跟随不足由1.5A限流触发，用户已复测消除；目前没有依据为该现象修改同步反解公式。提前FINISH的代码缺陷独立存在，未在本轮修复。

地轨固件出厂默认电流原本就是2.5A（`dummy-motor-fw/UserApp/main.cpp:56`），且EEPROM有效时优先使用已保存参数。串口助手电流输入曾预填1.5A，本次改为2.5A；只有手动应用/保存才发送，不会自动设置设备。该修改只涉及串口助手，Python语法检查通过，固件产物不需要重新生成。

用户当前设备设置为2.8A。若要改为2.5A，发送 `#I_LIMIT_J 7 2.5 &`，用 `#GETI 7` 回读，重启后复查并用相同路径复测。2.5A下的高速效果尚未由用户确认。代理未操作物理串口，未提交commit。

## 八、相同点位往返偶发整体降速修复（2026-10-04）

用户确认INT模式下，等实际停止后手动发送相同±90点位、相同档位，所有运动轴偶发一起变慢而仍同步。代码定位到不动J2/J3的编码器微小残差：旧小根表达式的相减消去使反解速度偏差，再被重算预算的迭代放大。用户已授权修改并编译。

本轮主控 `Robot/instances/dummy_robot.cpp` 将小根改为 `v=2d/(T+sqrt(max(0,T²-4d/a)))`，固定各轴最短梯形时间最大值作为同步预算，删除误差驱动的预算迭代；梯形时间等价使用d/v+v/a。速度档位映射、各轴上限、加速度回读和位置单位保留原定义。

从修改后源码提取真实C++函数与常量，使用本机MSVC /O2 /fp:fast执行回归：10404组微小残差/加速度组合中地轨限速24r/s保持一致；2000组随机轨迹、零位移、三角曲线、加速度兜底、正负方向对称和重复确定性检查通过，共180089断言。验证代码与结果在主控build/analysis/sync_regression目录。主机函数测试不等于实机闭环验证。

主控Ninja 2/2完成：FLASH379272B、RAM55240B、CCMRAM65536B；既有RWX链接警告保留。最终链接ARM MoveJ已确认稳定式的vsqrt→vadd→vdiv指令。当前bin为 `firmware_new/dummy-ref-core-fw/build/Core-STM32F4-fw.bin`，SHA256为 `e64d1d68f43cea245b82e79a62439004e8687351d2ac72d02939e78f7d516202`，同目录包含hex/elf。电机端未改，只需烧录主控。

用户待复测：保持同一组电流/加速度，INT模式、±90点位、档位80，等实际停止后重复往返，检查偶发整体降速及同步性。该版本尚未由用户实机确认，未提交commit。
