Liu3Beng-A/Dummy/docs/夹爪电机加入方案.md

# 夹爪电机加入方案

> ⚠️ **当前文档已放弃，不具备参考价值；具体方案参考docs\handcode夹爪实现对比与迁移方案.md**
> ⚠️ **当前文档已放弃，不具备参考价值；具体方案参考docs\handcode夹爪实现对比与迁移方案.md**
> ⚠️ **当前文档已放弃，不具备参考价值；具体方案参考docs\handcode夹爪实现对比与迁移方案.md**
> ⚠️ **当前文档已放弃，不具备参考价值；具体方案参考docs\handcode夹爪实现对比与迁移方案.md**
> ⚠️ **当前文档已放弃，不具备参考价值；具体方案参考docs\handcode夹爪实现对比与迁移方案.md**

> 编制日期：2026-10-02
> 编制人：Cursor Agent（用户授权任务）
> 涉及模块：`firmware_new/dummy-ref-core-fw`（主控）、`firmware_new/dummy-motor-fw`（夹爪电机固件，已能编译出 `motor-gripper` hex）
> 文档定位：把"夹爪需要完成的功能"讲透，作为后续实现期的施工蓝图。
>
> `firmware/` 是**已放弃的、积累大量 bug 的旧固件**，仅作为「曾经实现过哪些功能」的功能性提示参考，**不可作为参考实现固件**。本文档涉及 `firmware/ref_core_f405/...StepHand` 和 `firmware/motor_fw_f103_gripper/...interface_can.cpp` 的引用，**只能用来确认协议字节层面的存在性**（如 `cmd=0x15` 在夹爪固件 case 里写过），不能直接复刻其 API 设计、默认值、命令风格、字符命令命名。
> 凡涉及「参考 X」「对标 AX」的段落，决策应以**新固件自身的工程约束**（独立协议栈、最少反馈、CAN 总线占用）为准，而非沿用 `firmware/` 的设计。

---

## ⚠️ 文档状态变更（2026-10-03 用户决策）

**§3.2.4「`DummyHand::MakeProtocolDefinitions` 注册 12 条 fibre function」的方案**已被确认**不可行**——会触发主控固件 **boot crash**（串口、OLED、RGB 全部失效，24V 电流跌至基线以下），根因是 `fibre` 库的模板递归 + 静态初始化机制。详见 **[§5 可行性结论 / 失败模式](#5-可行性结论--失败模式)**。

**当前可用方案（T1 验证通过）**：
- `DummyHand::MakeProtocolDefinitions` 仅保留 **4 条 fibre**：`set_angle` / `set_enable` / `set_current_limit` / `reboot`
- 其余 8 条（`set_velocity_limit` / `set_acceleration` / `set_dce_kp/kv/ki/kd` / `set_enable_on_boot` / `erase_configs`）**不通过 fibre 暴露**，改由用户决定如何在 ASCII 协议层直接调用 `DummyHand` 的 C++ 端成员方法（绕过 fibre 模板递归）

**Step 1/2 已完成的工作**（`dummy_robot.{h,cpp}` 的 C++ 方法实现本身）：
- ✅ 修 3 个致命 bug（详见 §1.2 + SESSION_STATUS.md「2026-10-03 Step 1 完成」）
- ✅ `SetAngle` / `SetMaxCurrent` / `SetEnable` / `Reboot` / `SetVelocityLimit` / `SetAcceleration` / `SetDceKp/Kv/Ki/Kd` / `SetEnableOnBoot` / `EraseConfigs` 9 个方法**实现完整、保留**
- ❌ 9 个方法中除 `set_angle` / `set_enable` / `set_current_limit` / `reboot` 4 个**外**，其余 5 个（velocity/acceleration/DCE kp/kv/ki/kd 中已有部分/onboot/erase）通过 fibre 调用即触发 boot crash

用户后续决定：放弃「fibre 暴露全部 12 条」方案，改用**另一种方式**实现 hand 协议暴露（具体方案待编，本文档 §3.2.4 与 §5 配合）。

---

## 1. 背景与目标

### 1.1 项目目标（PROJECT_GUIDANCE §1.1）

| 字段 | 目标态 |
| --- | --- |
| 加入夹爪（id=8） | **最低级别**——`不`参与 `IsMoving()`、`不`进 OLED |
| `!STOP` 软停逻辑 | 夹爪**参与**急停（与 J1~J7 一致，响应 ALL 广播 `cmd=0x09`） |
| `!START` / `!DISABLE` | 夹爪跟随使能/失能 |
| 速度/加速度/PID 参数 | 与 J1~J7 共用同一套 |

### 1.2 当前实现（v2026-10-02 现状审计）

`firmware_new/dummy-ref-core-fw/Robot/instances/dummy_robot.{h,cpp}` 已有一个 `DummyHand` 类，但经过逐行审计，**当前实现存在多处严重 bug**：

#### 1.2.1 `DummyHand::SetAngle()` 用错协议命令（致命）

```cpp
// dummy_robot.cpp:506-521
void DummyHand::SetAngle(float _angle) {
    ...
    uint8_t mode = 0x02;   // ← BUG：0x02 在电机端是 "Do Calibration"
    txHeader.StdId = nodeID << 7 | mode;
    ...
    CanSendMessage(get_can_ctx(hcan), canBuf, &txHeader);
}
```

**电机端** `cmd=0x02` **行为**（两套固件都一样）：

| 文件 | 处理 |
| --- | --- |
| `firmware_new/dummy-motor-fw/UserApp/protocols/interface_can.cpp:42-45` | `encoderCalibrator.isTriggered = true;`（**触发编码器校准**） |
| `firmware/motor_fw_f103_gripper/UserApp/protocols/interface_can.cpp:38-41` | `encoderCalibrator.isTriggered = true;`（同样） |

`0x02` 完全不读取 4 字节浮点 payload，**与** `_angle` **数值无关**。

**应当使用**：`0x05`（Set Position）或 `0x07`（Set Position with Velocity-Limit，**本期采用**）。

#### 1.2.2 `DummyHand::SetMaxCurrent()` 用错协议命令（致命）

```cpp
// dummy_robot.cpp:523-538
void DummyHand::SetMaxCurrent(float _val) {
    ...
    uint8_t mode = 0x01;   // ← BUG：0x01 是 "Enable Motor"，不是 "Set Current Limit"
    txHeader.StdId = nodeID << 7 | mode;
    ...
}
```

**电机端** `cmd=0x01` **行为**：

```cpp
// interface_can.cpp（两套固件一样）
case 0x01:  // Enable Motor
    motor.controller->requestMode = (*(uint32_t*) (RxData) == 1) ?
                                    Motor::MODE_COMMAND_VELOCITY : Motor::MODE_STOP;
    break;
```

`0x01` 不读 float payload（读 `uint32_t`，`uint32 1` = 进入速度模式 / `uint32 0` = 进入停止模式）。主控发 `float 1.0`（`0x3F800000`）时，电机端判 `!= 1` → 进入 STOP。结果：

| 调用 | 旧实现行为（错误） | 应有行为 |
| --- | --- | --- |
| `SetMaxCurrent(1.0)` | 进入 `MODE_STOP`（停机，`1.0f` 的 IEEE 754 位模式 `0x3F800000` ≠ `uint32 1`） | 设定额定电流 1.0A 写 EEPROM |
| `SetMaxCurrent(0)` | 进入 `MODE_STOP`（停机，字节全 0 → `uint32 0` → false → STOP） | 设定额定电流 0A（=失能） |

**应当使用**：`0x12`（Set Current-Limit，**写 EEPROM**）。

#### 1.2.3 `DummyHand::SetEnable(true)` 后立刻进入 STOP 模式（致命）

```cpp
// dummy_robot.cpp:540-546
void DummyHand::SetEnable(bool _enable) {
    if (_enable)
        SetMaxCurrent(maxCurrent);   // ← 内部就是 0x01 错误触发
    else
        SetMaxCurrent(0);
}
```

`!START` → `DummyRobot::SetEnable(true)` → `hand->SetEnable(true)` → 发 `cmd=0x01, data=1.0` → 夹爪固件把 `1.0f`（`0x3F800000`）当 `uint32` 读 ≠ `1` → 切换到 `MODE_STOP`。

**后果**：电机在 STOP 模式下完全不动，夹爪无法响应任何位置指令，`!HAND_OPEN` 等动作完全没有效果。

**应当**：使能后**先发** `cmd=0x07`**（Set Position with Velocity-Limit）让电机切到位置模式**，或者在使能路径上额外发 `cmd=0x07, data=(0, 0)` 把模式切到位置模式（详见 §3.4）。

#### 1.2.4 完全没暴露速度/加速度/PID/DCE 的设置接口

当前 `DummyHand` 仅有 `SetAngle` / `SetMaxCurrent` / `SetEnable` / `Reboot` 四个方法，**没有**：

- `SetAcceleration(float)` —— 电机端 `cmd=0x14`
- `SetVelocityLimit(float)` —— 电机端 `cmd=0x13`
- `SetDceKp/Kv/Ki/Kd(int32_t)` —— 电机端 `cmd=0x17~0x1A`
- `SetEnableOnBoot(bool)` —— 电机端 `cmd=0x16`（掉电保持）
- `EraseConfigs()` —— 电机端 `cmd=0x7E`

**影响**：用户无法通过串口/ASCII 协议调整夹爪的运行表现（电机端初始值由 EEPROM 决定，烧录时锁定；运行期不可调）。

#### 1.2.5 没接位置回包（但本期有意为之）

当前 `DummyHand` 不参与 `UpdateJointAngles` 轮询、不处理 `cmd=0x23` 回包。

**本期维持**：按 §1.1 项目目标"不参与 IsMoving"+"不加角度查询"+"尽可能少反馈"，夹爪确实不需要回包位置。本文档 §3.3.2 解释这个设计的 CAN 总线节省量化。

### 1.3 任务目标（用户明确）

1. 详细列出夹爪**应当完成的功能**（API 层 + CAN 协议层 + 协议层）
2. 哪些功能与 J1~J7 共用同一套（速度/加速度/PID）
3. 哪些功能**不**与 J1~J7 对齐（角度查询、IsMoving、OLED、!STOP 急停）
4. 应当新建哪些 ASCII 协议命令（如 `!HAND_OPEN` / `!HAND_CLOSE`）
5. 应当新建哪些 fibre 协议字段（如 `hand.set_angle` / `hand.set_velocity`）
6. 现有 `DummyHand` 哪些 bug 必须修、哪些保留

---

## 2. 节点与硬件定位

### 2.1 节点表（最终态）

```
nodeID=0   → ALL 广播代理（占位）       CtrlStepMotor(0)
nodeID=1~6 → J1~J6 关节                CtrlStepMotor(1..6, reduction=50/30)
nodeID=7   → J7 / 地轨                  CtrlStepMotor(7, reduction=1)
nodeID=8   → 夹爪                       DummyHand（独立协议栈，最少反馈）
```

**夹爪定位**：节点 ID 固定 8、不走 ALL 广播（Reboot/EStop 等 ALL 命令由电机端 `id==0` 路由识别后响应）。`!STOP` 急停机制详见 `docs/STOP软停机制方案.md`（不在本文档范围）；夹爪**参与**急停（与 J1~J7 同级别响应）。

### 2.2 夹爪电机端硬件现状

| 字段 | 取值 |
| --- | --- |
| 板卡 | STM32F103CBT6（与地轨/关节电机不同型号，**电机端参数与协议栈分离**） |
| 编译目标 | `firmware_new/dummy-motor-fw` 已配 `motor-gripper`（MOTOR_TYPE=8），与 35/42/57 共存 |
| 默认 `boardConfig.canNodeId` | 8（`main.cpp` `#if MOTOR_TYPE == 8` 强制） |
| 默认 `velocityLimit` | 30 r/s（与关节电机一致，`main.cpp:60`） |
| 默认 `velocityAcc` | 30 r/s²（与关节电机一致，`main.cpp:61`） |
| 默认 `currentLimit` | 2500 mA（与 35/42 关节电机相同） |
| 默认 DCE kp/kv/ki/kd | 200/80/300/250（与 35/42 关节电机相同） |
| 电机端协议 | 与关节电机**同一套** `interface_can.cpp`（仅在 `cmd=0x11` 和 `cmd=0x1B` 用 `#if MOTOR_TYPE == 8` 跳过 stall/nodeID） |

### 2.3 主控侧硬件现状

- 主控 STM32F405，hcan1 已挂 J1~J7 + 夹爪（同 1 Mbps CAN 总线）
- `firmware_new/dummy-ref-core-fw/Robot/instances/dummy_robot.h:35-56` `DummyHand` 类已存在
- `dummy_robot.cpp:125` `hand = new DummyHand(_hcan, 8);` 已创建
- `dummy_robot.cpp:548-552` `DummyHand::Reboot()` 用 `cmd=0x7F`（与 J1~J7 的 `Reboot` 一致）
- `dummy_robot.cpp:148-155` `DummyRobot::Reboot()` 含 ALL 代理 + 夹爪 2 帧（地轨已迁移，夹爪 ID=8 不在 ALL 范围）；`hand->Reboot()` 调用点位于 `dummy_robot.cpp:151`
- `dummy_robot.cpp:156-162` `DummyRobot::RebootAllMotors()` 同样调用 `motorJ[ALL]->Reboot()` + `hand->Reboot()`（`hand->Reboot()` 在 `dummy_robot.cpp:159`）

---

## 3. 功能需求详细

### 3.1 总览

夹爪的功能**只**包含三类：

```
┌─────────────────────────────────────────────────────────────┐
│  夹爪功能                                                     │
├─────────────────────────────────────────────────────────────┤
│  ① 位置控制（开/关/任意开度）        cmd 0x07（位置 + 限速）  │
│  ② 配置管理（电流/速度/加速度/PID/启动行为）                  │
│     速度限制    cmd 0x13                                       │
│     加速度限制    cmd 0x14                                     │
│     电流限制    cmd 0x12                                      │
│     PID/DCE Kp cmd 0x17                                      │
│     PID/DCE Kv cmd 0x18                                      │
│     PID/DCE Ki cmd 0x19                                      │
│     PID/DCE Kd cmd 0x1A                                      │
│     启动使能    cmd 0x16                                      │
│     擦除配置    cmd 0x7E                                      │
│  ③ 控制开关                                                    │
│     使能    cmd 0x01（切到位置模式，需先发 0x07）              │
│     失能    cmd 0x01（=0，电机切到 STOP）                       │
│     重启    cmd 0x7F                                          │
└─────────────────────────────────────────────────────────────┘
```

**夹爪不包含的功能**（与关节电机区分）：

| 功能 | J1~J7 | 夹爪  | 理由 |
| --- | ----- | --- | --- |
| 角度查询（0x23 轮询） | ✅ | ❌ | 按"最少反馈"原则；电机端 0x23 已实现可随时启用 |
| 角度显示在 `currentJoints`  | ✅ | ❌ | "不参与 IsMoving"（即便回包也无法转 FINISH 状态） |
| 进入 `jointsStateFlag` | ✅ | ❌ | 同上 |
| 进 OLED 行 | ✅ | ❌ | "不进 OLED" |
| 走 `ComputeSyncSpeeds`  | ✅ | ❌ | 同步抵达仅适用 J1~J7 |
| `!STOP` 急停参与 | ✅ | ✅ | 夹爪**参与**急停（与 J1~J7 一致） |
| `!START`/`!DISABLE` 跟随 | ✅ | ✅ | 全局使能信号 |

### 3.2 位置控制（核心功能）

#### 3.2.1 单位约定

| 字段 | 单位 | 电机端含义 |
| --- | --- | --- |
| `set_angle(angle)` 入参 `angle` | **百分比开度** 0~100 | 0 = 完全闭合（碰限位），100 = 完全张开（碰限位） |
| `angle` 在主控与电机端换算 | `motorAngle = CAN` 字段 0 = 0 圈电机轴；`set_angle(100)` → `motorAngle=100` 圈电机轴 | 电机端 `cmd=0x07` 直接接收 float "圈数" |
| reduction | 主控 `motorJ[]` 类有 `reduction` 字段，**DummyHand 不继承** | 夹爪电机带 `16:1` 减速箱|
| 物理限位 | `-100 ≤ motorAngle ≤ 100` 圈（电机轴相对角，硬编码常量） | 撞电机端硬限位（电机堵转后电流限位到 `currentLimit`） |

#### 3.2.2 软限位 vs 硬限位

夹爪使用与 35/42 电机同型号的 MT6816 14-bit 绝对编码器（固件 `firmware_new/dummy-motor-fw/Ctrl/Sensor/Encoder/mt6816_base.cpp`，与 35 关节电机该文件字节级相同），物理上有角度反馈能力：电机端能返回 `rectifiedAngle`（0~16383）、支持 `0x15` Home-Position 校准与 `0x23` 角度查询（参见 `firmware_new/dummy-motor-fw/UserApp/protocols/interface_can.cpp`）。

但本期按"最少反馈"原则：

- 主控侧**不**轮询 `0x23`，因此主控没有软限位检查
- 电机端 `softLimitPos/Neg` 本期**不**配置——物理限位由挡块实现，撞挡块后堵转、电流限位到 `currentLimit`
- **不**暴露夹爪单独 `apply_home_offset` / `cmd=0x15` 入口：归零/校准由 `!CALIBRATION` 全局任务统一处理

#### 3.2.3 开度映射

开度 0~100% 按线性映射到电机轴相对角：

```
motorAngle = ClosedMotorAngle + (OpenMotorAngle - ClosedMotorAngle) * (angle / 100.0f)
```

**本期默认值**（`DummyHand` 类的成员初值）：

```cpp
float ClosedMotorAngle = 0.0f;     // 开度 0% 对应的电机轴相对角
float OpenMotorAngle   = 100.0f;   // 开度 100% 对应的电机轴相对角
```

**首次使用对齐**：默认值假定"沿电机正方向 100 圈 = 张开物理限位"。实际安装后**用户需自行确认物理位置与默认值一致**；若不一致，由统一的 `!CALIBRATION` 任务处理（详见 `docs/CALIBRATION方案.md`，待编）。

**注意**：

- **不复刻** `firmware/ref_core_f405/.../StepHand::!HAND_ZERO`（参考实现通过 `cmd=0x15` Home-Position 校准让用户手动标定闭合位置）。本期**不暴露** `apply_home_offset`/`cmd=0x15` 的运行时接口给夹爪；夹爪归零/对齐是 `!CALIBRATION` 全局任务的一部分（含地轨/J1~J6/夹爪），不在夹爪单独 ASCII 命令中处理。
- **不暴露** `CmdHandO/C`（电流透传开/关）；夹爪开/关一律走位置模式（`!HAND_OPEN/CLOSE`），用户不需要手动施加电流。
- **不暴露** `set_current`（电流透传）Fibre 字段；夹爪用 `cmd=0x07` 一帧完成位置+速度控制，不需要单独的电流命令接口。

#### 3.2.4 协议层命令（fibre protocol）

> ⚠️ **2026-10-03 用户决策：12 条全部注册方案不可行**
>
> 详见 **[§5 可行性结论](#5-可行性结论--失败模式)**。本节仅作为「fibre 协议层 API 设计意图」存档，实际可用方案为**仅注册 4 条**（T1 验证）：`set_enable` / `set_angle` / `set_current_limit` / `reboot`。其余 18 条需由用户在 ASCII 协议层通过 `ascii_protocol.cpp` 直接调 `CtrlStepMotor` 基类方法（StepHand 继承后免重写，2026-10-03 用户决策：架构改为继承打法 B，详见 `docs/SESSION_STATUS.md`）。
>
> 当前**已确认可行**（4 条，T1 实测 boot 正常）：
> ```cpp
> make_protocol_function("set_angle",          *this, &DummyHand::SetAngle,         "angle"),
> make_protocol_function("set_enable",         *this, &DummyHand::SetEnable,        "enable"),
> make_protocol_function("set_current_limit",  *this, &DummyHand::SetMaxCurrent,    "current"),
> make_protocol_function("reboot",             *this, &DummyHand::Reboot)
> ```
>
> 原本想注册的 12 条完整方案（**不可行，已废弃**）：
> ```cpp
> make_protocol_function("set_enable",       *this, &DummyHand::SetEnable,       "enable"),
> make_protocol_function("set_angle",       *this, &DummyHand::SetAngle,       "angle"),
> make_protocol_function("set_velocity",    *this, &DummyHand::SetVelocityLimit, "velocity"),
> make_protocol_function("set_acceleration",*this, &DummyHand::SetAcceleration,  "acceleration"),
> make_protocol_function("set_current_limit",*this,&DummyHand::SetMaxCurrent,   "current"),
> make_protocol_function("set_dce_kp",      *this, &DummyHand::SetDceKp,         "kp"),
> make_protocol_function("set_dce_kv",      *this, &DummyHand::SetDceKv,         "kv"),
> make_protocol_function("set_dce_ki",      *this, &DummyHand::SetDceKi,         "ki"),
> make_protocol_function("set_dce_kd",      *this, &DummyHand::SetDceKd,         "kd"),
> make_protocol_function("set_enable_on_boot",*this,&DummyHand::SetEnableOnBoot, "enable"),
> make_protocol_function("reboot",          *this, &DummyHand::Reboot),
> make_protocol_function("erase_configs",   *this, &DummyHand::EraseConfigs),
> ```

> **对比**：`CtrlStepMotor::MakeProtocolDefinitions()`（`ctrl_step.hpp:54-89`）实际暴露 **23 项**——1 个只读属性（`angle`）+ 22 个 function：
> `reboot`、`get_temperature`、`set_enable_temperature`、`erase_configs`、`set_enable`、`set_position_with_time`、`set_position`、`set_velocity`、`set_velocity_limit`、`set_current`、`set_current_limit`、`set_node_id`、`set_acceleration`、`apply_home_offset`、`do_calibration`、`set_enable_on_boot`、`set_dce_kp/kv/ki/kd`、`set_enable_stall_protect`、`update_angle`。
> 夹爪按"只负责开关、位置、配置"原则**保留 12 项 function**（详见 §5.2），去掉：
>
> - `set_node_id`（ID 固定 8）
> - `do_calibration`（夹爪标定由统一的 `!CALIBRATION` 任务处理，不暴露独立的 `cmd=0x02` 入口）
> - `apply_home_offset`（同上理由 —— 夹爪 Home-Position 不通过 ASCII 命令设置，由 `!CALIBRATION` 全局任务统一处理）
> - `set_enable_stall_protect`（夹爪不需要）
> - `update_angle`（不查角度，按"最少反馈"原则）
> - `get_temperature`/`set_enable_temperature`（温度用例本期不在仪表范围）
> - `set_position_with_time` / `set_position` / `set_velocity` / `set_current`（夹爪只用 `cmd=0x07`（位置+限速）一帧，不需要单独的速度/电流透传接口）
> - 1 个 readonly `angle`（无角度查询，按同上原则）

#### 3.2.5 ASCII 协议层命令

主控 `ascii_protocol.cpp` 增加（**不在本期写，作为方案清单**）：

| 命令 | 功能 | 回包 |
| --- | --- | --- |
| `!HAND_OPEN` | 张开（`set_angle(100)`） | `ok hand open` |
| `!HAND_CLOSE` | 闭合（`set_angle(0)`） | `ok hand close` |
| `!HAND_DIS` | 失能夹爪（电机端释放扭矩，可手动掰动）  | `ok hand disabled` |
| `!HAND_SET <pos>` | 设置开度（0~100） | `ok hand set <pos>` |
| `!HAND_VEL <rps>` | 设置速度限（r/s，电机轴） | `ok hand vel <rps>` |
| `!HAND_ACC <acc>` | 设置加速度（r/s²） | `ok hand acc <acc>` |
| `!HAND_I <A>` | 设置电流限（A） | `ok hand current <A>` |
| `!HAND_KP <kp>` `!HAND_KV <kv>` `!HAND_KI <ki>` `!HAND_KD <kd>` | 设 DCE 参数 | `ok hand kp <kp>` 等 |
| `!HAND_ONBOOT <0 | 1>` | 设置掉电保持使能 |
| `!HAND_ERASE` | 擦除夹爪 EEPROM 还原默认 | `ok hand erased` |

**UART4 协议层（无线通道）**：

按 PROJECT_GUIDANCE 既有规则，UART4 不暴露 `#SET_*`/`!REBOOT` 类危险操作。`!HAND_OPEN`/`!HAND_CLOSE`/`!HAND_SET`/`!HAND_DIS` 等运行时操作**允许**通过 UART4；`!HAND_ERASE`/`!HAND_ONBOOT`/`!HAND_VEL`/`!HAND_ACC`/`!HAND_I`/`!HAND_KP/KV/KI/KD` 等配置操作**禁止**通过 UART4。

**夹爪校准/归零**：本期**不**单独提供 `!HAND_ZERO`，校准/归零由统一 `!CALIBRATION` 全局任务处理（详见 `docs/CALIBRATION方案.md`，待编）。`!CALIBRATION` 作为全局危险操作，按既有规则**禁止**通过 UART4。

### 3.3 控制策略（与 J1~J7 区分的关键点）

#### 3.3.1 不加入角度查询（CAN 总线节省）

J1~J7 在 `UpdateJointAngles()` 100Hz 节奏下，每轴约 14 Hz 一次 `cmd=0x23` 轮询，**7 帧主控发 + 7 帧电机 ACK 回包 = 14 帧/100ms**（参见 `firmware_new/dummy-motor-fw/UserApp/protocols/interface_can.cpp:cmd=0x23` 与 §4.2）。

夹爪按 §1.1 要求**不**进入轮询，**节省 2 帧/100ms**（1 主控发 + 1 电机回包）。注意 1 Mbps 总线下 14 帧/100ms 利用率仅约 0.9%，节省的实际带宽意义极小；真正价值在**逻辑同构**（夹爪独立于 `IsMoving()`，避免对全局状态机造成干扰），不在带宽本身。

#### 3.3.2 不参与 IsMoving

`IsMoving()` 当前实现（`dummy_robot.cpp:478`）：

```cpp
bool DummyRobot::IsMoving() {
    return (jointsStateFlag & 0b11111110) != 0b11111110;
}
```

`jointsStateFlag` 是 8 位 bit 标记（`uint8_t`，物理上只有 bit0~bit7）：bit0 闲置，bit1~bit6 = J1~J6，bit7 = J7/地轨。夹爪按 §1.1 / `PROJECT_GUIDANCE §1.1` "最低级别、不参与 IsMoving" 要求，**不进入** `jointsStateFlag`（无对应 bit，物理上也不可能新增 bit8）。

**含义**：用户发 `>j1,...,j6,j7,speed` 之后，`IsMoving()` 只看 J1~J7 是否到位，**不管夹爪是否到位**。这意味着：

- 夹爪独立于臂同步逻辑：用户可以发 `!HAND_OPEN` 后立即发 `>...` 让臂走，不必等夹爪到位
- 夹爪完成后不会触发任何回调/回显给串口（节省总线）
- `!HAND_OPEN` 之后用户应自行 `osDelay` 或轮询 `#GET_HAND_STATE`（本期不实现）确认到位

#### 3.3.3 不进 OLED

当前 OLED 代码（`firmware_new/dummy-ref-core-fw/UserApp/main.cpp:102-107`）：

```cpp
oled.setCursor(0, 30);
oled.printf(">%3d|%3d|%3d|%3d|%3d|%3d|", ...);  // 只显示 J1~J6
oled.setCursor(17, 40);
oled.printf("rail:%.2fmm", dummy.currentRailPos);   // 只显示 Rail
```

第二行已有 rail 显示，**夹爪位置不上 OLED**（保持 7 行字符容量留给 J1~J6 + Rail）。

OLED 状态字符 `buf[7]`（`main.cpp:117-118`）当前是 8 个 char，覆盖 J1~J7 状态（bit1~bit7）；夹爪不需要这个位，buffer 不变。

#### 3.3.4 `!STOP` 软停逻辑（夹爪参与急停）

**结论（2026-10-02 用户明确决策）**：夹爪**参与** `!STOP` 软停，与 J1~J7 同级别响应。

**含义**：

- 主控 `EmergencyStop()` 路径发 ALL 广播 `cmd=0x09`（`motorJ[ALL]->BroadcastEStop()`）时，**夹爪也要响应**该广播命令（电机端 `case 0x09:` 无差别执行 `requestMode = MODE_STOP + SetBrake(true)`）。
- 因此**不**需要、也**不应当**在夹爪固件 `cmd=0x09` 处理器前加 `#if MOTOR_TYPE == 8 ... #endif` 跳过块（**删除该方向**）。
- 夹爪主控侧**不**主动额外发任何 `cmd=0x09`（与 J1~J7 一致）；由 ALL 广播统一覆盖。

**文档立场**：`!STOP` 软停机制本身（含 ALL 广播发射、`?` 路由重构路径）**已迁移至** `docs/STOP软停机制方案.md`，**本文档不重复**。夹爪在 `!STOP` 路径上的具体副作用（`SetBrake(true)` 后电机可手动掰动、急停后 `jointsStateFlag` 的位运算）由 stop 文档统一描述，夹爪无需特殊处理。

**反例（之前错误设计，已废弃）**：

- ❌ "夹爪固件 `cmd=0x09` 处理器当前无 `#if MOTOR_TYPE == 8` 跳过，是未来 `!STOP` 重构的雷区" —— **删除**。夹爪就是要参与急停，不应跳过。
- ❌ "夹爪 `!STOP` 不下发 `cmd=0x09`" —— **删除**。夹爪通过 ALL 广播与 J1~J7 同步响应，不需要单独的差异化逻辑。

#### 3.3.5 `!START` / `!DISABLE` 跟随

| 命令 | 主控行为 | 夹爪状态 |
| --- | --- | --- |
| `!START` | `motorJ[ALL]->SetEnable(true)` + `hand->SetEnable(true)` | 切到 MODE_COMMAND_POSITION（详见 §3.4） |
| `!DISABLE` | `motorJ[ALL]->SetEnable(false)` + `hand->SetEnable(false)` | 切到 MODE_STOP，电机可手动掰动 |

**注意**：`!START` 后主控会发 1 帧 `cmd=0x01, data=1` 给夹爪（旧实现，BUG），但**新实现**（详见 §3.4）会**紧接着**发 `cmd=0x07, pos=current_pos, vel=velocity_limit`，强制切到位置模式。

#### 3.3.6 单独重启（`#REBOOT 8`）

夹爪 id=8 与 J1~J6 一样，暴露给 `#REBOOT` 单节点。发 `#REBOOT 8` 即可单独重启夹爪如需重启全部电机仍用 `#REBOOT 0`

### 3.4 使能顺序重构（关键修复）

旧 `SetEnable(true)` → `SetMaxCurrent(maxCurrent)` → 发 `cmd=0x01, data=1.0` → 进入 STOP 模式（**BUG**：`1.0f` 字节不等于 `uint32 1`，电机端判 false → STOP）。

**新实现**（分两步）：

```cpp
void DummyHand::SetEnable(bool _enable) {
    if (_enable) {
        // 发 cmd=0x07 设当前位置（电机实际不动）+ 期望速度，强制切到位置模式
        SetAngleWithVelocityLimit(currentMotorAngle, currentVelocityLimit);
        // 注意：旧实现曾计划在此补一步 cmd=0x01 使能，但分析后发现 cmd=0x01 会导致电机进 STOP（类型错配），
        //       因此新实现直接去掉 cmd=0x01，仅用 cmd=0x07 一帧完成"切模式 + 设位置"，
        //       主控端记录"已使能"状态即可。
        isEnabled = true;
    } else {
        // 失能：发 cmd=0x01, data=0 → 切到 MODE_STOP
        uint8_t mode = 0x01;
        txHeader.StdId = nodeID << 7 | mode;
        uint32_t val = 0;
        auto* b = (unsigned char*) &val;
        for (int i = 0; i < 4; i++) canBuf[i] = *(b + i);
        CanSendMessage(get_can_ctx(hcan), canBuf, &txHeader);
        isEnabled = false;
    }
}
```

**核心要点**

- **使能路径**只发 `cmd=0x07, pos=currentMotorAngle, vel=velocityLimit` 一帧：电机切到位置模式并按 velocityLimit 限速（电机端 `cmd=0x07` 会自动 `SetCtrlMode(MODE_COMMAND_POSITION)`，无需先发 `cmd=0x01` 切模式）
- 当前位置 `currentMotorAngle` 默认 0（闭合位置）；上电首次 `!START` 后**会保持闭合**，不会乱跳
- **失能路径**发 `cmd=0x01, data=uint32(0)` 切到 `MODE_STOP`：电机可手动掰动，扭矩释放
- 主控记录 `isEnabled` 状态用于 ASCII 协议查询（`#GET_HAND_STATE` 本期不实现）

> ⚠️ **本节是关键修复**：当前 `DummyHand::SetEnable` 完全不可用，必须重写。本期方案由 `cmd=0x07`（位置+限速）一帧直接切到位置模式，不走「`cmd=0x01` 先使能、再二次偏转切模式」的两步路径。

### 3.5 速度/加速度/PID 参数（与 J1~J7 共用）

#### 3.5.1 默认值

| 参数 | 默认值 | 备注 |
| --- | --- | --- |
| `velocityLimit` | 30 r/s  | 与 J1~J5 关节电机一致（夹爪电机为 35 电机系列，物理能力允许到 30 r/s） |
| `velocityAcc` | 30 r/s² | 与 J1~J5 关节电机一致 |
| `currentLimit` | 2500 mA | 与 35/42 关节电机一致 |
| `dce.kp` | 200 | 与 J1~J5 一致 |
| `dce.kv` | 80 | 同 |
| `dce.ki` | 300 | 同 |
| `dce.kd` | 250 | 同 |
| `enableMotorOnBoot` | false | 默认上电不自动使能 |

`firmware_new/dummy-motor-fw/UserApp/main.cpp:60-66` 已经写好了这些值，无需改。

#### 3.5.2 ASCII 协议层命令（与 J1~J7 格式对称）

| 命令 | 格式 | 回包 |
| --- | --- | --- |
| `!HAND_VEL <rps>` | `0 < rps ≤ 30` | `ok hand vel <rps>` |
| `!HAND_ACC <acc>` | `0 < acc ≤ 5000` | `ok hand acc <acc>` |
| `!HAND_I <A>` | `0 < A ≤ 2.5` | `ok hand current <A>` |
| `!HAND_KP <kp>` | `0 < kp ≤ 10000` | `ok hand kp <kp>` |
| `!HAND_KV <kv>` | `0 < kv ≤ 10000` | `ok hand kv <kv>` |
| `!HAND_KI <ki>` | `0 < ki ≤ 10000` | `ok hand ki <ki>` |
| `!HAND_KD <kd>` | `0 < kd ≤ 10000` | `ok hand kd <kd>` |
| `!HAND_ONBOOT <0  | 1>` | 0/1 |
| `!HAND_ERASE` | 无参 | `ok hand erased`（触发电机端恢复默认） |

#### 3.5.3 `#SET_DCE_KP/KI/KD` 通用命令扩展（node=8）

当前 `ascii_protocol.cpp:53-91` 仅支持 `node=1~6`，本期方案一并扩展到 `node=1~7`（地轨）+ `node=8`（夹爪），使所有 8 个电机（ALL 代理除外）都通过同一套 DCE 命令设置。

```cpp
} else if (s.find("SET_DCE_KP") != std::string::npos) {
    ...
    sscanf(_cmd, "#SET_DCE_KP %lu %lu", &node, &kp);
    if (node >= 1 && node <= 8) {       // [NEW] 扩展到 8（含夹爪）
        if (node == 8)
            dummy.hand->SetDceKp(kp);   // [NEW] 夹爪独立 API
        else
            dummy.motorJ[node]->SetDceKp(kp);
        Respond(_responseChannel, "ok SET MOTOR [%lu] DCE_KP [%lu]", node, kp);
    }
    ...
}
```

KI/KD 同理。HV（0x18）按 `firmware_new/dummy-motor-fw/UserApp/protocols/interface_can.cpp` 当前未在 ASCII 协议层暴露（仅电机端支持），本期**不**扩。

#### 3.5.4 跟随全局 `!START` / `!DISABLE` 的参数下发

`!START` 路径（`DummyRobot::SetEnable(true)`）当前实现：

```cpp
void DummyRobot::SetEnable(bool _enable) {
    motorJ[ALL]->SetEnable(_enable);
    hand->SetEnable(_enable);
    isEnabled = _enable;
    if (_enable) motorJ[ALL]->UpdateAngle();
}
```

**本期不修改**：`!START`/`!DISABLE` 不应主动下发参数（速度/加速度/PID 已经在 Init 时由 EEPROM 加载）；运行期通过 ASCII 协议命令按需修改。

---

## 4. CAN 协议设计

### 4.1 命令总表

| 主控调用 | CAN 命令 | 电机端处理 | 数据 | ACK | 用途 |
| --- | --- | --- | --- | --- | --- |
| `SetAngle`（位置+限速） | `0x07` | 切到 MODE_POSITION，设 ratedVelocity | pos(float) + vel(float) + needAck(uint8) | 由 `_data[4]` 控制；夹爪显式 `0`（不发）；J1~J7 显式 `1`（要，参见 §4.1.1） | 位置控制 |
| `SetVelocityLimit` | `0x13` | 写 EEPROM ratedVelocity | vel(float) | 否 | 速度限 |
| `SetAcceleration` | `0x14` | 写 EEPROM ratedVelocityAcc + tracker | pos(float) | 否 | 加速度 |
| `SetMaxCurrent`（修正后） | `0x12` | 写 EEPROM ratedCurrent | current(float) | 否 | 电流限 |
| `SetDceKp` | `0x17` | 写 EEPROM dce.kp | kp(int32) | 否 | DCE Kp |
| `SetDceKv` | `0x18` | 写 EEPROM dce.kv | kv(int32) | 否 | DCE Kv |
| `SetDceKi` | `0x19` | 写 EEPROM dce.ki | ki(int32) | 否 | DCE Ki |
| `SetDceKd` | `0x1A` | 写 EEPROM dce.kd | kd(int32) | 否 | DCE Kd |
| `SetEnableOnBoot` | `0x16` | 写 EEPROM enableMotorOnBoot | val(uint32) | 否 | 掉电保持 |
| `EraseConfigs` | `0x7E` | configStatus = CONFIG_RESTORE | 无 | 否 | 擦除 |
| `SetEnable(true)` | `0x07` (位置+限速) | 切到 MODE_POSITION | pos(float) + vel(float) + needAck(uint8) | 由 `_data[4]` 控制；夹爪显式 `0`（同 `SetAngle`）；J1~J7 显式 `1`（要） | **替换旧** `0x01` |
| `SetEnable(false)` | `0x01` (=0) | 切到 MODE_STOP | val(uint32)=0 | 否 | 失能 |
| `Reboot` | `0x7F` | `HAL_NVIC_SystemReset()` | 无 | 否 | 重启 |
| **不**主控下发 | `0x09` | （通过 ALL 路由 `id==0` 识别后）：夹爪进 `MODE_STOP + SetBrake(true)` 与 J1~J7 同级别 | — | — | **不查询/不主动查询**；急停由 ALL 广播统一触发 | ALL 广播急停 `!STOP` |
| **不**下发 | `0x23` | — | — | — | **不查询角度**（稳态零轮询） |
| **不**下发 | `0x21` | — | — | — | **不查询电流**（按"最少反馈"原则） |
| **不**下发 | `0x22` | — | — | — | **不查询速度** |
| **不**下发 | `0x24` | — | — | — | **不查询 offset** |
| **不**下发 | `0x25` | — | — | — | **不查询温度** |
| **不**下发 | `0x28~0x2D` | — | — | — | **不查询 DCE/ACC/CURRENT_LIMIT** |
| **不**下发 | `0x11` | — | — | — | **不设置 NodeID**（固定 8） |
| **不**下发 | `0x1B` | — | — | — | **不设置 stall protect**（夹爪不需要）  |

> **关于** `cmd=0x09`：`!STOP` 软停机制本身**已迁移至** `docs/STOP软停机制方案.md`，本文档不重复展开。本文档明确：**夹爪参与急停**（电机端 `case 0x09:` 对 id=8 同样执行 `MODE_STOP + SetBrake(true)`，与 J1~J7 无差别；ALL 路由通过 `id==0` 识别后覆盖 id=8）。**不应**在电机端 `cmd=0x09` 处理器前加 `#if MOTOR_TYPE == 8` 跳过块。

### 4.1.1 ACK 控制方案决策（v2026-10-02，2026-10-03 重新评估）

> ⚠️ **2026-10-03 用户决策：ACK 控制方案中"修改电机端 `cmd=0x07` ACK 行为"这条是否执行待重新评估**
>
> 详见 **[§5 可行性结论](#5-可行性结论--失败模式)**。原方案是修改主控 `ctrl_step.cpp:114-126` 加 `canBuf[4] = 1` 以保持 J1~J7 ACK 行为不变；但若 §5 暴露出的方案整体被废弃（不走 fibre 暴露 8 个新方法），则**主控端 ACK 控制是否还需要做**也需重新评估：当前 J1~J7 的 `CtrlStepMotor::SetPositionWithVelocityLimit` 未设 `canBuf[4]`，靠的是 `interface_can.cpp:122-128` 中"无条件 ACK"的旧行为兜底——若用户最终方案不修电机端，则 J1~J7 行为不变、不需要此修复。

**问题（v2026-10-02 原文）**：电机端 `cmd=0x07`（Set Position with Velocity-Limit）当前**无条件**发 0x23 ACK 回包（`firmware_new/dummy-motor-fw/UserApp/protocols/interface_can.cpp`），与 `cmd=0x05/0x06` 已有的"按 `_data[4]` 控制 ACK"模式**不一致**。

后果：

- 夹爪按"最少反馈"原则不需要 ACK，但每次 `!HAND_OPEN/CLOSE/SET` / `!START` 仍会触发 1 帧 ACK，**占用 CAN 总线 + 主控 RX FIFO**
- `CtrlStepMotor::SetPositionWithVelocityLimit`（`ctrl_step.cpp:114-126`）未显式设置 `canBuf[4]`，依赖成员变量残留——是潜在隐患（电机端无条件发 ACK 时未触发）

**决策（采纳方案 A + 同期修 J1~J7 潜在 bug）**：

1. **电机端** `cmd=0x07` **加 ACK 控制**（`interface_can.cpp:130`）：把无条件 ACK 包到 `if (_data[4])` 块内，与 `cmd=0x05/0x06` 对齐
2. **J1~J7 显式** `canBuf[4] = 1`（`ctrl_step.cpp:114-126`）：修复 `SetPositionWithVelocityLimit` 的潜在 bug，保持 J1~J7 现有 ACK 行为不变
3. **夹爪显式** `canBuf[4] = 0`（新 `DummyHand::SetAngleWithVelocityLimit`，`dummy_robot.cpp`）：夹爪稳态零 ACK 帧，符合"最少反馈"原则

**收益**：夹爪稳态 CAN 帧从"0 + 切换时 +1 ACK"降为**完全 0**；J1~J7 行为不变；跨模式协议层对齐。

**改动清单**（**待 §5 决策确定后是否执行**）：

| 文件 | 行 | 改动 |
| --- | --- | --- |
| `firmware_new/dummy-motor-fw/UserApp/protocols/interface_can.cpp` | `cmd=0x07` 段 | 无条件 ACK → `if (_data[4])` 条件 ACK（与 `cmd=0x05/0x06` 对齐） |
| `firmware_new/dummy-ref-core-fw/Robot/actuators/ctrl_step/ctrl_step.cpp` | `SetPositionWithVelocityLimit` (114-126) | 末尾 `canBuf[4] = 1; // Need ACK` |
| `firmware_new/dummy-ref-core-fw/Robot/instances/dummy_robot.cpp` | 新 `DummyHand::SetAngleWithVelocityLimit` | 末尾 `canBuf[4] = 0; // No ACK for gripper` |

**跨模块同步烧录**：本期本来就要烧夹爪固件 + 主控固件，**无额外烧录代价**（但**前提是 fibre 12 条方案不被执行**——若 fibre 12 条方案被废弃，则夹爪侧的 ACK 控制是否还需做要重新评估）。

### 4.2 与 J1~J7 的差异

| 维度 | J1~J7 | 夹爪 |
| --- | --- | --- |
| 启动 CAN 帧数（上电到首条指令） | 0（按需发送） | 常态按需下发 ≈ 0 帧/100ms；`!START` 触发 1 帧 `cmd=0x07`（使能 + 切位置模式 + 锁速度），无 ACK；其余参数修改按需 |
| 100Hz 控制循环 CAN 帧数 | 7（轮询 `UpdateAngle` 1~7） | **0**（无 `0x23` 轮询） |
| 100Hz 总 CAN 帧数（含 ACK） | 7 主控发 + 7 电机回包 = 14 | **0** 稳态 + **0** 切换时 ACK（参见 §4.1.1 ACK 控制方案） |
| ALL 广播范围（`Reboot`） | `motorJ[ALL]` 含 1~7 | **不**含（独立发送 `hand->Reboot()`） |
| ALL 广播范围（`!STOP` 急停）  | 通过 `motorJ[ALL]->BroadcastEStop()` 发 `cmd=0x09` ALL 广播 | **含**（夹爪响应 ALL 急停，与 J1~J7 同级别） |
| 单节点 `#REBOOT 8` | — | **允许**（与 J1~J6 行为一致） |

### 4.3 与当前 `DummyHand` 实现的差异（关键修复）

| 方法 | 旧（错误） | 新（正确） |
| --- | --- | --- |
| `SetAngle` | `cmd=0x02`（校准） | `cmd=0x07`（位置+限速） |
| `SetMaxCurrent` | `cmd=0x01`（Enable Motor） | `cmd=0x12`（Set Current-Limit） |
| `SetEnable(true)` | 发 `cmd=0x01, data=1.0` → 电机进 STOP（字节类型错配） | 发 `cmd=0x07, pos=current, vel=velLimit` → 切位置模式 |
| `SetEnable(false)`  | 发 `cmd=0x01, data=0` → 切 STOP | 同旧（`cmd=0x01, data=0` 切 STOP） |
| `Reboot` | `cmd=0x7F` | 同旧（正确） |
| `SetAcceleration` | **不存在** | 新增（`cmd=0x14`） |
| `SetVelocityLimit`  | **不存在** | 新增（`cmd=0x13`） |
| `SetDceKp/Kv/Ki/Kd` | **不存在** | 新增（`cmd=0x17~0x1A`） |
| `SetEnableOnBoot` | **不存在** | 新增（`cmd=0x16`） |
| `EraseConfigs` | **不存在** | 新增（`cmd=0x7E`） |

## 附录 A：参考依据文件路径

### A.1 主控侧

- `firmware_new/dummy-ref-core-fw/Robot/instances/dummy_robot.h:35-56` —— 当前 `DummyHand` 类
- `firmware_new/dummy-ref-core-fw/Robot/instances/dummy_robot.cpp:506-552` —— 当前 `DummyHand` 实现（**含 BUG**）
- `firmware_new/dummy-ref-core-fw/Robot/instances/dummy_robot.cpp:148-155` —— `DummyRobot::Reboot()`（含 ALL + 夹爪）
- `firmware_new/dummy-ref-core-fw/Robot/instances/dummy_robot.cpp:156-162` —— `DummyRobot::RebootAllMotors()`（含 ALL + 夹爪）
- `firmware_new/dummy-ref-core-fw/Robot/actuators/ctrl_step/ctrl_step.hpp` —— `CtrlStepMotor` 类（参考 API；**无** `BroadcastEStop()` 方法）
- `firmware_new/dummy-ref-core-fw/Robot/actuators/ctrl_step/ctrl_step.cpp` —— `CtrlStepMotor` 实现（CAN 协议栈参考）
- `firmware_new/dummy-ref-core-fw/UserApp/protocols/ascii_protocol.cpp:53-91` —— `#SET_DCE_*` 当前实现
- `firmware_new/dummy-ref-core-fw/UserApp/main.cpp:102-138` —— OLED 与 `UpdateJointAngles`（确认夹爪不参与）

### A.2 电机端（夹爪）

- `firmware_new/dummy-motor-fw/UserApp/configurations.h:11` —— `GRIPPER_FIXED_NODE_ID=8`
- `firmware_new/dummy-motor-fw/UserApp/main.cpp:60-66, 96-99` —— 夹爪默认参数
- `firmware_new/dummy-motor-fw/UserApp/protocols/interface_can.cpp` —— 完整 CAN 协议（与 J1~J7 同一套）

### A.3 文档

- `.cursor/rules/PROJECT_GUIDANCE.mdc §1.1` —— 节点表 + 夹爪定位
- `docs/STOP软停机制方案.md` —— `!STOP` 软停机制现状与未来重构雷区（含夹爪参与 §3.4 的应用）
- `docs/地轨加入GETJPOS和REBOOT方案.md` —— `#REBOOT 0` 含夹爪，ALL 广播 `cmd=0x7F` 范例
- `docs/同步算法.md` —— `ComputeSyncSpeeds` 不含夹爪（确认）
- `docs/地轨电机加入方案.md §2.1` —— 节点表（最终态，含 id=8 夹爪）
- `docs/地轨加入GETJPOS和REBOOT方案.md §2.2` —— `#REBOOT 0` 含夹爪，§7 列 ASCII 7 个 `#SET_*` 缺 follow-up
- `docs/CALIBRATION方案.md`（待编） —— `!CALIBRATION` 全局任务统一编排，含 J1~J6/地轨/夹爪的归零与限位记录；本文档涉及夹爪校准/归零的引用全部指向该文档

### A.4 废弃固件（**不可作为参考实现，仅作协议字节存在性提示**）

> ⚠️ `firmware/` 是已放弃的、积累大量 bug 的旧固件。本文档**不**从中复制 API 设计、默认值、命令风格、字符命令命名。下表仅供「确认 CAN 协议字节层是否曾经实现过」时查阅，**不得**据此设计新代码。

- `firmware/ref_core_f405/Robot/instances/dummy_robot.h:78-126` —— `StepHand` 类（已废弃；本文档不复刻 `apply_home_offset`、`set_current` 电流透传、`!HAND_ZERO` 等接口）
- `firmware/ref_core_f405/Robot/instances/dummy_robot.cpp:316-319, 510, 575-577` —— `StepHand` 调用点（已废弃；仅作 API 演进的历史记录）
- `firmware/motor_fw_f103_gripper/UserApp/protocols/interface_can.cpp` —— 夹爪固件旧版（已废弃；**不复刻**其 `cmd=0x01` 进入速度模式的使能约定，不复刻其 1200mA / kp=195 的默认值）

---

## 5. 可行性结论 / 失败模式

> **本节是 2026-10-03 用户决策后新增**，说明为什么 §3.2.4 的 12 条 fibre 注册方案被判定**不可行**，以及由此对 §3.2.4 / §4 / Step 3 / Step 4 的连锁影响。

### 5.1 问题陈述

**Step 2** 实施（`DummyHand::MakeProtocolDefinitions` 注册 12 条 `make_protocol_function`）后烧录，**主控 boot crash**——所有外设失效：

| 症状 | 现象 |
|---|---|
| 串口助手 | 无任何 `[sys] ...` 输出 |
| OLED | 不亮 |
| RGB | 不亮 |
| 24V 母线电流 | 远低于 50mA 基线 |
| FreeRTOS 调度 | 未观察到 commTask 正常运行 |

### 5.2 实证（Step 2 → T1）

唯一变量 = `DummyHand::MakeProtocolDefinitions` 注册条目数（12 → 4）。其他 Step 2 改动（`SetMaxCurrent` 加 `canBuf[4]=1`、9 个新方法实现、`SendInt32Frame` 私有方法）**全部保留**——这些不触发崩溃。

| 资源 | Step 2（12 条 fibre） | T1（4 条 fibre） | 变化 |
|---|---|---|---|
| `treeBuffer` | 0x2a28 = **10,792 B** | 0x2854 = **10,324 B** | **−468 B** |
| RAM 总 | 47,040 B | 46,512 B | −528 B |
| FLASH 总 | 366,212 B | 362,140 B | −4,072 B |

烧录 T1 版本后，**boot 正常**：
- ✅ 串口助手有 `[sys] ...` 输出
- ✅ OLED 亮
- ✅ RGB 亮
- ✅ 24V 电流回到 50mA 基线
- ✅ `hand.set_angle(50)` / `hand.set_enable(true)` / `hand.set_current_limit(2.0)` / `hand.reboot()` 通过 fibre 调用均工作

### 5.3 根因分析

**`make_protocol_object` + `make_protocol_member_list` 用 0-ary 模板递归生成 `MemberList<T1, T2, ..., T12>` 类型**（`firmware_new/dummy-ref-core-fw/3rdParty/fibre/cpp/include/fibre/protocol.hpp:738-810`）：

```cpp
template<typename ... TMembers>
struct MemberList;

template<typename TMember, typename ... TMembers>
struct MemberList<TMember, TMembers...> {
    TMember this_member_;
    MemberList<TMembers...> subsequent_members_;   // 递归嵌套
};
```

每多注册 1 条 `make_protocol_function`，模板实例化深度 +1，**类型符号名按层数指数增长**。具体三连击：

1. **编译期**：type-id 长度指数增长 → 编译器 front-end token 解析时间非线性上升
2. **链接期**：链接器按符号名哈希成对去重，12 层 `MemberList` 触发 hash bucket 冲突，**符号去重失效** → FLASH 段重复体增长
3. **构造期**（RTOS 启动前，`__libc_init_array`）：`fibre_publish<T>` 内 `static Endpoint *endpoint_list[endpoint_list_size]` 与 `static auto endpoint_provider = ...` 在 `.bss` 段填零期间触发**长链递归 ctor**——F4 的启动栈仅 1KB 共享给所有 ctor，12 层 `MemberList` 模板构造很容易爆栈

**结果**（最可能路径）：RTOS 启动前栈溢出 → `__libc_init_array` 中途 abort → 主循环根本没起来 → 外设不工作。

**为什么 4 条 OK、12 条挂？**：临界值正好是 `MemberList<T1..T12>` 类型名长度超过编译器/链接器某处的隐式 buffer / hash bucket 上限。CtrlStepMotor 单轴注册了 ~22 条 fibre，但每轴是**独立类型**（`MemberList<T1_J1, ..., T22_J1>`），类型名分散在 7 个独立模板实例化里；DummyHand 12 条则是**单类型嵌套到 12 层**，递归深度集中在同一个模板实例化里——这是为什么 DummyHand 4 vs 12 是悬崖，而 CtrlStepMotor 22 条不挂。

### 5.4 已排除方向

- ❌ **不是** RAM 容量问题（Step 2 时 47040 B / 128 KB = 35.89%，远未到 OOM）
- ❌ **不是** 9 个新方法实现的代码量问题（T1 后实现保留，仅 fibre 不注册）
- ❌ **不是** `SendInt32Frame` 的栈深度问题（T1 后该函数仍存在且调用，正常）
- ❌ **不是** `SetMaxCurrent` 末尾 `canBuf[4]=1` 的副作用（T1 后该改动仍存在，正常）
- ❌ **不是** commTask 栈不够（commTask 45 KB 远未到上限；问题在**启动期** ctor 链，不在 RTOS 任务栈）

### 5.5 决策

**§3.2.4 的 12 条 fibre 注册方案 = 不可行，废弃。**

**当前可用方案（T1 验证）**：

| 方法 | 暴露路径 |
|---|---|
| `SetAngle` / `SetEnable` / `SetMaxCurrent` / `Reboot` | ✅ 通过 fibre 调用（4 条） |
| `SetVelocityLimit` / `SetAcceleration` / `SetDceKp/Kv/Ki/Kd` / `SetEnableOnBoot` / `EraseConfigs` | ⚠️ **不通过 fibre**；C++ 端成员方法实现完整保留，由用户在 ASCII 协议层（`ascii_protocol.cpp`）**直接调用**，绕过 fibre 模板递归 |

### 5.6 连锁影响（对 §3.2.5、§4.1.1、Step 3、Step 4）

| 项 | 原方案 | 调整后 |
|---|---|---|
| §3.2.5 ASCII `!HAND_VEL/ACC/I/KP/KV/KI/KD/ONBOOT/ERASE`（9 条） | 通过 fibre 转发到 `DummyHand` 方法 | **保留**，但由 `ascii_protocol.cpp` 直接调 `DummyHand::SetXxx()` 成员方法（不经过 fibre） |
| §4.1.1 电机端 `cmd=0x07` ACK 条件化 | 必要（夹爪稳态零 ACK 帧） | **保留**，但**前提是**最终方案仍走 `cmd=0x07` 控制夹爪位置——若改用其他 CAN cmd 控制，ACK 控制策略要重新评估 |
| Step 3 跨模块烧录 | 主控+夹爪固件同步烧录 | **保留**，但范围可缩减（若新方案不依赖主控 `ctrl_step.cpp` 改动，仅需烧夹爪固件） |
| Step 4 ASCII 协议扩展 | 13 条 `!HAND_*` + `#REBOOT 8` + `#SET_DCE_*` 扩到 node=8 | **保留**，但 9 条配置类命令的实现路径由「fibre 转发」改为「`ascii_protocol.cpp` 直接调 C++ 方法」 |

### 5.7 后续实现建议

用户 2026-10-03 决策（详见 `docs/SESSION_STATUS.md`「2026-10-03 架构决策变更」段 + `docs/handcode夹爪实现对比与迁移方案.md §0`）：

1. **架构改为继承式**：把 `DummyHand` 替换为 `StepHand : public CtrlStepMotor`（打法 B：4 条 fibre）。`CtrlStepMotor` 22 个 C++ 方法免重写，fibre 仍只注册 4 条（避免单类嵌套过深 boot crash）。
2. **必须 override 3 个方法**：
   - `SetAngle(float)` 跳过 reduction 归一化（reduction=16 但开度 0~100% 直接对应电机圈数 0~100；与文档 §3.2.3 一致）
   - `SetEnable(bool)` 改发 `cmd=0x07` 切位置模式（基类 `cmd=0x01` 进速度模式与夹爪不符）
   - `SetAngleWithVelocityLimit(float, float)` 同 `SetAngle` 跳过归一化
3. **9 个配置方法保留为基类**：基类 `CtrlStepMotor` 已实现 `SetVelocityLimit/SetAcceleration/SetDceKp/Kv/Ki/Kd/SetEnableOnBoot/EraseConfigs/ApplyPositionAsHome`，ASCII 协议层直调基类即可，无需新增 `DummyHand` C++ 方法。
4. **约束**：
   - 不再增加 `MakeProtocolDefinitions` 的条目数（保持 ≤ 4 条以维持 boot 稳定）
   - 9 个基类方法的 C++ 实现**已存在**（无需新增）；`ascii_protocol.cpp` 直接调 `CtrlStepMotor` 方法
   - `StepHand` 类声明放 `dummy_robot.h`（C1 决策），不新增文件

### 5.8 证据文件路径

- `docs/SESSION_STATUS.md` 「2026-10-03 Step 2 → T1 回滚部分 fibre 协议（系统恢复）」段 —— 完整诊断
- `firmware_new/dummy-ref-core-fw/build/T1_build.log` —— T1 编译日志（11/11 成功）
- `firmware_new/dummy-ref-core-fw/build/Core-STM32F4-fw.map` —— T1 .map（用户烧录后报告 boot 正常）
- `firmware_new/dummy-ref-core-fw/Robot/instances/dummy_robot.h:67-91` —— 当前（已回滚）4 条 fibre 注册位置
- `firmware_new/dummy-ref-core-fw/3rdParty/fibre/cpp/include/fibre/protocol.hpp:738-810` —— `MemberList` 模板递归定义
- `firmware_new/dummy-ref-core-fw/3rdParty/fibre/cpp/include/fibre/protocol.hpp:1335-1366` —— `fibre_publish<T>` 静态注册入口
