Liu3Beng-A/Dummy/docs/同步算法.md

物理同步算法的加速度假设与电机端 EEPROM 实际值不匹配
这是最关键的一个隐藏 bug。

事实：

主控 dummy_robot.h:20 的 JOINT_ACC_FALLBACK = {30, 150, 100, 200, 200, 200, 200} r/s²（J1~J6 高于电机端实际值）
主控 dummy_robot.cpp:463 在 Init 路径里走 SetJointAcceleration(DEFAULT_JOINT_ACCELERATION_LOW)（LOW=15），下发到电机 0x14 的实际值：
J1: 15/100 × 150 = 22.5 r/s²
J2: 15/100 × 100 = 15 r/s²
J3~J6: 15/100 × 200 = 30 r/s²
电机端 motor.h:20 默认 ratedVelocityAcc = 1000 * MOTOR_ONE_CIRCLE_SUBDIVIDE_STEPS ≈ 19.5 r/s²，但 main.cpp:67 又覆盖为 30 * MOTOR_ONE_CIRCLE_SUBDIVIDE_STEPS = 30 r/s²
实际偏差：

轴	主控预期 (JOINT_ACC_FALLBACK)	电机实际 (EEPROM)	偏差倍数
J1
150
22.5
6.7×
J2
100
15
6.7×
J3~J6
200
30
6.7×
地轨 (id=7)
30
30
1× ✓
后果：

ComputeSyncSpeeds 用 150-200 r/s² 预测同步时间，但电机端用 15-30 r/s² 实际加速
例如 J3 90°：主预测 0.825s（方案 §3.3.1 §F 表里写的），实际需要 ~1.29s
7 轴"同步抵达"算法失真：每个轴实际时间由电机端实际加速度决定，与主预测的 timeBudget 不一致
用户实测无明显问题的原因：等距运动时，所有轴按相同比例变慢，相对同步性近似保持；但不等距运动（如 >0,0,90,0,0,0,100,100）的不同轴实际到达时间会显著错开
修复方向（建议在动手前讨论）：

把 JOINT_ACC_FALLBACK 改成 LOW 模式实际值 {30, 22.5f, 15, 30, 30, 30, 30}
或在 Init() 后强制发一次 SetJointAcceleration(HIGH=100) 让电机端 EEPROM 与 JOINT_ACC_FALLBACK 对齐
或把 jointAccRuntime[] 真正接 §9 #7 异步回填（方案里规划但本期未实现）
