Liu3Beng-A/Dummy/docs/发送就卡死—心跳定位排查方案—2026-09-16.md

# 发送就卡死 — 4 边界心跳定位方案（2026-09-16）

> **文档目的**：在 9-14 实测复盘和 9-16 收尾规划识别的 F1/F2/F3/F4/F4扩展 5 项修复**全部落地**后，问题仍然存在。
> 这意味着**之前识别的真凶方向并未打到点子上**，或者修复只解决了表象。需要换思路：**先用最小侵入的观测手段，定位卡死发生在哪个边界，再对症下药**。
>
> **本文档核心动作**：在 4 个边界各埋一个 `volatile` 心跳计数器，OLED 实时显示，肉眼直接判读卡死层级。

---

## 一、为什么需要这步

### 1.1 已尝试方案回顾

| 方案 | 改动 | 状态 | 是否真解决了问题？ |
|---|---|---|---|
| F1 `SetEnable` 不再同步 `state=FINISH` | `ctrl_step.cpp:24-27` | ✅ 已落地 | ❌（用户报告问题仍存在）|
| F2 `SetStallMode` 移除 `ClearFifo()` + ParseCommand 入口判 `isStalled` | `dummy_robot.cpp:540, 784-790` | ✅ 已落地 | ❌ |
| F3 删 `main.cpp:221` `osDelay(20)` | `main.cpp:221` | ✅ 已落地 | ❌ |
| F4 ISR `printf` 0x5A/0x5C/0x28~0x2B 改事件标志 + 主线程 poll | `can_protocol.cpp` + `main.cpp:254` | ✅ 已落地 | ❌ |
| R10 `CanSendMessage` 信号量三件套 | `interface_can.cpp:230-264` | ✅ 已落地 | ❌ |
| R1-R8 ALL 代理整合（`motorJ[0]` 代理 8 个电机）| 多文件 | ✅ 已落地 | ❌ |

**结论**：CAN TX 信号量泄漏（9-14 文档最大嫌疑）已修，问题依旧 → **真正的卡点不在 CAN TX 层**。

### 1.2 搜索范围需要扩展到哪里

之前所有修复都集中在 **CAN TX / SetEnable 路径**，但**未覆盖**以下可能的卡死点：

| 未覆盖点 | 怀疑程度 | 证据现状 |
|---|---|---|
| **UART4/USB 接收层**（DMA/中断未触发 / 队列满）| 中 | 9-14 文档未分析此层 |
| **ASCII 行缓冲累积**（缺 `\r`/`\n` 导致永远等行结束）| 低-中 | 串口助手发的是带 `\n` 的命令 |
| **`Respond()` 写 UART4/USB**（TX DMA 阻塞 / 队列满）| **高** | 多处 `Respond()` 调用，未分析其阻塞路径 |
| **命令队列 FIFO 满**（`commandHandler.Push` 返回 0）| 中 | ASCII 处理线程 `Pop(osWaitForever)` 阻塞 |
| **5kHz 实时环单次执行超时**（>200μs）抢占 ASCII | 中 | 未实测实时环执行耗时 |
| **FreeRTOS heap 耗尽**（隐式泄漏）| 中 | 未加水位监控 |
| **USB CDC TX 死锁**（与 UART4 互锁）| 低-中 | `interface_usb.cpp` 有 `tx_overrun_cnt++` 兜底，但无运行时暴露 |
| **OledTask / RGBTask 内部阻塞**（不是循环节流问题，而是内部调用的 API 阻塞）| 中 | 未分析 RGB 实现 / 软件 I2C |

### 1.3 核心思路

不修任何业务逻辑，**只在 4 个边界埋 4 个心跳计数器**，OLED 实时显示，肉眼判读卡死发生在哪一层。

- 投入最小：~50 行代码改动，1 次编译，1 次烧录
- 信息量最大：4 个边界各自卡死时表现不同，一眼可辨
- 风险最低：所有计数器都是 `volatile uint32_t` 原子读写，无副作用，可随时回滚

---

## 二、4 个边界定义与计数器位置

### 2.1 ASCII 命令全链路数据流

```
[PC 串口助手]
    │  USB CDC / UART4 物理层
    ▼
┌─────────────────────────────────────────────────────────┐
│ 边界 1 (byte_in)  ── 字节被硬件 DMA / USB 中断接收        │
│   • UART4: HAL_UART_Receive_DMA → dma_rx_buffer[0]      │
│   • USB:   CDC_Receive_FS → usb_rx_process_packet        │
│   • 字节真正"进入"系统的位置                            │
│   ─────────────────────────────────────────────────────  │
│   ASCII_protocol_parse_stream 的 while(len--) 循环       │
│   ── 每个字节 +1                                        │
└─────────────────────────────────────────────────────────┘
    │
    ▼
┌─────────────────────────────────────────────────────────┐
│ 边界 2 (line_ready)  ── 行缓冲累积到 `\r` 或 `\n`        │
│   • ASCII_protocol_parse_stream 检测到行结束             │
│   • 即将调用 ASCII_protocol_process_line                │
│   ─────────────────────────────────────────────────────  │
│   ASCII_protocol_parse_stream 的 is_end_of_line 分支     │
│   ── 每个完整行 +1                                       │
└─────────────────────────────────────────────────────────┘
    │
    ▼
┌─────────────────────────────────────────────────────────┐
│ 边界 3 (cmd_in)  ── 命令分派到 OnUsbAsciiCmd / OnUart4   │
│   • ASCII_protocol_process_line 进入 handler             │
│   • 即将开始解析 `!` / `#` / `>` / `&` 等               │
│   ─────────────────────────────────────────────────────  │
│   OnUsbAsciiCmd / OnUart4AsciiCmd 函数入口              │
│   ── 每个命令 +1                                        │
└─────────────────────────────────────────────────────────┘
    │
    ▼
┌─────────────────────────────────────────────────────────┐
│ 边界 4 (cmd_out)  ── 命令处理完成，所有 Respond 已写     │
│   • handler 函数 return 前                              │
│   • 整个响应（包括多次 Respond）已写完                  │
│   ─────────────────────────────────────────────────────  │
│   OnUsbAsciiCmd / OnUart4AsciiCmd 函数出口              │
│   ── 每个命令 +1                                        │
└─────────────────────────────────────────────────────────┘
    │
    ▼
[PC 串口助手收到响应]
```

### 2.2 3 个"心跳探针"（验证调度层是否活着）

仅看 4 个 ASCII 边界不够 —— 如果系统**所有任务都被卡死**，4 个计数器也会全停。

增加 3 个任务级探针（每个任务的 `for(;;)` 循环入口 `++`）：

| 探针 | 任务 | 期望频率 | 含义 |
|---|---|---|---|
| `g_realtime_tick` | `ControlLoopFixUpdateTask` | 5000Hz | 5kHz 实时环是否被抢占 |
| `g_oled_tick` | `OledTask` | 60-80Hz | OLED 任务是否被饿死 |
| `g_rgb_tick` | `RGBTask` | 33Hz | RGB 任务是否被饿死 |

### 2.3 7 个计数器总览

| 计数器 | 位置 | 单位 | 增长速率（典型）|
|---|---|---|---|
| `g_byte_in` | `ascii_processor.cpp:ASCII_protocol_parse_stream` while 循环 | 字节 | 取决于 PC 端发送速率 |
| `g_line_ready` | `ascii_processor.cpp:ASCII_protocol_parse_stream` 行结束分支 | 行 | 等于命令数 |
| `g_cmd_in` | `ascii_protocol.cpp:OnUsbAsciiCmd` / `OnUart4AsciiCmd` 入口 | 命令 | 等于命令数 |
| `g_cmd_out` | `ascii_protocol.cpp:OnUsbAsciiCmd` / `OnUart4AsciiCmd` 出口 | 命令 | 等于命令数 |
| `g_realtime_tick` | `main.cpp:ThreadControlLoopFixUpdate` 循环入口 | tick | 5000/s |
| `g_oled_tick` | `main.cpp:ThreadOledUpdate` 循环入口 | tick | 60-80/s |
| `g_rgb_tick` | `main.cpp:ThreadRGBUpdate` 循环入口 | tick | 33/s |

---

## 三、判读规则（核心）

### 3.1 正常态（不卡死时）

| 计数器 | 增长速率 | 备注 |
|---|---|---|
| `g_byte_in` | 跟着 PC 发送速率涨 | 静默时停涨，正常 |
| `g_line_ready` | 等于 PC 发的命令数 | 静默时停涨 |
| `g_cmd_in` | = `g_line_ready` | 静默时停涨 |
| `g_cmd_out` | = `g_cmd_in` | 静默时停涨 |
| `g_realtime_tick` | **每秒 +5000**（5kHz）| 即使无命令也持续涨 |
| `g_oled_tick` | **每秒 +60-80**（帧率）| 即使无命令也持续涨 |
| `g_rgb_tick` | **每秒 +33** | 即使无命令也持续涨 |

### 3.2 卡死诊断矩阵

发 `!START` 命令后看 4 个 ASCII 计数器停在哪个位置（**3 个任务探针必须保持涨，否则是更严重的调度级卡死**）：

| 现象 | 结论 | 下一步定位 |
|---|---|---|
| `byte_in` 停 | **输入层卡死**（UART4 DMA/USB CDC RX 未触发）| 检查 `UartServerTask` 是否活着、`HAL_UART_Receive_DMA` 是否报错、`usb_rx_process_packet` 是否被调用 |
| `byte_in` 涨，`line_ready` 停 | **行缓冲累积卡死**（缺 `\r`/`\n`）| 检查 PC 端串口助手是否真的发了换行；检查 `parse_buffer_idx` 是否溢出 MAX_LINE_LENGTH |
| `line_ready` 涨，`cmd_in` 停 | **dispatch 卡死**（`ASCII_protocol_process_line` 未调 handler）| 检查 `response_channel.channelType` 识别分支是否异常 |
| `cmd_in` 涨，`cmd_out` 停 | **handler 卡死**（命令执行中卡住，最常见）| 加细颗粒：在 handler 内关键函数入口（`SetEnable` / `MoveJ` / `commandHandler.Push` / `Respond`）再埋计数器，定位是哪个分支卡死 |
| `cmd_out` 涨，**但 3 个任务探针之一停涨** | **调度层被饿死**（最严重）| 哪个任务停涨就是哪个任务被阻塞；可能是实时环执行超 200μs，或 ASCII 解析持锁时间太长 |
| 7 个全停涨 | **Watchdog 级别卡死**（中断都停了 / hardfault）| 检查堆栈溢出、hardfault handler、IWDG 是否触发 |

### 3.3 重点：cmd_in 涨 cmd_out 停 —— handler 卡死细定位

这是**最可能的卡死点**。`OnUsbAsciiCmd` / `OnUart4AsciiCmd` 内有几十个 `s.find` 分支，每个分支都调 `Respond()` 一次或多次。

如果 `!START` 走的是 `s == "!START"` → `dummy.SetEnable(true)` → `Respond("ok")` 路径，且卡死在此分支：

| 进一步诊断 | 计数器 |
|---|---|
| `dummy.SetEnable(true)` 之前 OK，之后停 | `SetEnable` 路径卡死（电机端未回包 / ALL 代理 CAN 帧未发出 / CAN 信号量异常）|
| `SetEnable` 返回后 `Respond` 之前停 | handler 函数体内某处隐式卡死 |
| `Respond("ok")` 调用后停 | **`Respond()` 写 UART4/USB 路径卡死** ← 9-14 文档未深入分析的层 |

**Respond 卡死的可能性**：
- `uart4_stream_output.process_bytes` 内 `osSemaphoreAcquire(sem_uart4_dma, PROTOCOL_SERVER_TIMEOUT_MS)` 超时（UART4 TX DMA 一直未完成）
- USB 路径 `osSemaphoreAcquire(sem_usb_tx, PROTOCOL_SERVER_TIMEOUT_MS)` 超时（USB TX 一直未完成）
- 串口助手 PC 端没在读 USB → USB CDC TX buffer 满 → 主控 TX 阻塞

---

## 四、实施清单

### 4.1 文件改动

| # | 文件 | 改动 | 行数 |
|---|---|---|---|
| 1 | `firmware/ref_core_f405/UserApp/main.cpp` | 新增 7 个 `volatile uint32_t` 全局变量声明；3 个任务循环入口各 +1；OLED 显示布局追加心跳区 | ~50 行 |
| 2 | `firmware/ref_core_f405/Bsp/communication/ascii_processor.cpp` | `ASCII_protocol_parse_stream` 内 while 循环 +1；行结束分支 +1 | ~4 行 |
| 3 | `firmware/ref_core_f405/UserApp/protocols/ascii_protocol.cpp` | `OnUsbAsciiCmd` 入口 / 出口 +1；`OnUart4AsciiCmd` 入口 / 出口 +1 | ~8 行 |

**总计**：~60 行新增，无业务逻辑改动，0 行删除。

### 4.2 改动 1：`main.cpp` 顶部新增全局变量

```cpp
/* ======================================================================
 * [DIAG-2026-09-16] 4 边界心跳计数器
 * 用于定位 "发送就卡死" 故障层级 —— 详见 docs/发送就卡死—心跳定位排查方案—2026-09-16.md
 * ====================================================================== */
volatile uint32_t g_byte_in        = 0;  // ASCII 字节接收 (每字节 +1)
volatile uint32_t g_line_ready     = 0;  // ASCII 行完成 (每行 +1)
volatile uint32_t g_cmd_in         = 0;  // 命令 handler 入口 (每个命令 +1)
volatile uint32_t g_cmd_out        = 0;  // 命令 handler 出口 (每个命令 +1)
volatile uint32_t g_realtime_tick  = 0;  // 5kHz 实时环 tick
volatile uint32_t g_oled_tick      = 0;  // OLED 任务 tick
volatile uint32_t g_rgb_tick       = 0;  // RGB 任务 tick
```

### 4.3 改动 2：`ascii_processor.cpp` 内 2 个 `++`

```cpp
// 在 ASCII_protocol_parse_stream while(len--) 循环内:
uint8_t c = *(buffer++);
g_byte_in++;  // [DIAG-2026-09-16] 每字节 +1

// 在 is_end_of_line 分支内:
if (read_active) {
    g_line_ready++;  // [DIAG-2026-09-16] 每完成一行 +1
    ASCII_protocol_process_line(parse_buffer, parse_buffer_idx, response_channel);
}
```

### 4.4 改动 3：`ascii_protocol.cpp` 内 4 个 `++`

```cpp
// OnUsbAsciiCmd 入口:
void OnUsbAsciiCmd(const char* _cmd, size_t _len, StreamSink &_responseChannel)
{
    g_cmd_in++;  // [DIAG-2026-09-16] handler 入口
    // ... 原有逻辑 ...

    // 在 OnUsbAsciiCmd 函数末尾、所有 return 之前统一打:
    // （为简化，把 +1 放在单一出口；C++ 函数内多个 return 需要重构或加宏，
    //  此处选择最简方案：仅在函数体最末尾 +1，每个 return 前置一个
    //  `g_cmd_out++; return;` 行）
    g_cmd_out++;  // [DIAG-2026-09-16] handler 出口
}

// OnUart4AsciiCmd 同上
```

> **简化策略**：C++ 函数有多个 return 点，全部加 `g_cmd_out++` 麻烦。
> 用一个**RAII 风格的哨兵对象**：函数入口构造一个对象，析构时自动 `++g_cmd_out`。
> ```cpp
// ascii_protocol.cpp 顶部新增:
struct CmdExitGuard {
    ~CmdExitGuard() { g_cmd_out++; }
};
// 然后在每个 handler 入口:
void OnUsbAsciiCmd(...) {
    CmdExitGuard _guard;
    g_cmd_in++;
    // ... 函数体不变 ...
}  // _guard 析构 → g_cmd_out++
```
> 这样**任何 return 路径**（正常 return / 异常 / 早期 return）都会经过析构，零侵入。

### 4.5 改动 4：`main.cpp` 任务循环入口 `++`

```cpp
// ThreadControlLoopFixUpdate 入口:
void ThreadControlLoopFixUpdate(void* argument) {
    for (;;) {
        g_realtime_tick++;  // [DIAG-2026-09-16] 5kHz 心跳
        // ... 原有逻辑 ...
    }
}

// ThreadOledUpdate 入口:
void ThreadOledUpdate(void* argument) {
    for (;;) {
        g_oled_tick++;  // [DIAG-2026-09-16] OLED 心跳
        // ... 原有逻辑 ...
    }
}

// ThreadRGBUpdate 入口:
void ThreadRGBUpdate(void* argument) {
    for (;;) {
        g_rgb_tick++;  // [DIAG-2026-09-16] RGB 心跳
        // ... 原有逻辑 ...
    }
}
```

### 4.6 改动 5：OLED 显示心跳区

在 `ThreadOledUpdate` 已有的 3 个信息块（顶栏 IMU/FPS / 角度矩阵 / 6D 位姿）下方，追加第 4 块：

```cpp
// 【心跳探针面板】4 边界 + 3 任务探针（诊断 2026-09-16 卡死层级）
oled.setFont(u8g2_font_5x8_tr);
oled.setCursor(0, 92);
oled.printf("B:%lu L:%lu I:%lu O:%lu",  // Byte / Line / In / Out
            g_byte_in, g_line_ready, g_cmd_in, g_cmd_out);

oled.setCursor(0, 102);
oled.printf("RT:%lu OL:%lu RGB:%lu",  // RealTime / Oled / RGB
            g_realtime_tick, g_oled_tick, g_rgb_tick);
```

**显示布局**（128x64 OLED）：
```
┌────────────────────────────────────┐  ← 第 1 行：IMU/FPS
│ IMU:0.000/0.000      | FPS:XX     │
├────────────────────────────────────┤  ← 分隔线
│ > J1|J2|J3|J4|J5|J6 (关节角度)      │
│ ┌──────────┐                       │
│ │ XYZ:...  │  (6D 位姿)            │
│ │ ABC:...  │                       │
│ └──────────┘                       │
│ [SRV] __*__*_  (cmdMode + joints)  │
│ B:1234 L:56 I:56 O:55              │  ← 第 92 行：4 边界
│ RT:456789 OL:12345 RGB:678         │  ← 第 102 行：3 探针
└────────────────────────────────────┘
```

OLED 总高 64 像素，原代码用到第 78 行（cmdMode/joints 横幅）。第 92 行已超出显示区。
**需要把字体从 5x8 改成更小的 4x6**（`u8g2_font_4x6_tr`），或**砍掉 cmdMode/joints 横幅**腾空间。

---

## 五、测试用例矩阵

### 5.1 正常态验证（先确认基线）

| # | 操作 | 期望（OLED 显示）|
|---|---|---|
| 1 | 上电静止 | RT/OL/RGB 持续涨；B/L/I/O 静止（无命令）|
| 2 | 发 `#GETJPOS` | B/L/I/O 各 +1；O 跟 I 同步涨 |
| 3 | 发 `!START` | B/L/I/O 各 +1；电机使能；cmdMode 显示 |
| 4 | 发 `!DISABLE` | B/L/I/O 各 +1；电机失能 |

### 5.2 复现卡死（关键测试）

| # | 操作 | 期望（OLED 显示 → 卡死层级）|
|---|---|---|
| 5 | 发 `!START`（已知会卡）| 看 B/L/I/O 停在哪个数 → 定位层级 |
| 6 | 发 `!START` 后立刻发 `#GETJPOS` | 如果 I 涨 O 停 → handler 内卡死；进一步细分 |
| 7 | 发 `#STALL_STATUS`（限流 500ms）| 验证命令正常返回（不卡死基线）|
| 8 | 堵转后发 `!START` | F2 修复生效验证（应该 ok）|

### 5.3 进一步细分（仅当 cmd_in 涨 cmd_out 停时启用）

如果定位到 handler 卡死，**第二轮**：在 `dummy.SetEnable(true)`、`Respond()`、`commandHandler.Push` 等关键函数入口再埋一组细颗粒计数器：

```cpp
// 第二轮可选：handler 内细分计数器
volatile uint32_t g_setenable_in = 0;
volatile uint32_t g_setenable_out = 0;
volatile uint32_t g_respond_call = 0;
volatile uint32_t g_push_call = 0;
```

---

## 六、回滚方案

如果新增代码本身引入 bug（比如 `CmdExitGuard` RAII 与现有代码冲突），回滚步骤：

```bash
cd E:\Dummy-code
git checkout firmware/ref_core_f405/UserApp/main.cpp
git checkout firmware/ref_core_f405/UserApp/protocols/ascii_protocol.cpp
git checkout firmware/ref_core_f405/Bsp/communication/ascii_processor.cpp
cd firmware/ref_core_f405/build
ninja
```

预计回滚时间：5 分钟。

---

## 七、风险评估

| 风险 | 概率 | 影响 | 缓解 |
|---|---|---|---|
| `volatile uint32_t` 在 ARM Cortex-M4 上 32 位读写非原子 → 读到撕裂值 | 极低 | 显示抖动 | 接受，调试用显示，不需要精确 |
| OLED 新增 2 行 → 帧率从 60Hz 降到 40Hz | 低 | 显示流畅度 | 砍掉 cmdMode/joints 横幅腾空间（占用 1 行）|
| RAII `CmdExitGuard` 与现有 C++ 异常处理冲突 | 极低 | 无（项目内无 C++ 异常）| 已确认 `common_inc.h` 无 `-fexceptions` |
| 计数器占用 RAM | 极低 | 7 × 4 = 28 字节 | 无影响 |

---

## 八、决策清单

| ID | 项 | 默认 | 备注 |
|----|---|---|---|
| D1 | 计数器方案：用 4 ASCII 边界 + 3 任务探针 | ✅ 推荐 | 共 7 个 `volatile uint32_t` |
| D2 | handler 出口用 RAII `CmdExitGuard` | ✅ 推荐 | 零侵入，所有 return 路径都过 |
| D3 | OLED 显示位置：底部追加 2 行 | ✅ 推荐 | 砍掉 cmdMode/joints 横幅 |
| D4 | 字体：用 `u8g2_font_4x6_tr`（更小）| ✅ 推荐 | 4 行内容需要更紧凑 |
| D5 | 第二轮细分计数器：先不做，等第一轮定位后再加 | ✅ 推荐 | 避免一次性改动过多 |

---

## 九、引用文档

| 文档 | 内容 |
|---|---|
| `主控固件回归—2026-09-14实测根因复盘.md` | 9-14 真凶分析（信号量泄漏、优先级倒挂）|
| `主控固件回归—9-14真凶收尾详细规划—2026-09-16.md` | F1-F4 + F4扩展 5 项已落地 |
| `主控固件退化修复—全面重构需求.md` | 9-04 退化清单 |
| `docs/TODO.md` | 全局 FEAT/BUG 待办 |

---

**文档结束**

> AI 助手：本文档配套代码改动见 §四。下一步：用户确认 §八 决策清单后，开始编码并 ninja 编译。
