Liu3Beng-A/Dummy/docs/主控固件回归—9-14真凶收尾详细规划—2026-09-16.md

# 主控固件回归 — 9-14 真凶收尾详细规划（2026-09-16）

> **文档目的**：把 2026-09-14 实测复盘文档识别的"未完成 4 项修复"整合成可执行清单，逐项确认后开始编码。
> **基线**：v3.2 ALL 代理整合已完成（最近 6 次 commit），文档 `主控固件重构—ALL代理整合方案—2026-09-16.md` 已落地。
> **配套文档**：
> - `主控固件回归—2026-09-14实测根因复盘.md`（实测复盘与真凶分析，权威）
> - `主控固件退化修复—全面重构需求.md`（9-04 退化清单，参考）
> - `主控固件重构—ALL代理整合方案—2026-09-16.md`（已完成 v3.2 基线）
>
> **启动时机**：用户逐项确认后开始，每项单独出 diff，用户二次确认后再写入。

---

## 一、当前状态盘点

### 1.1 已完成（最近 6 次 commit 覆盖）

| commit | 内容 | 对应 9-14 文档 |
|---|---|---|
| `21dbc16 refactor: CAN通信层统一重构` | CanSendMessage 三件套加固（mailbox 空闲预检 + 10ms 超时 + HAL_ERROR 释放）| R10 + #1（真凶 #1 信号量泄漏）|
| `0650ebc docs: ALL代理文档整合为单一方案` | 文档整合 | — |
| `f3623ca refactor: 地轨CAN_ID从9改为7 (J7)` | 地轨 ID 变更 + MoveJ/$ 格式变更 | R9 电机端 `id==0` 特判的前置 |
| `ec2fb2d refactor: 更新 PROJECT_GUIDANCE 和 dummy_robot.h` | 架构调整 | — |
| `77afa80 refactor: 主控固件重构 - ALL代理统一规划与分步执行` | ALL 代理整合（R1-R8）| #1+#2+#3+#4 部分 |
| `aa7707b docs: 更新主控回归分析文档` | 文档同步 | — |

### 1.2 已落地的具体修复（与 9-14 文档一致 ✅）

| 项 | 文件 | 状态 |
|---|---|---|
| **真凶 #1** CanSendMessage 三件套加固 | `interface_can.cpp:230-264` | ✅ 完成 |
| **真凶 #2** SetEnable 改 ALL 代理（2 帧）| `dummy_robot.cpp:621-624` | ✅ 完成 |
| **真凶 #3** UpdateJointAngles 改 ALL 代理（1 帧，每轴 100Hz）| `dummy_robot.cpp:437-439` | ✅ 完成（远超要求 25Hz）|
| A1 jointsStateFlag 写入方向 | `dummy_robot.cpp:451-462` | ✅ `FINISH→\|=` 方向正确 |
| A3 MoveJ/ServoJ 末尾复位 | `dummy_robot.cpp:430` | ✅ 保留 `jointsStateFlag=0` |
| A4 EmergencyStop 走 ALL 广播 | `ctrl_step.cpp:300-310` | ✅ `motorJ[ALL]` 发 0x09 |
| A7 isStalled 标记 | `dummy_robot.cpp:528` | ✅ `isStalled=true` 已落地 |
| can_protocol.cpp 完整版 | `can_protocol.cpp`（230+ 行）| ✅ 0x5A/0x5C/0x28~0x2B/0x2C/0x2D/0x7C 全部实现 |

### 1.3 未完成（与 9-14 文档待修清单对应 ⚠️）

| # | 文档标号 | 项 | 文件:行 | 优先级 |
|---|---|---|---|---|
| **F1** | #5 | `CtrlStepMotor::SetEnable(true)` 不再同步 `state=FINISH`（与 A1 方向冲突）| `ctrl_step.cpp:25` | **P0** |
| **F2** | #6 | `SetStallMode()` 移除 `ClearFifo()`（粗暴清空）| `dummy_robot.cpp:540` | **P1** |
| **F2 配套** | #6 | ParseCommand 入口判 `isStalled` 精确丢弃（运动指令丢，控制指令放行）| 需新增 | **P1** |
| **F3** | #3 | 删 `main.cpp:221` `osDelay(20)` | `main.cpp:221` | **P1** |
| **F4** | #4 | ISR `printf` 0x5A/0x5C 改事件标志 + 主线程 poll | `can_protocol.cpp` 多处 | **P1** |

### 1.4 全部完成（2026-09-16 验证 ✅）

| # | 项 | 实际修复点 | commit 记录 | 验证 |
|---|---|---|---|---|
| **F1** | `SetEnable(true)` 不再同步 `state=FINISH` | `ctrl_step.cpp:24-27`（`if (!_enable) state = STOP`） | 当前分支 `fix-bug/主控回归分析-2026-09-04` | `ninja` 通过 |
| **F1 配套** | enable 后预发 UpdateAngle | `dummy_robot.cpp:625-628` | 同上 | 同上 |
| **F2** | `SetStallMode()` 移除 `ClearFifo()` | `dummy_robot.cpp:540` 删 1 行 | 同上 | 同上 |
| **F2 配套** | ParseCommand 入口判 `isStalled` | `dummy_robot.cpp:784-790`（精确丢 `>/&/@`）| 同上 | 同上 |
| **F3** | 删 `osDelay(20)` | `main.cpp:221` 删除 | 同上 | 同上 |
| **F4** | 0x5A/0x5C ISR printf 改事件标志 | `can_protocol.cpp` 4 处 + `main.cpp` 主线程 poll | 同上 | 同上 |
| **F4 扩展** | **0x28~0x2B PID 合并 printf 改事件标志** | `can_protocol.cpp` 12 处（三分支 × 4 cmd）+ `PollPidPrint()` + `main.cpp` 调用 | 同上（2026-09-16 选项1）| 同上 |

**F4 扩展说明**：本次对话（2026-09-16 选项1）发现 `can_protocol.cpp` 内 0x28~0x2B PID 合并回包虽然用 4 包合并 1 次 printf 做了保护，但仍属"ISR 内 printf"违反 F4 原则。改为与 F4 一致的 `_pid_print_pending[9]` 单字节标志 + `PollPidPrint()` 主线程 poll（详见 §五 F4 扩展）。

---

## 二、F1 P0 — `CtrlStepMotor::SetEnable(true)` 不再同步 `state=FINISH`

### 2.1 问题（大白话）

`!START` 后电机还没回包，主控侧已经把所有电机 `state` 强行设为 `FINISH`。配合 A1 修复（FINISH→|= 置位），`jointsStateFlag` 立刻全 1，`IsMoving()` 立刻返回 false → **误判"已到位"**。

### 2.2 当前代码（`ctrl_step.cpp:24-26`）

```cpp
void CtrlStepMotor::SetEnable(bool _enable)
{
    state = _enable ? FINISH : STOP;  // ⚠️ enable 时不该同步 FINISH
    // ...
}
```

### 2.3 Bug 路径

1. `!START` → `SetEnable(true)` 串行调用 2 次（`motorJ[ALL]` + `hand`）
2. 8 个电机节点（ALL 代理触发）+ 1 个夹爪，每个 `state` 立刻被同步为 `FINISH`
3. 第一次 `UpdateJointAnglesCallback`（电机还没回包）：
   ```cpp
   if (motorJ[i]->state == CtrlStepMotor::FINISH)
       jointsStateFlag |= (1 << i);  // 立刻全置位
   ```
4. `IsMoving()` 返回 false
5. **后果**：`!START` 后立刻认为"已到位"，但实际电机还在初始定位中，下一次运动指令可能直接覆盖当前正在做的归零动作

### 2.4 解决方案

| 方案 | 原理 | 优点 | 缺点 |
|---|---|---|---|
| 方案 α | enable 时不再同步 `state`（保持原值）| 简单，1 行修改 | 上电首次 `state` 是默认值（未定义行为）|
| 方案 β | enable 时 `state = STOP`（保守起见）| 行为明确 | enable 后第一帧 `UpdateAngleCallback` 必须来纠正，否则 `IsMoving` 一直 true |
| 方案 γ | 沿用 disable 同步 `STOP`，enable 不动；首次 0x23 回包自动纠正 | 与电机端实际语义一致 | 依赖 0x23 回包可靠 |

**推荐方案 γ**（与 9-14 §11.1 #5 一致）：disable 时同步 `STOP`，enable 时不动，由电机端首次 0x23 回包纠正。

```cpp
void CtrlStepMotor::SetEnable(bool _enable)
{
    if (!_enable) state = STOP;   // ✅ disable 同步 STOP
    // ❌ enable 不再同步 state（删除原 state = FINISH 行）
    // 等待电机端首次 0x23 回包自动纠正

    uint8_t mode = 0x01;
    // ... (其余不变)
}
```

### 2.5 风险与缓解

| 风险 | 缓解 |
|---|---|
| enable 后第一帧 `UpdateAngleCallback` 之前 `state` 是上电默认值（可能是 STOP/RUNNING/FINISH 任意）| 启动豁免：主控 `SetEnable(true)` 后**先发**一帧 `UpdateAngle()`（即 `motorJ[ALL]->UpdateAngle()`），等回包到再返回 `ok` |
| 与 A1 修复方向配套 | A1 已要求 `FINISH→\|=`，新逻辑完全兼容 |

**建议**：F1 修改 + 在 `SetEnable(true)` 末尾**先调一次** `motorJ[ALL]->UpdateAngle()` 触发 0x23 回包（确保 jointsStateFlag 不被错填）。

### 2.6 改动范围

- `firmware/ref_core_f405/Robot/actuators/ctrl_step/ctrl_step.cpp:25`（1 行删除）
- `firmware/ref_core_f405/Robot/instances/dummy_robot.cpp:621-624`（`SetEnable(true)` 末尾补一帧 `UpdateAngle`）

---

## 三、F2 P1 — `SetStallMode()` 移除 `ClearFifo()` + ParseCommand 入口判 `isStalled`

### 3.1 问题（大白话）

堵转期间发了 8 个运动指令，`SetStallMode()` 直接 `ClearFifo()` 把所有指令（包括控制指令 `!START`/`!DISABLE`/`!STOP`）全部清空。用户按了"重启"按钮，串口助手显示"发送失败"——因为 `!START` 被堵转逻辑吃掉了。

### 3.2 当前代码（`dummy_robot.cpp:521-547`）

```cpp
void DummyRobot::SetStallMode(int motorIndex)
{
    SetRGBMode(RGB::RED_HEARTBEAT);
    isStalled = true;
    targetJoints = currentJoints;
    for (int j = 1; j <= 6; j++) {
        motorJ[j]->targetAngle = currentJoints.a[j - 1] - initPose.a[j - 1];
    }
    targetRailPos = currentRailPos;
    commandHandler.ClearFifo();  // ⚠️ 粗暴清空（应改为 ParseCommand 入口判 isStalled）
    (void)motorIndex;
}
```

### 3.3 解决方案（与 9-14 §11.2 #6 一致）

#### 步骤 1：删除 `ClearFifo()` 调用

```cpp
void DummyRobot::SetStallMode(int motorIndex)
{
    SetRGBMode(RGB::RED_HEARTBEAT);
    isStalled = true;
    targetJoints = currentJoints;
    for (int j = 1; j <= 6; j++) {
        motorJ[j]->targetAngle = currentJoints.a[j - 1] - initPose.a[j - 1];
    }
    targetRailPos = currentRailPos;
    // ❌ 删除：commandHandler.ClearFifo();
    (void)motorIndex;
}
```

#### 步骤 2：ParseCommand 入口判 `isStalled` 精确丢弃

```cpp
void DummyRobot::CommandHandler::ParseCommand(const char* _cmd)
{
    // [F2 修复] 堵转期间精确丢弃：运动指令丢，控制指令放行
    if (context->isStalled) {
        // 运动指令（>, &, @）→ 丢弃，返回 ok
        if (_cmd[0] == '>' || _cmd[0] == '&' || _cmd[0] == '@') {
            Respond("ok");
            return;
        }
        // 控制指令（!START / !DISABLE / !STOP）和查询指令（#GETJPOS 等）→ 放行
    }

    // ... (原有解析逻辑)
}
```

### 3.4 指令分级总表

| 指令类型 | 示例 | 堵转期间行为 |
|---|---|---|
| **运动指令**（丢弃）| `>...`、`&...`、`@...` | 返回 `ok`，不入队 |
| **控制指令**（放行）| `!START`、`!DISABLE`、`!STOP` | 正常执行（解除堵转 / 急停）|
| **其他指令**（放行）| `!HAND_*`、`!RGB_*`、`#GETJPOS` 等 | 正常执行 |

### 3.5 改动范围

- `firmware/ref_core_f405/Robot/instances/dummy_robot.cpp:540`（删除 1 行 `ClearFifo()` 调用）
- `firmware/ref_core_f405/Robot/instances/dummy_robot.cpp` `CommandHandler::ParseCommand()` 入口（新增 ~10 行判 `isStalled` 逻辑）

---

## 四、F3 P1 — 删 `main.cpp:221` `osDelay(20)`

### 4.1 问题（大白话）

OLED 帧率被 `osDelay(20)` 硬节流到 50Hz（不是 20Hz）。删掉后靠软件 I2C 自然限速，能恢复到 ~50Hz+。

### 4.2 当前代码（`main.cpp:219-221`）

```cpp
oled.sendBuffer();

// 设置硬休眠 20ms 以削峰屏刷新占时，维持操作系统生态稳健
osDelay(20);  // ⚠️ 应删除
```

### 4.3 解决方案

直接删除 `osDelay(20);` 这一行。

**实测预期**（与 9-14 §10.5 一致）：
- 删除前：50Hz（受 `osDelay(20)` 限制）
- 删除后：~50Hz+（软件 I2C 自然限速，实测可能 60-80Hz）
- 不需要额外节流——软件 I2C 的位时间（`Delay_us(5)`）+ GPIO 操作已自然限制帧率

### 4.4 改动范围

- `firmware/ref_core_f405/UserApp/main.cpp:221`（删除 1 行）

---

## 五、F4 P1 — ISR `printf` 0x5A/0x5C 改事件标志 + 主线程 poll

### 5.1 问题（大白话）

CAN RX ISR（优先级 5）里直接调 `printf`，会进入 UART 临界区锁。如果 UART DMA 正在发送，`printf` 会 spin-wait 等待 DMA 完成。**轻微影响 ISR 执行时间**（不是死锁，但每帧堵转广播都触发）。

### 5.2 当前代码（`can_protocol.cpp` 多处）

```cpp
case 0x5A: {
    if (stallCmd == 1) {
        dummy.SetStallMode((int)stallNodeId);
        printf("[STALL] node=%d TRIGGER\r\n", stallNodeId);  // ⚠️ ISR printf
    } else if (stallCmd == 2) {
        dummy.SetStallMode((int)stallNodeId);
        printf("[STALL] node=%d done\r\n", stallNodeId);
    }
    // ...
}
case 0x5C: {
    if (qtype == 1) {
        printf("[STALL_STATUS] node=%d en=%d\r\n", id, qval);  // ⚠️ ISR printf
    }
    // ...
}
```

### 5.3 解决方案

#### 步骤 1：定义事件标志（`can_protocol.cpp` 顶部）

```cpp
// ── 堵转事件标志（修复 F4）──
// 触发时设 1，主线程 poll 后清 0 + printf
static volatile uint8_t _stall_event_flag = 0;
static volatile uint8_t _stall_event_node = 0;
static volatile uint8_t _stall_event_cmd = 0;  // 1=TRIGGER / 2=DONE / 3=TIMEOUT
static volatile uint8_t _stall_status_flag = 0;
static volatile uint8_t _stall_status_node = 0;
static volatile uint8_t _stall_status_type = 0;  // 1=en / 2=lock
static volatile uint8_t _stall_status_val = 0;
```

#### 步骤 2：ISR 内只设标志，不 printf

```cpp
case 0x5A: {
    uint8_t stallNodeId = data[0];
    uint8_t stallCmd = data[1];
    if (stallCmd >= 1 && stallCmd <= 3) {
        dummy.SetStallMode((int)stallNodeId);
        _stall_event_flag = 1;
        _stall_event_node = stallNodeId;
        _stall_event_cmd = stallCmd;
    }
    // state==4 (HEARTBEAT): RETREATING 期间心跳，忽略
    break;
}
case 0x5C: {
    _stall_status_flag = 1;
    _stall_status_node = id;
    _stall_status_type = data[0];
    _stall_status_val = data[1];
    break;
}
```

#### 步骤 3：主线程 poll（OledTask 或 ControlLoopUpdateTask）

在 `ThreadOledUpdate` 末尾或 `ThreadControlLoopUpdate` 入口加：

```cpp
// [F4 修复] 堵转事件 poll（避免 ISR 内 printf）
if (_stall_event_flag) {
    uint8_t node = _stall_event_node;
    uint8_t cmd = _stall_event_cmd;
    _stall_event_flag = 0;
    const char* cmd_str = (cmd == 1) ? "TRIGGER" : (cmd == 2) ? "done" : "timeout";
    printf("[STALL] node=%d %s\r\n", node, cmd_str);
}
if (_stall_status_flag) {
    uint8_t node = _stall_status_node;
    uint8_t type = _stall_status_type;
    uint8_t val = _stall_status_val;
    _stall_status_flag = 0;
    const char* type_str = (type == 1) ? "en" : "lock";
    printf("[STALL_STATUS] node=%d %s=%d\r\n", node, type_str, val);
}
```

### 5.4 风险与缓解

| 风险 | 缓解 |
|---|---|
| 主线程 poll 期间 ISR 又设标志 → 标志丢失 | `volatile` + 单字节读写在 ARM Cortex-M4 上原子，主线程读完清 0 后下一帧 ISR 重新设 |
| 多电机同时堵转 → 标志被覆盖 | 现阶段接受（一次只显示最新事件），后续可改环形缓冲 |
| 0x7C 旧堵转上报不需要 printf | 维持现状（无 printf）|

### 5.5 改动范围

- `firmware/ref_core_f405/UserApp/protocols/can_protocol.cpp` 顶部（新增 ~10 行全局变量）
- `can_protocol.cpp` 6 处 `printf` 替换为标志设置（~20 行）
- `firmware/ref_core_f405/UserApp/main.cpp` `ThreadOledUpdate` 或 `ThreadControlLoopUpdate`（新增 ~15 行 poll）

---

## 五.5、F4 扩展 P1 — 0x28~0x2B PID 合并 printf 改事件标志（2026-09-16 选项1）

### 五.5.1 问题（大白话）

`can_protocol.cpp` 内 0x28~0x2B（PID 参数查询响应）原本用 4 包合并 + 1 次 printf 保护，但本质仍是"ISR 内 printf"，与 F4 修复原则冲突。`#GET_PID` 调试命令不频繁但仍有隐患。

### 五.5.2 改动（与 F4 完全一致的设计）

**`can_protocol.cpp` 顶部新增**（line 82-83）：
```cpp
static volatile uint8_t _pid_print_pending[9] = {0};      // 合并完成待打印标志
static volatile uint8_t _pid_pending_node[9] = {0};      // 触发合并的节点 ID
```

**`can_protocol.cpp` 新增 PollPidPrint 函数**（line 96-109）：
```cpp
extern "C" void PollPidPrint() {
    for (int idx = 1; idx <= 8; idx++) {
        if (_pid_print_pending[idx]) {
            _pid_print_pending[idx] = 0;  // 先清，再读（原子单字节写）
            printf("ok PID %d kp=%ld kv=%ld ki=%ld kd=%ld\r\n",
                   _pid_node_to_disp(_pid_pending_node[idx]),
                   (long)_pid_tmp_kp[idx], (long)_pid_tmp_kv[idx],
                   (long)_pid_tmp_ki[idx], (long)_pid_tmp_kd[idx]);
        }
    }
}
```

**`can_protocol.cpp` 12 处 ISR 内替换**（三分支 × 4 cmd）：
- J7/地轨（id==7）0x28/0x29/0x2A/0x2B
- J1~J6（id 1~6）0x28/0x29/0x2A/0x2B
- 夹爪（id==8）0x28/0x29/0x2A/0x2B

每处替换为：
```cpp
_pid_print_pending[idx] = 1;
_pid_pending_node[idx] = id;
_pid_rcv_cnt[idx] = 0;
```

**`main.cpp` 顶部新增声明**（line 15-16）：
```cpp
/* ======================================================================
 * [PID 修复] PID 合并打印 poll（由 OledTask 调用，定义见 can_protocol.cpp）
 * ====================================================================== */
extern "C" void PollPidPrint();
```

**`main.cpp` OledTask 内 F4 poll 末尾追加**（line 254）：
```cpp
PollPidPrint();
```

### 五.5.3 风险与缓解

| 风险 | 缓解 |
|---|---|
| 主线程读 tmp 期间 ISR 又写一轮 | 主线程**先清 pending 再读 tmp**（原子单字节写）；最坏丢 1 轮合并，`#GET_PID` 调试命令可接受 |
| 9 slot 遍历开销 | 9 次单字节读 + 9 次比较 ≈ 30 条指令，远小于一次 printf 的 µs 级开销 |
| 注释增加 [PID 修复] 标记 | 与 F4 的 [F4 修复] 风格一致，便于 git blame 回溯 |

### 五.5.4 改动范围

- `firmware/ref_core_f405/UserApp/protocols/can_protocol.cpp:82-83`（新增 2 行 volatile 数组）
- `firmware/ref_core_f405/UserApp/protocols/can_protocol.cpp:96-109`（新增 14 行 PollPidPrint 函数）
- `firmware/ref_core_f405/UserApp/protocols/can_protocol.cpp` 12 处 ISR 内替换
- `firmware/ref_core_f405/UserApp/main.cpp:15-16`（新增 4 行声明+注释）
- `firmware/ref_core_f405/UserApp/main.cpp:254`（新增 1 行 PollPidPrint() 调用）

**合计：~30 行 diff，编译通过（FLASH 36.73% / RAM 40.67%）**。

---

## 六、执行批次

| 批次 | 内容 | 优先级 | 预估改动量 | 状态（2026-09-16）|
|---|---|---|---|---|
| 第一批 | **F1** SetEnable 不再同步 state + enable 后预发 UpdateAngle | **P0** | ~10 行 | ✅ 已完成 |
| 第二批 | **F2** SetStallMode 移除 ClearFifo + ParseCommand 入口判 isStalled | P1 | ~15 行 | ✅ 已完成 |
| 第三批 | **F3** 删 osDelay(20) | P1 | 1 行 | ✅ 已完成 |
| 第四批 | **F4** ISR printf 改事件标志 + 主线程 poll | P1 | ~45 行 | ✅ 已完成 |
| 第五批 | **F4 扩展** 0x28~0x2B PID 合并 printf 改事件标志 | P1 | ~30 行 | ✅ 已完成（选项1）|
| **合计** | — | — | **~100 行** | 全部 ✅ |

---

## 七、决策清单

| ID | 项 | 默认 | 你的选择 | 备注 |
|----|---|---|---|---|
| F1 | `SetEnable(true)` 不再同步 state=FINISH | ✅ 方案 γ（推荐）| ✅ 已落地 | 配套 enable 后预发 UpdateAngle |
| F2 | 移除 `ClearFifo()` + ParseCommand 入口判 isStalled | ✅ 必修 | ✅ 已落地 | 与 9-04 A7 + 9-14 #6 一致 |
| F3 | 删 `osDelay(20)` | ✅ 必修 | ✅ 已落地 | 与 9-14 #3 一致 |
| F4 | ISR printf 改事件标志 | ✅ 方案 α（单字节原子标志）| ✅ 已落地 | 与 9-14 #4 一致（0x5A/0x5C）|
| **F4 扩展** | **0x28~0x2B PID 合并 printf 改事件标志** | — | ✅ 已落地（2026-09-16 选项1）| F4 原则延伸；详见 §五.5 |

---

## 八、不动清单（明确范围）

| 文件/项 | 原因 |
|---|---|
| `motor_fw_f103_35/42/57/gripper/` 电机固件 | 已稳定，本次不动 |
| `interface_can.cpp` CanSendMessage 三件套加固 | 已完成（21dbc16）|
| `dummy_robot.cpp` SetEnable 改 ALL 代理 | 已完成（77afa80）|
| `dummy_robot.cpp` UpdateJointAngles 改 ALL 代理 | 已完成（77afa80）|
| `can_protocol.cpp` 0x23/0x25/0x28~0x2B/0x2C/0x2D/0x7C 处理 | 已完成，本次只改 0x5A/0x5C |
| `can_protocol.cpp` 0x28~0x2B PID 合并 printf 改事件标志 | ✅ 已完成（2026-09-16 选项1，F4 扩展）|
| `dummy_robot.cpp` A1/A3/A4/A7 修复 | 已完成 |
| `dummy_robot.cpp` jointsStateFlag 写入方向 | 已正确（FINISH→\|=）|
| `ctrl_step.cpp` EmergencyStop 走 ALL 广播 | 已完成（77afa80）|
| MoveJ/$ 命令格式变更（地轨 J7） | 已完成（f3623ca）|

---

## 九、风险与缓解

| 风险 | 概率 | 影响 | 缓解 |
|---|---|---|---|
| F1 enable 后第一帧 `UpdateAngle` 未及时返回，`jointsStateFlag` 错填 | 低 | P0 阻塞 | F1 修复同时在 `SetEnable(true)` 末尾**预发**一帧 `motorJ[ALL]->UpdateAngle()` |
| F2 ParseCommand 入口判 `isStalled` 影响其他逻辑 | 低 | 堵转逻辑 | 仅丢弃 `>/&/@`，其他指令完全不受影响 |
| F3 删 `osDelay(20)` 后 OLED 帧率过高占用 CPU | 极低 | 性能 | 软件 I2C 自然限速，实测 50-80Hz 不会撑爆 CPU |
| F4 标志丢失（多电机同时堵转）| 中 | 打印不完整 | 现阶段接受单字节覆盖；后续可改环形缓冲 |

---

## 十、验证清单

### 10.1 编译验证

```bash
cd E:\Dummy-code\firmware\ref_core_f405\build; ninja
cd E:\Dummy-code\firmware\motor_fw_f103_35\build; ninja
cd E:\Dummy-code\firmware\motor_fw_f103_42\build; ninja
cd E:\Dummy-code\firmware\motor_fw_f103_57\build; ninja
cd E:\Dummy-code\firmware\motor_fw_f103_gripper\build; ninja
```

预期：全部通过，无新增 warning/error。

### 10.2 功能验证（每批完成后）

| 批 | 验证项 | 通过标准 |
|----|---|---|
| F1 | `!START` 后立即查 `#GETJPOS`，等 1 秒内回包 | 关节角度正确，jointsStateFlag 渐进置位 |
| F2 | 触发堵转 → 发 `!START` | 红色 RGB 心跳立即解除（控制指令放行）|
| F2 | 触发堵转 → 发 `>0,0,0,0,0,0,0,10` | 返回 `ok`，电机不动（运动指令丢）|
| F3 | OLED 显示正常，帧率提升 | 实测 ≥60Hz |
| F4 | 触发堵转 → 串口输出 `[STALL] node=X TRIGGER` | 输出完整，不卡死 |

### 10.3 残留检查

```bash
# F1：state=FINISH 应只在 UpdateAngleCallback 内出现
grep -n "state = FINISH" firmware/ref_core_f405/Robot/actuators/ctrl_step/ctrl_step.cpp

# F2：ClearFifo 应仅在 commandHandler 构造/析构内出现
grep -n "ClearFifo" firmware/ref_core_f405/Robot/instances/dummy_robot.cpp

# F3：osDelay(20) 应只在必要处（如 RGB task）出现
grep -n "osDelay(20)" firmware/ref_core_f405/UserApp/main.cpp

# F4：can_protocol.cpp 内 printf 仅在 PollPidPrint() 主线程函数内（不在 ISR）
grep -n "printf" firmware/ref_core_f405/UserApp/protocols/can_protocol.cpp
# 预期：仅 1 处命中（PollPidPrint 函数体内 line 104）

# F4 扩展：_pid_print_pending/_pid_pending_node 定义在 can_protocol.cpp 顶部
grep -n "_pid_print_pending" firmware/ref_core_f405/UserApp/protocols/can_protocol.cpp
# 预期：3 处命中（1 处定义 + 12 处 ISR 写入 + 2 处 PollPidPrint 内读/清）
```

---

## 十一、引用文档

| 文档 | 内容 |
|---|---|
| `主控固件回归—2026-09-14实测根因复盘.md` | 真凶分析与待修清单（权威）|
| `主控固件退化修复—全面重构需求.md` | 9-04 退化清单（参考）|
| `主控固件重构—ALL代理整合方案—2026-09-16.md` | v3.2 ALL 代理整合方案（基线）|
| `主控固件重构—地轨改为J7(CAN_ID7)—2026-09-15.md` | 地轨 J7 重构细节 |
| `重构方案—堵转检测重构需求.md` | v3 堵转检测方案 |
| `docs/TODO.md` | 全局 FEAT/BUG 待办 |

---

**文档结束**

> AI 助手：根据用户 2026-09-16 对话制定。
> 下一步：用户确认决策清单后，按批次执行 F1 → F2 → F3 → F4，每批出 diff 二次确认。
