Liu3Beng-A/Dummy/docs/主控固件重构—ALL代理整合方案—2026-09-16.md

# 主控固件重构 — ALL 代理恢复整合方案（2026-09-16 修订版）

> **整合日期**：2026-09-16
> **修订原因**：原整合文档漏掉上一步"地轨改为 J7"重构的核心变化（MoveJ/$ 格式变更、runtime 索引重新分配、上位机同步），本修订版按上一步实际文档 `主控固件重构—地轨改为J7(CAN_ID7)—2026-09-15.md` 重新整合
> **基线**：v3.1（地轨已重构为 J7/ID=7，含 MoveJ/$ 格式变更）
> **整合来源**：
>
> | # | 文档 | 时间戳 | 角色 |
> |---|------|--------|------|
> | **E** | **`docs/主控固件重构—地轨改为J7(CAN_ID7)—2026-09-15.md`** | **2026-09-15** | **上一步重构的实际落地细节（最权威）** |
>
> **已整合并删除**：A/B/C/D 四份源文档已整合入本文档
>
> **目标**：恢复 ALL 代理机制（`motorJ[ALL]` 虚拟对象 + 电机端 `id==0` 特判），覆盖 `!START / !DISABLE / #REBOOT / !STOP` 四个群发语义命令，**配套修复**信号量泄漏导致 `!START` 后 RGB 卡死的真凶。

---

## 一、核心偏差修正（原整合文档的问题）

### 1.1 上一步重构的本质（重新理解）

上一步"地轨改为 J7（CAN_ID=7）"**不是简单的 CAN ID 改名**，而是把地轨从"特殊边缘节点"重构为"第 7 个关节 J7"的根本性架构变化：

| 维度 | 旧架构 | 新架构（已落地） |
|---|---|---|
| **本质定位** | 地轨是"特殊边缘节点"（`motorJ[0]`，CAN ID=9） | 地轨是"第 7 个关节 J7"（`motorJ[7]`，CAN ID=7） |
| **MoveJ 格式** | `>Rail,j1,j2,j3,j4,j5,j6,speed`（地轨在第 1 位） | `>j1,j2,j3,j4,j5,j6,j7(rail),speed`（地轨在第 7 位，与所有关节对齐） |
| **$ 力矩格式** | `$c0(rail),c1,c2,c3,c4,c5,c6`（地轨在第 1 位） | `$c1,c2,c3,c4,c5,c6,c7(rail)`（地轨在第 7 位） |
| **runtime 索引** | runtime[0]=地轨, runtime[7]=夹爪 | runtime[7]=J7/地轨, runtime[8]=夹爪 |
| **motorJ[] 大小** | `motorJ[7]`（0~6） | `motorJ[8]`（0~7） |
| **ALL 代理位置** | 无（被地轨占用） | `motorJ[0]`（占位对象，nodeID=0） |

> **重要**：MoveJ/$ 格式变化是上一步重构的**核心目的**（让地轨对齐为"第 7 个关节"），不是配套改动。原整合文档完全遗漏这一点。

### 1.2 原整合文档的偏差清单

| # | 偏差项 | 原文档遗漏 | 实际文档（E） |
|---|---|---|---|
| 1 | **MoveJ 命令格式变化** | ❌ 未提及 | ✅ 核心章节 §3.11 + §4.1 |
| 2 | **$ 力矩命令格式变化** | ❌ 未提及 | ✅ §3.12 + §4.2 |
| 3 | **runtime 索引重新分配** | ⚠️ 提到 `[9]` 但未说明重映射 | ✅ §5.1 + §7 + §12.5 |
| 4 | **can_protocol.cpp 详细回包** | ⚠️ 泛泛说"id==7 块已完整" | ✅ §5 详细列出 0x23/0x25/0x2C/0x2D/0x5A/0x5C/0x7C 各 case |
| 5 | **电机端 `configurations.h` 改动** | ❌ 未提及 | ✅ §2.1 + §2.2 |
| 6 | **上位机（串口助手.py）同步** | ❌ 未提及 | ✅ §11 + §15（15 行改动） |
| 7 | **日志/错误提示文本 [9]→[7]** | ❌ 未提及 | ✅ §14.8 + §14.9 |
| 8 | **PID 合并回包数组扩维** | ❌ 未提及 | ✅ §14.2（`_pid_tmp_*[8]` → `[9]`） |
| 9 | **`#define Rail 7` 是否需要** | 建议加 | **不需要**（motorJ[7] 语义自明） |
| 10 | **`_pid_node_to_idx` 函数改动** | ❌ 未提及 | ✅ §5.1（`if (nodeId == 9) return 0` → `if (nodeId == 7) return 7`） |
| 11 | **3 个 MoveJ 模式都要改调用顺序** | ⚠️ 含糊 | ✅ §3.11.1（SEQUENTIAL + CONTINUES_TRAJECTORY + INTERRUPTABLE 三处） |
| 12 | **0x7C 旧堵转上报兼容性** | ❌ 未提及 | ✅ §14.4（建议 `SetStallMode((int)data[0])` 兼容新旧固件） |
| 13 | **`SyncAllMotorAcceleration` 重构** | ⚠️ 提到但未细化 | ✅ §14.7 |
| 14 | **`SetJointAcceleration` 循环扩展** | ❌ 未提及 | ✅ §14.6（建议 `i<=7`） |

### 1.3 已完成的具体改动（上一步实际落地）

按文件分类（合计 ~180 行）：

#### 1.3.1 电机端固件改动（57 电机）

| 文件 | 改动 | 行数 |
|---|---|---|
| `firmware/motor_fw_f103_57/UserApp/configurations.h` | `RAIL_FIXED_NODE_ID 9 → 7` | 1 |
| `firmware/motor_fw_f103_57/UserApp/main.cpp` | `boardConfig.canNodeId = RAIL_FIXED_NODE_ID` 引用 2 处（已跟随宏自动改为 7） | 0（宏驱动） |

#### 1.3.2 主控固件改动

| 文件 | 改动类型 | 行数 | 备注 |
|---|---|---|---|
| `dummy_robot.h` | `motorJ[7]`→`[8]`，`MOTOR_REDUCTION`→`[8]`，`AXIS_MAX_RPS`→`[8]`，runtime 数组→`[9]` | ~20 | 含数组扩维 |
| `dummy_robot.cpp` | 构造函数 + 析构 + SetJointCurrents + SetCommandMode + Reboot + UpdateJointAngles + UpdateJointAnglesCallback + SetEnable + SyncAllMotorAcceleration + SetJointAcceleration + MoveJ/ServoJ 限位 + Homing/Resting + 4 个 SEQUENTIAL/INTERRUPTABLE/TRJ/SRV 分支 + $ 解析 | ~50 | 12+ 个子节 |
| `ascii_protocol.cpp`（USB + UART4 **双通道**） | `$` 解析 + 地轨配置 node=9→7 + STALL_EN/DIS 循环 + `#GETJACC`/`#GETI` 索引 + 日志/错误文本更新 | ~60 | **两通道均需修改** |
| `can_protocol.cpp` | 地轨路由 id==9→id==7 + runtime 索引 0→7（夹爪 7→8）+ `_pid_tmp_*[8]`→`[9]` + `_pid_node_to_idx` 9→7 + 0x7C `SetStallMode(9→7)` + 0x23/0x25/0x2C/0x2D/0x5A/0x5C/0x7C 各 case | ~30 | 含 PID 数组扩维 |
| `ctrl_step.cpp` | 注释修改 | ~1 | |
| `main.cpp` | 地轨注释 + `motorJ[0]`→`motorJ[7]` | ~5 | |

#### 1.3.3 上位机配套改动

| 文件 | 改动 | 行数 |
|---|---|---|
| `docs/串口助手.py` | `send_torque()` `$` 格式 + `node_names` 字典（9→7）+ 节点验证范围 + `set_rail_current`/`query_rail_current`/`send_rail_acc` CAN ID | ~15 |

---

## 二、方案差异对比表（4 文档 × 实际固件）

| # | 决策点 | 文档 D（v2） | 文档 B/C/A | 实际固件 | **最终采用** |
|---|---|---|---|---|---|
| 1 | 对象布局架构 | `motorJ[7]` + `CtrlStepMotor* rail` 独立指针 | `motorJ[8]`，`motorJ[Rail]=slot[7]` | `motorJ[8]` ✅ | **8 slot**（motorJ[8]，已落地） |
| 2 | 地轨 CAN nodeID | 9 | 9 | **7** | **7**（实际硬件拨码开关） |
| 3 | 宏定义 | `#define ALL 0` | B：`#define RAIL 7`；C/A：`#define Rail 7` | **未加宏**（motorJ[7] 语义自明） | **不加宏**，直接用 `motorJ[7]` |
| 4 | MoveJ 命令格式 | 未明确（隐式旧格式） | 未明确（隐式旧格式） | **新格式** `>j1..j6,j7,speed` | **新格式** `>j1,j2,j3,j4,j5,j6,j7(rail),speed` |
| 5 | $ 力矩命令格式 | 未明确 | 未明确 | **新格式** `$c1..c6,c7(rail)` | **新格式** `$c1,c2,c3,c4,c5,c6,c7(rail)` |
| 6 | runtime 索引 | runtime[0]=地轨, [7]=夹爪 | 同 D | runtime[1..7]=J1~J7, [8]=夹爪 | **新分配**：runtime[1..7]=J1~J7，[8]=夹爪，[0]=空闲 |
| 7 | 信号量修复 | R10 加强版：三件套 | B/A 仅超时+释放；C 加强版三件套 | 未做 | **预检查+超时+释放三件套** |
| 8 | `!STOP` 急停 | R11 独立可选 bug | 纳入主线 + 新增 `case 0x09` | 未做（仍 `StdId=0x89`） | **纳入主线**，新增 `case 0x09` |
| 9 | `EmergencyStop` 后 flag | 保持 `= 0` | 改为 `= 0x7E` | 未做 | **改为 0x7E**（ALL_FINISH_FLAG） |
| 10 | `IsMoving` 短路 | 未提及 | 加 `isEnabled` 短路 | 未做 | **加 `isEnabled` 短路** |
| 11 | `STALL_EN/DIS` 边界 | `i < 7` + rail | 显式 `motorJ[1..6] + motorJ[Rail]` | 已改 `i = 1..7` ✅ | **`for (int i = 1; i <= 7; i++)`** |
| 12 | `#REBOOT <node>` | 删除，统一 `#REBOOT` | 同上 | 仍保留 `#REBOOT 7` | **保留**，支持 `#REBOOT`（全部）和 `#REBOOT <node>`（单轴） |
| 13 | `!CALIBRATION` | 删除 | 删除 | 未删 | **删除** |
| 14 | 夹爪 ALL 参与 | 不参与 | B：参与；C/A：不参与 | 不参与 | **不参与**，夹爪由 `hand->` 独立控制 |
| 15 | 上位机（串口助手）同步 | ❌ 未提及 | ❌ 未提及 | **需要 ~15 行改动** | **必须做**（约15行改动） |
| 16 | 电机端 `configurations.h` | ❌ 未提及 | ❌ 未提及 | **需要改** | **必须改**（RAIL_FIXED_NODE_ID 9→7） |
| 17 | `_pid_node_to_idx` 改动 | ❌ 未提及 | ❌ 未提及 | **需要改** | **必须改**（`nodeId == 9 → 7`，`return 7`） |

**关键决策依据**：

1. **架构（#1）**：实际固件已落地 8 slot，撤回成本高。
2. **地轨 ID（#2）**：硬件拨码开关实际是 7，57 电机固件通过 `RAIL_FIXED_NODE_ID` 宏管理。
3. **宏定义（#3）**：文档 E §3.2 明确说明"**不需要 `#define Rail 7` 了**——`motorJ[7]` 直接就是地轨，语义自明"。**不加宏**，直接用 `motorJ[7]`。
4. **MoveJ/$ 格式（#4-#5）**：文档 E 核心变化，地轨对齐为 J7 后命令格式必须重排。
5. **runtime 索引（#6）**：8 个电机 + 1 个夹爪 = 9 个槽，但 ALL 代理无回包，所以 runtime[0] 空闲，[1..7] = J1~J7，[8] = 夹爪。
6. **上位机同步（#15）**：所有 4 文档都遗漏，文档 E §11 + §15 补全。

---

## 三、最终架构

### 3.1 对象布局（`dummy_robot.h`）

```cpp
class DummyRobot {
private:
    // motorJ[0]=ALL 广播代理 (ID=0, 占位)，motorJ[1..7]=J1~J7(含地轨 ID=7)
    CtrlStepMotor* motorJ[8] = {nullptr};

    // [v3.1] index [0]=ALL代理, [1..6]=J1~J6, [7]=J7/地轨
    static constexpr float AXIS_MAX_RPS[8] = {
        0.0f,    // ALL 代理（不参与速度规划）
        30.0f,   // J1
        30.0f,   // J2
        30.0f,   // J3
        30.0f,   // J4
        30.0f,   // J5
        30.0f,   // J6
        30.0f    // J7/地轨（直连丝杆1605）
    };

    // [v3.1] index [0]=ALL代理(无减速), [1..6]=J1~J6(50), [7]=J7/地轨(1, 直连丝杆1605)
    static constexpr uint8_t MOTOR_REDUCTION[8] = {1, 50, 50, 50, 50, 50, 30, 1};

    // [v3.1] runtime 索引: [1..7]=J1~J7/地轨, [8]=夹爪, [0] 空闲
    float jointAccRuntime[9] = {0};
    uint32_t jointAccLastUpdateMs[9] = {0};
    float jointCurrentLimitRuntime[9] = {0};
    uint32_t jointCurrentLimitLastUpdateMs[9] = {0};

    StepHand* hand = nullptr;  // 夹爪（ID=8），不在 motorJ[] 内
};
```

> **不需要 `#define Rail 7` 宏定义**：`motorJ[7]` 直接就是 J7/地轨，语义自明。

### 3.2 MoveJ 函数签名（不变）

```cpp
bool MoveJ(float _j1, float _j2, float _j3, float _j4, float _j5, float _j6, float _j7_mm, float _slider)
```

参数含义：

| 参数 | 含义 |
|---|---|
| `_j1` ~ `_j6` | J1~J6 角度（°） |
| `_j7_mm` | **J7/地轨位置（mm）**（语义对齐：从前是"地轨"现在是"J7"） |
| `_slider` | 速度滑块 |

### 3.3 ASCII 命令格式变化（核心）

#### 3.3.1 MoveJ / MoveL 命令格式

| 旧格式（地轨在第 1 位） | 新格式（地轨在第 7 位，对齐为 J7） |
|---|---|
| `>Rail,j1,j2,j3,j4,j5,j6,speed` | `>j1,j2,j3,j4,j5,j6,j7(rail),speed` |
| 示例：`>7,0,0,0,0,0,0,10`（地轨=7mm，J1~J6=0°） | 示例：`>0,0,0,0,0,0,7,10`（J1~J6=0°，J7/地轨=7mm） |

#### 3.3.2 $ 力矩命令格式

| 旧格式（地轨在第 1 位） | 新格式（地轨在第 7 位） |
|---|---|
| `$c0(rail),c1,c2,c3,c4,c5,c6` | `$c1,c2,c3,c4,c5,c6,c7(rail)` |
| 示例：`$7,0,0,0,0,0,0`（地轨=7A，J1~J6=0A） | 示例：`$0,0,0,0,0,0,7`（J1~J6=0A，J7/地轨=7A） |

#### 3.3.3 `#GETJPOS` / `#PRINTPOSE` 输出格式（不变）

```
Rail(mm) J1(°) J2(°) J3(°) J4(°) J5(°) J6(°)
```

输出第 1 个值始终是 `currentRailPos`（地轨 mm），后续依次是 J1~J6。**输出顺序与 MoveJ 输入顺序解耦**。

#### 3.3.4 单轴配置命令

| 命令 | 旧 | 新 |
|---|---|---|
| `#SET_DCE_KV 9 ...` | `node=9` (地轨) | **`node=7`** (J7/地轨) |
| `#SET_DCE_KP 9 ...` | 同上 | **`node=7`** |
| `#SET_DCE_KI 9 ...` | 同上 | **`node=7`** |
| `#SET_DCE_KD 9 ...` | 同上 | **`node=7`** |
| `#SET_PID 9 ...` | 同上 | **`node=7`** |
| `#GET_PID 9` | 同上 | **`node=7`** |
| `#ACC_J 9 ...` | 同上 | **`node=7`** |
| `#I_LIMIT_J 9 ...` | 同上 | **`node=7`** |
| `#GETJACC 9` | 同上 | **`node=7`** |
| `#GETI 9` | 同上 | **`node=7`** |
| `#REBOOT 9` | 同上 | **保留**，支持 `#REBOOT` 和 `#REBOOT <node>` |

### 3.4 命令协议映射（修订）

| 命令 | 主控实现 | StdId | 电机端 case | 帧数 |
|---|---|---|---|---|
| `!START` | `motorJ[ALL]->SetEnable(true)` + `hand->SetEnable(true)` | 0x01 / (8<<7)\|0x01 | case 0x01 | **2**（vs 旧 8） |
| `!DISABLE` | `motorJ[ALL]->SetEnable(false)` + `hand->SetEnable(false)` | 0x01 / (8<<7)\|0x01 | case 0x01 | **2** |
| `!STOP` | `motorJ[ALL]->BroadcastEStop()` + `hand->BroadcastEStop()` | 0x09 / (8<<7)\|0x09 | case 0x09 | **2** |
| `#REBOOT` | `motorJ[ALL]->Reboot()` + `hand->Reboot()` | 0x7F / (8<<7)\|0x7F | case 0x7F | **2** |
| 位置查询 | `motorJ[ALL]->UpdateAngle()` | 0x23 | case 0x23 | **1**（vs 旧 4 组轮询） |
| **MoveJ/MoveL/ServoJ 地轨** | `motorJ[7]->SetPositionWithMotorRps(...)` | (7<<7)\|0x07 | case 0x07 | 1 |
| **$ 力矩模式地轨** | `motorJ[7]->SetCurrentSetPoint(...)` | (7<<7)\|0x03 | case 0x03 | 1 |
| **地轨 PID/加速度/限位** | `motorJ[7]->Xxx()` | (7<<7)\|cmd | 各 case | 1 |
| 夹爪独立 | `hand->Xxx()` | (8<<7)\|cmd | 各 case | 1 |
| `!STALL_UNLOCK` | `motorJ[1]->BroadcastUnlock()` × 3 | 0x5B | case 0x5B | 3（沿用现状） |

> **夹爪定位**：夹爪（ID=8）不参与 ALL 代理广播，由 `hand->` 独立控制；夹爪固件无需任何修改。

### 3.5 runtime 索引分配

| 索引 | 对象 | CAN ID | 说明 |
|---|---|---|---|
| `[0]` | **空闲槽** | — | ALL 代理永远不回包 |
| `[1]` | J1 | 1 | |
| `[2]` | J2 | 2 | |
| `[3]` | J3 | 3 | |
| `[4]` | J4 | 4 | |
| `[5]` | J5 | 5 | |
| `[6]` | J6 | 6 | |
| `[7]` | **J7/地轨** | **7** | |
| `[8]` | **夹爪** | **8** | 从旧 runtime[7] 迁移 |

> **注意**：夹爪 runtime 索引从 `[7]` 迁移到 `[8]`（J7/地轨占用 `[7]`），需要同步修改 `can_protocol.cpp` 中夹爪回包分支的写入索引。

### 3.6 电机端 Rx 路由

```c
// HAL_CAN_RxFifo0MsgPendingCallback（35/42/57 电机同构）
uint8_t id  = (RxHeader.StdId >> 7);   // 7Bits ID (0~127)
uint8_t cmd = (RxHeader.StdId & 0x7F); // 7Bits CMD

// 单播：仅目标节点响应（任何 cmd，含 0x5C）
if (id == boardConfig.canNodeId) {
    OnCanCmd(cmd, RxData, RxHeader.DLC);
}
// 广播：id==0 且 cmd != 0x5C
else if (id == 0 && cmd != 0x5C) {
    OnCanCmd(cmd, RxData, RxHeader.DLC);
}
```

### 3.7 `!STOP` 急停完整流程

```
!STOP
  └─ dummy.commandHandler.EmergencyStop()
       ├─ motorJ[ALL]->BroadcastEStop()    // 发 StdId=0x09
       ├─ hand->BroadcastEStop()           // 夹爪独立急停
       ├─ jointsStateFlag = 0x7E           // bit1~6 全置位 = 物理到位
       ├─ isEnabled = false                // 短路 IsMoving
       └─ ClearFifo()
```

---

## 四、8 阶段执行计划

### 已完成部分（按文档 E 的上一步实际落地）

#### ✅ 阶段 3-A：电机端固件（57 电机）

- `firmware/motor_fw_f103_57/UserApp/configurations.h`: `RAIL_FIXED_NODE_ID 9 → 7`
- `firmware/motor_fw_f103_57/UserApp/main.cpp`: 通过宏引用自动跟随（无需直接改值）

#### ✅ 阶段 3-B：主控对象布局重构（dummy_robot.h/cpp）

- `motorJ[7]` → `motorJ[8]`
- 构造函数：`motorJ[0]=ALL代理(ID=0)` + `motorJ[1..6]=J1~J6(ID=1..6)` + `motorJ[7]=J7/地轨(ID=7)` + `hand=夹爪(ID=8)`
- 析构循环：`for (int j = 0; j <= 7; j++)`
- `Reboot/SyncAllMotorAcceleration/QueryStallStatus/SetJointAcceleration/SetEnable/UpdateJointAngles` 循环：`for (int i = 1; i <= 7; i++)`
- `Resting/Homing/MoveJ/ServoJ/UpdateJointAnglesCallback/CommandHandler::ParseCommand(4 个模式)`：地轨用 `motorJ[7]`
- `SetJointCurrents`：函数签名不变（`c0` 仍是地轨），$ 解析时正确映射

#### ✅ 阶段 3-C：ASCII 协议 MoveJ/$ 格式变更（双通道）

- UART+USB 双通道的 MoveJ/MoveL/ServoJ 解析：`sscanf` 格式串不变（仍是 8 个或 7 个 `%f`），但变量命名清晰化（`j1..j7`），**MoveJ 调用参数顺序必须调整**
- `$` 解析：sscanf 仍是 7 个 `%f`，但 `SetJointCurrents` 调用映射变为 `SetJointCurrents(c[6], c[0], c[1], ..., c[5], 0.0f)`
- `!STALL_EN/DIS` 循环边界：`for (int i = 1; i <= 7; i++)`
- `#SET_DCE_KV/KP/KI/KD 7` / `#SET_PID 7` / `#GET_PID 7` / `#ACC_J 7` / `#I_LIMIT_J 7` / `#GETJACC 7` / `#GETI 7` / `#REBOOT 7` 已改

#### ✅ 阶段 3-D：can_protocol.cpp 详细回包改动

- `if (id == 9)` → `if (id == 7)` 块完整迁移
- 0x23 位置回包：`dummy.motorJ[7]->UpdateAngleCallback(...)` + `currentRailPos = dummy.motorJ[7]->angle / 360 * 5`
- 0x25 温度回包：`memcpy(&dummy.motorJ[7]->temperature, data, sizeof(uint32_t))`
- 0x28~0x2B PID 合并回包：`_pid_tmp_kp[idx]` 等（`idx = _pid_node_to_idx(id)`）
- 0x2C 加速度回包：`jointAccRuntime[7]` + `jointAccLastUpdateMs[7]`
- 0x2D 电流限幅回包：`jointCurrentLimitRuntime[7]` + `jointCurrentLimitLastUpdateMs[7]`
- 0x5A 堵转广播：`SetStallMode((int)stallNodeId)`（使用回包中的实际 nodeID）
- 0x5C 查询响应：单播查询响应处理
- 0x7C 旧堵转上报：`SetStallMode(7)`（或 `SetStallMode((int)data[0])` 兼容新旧固件）
- 夹爪回包（id==8）分支：runtime 索引 `7` → `8`
- `_pid_node_to_idx`：`if (nodeId == 9) return 0` → `if (nodeId == 7) return 7`
- `_pid_tmp_kp/kv/ki/kd[8]` + `_pid_rcv_cnt[8]` → `[9]`（PID 缓存数组扩维）

#### ✅ 阶段 3-E：main.cpp 实时环

- 5kHz 实时环 3 处 `dummy.motorJ[7]->...` 已改完（CONTINUES_TRAJECTORY/SERVO_J/TORQUE_CONTROL）

#### ✅ 阶段 3-F：上位机同步（串口助手.py）

- `send_torque()` `$` 格式从 `$c0(rail),c1~c6` 改为 `$c1,c2,c3,c4,c5,c6,c7(rail)`
- `node_names` 字典：`{9: "地轨"}` → `{7: "地轨"}`
- 节点验证范围：`(1..6, 8, 9)` → `(1..6, 7, 8)`
- `set_rail_current` / `query_rail_current` / `send_rail_acc`：CAN ID 9 → 7

### 待完成（按优先级）

---

## 阶段 0 — 信号量泄漏修复（独立，最先）

**优先级**：⭐⭐⭐ 最高

详见 §二（决策#7）：采用 D/C 加强版（预检查 mailbox + 10ms 超时 + 失败释放三件套）。

### 改动文件

`firmware/ref_core_f405/Bsp/communication/interface_can.cpp`

### 改动内容

```cpp
void CanSendMessage(CAN_context* canCtx, uint8_t* txData, CAN_TxHeaderTypeDef* txHeader)
{
    // 加固#1：发送前查 mailbox 空闲
    uint32_t startTick = HAL_GetTick();
    while (HAL_CAN_GetTxMailboxesFreeLevel(canCtx->handle) == 0) {
        if (HAL_GetTick() - startTick > 5) return;
    }

    // 加固#2：10ms 超时
    osStatus semaphore_status;
    if (canCtx->handle->Instance == CAN1)
        semaphore_status = osSemaphoreAcquire(sem_can1_tx, 10);
    else if (canCtx->handle->Instance == CAN2)
        semaphore_status = osSemaphoreAcquire(sem_can2_tx, 10);
    else
        return;

    if (semaphore_status == osOK) {
        HAL_StatusTypeDef ret = HAL_CAN_AddTxMessage(
            canCtx->handle, txHeader, txData, &canCtx->last_heartbeat_mailbox);
        // 加固#3：失败时释放信号量
        if (ret != HAL_OK) {
            if (canCtx->handle->Instance == CAN1)
                osSemaphoreRelease(sem_can1_tx);
            else if (canCtx->handle->Instance == CAN2)
                osSemaphoreRelease(sem_can2_tx);
        }
    }
}
```

---

## 阶段 1 — 电机端 Rx 路由恢复 `id==0` 特判

**优先级**：⭐⭐⭐ 最高（ALL 代理生效的阻塞依赖）

详见 §三（3.6）。改动 3 个电机固件的 `Core/Src/can.c`：

- `firmware/motor_fw_f103_35/Core/Src/can.c`
- `firmware/motor_fw_f103_42/Core/Src/can.c`
- `firmware/motor_fw_f103_57/Core/Src/can.c`（注意：57 电机固件 EEPROM 的 canNodeId = 7）

将 `cmd >= 0x50` + `id == nodeID` 改为 `id == nodeID` + `id == 0 && cmd != 0x5C`。

---

## 阶段 2 — 电机端 `case 0x09` 急停

**优先级**：⭐⭐ 高（依赖阶段 1）

详见 §三（3.7）。改动 3 个电机固件的 `UserApp/protocols/interface_can.cpp`：

删除 `case 0x89`（死代码），新增 `case 0x09`（复用急停逻辑）。

---

## 阶段 4 — ALL 代理方法集成

**优先级**：⭐⭐ 高（依赖阶段 1+2）

### 4-A `SetEnable`（`dummy_robot.cpp`）

8 次循环 → 2 帧：

```cpp
void DummyRobot::SetEnable(bool _enable)
{
    // ... 状态设置（同旧代码）...

    motorJ[ALL]->SetEnable(_enable);  // 1 帧 StdId=0x01
    hand->SetEnable(_enable);         // 1 帧 StdId=(8<<7)|0x01

    isEnabled = _enable;
}
```

### 4-B `Reboot`（`dummy_robot.cpp`）

8 次循环 → 2 帧：

```cpp
void DummyRobot::Reboot()
{
    motorJ[ALL]->Reboot();  // 1 帧 StdId=0x7F
    hand->Reboot();         // 1 帧 StdId=(8<<7)|0x7F
    osDelay(500);
    HAL_NVIC_SystemReset();
}
```

### 4-C `BroadcastEStop`（`ctrl_step.cpp`）

```cpp
void CtrlStepMotor::BroadcastEStop()
{
    txHeader.StdId = (nodeID << 7) | 0x09;  // motorJ[ALL] 调用时 → 0x09
    uint8_t buf[8] = {0};
    CanSendMessage(get_can_ctx(hcan), buf, &txHeader);
}
```

### 4-D `EmergencyStop`（`dummy_robot.cpp`）

```cpp
void DummyRobot::CommandHandler::EmergencyStop()
{
    context->motorJ[ALL]->BroadcastEStop();    // StdId=0x09
    context->jointsStateFlag = 0x7E;            // bit1~6 全置位
    context->isEnabled = false;
    ClearFifo();
}
```

### 4-E `UpdateJointAngles`（`dummy_robot.cpp`）

4 组轮询 → 1 帧 ALL：

```cpp
void DummyRobot::UpdateJointAngles()
{
    motorJ[ALL]->UpdateAngle();  // 1 帧 StdId=0x23 触发 7 个电机回包
}
```

### 4-F `IsMoving`（`dummy_robot.cpp`）

```cpp
bool DummyRobot::IsMoving()
{
    if (!isEnabled) return false;  // 失能短路
    return jointsStateFlag != 0x7E;  // ALL_FINISH_FLAG
}
```

### 4-G 加 `ALL_FINISH_FLAG` 常量（`dummy_robot.h`）

```cpp
static constexpr uint8_t ALL_FINISH_FLAG = 0x7E;  // 0b01111110
```

---

## 阶段 5 — ASCII 协议适配

### 5-A `#REBOOT` 保留双模式（全部 + 单轴）

**当前代码**（`ascii_protocol.cpp`，UART+USB 双通道）：

```cpp
else if (s.find("REBOOT") != std::string::npos)
{
    uint32_t node;
    sscanf(_cmd, "#REBOOT %lu", &node);
    if (node == 7) { dummy.motorJ[7]->Reboot(); Respond(...); }
    else if (node >= 1 && node <= 6) { dummy.motorJ[node]->Reboot(); Respond(...); }
    else { Respond(...error...); }
}
```

**替换为**（与旧版保持一致，保留两种形式）：

```cpp
// 严格匹配不带参：重启所有电机
else if (s == "#REBOOT") {
    dummy.Reboot();
    Respond(_responseChannel, "ok REBOOT all motors + main reset");
}
// 带参数：重启指定节点
else if (s.find("#REBOOT ") == 0) {
    uint32_t node;
    sscanf(_cmd, "#REBOOT %lu", &node);
    if (node == 7) {
        dummy.motorJ[7]->Reboot();
        Respond(_responseChannel, "ok REBOOT motor 7 (J7/rail)");
    } else if (node >= 1 && node <= 6) {
        dummy.motorJ[node]->Reboot();
        Respond(_responseChannel, "ok REBOOT motor %lu", node);
    } else {
        Respond(_responseChannel, "error invalid node %lu (use 1~7)", node);
    }
}
```

> **注意**：两个条件分支顺序不能颠倒，先判断无参数 `#REBOOT`，再判断带参数 `#REBOOT <node>`。

### 5-B `!CALIBRATION` 删除

**当前代码**（UART 约 line 856~936）：

```cpp
else if (s.find("!CALIBRATION") == 0)
{
    for (int i = 1; i <= 6; i++)
        dummy.motorJ[i]->ApplyPositionAsHome();
    Respond(_responseChannel, "ok calibration done for all joints");
}
```

**改动**：整段删除。发 `!CALIBRATION` 将返回 "unknown command"。

### 5-C 日志/错误文本统一更新

所有 `Respond(... "[9]" ...)` 改为 `"[7]"`，错误提示 `"(use 9=rail, ...)"` 改为 `"(use 7=rail, ...)"`。双通道均需修改。

---

## 阶段 8 — 文档清理

| 文件 | 改动 |
|---|---|
| `docs/README.md` | 删除 `!CALIBRATION` 行；MoveJ/$ 格式说明更新到新格式 |
| `.cursor/rules/PROJECT_GUIDANCE.mdc` | 删除 `!CALIBRATION` 行；`#REOT <node>` 行保留（与旧版保持一致） |

---

## 五、完整验证清单

### 编译验证

```powershell
# 主控固件
cd firmware/ref_core_f405/build; ninja

# 35/42/57 电机固件
cd firmware/motor_fw_f103_35/build; ninja
cd firmware/motor_fw_f103_42/build; ninja
cd firmware/motor_fw_f103_57/build; ninja
```

### 代码残留检查

```powershell
# 主控：无 motorJ[0] 残留（除 ALL 初始化行）
Select-String -Path "firmware/ref_core_f405/**/*.cpp" -Pattern "motorJ\[0\]"

# 主控：无 id==9 / node==9 / runtime[0] 残留
Select-String -Path "firmware/ref_core_f405/**/*.cpp" -Pattern "id == 9|node == 9|node == 9.*rail|jointAccRuntime\[0\]|jointCurrentLimitRuntime\[0\]"

# 35/42/57 电机：无 case 0x89 残留
Select-String -Path "firmware/motor_fw_f103_*/**/interface_can.cpp" -Pattern "case 0x89"

# 主控：无 StdId=0x89 残留
Select-String -Path "firmware/ref_core_f405/**/*.cpp" -Pattern "StdId = 0x89"

# 57 电机：RAIL_FIXED_NODE_ID = 7
Select-String -Path "firmware/motor_fw_f103_57/**/*.h" -Pattern "RAIL_FIXED_NODE_ID"

# 上位机：node_names / set_rail_current 不含 9
Select-String -Path "docs/串口助手.py" -Pattern "9.*地轨|node == 9|node_names"
```

### 功能验证（硬件测试）

| # | 测试 | 操作 | 预期 |
|---|---|---|---|
| V1 | `!START` | 发命令 | 2 帧 CAN 0x01，RGB 正常 |
| V2 | `!DISABLE` | 发命令 | 所有电机失能 |
| V3 | 运动中发 `!STOP` | 发命令 | 所有电机立即抱闸停车 |
| V4 | `#REBOOT`（不带参） | 发命令 | 所有电机重启 + 主控 reset |
| V5 | `#REBOOT 7` | 发命令 | 返回 "ok REBOOT motor 7 (J7/rail)" |
| V6 | `#GETJPOS` | 查询 | Rail(mm) + J1~J6(°) 正常 |
| V7 | MoveJ 新格式 | `>0,0,0,0,0,0,10,50` | 地轨移动 10mm |
| V8 | $ 新格式 | `$0,0,0,0,0,0,0.5` | 地轨电流 0.5A |
| V9 | 反复 `!START`/`!DISABLE` 100 次 | 压力测试 | RGB 不再卡死 |
| V10 | `!STALL_UNLOCK` | 发命令 | 现有功能正常 |
| V11 | 堵转触发 | 机械干预 | 0x5A 广播正常，RGB 变红 |
| V12 | `!CALIBRATION` | 发命令 | 返回 "unknown command" |
| V13 | `!STALL_STATUS` | 发命令 | 返回所有电机堵转状态 |
| V14 | MoveJ 旧格式 | `>10,0,0,0,0,0,0,50` | 地轨不动（J1=10° 移动） |
| V15 | 地轨加速度 | `#ACC_J 7 200` | 返回 `ok SET MOTOR [7] ACCELERATION [200.00] r/s^2` |
| V16 | 串口助手地轨函数 | 点击"地轨电流限制" | 发 `#I_LIMIT_J 7 ...` |

---

## 六、阶段依赖图

```
阶段 3（地轨改为 J7）✅ 已完成（含 ASCII 双通道 MoveJ/$ 格式、can_protocol 详细回包、上位机同步）
    │
    ├──────────────────┐
    ▼                  ▼
阶段 6（can_protocol）✅ 已完成（id==7 路由 + runtime 索引重新分配 + PID 数组扩维）
阶段 7（main.cpp）✅ 已完成
    │
    ▼
阶段 0（信号量）─── 独立最先
    │
    ▼
阶段 1（Rx 路由）
    │
    ▼
阶段 2（case 0x09）
    │
    └──────┬─────────────┘
           ▼
    阶段 4（ALL 代理集成）
    ├─ 4-A SetEnable
    ├─ 4-B Reboot
    ├─ 4-C BroadcastEStop
    ├─ 4-D EmergencyStop
    ├─ 4-E UpdateJointAngles
    ├─ 4-F IsMoving
    └─ 4-G ALL_FINISH_FLAG 常量
           │
           ▼
    阶段 5（ASCII 协议适配）
    ├─ 5-A #REBOOT 保留双模式
    ├─ 5-B !CALIBRATION 删除
    └─ 5-C 日志/错误文本统一更新
           │
           ▼
    阶段 8（文档清理）
```

**建议执行顺序**：

```
阶段 0（独立，立刻降低死锁风险）
  → 阶段 1+2（电机端，先烧录电机固件）
  → 阶段 4（主控 ALL 代理集成）
  → 阶段 5（ASCII 协议清理）
  → 阶段 8（文档清理）
```

---

## 七、关键差异回顾（决策追溯表）

| 决策点 | 最终采用 | 依据 |
|---|---|---|
| 架构 | 8 slot（`motorJ[8]`） | 已落地 |
| 地轨 ID | **7** | 实际硬件拨码开关 |
| 宏定义 | **不加** `#define Rail 7` | 文档 E §3.2 明确说"motorJ[7] 直接就是地轨，语义自明" |
| MoveJ 格式 | **新格式** `>j1..j6,j7,speed` | 文档 E §3.11 + §4.1（核心变化） |
| $ 力矩格式 | **新格式** `$c1..c6,c7(rail)` | 文档 E §3.12 + §4.2 |
| runtime 索引 | runtime[1..7]=J1~J7, [8]=夹爪, [0]=空闲 | 文档 E §5.1 + §12.5 |
| 信号量修复 | 三件套（预检查+超时+释放） | 文档 D/C 加强版 |
| `!STOP` 急停 | 纳入主线 + `case 0x09` | 文档 A/B/C 一致 |
| `jointsStateFlag` 急停后 | `= 0x7E` | 文档 A/B/C 一致 |
| `IsMoving` 短路 | 加 `isEnabled` 短路 | 文档 A/B/C 一致 |
| `STALL_EN/DIS` 边界 | `for i=1..7` | 文档 A/B/C 一致 |
| `#REBOOT <node>` | **保留**（全部+单轴） | 与旧版保持一致 |
| `!CALIBRATION` | 删除 | 所有文档一致 |
| 夹爪 ALL 参与 | 不参与 | 文档 A/C/D/E 一致；B 例外 |
| 上位机同步 | **必须做** | 文档 E §11 + §15 |
| 电机端 `configurations.h` | **必须改** | 文档 E §2.1 |
| `_pid_node_to_idx` | 必须改（9→7, 返回 7） | 文档 E §5.1 |

---

## 八、未解决问题（第二阶段）

| # | 问题 | 说明 |
|---|---|---|
| 1 | 夹爪 `#REBOOT` | 夹爪固件是否支持 0x7F，需单独确认 |
| 2 | ServoJ 模式加速度下发 | 当前 SERVO_J case 内有冗余 `SetJointAcceleration`，待清理 |
| 3 | OLED 帧率 | `main.cpp` 的 `osDelay(20)` 是否需要删除 |
| 4 | ISR 内 printf 优化 | `can_protocol.cpp` 的 ISR 内 printf 是否需要改为事件标志 |
| 5 | UpdateAngle 频率调优 | 当前 100Hz 是否过高，可降回 25Hz |
| 6 | 7 节点回包总线仲裁 | 新增 1 个地轨后，UpdateAngle 广播触发的 7 节点同时回包是否需要分时 |

---

## 九、引用文档

- **`docs/主控固件重构—地轨改为J7(CAN_ID7)—2026-09-15.md`** — 上一步重构的实际落地细节（**最权威，保留**）
- **`docs/主控固件重构—ALL代理整合方案—2026-09-16.md`** — 本文档（整合后的最终执行方案）
- `docs/主控固件回归—2026-09-14实测根因复盘.md` — 根因分析
- `docs/主控固件退化修复—全面重构需求.md` — 重构背景
- `docs/电机固件对比分析_当前vs旧版_2026-09-05.md` — 电机端兼容性

> **已删除**：A/B/C/D 四份源文档已整合入本文档，无单独参考价值。

---

## 十、整合说明

本文档由 5 份分散的 ALL 代理恢复文档整合而成，整合原则：

1. **以上一步实际落地为最权威依据**：文档 E（地轨改为 J7）记录了上一步的实际改动，作为本整合文档的基线
2. **保留差异**：明确标注 5 文档在架构、宏命名、信号量策略、急停处理、MoveJ/$ 格式等 17 个决策点上的差异
3. **以实际固件为准**：实际 v3.1 已落地 8 slot + 地轨 ID=7 + MoveJ/$ 新格式，撤回成本高
4. **取最新版**：所有文档冲突时，优先采纳 2026-09-15 三份较新文档的方案
5. **加强版**：信号量修复采用最完善的 D/C 加强版（预检查 + 超时 + 释放三件套）
6. **明确主线**：!STOP 急停纳入主线（不再当独立可选 bug），避免两轮烧录
7. **保持简洁**：剔除多文档间的重复内容，统一为一份可执行的整合方案
8. **修订说明**：本修订版相比初版，新增 §1.3 上一步具体改动清单、§3.3 ASCII 命令格式变化表、§3.5 runtime 索引重新分配、§八上位机同步、§14 项 17 决策点的详细差异
