Liu3Beng-A/Dummy/docs/fixbug/注释清理—候选清单—2026-09-16.md

# 主控固件注释清理—候选清单（2026-09-16）

## 扫描范围（8 文件，30 条样本）

| # | 文件 | 行号 | 注释原文 | 类型 | 建议处理 |
|---|---|---:|---|---|---|
| 1 | main.cpp | 18 | `// I2C 128x64 状态监视与参数绘制屏幕面板`（`SSD1306 oled(&hi2c0);` 后） | 翻译型（类名已自描述） | 删除 |
| 2 | main.cpp | 19 | `// 基于硬线 I2C 通道链接的位姿感知计算元件`（`MPU6050 mpu6050(&hi2c1);` 后） | 翻译型（类名已自描述） | 删除 |
| 3 | main.cpp | 20 | `// 调度全局实时运算的主心跳时钟：200us 等效配置主频高达 5000Hz`（`Timer timerCtrlLoop(&htim7, 200);` 后） | 翻译型（参数已自描述） | 删除 |
| 4 | main.cpp | 21 | `// 外围设备与强流附件供电调制系统输出占空载波器`（`PWM pwm(21000, 21000);` 后） | 翻译型（类名已自描述） | 删除 |
| 5 | main.cpp | 22 | `// 底盘高亮环形跑马系统灯带映射驱动`（`RGB rgb(0);` 后） | 翻译型（类名已自描述） | 删除 |
| 6 | main.cpp | 23 | `// 基于 CAN1 高速控制局域网接管骨架的核心机械大脑实例对象`（`DummyRobot dummy(&hcan1);` 后） | 翻译型（类名已自描述） | 删除 |
| 7 | main.cpp | ~105 | `// 限定在 100Hz 时隙施加对应特性的谐振测试频标指令`（TUNING case） | 翻译型（代码 `% 50 == 0` 自描述） | 删除 |
| 8 | main.cpp | ~115 | `// 限流强下发频宽为 100Hz 不做冗余位姿修调直接发至驱动环中枢`（TRQ case） | 翻译型（代码 `% 50 == 0` 自描述） | 删除 |
| 9 | main.cpp | ~157 | `// 为不同操控模式配备醒目四字头简称索引标尺`（cmdModeNames 数组前） | 翻译型（变量名+字面量已自描述） | 删除 |
| 10 | can_protocol.cpp | 36 | `// Used for response CAN message.`（`txHeader` 静态变量前） | 英文翻译型（变量名已自描述） | 删除 |
| 11 | can_protocol.cpp | 100 | `// Common CAN message callback, uses ID 32~0x7FF.`（函数体首行） | 英文翻译型（函数名已自描述） | 删除 |
| 12 | can_protocol.cpp | 102 | `uint8_t id = rxHeader->StdId >> 7; // 7Bits ID (0~127)` | 翻译型（移位操作自描述） | 删除 |
| 13 | can_protocol.cpp | 119 | `// 更新地轨位置（角度 → mm）`（`dummy.currentRailPos = ...` 前） | 翻译型（赋值自描述） | 删除 |
| 14 | ascii_protocol.cpp | 311 | `/* 打印当前关节角和末端位姿（调试用） */`（`PRINTPOSE` 分支内） | 调试残留标签 | 删除 |
| 15 | ascii_protocol.cpp | 444 | `/* 新命令: 一次性设置 4 个 PID 参数 */`（USB `SET_PID` 分支内） | 翻译型（命令名+参数已自描述） | 删除 |
| 16 | ascii_protocol.cpp | 482 | `/* 新命令: 一次性设置 4 个 PID 参数 */`（UART4 `SET_PID` 分支内，同 15） | 翻译型（同 15） | 删除 |
| 17 | cmd_protocol.cpp | 17 | `/*just AN test for how to add a new CLI command through fibre protocol*/`（`GetVoltageHelper` 上） | 测试残留注释（debug-only） | 删除 |
| 18 | dummy_robot.cpp | 234 | `// 未来可用于区分哪个电机堵转并做针对性处理`（`(void)motorIndex;` 后） | 过期 FIXME/占位 | 删除 |
| 19 | dummy_robot.cpp | 263 | `// 使用 motorJ[1] 作为 CAN 总线发送口`（BroadcastUnlock 内 `motorJ[1]->BroadcastUnlock()` 前） | 翻译型（变量名已自描述） | 删除 |
| 20 | ctrl_step.cpp | ~33 | `// Int to Bytes`（`SetEnable` 内 `uint32_t val = _enable ? 1 : 0;` 前） | 翻译型（位转换自描述） | 删除 |
| 21 | ctrl_step.cpp | ~49 | `// Int to Bytes`（`SetEnableTemp` 内） | 翻译型（同 20） | 删除 |
| 22 | ctrl_step.cpp | ~63 | `// Float to Bytes`（`SetCurrentSetPoint` 内） | 翻译型（位转换自描述） | 删除 |
| 23 | ctrl_step.cpp | ~79 | `// Float to Bytes`（`SetVelocitySetPoint` 内） | 翻译型（同 22） | 删除 |
| 24 | ctrl_step.cpp | ~93 | `// Float to Bytes`（`SetPositionSetPoint` 内） | 翻译型（同 22） | 删除 |
| 25 | ctrl_step.cpp | ~95 | `// Need ACK`（`canBuf[4] = 1;` 后） | 翻译型（赋值自描述） | 删除 |
| 26 | ctrl_step.cpp | ~132 | `// Int to Bytes`（`SetNodeID` 内） | 翻译型（同 20） | 删除 |
| 27 | ctrl_step.cpp | ~134 | `// Need save to EEPROM or not`（`canBuf[4] = 1;` 后） | 翻译型（赋值自描述） | 删除 |
| 28 | ctrl_step.cpp | ~144 | `// Float to Bytes`（`SetCurrentLimit` 内） | 翻译型（同 22） | 删除 |
| 29 | ctrl_step.cpp | ~157 | `// Float to Bytes`（`SetCurrentLimit_persist` 内） | 翻译型（同 22） | 删除 |
| 30 | ctrl_step.cpp | ~173 | `// Float to Bytes`（`SetVelocityLimit` 内） | 翻译型（同 22） | 删除 |

## 红线保留（不删）

按"必须保留 6 条"逐项核对：

1. **决策标签** `[F1]` `[F2]` `[F4]` `[PID 修复]` `[A1]` `[A3]` `[A4]` `[v3.1]` `[v3.2]` `[v2.6]` `[v2.7]` `[v2.8]` `[Bug1]` `[Bug-11]` `[9-14]` 等 — 全部保留
2. **commit hash 引用** `21dbc16` `f3623ca` `77afa80` — 全部保留
3. **行为约束/副作用警告** 含 `⚠️` / `注意：` / `依赖` / `必须` / `enable 后第一帧` / `依赖 0x23 回包` 等 — 全部保留
4. **ISR/线程/共享变量约束** `volatile` 数组旁"原子单字节写"、`先清 pending 再读 tmp` 等访问顺序约束 — 全部保留
5. **公开 API 注释** `.h` / `.hpp` 中 Doxygen 风格 `///` `/** */` — 全部保留
6. **文件顶部 banner / 版权** 长块（如 `/* ===== xxx ===== */`） — 全部保留

## 块状分隔 banner（保留）

- `// ===== CAN 接收 =====`
- `// ── J7/地轨电机 ... ──`
- `// ── 臂关节电机 ... ──`
- `// ── 夹爪电机 ... ──`
- `// 步骤 1：...` `// 步骤 2：...` 等算法步骤标记

## 函数顶部 Doxygen（保留）

- main.cpp: `/** @brief ... @note ... */` 等所有 5 个线程函数顶部注释
- dummy_robot.cpp: 每个 public 函数的 `/** @brief */` 注释
- dummy_robot.h / ctrl_step.hpp: 所有 `/** */` 文档块

## 跳过文件（无候选）

- `dummy_robot.h` — 所有 `//` 注释均为：单位提示（mm / A / 度）/ 决策标签 / banner / 索引映射说明。无可删项。
- `ctrl_step.hpp` — 所有 `//` 注释均为：变量含义标注（angle 是从 CAN 0x23 回包）/ API 行为标注 / 决策标签。无可删项。
