Liu3Beng-A/Dummy/DummyRobot_URDF/meshes/light.stl

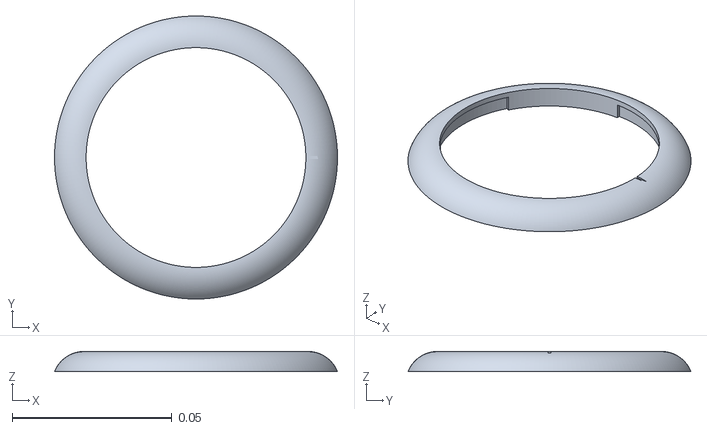
[picture p7: CAD file, 2026-10-13]
DummyRobot_URDF/meshes/light.stl
0.0886 x 0.0886 x 0.00633
