Liu3Beng-A/Dummy/Dummy上位机/resources/models/DummyRobot_URDF/meshes/base_rail_control.stl

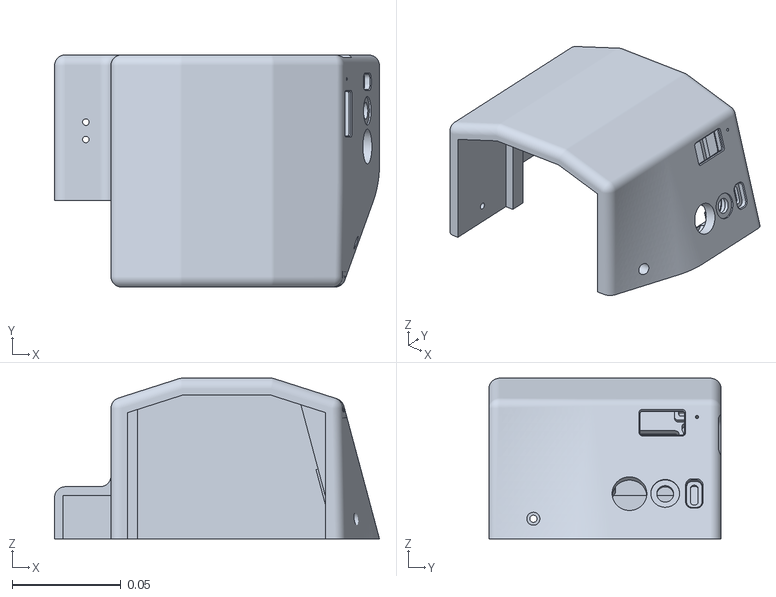
[picture p8: CAD file, 2026-10-17]
Dummy上位机/resources/models/DummyRobot_URDF/meshes/base_rail_control.stl
0.15 x 0.107 x 0.074
