Liu3Beng-A/Dummy/DummyRobot_URDF/meshes/Link5.STL

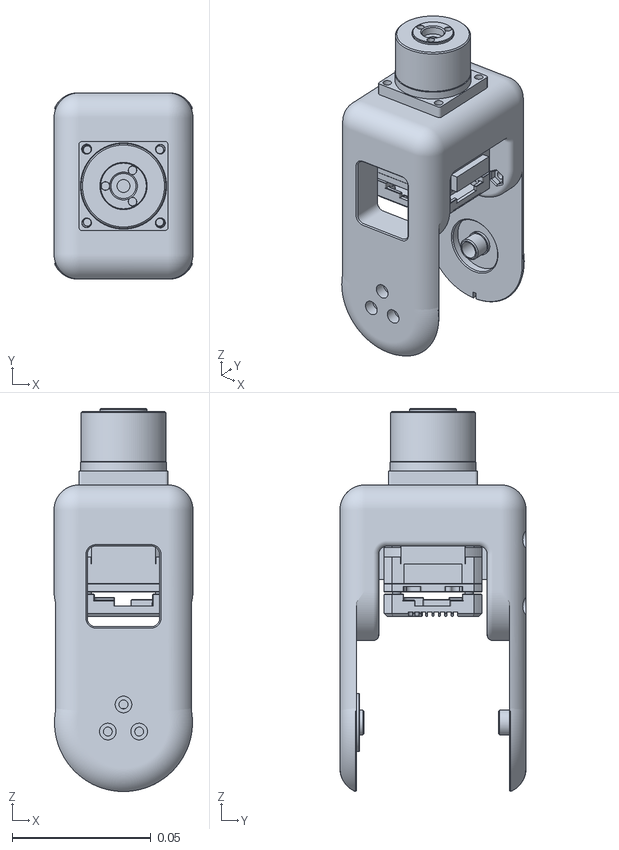
[picture p9: CAD file, 2026-10-11]
DummyRobot_URDF/meshes/Link5.STL
0.05 x 0.067 x 0.138
