Liu3Beng-A/Dummy/Dummy上位机/resources/models/DummyRobot_URDF/meshes/base_rail.STL

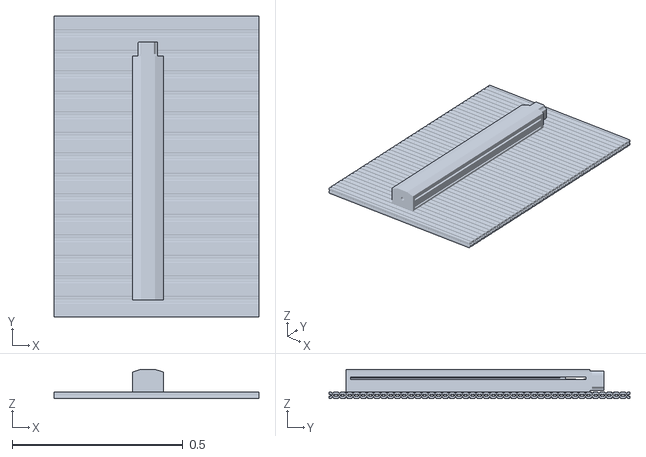
[picture p10: CAD file, 2026-10-17]
Dummy上位机/resources/models/DummyRobot_URDF/meshes/base_rail.STL
0.6 x 0.88 x 0.086
