Liu3Beng-A/Dummy/DummyRobot_URDF/meshes/Hand_R.STL

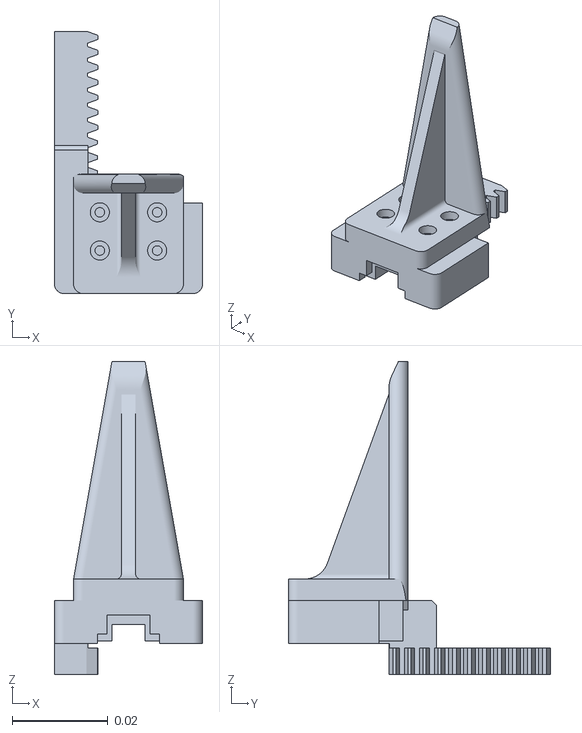
[picture p11: CAD file, 2026-10-11]
DummyRobot_URDF/meshes/Hand_R.STL
0.031 x 0.0549 x 0.0655
