Liu3Beng-A/Dummy/Dummy上位机/resources/models/DummyRobot_URDF/meshes/base_link.STL

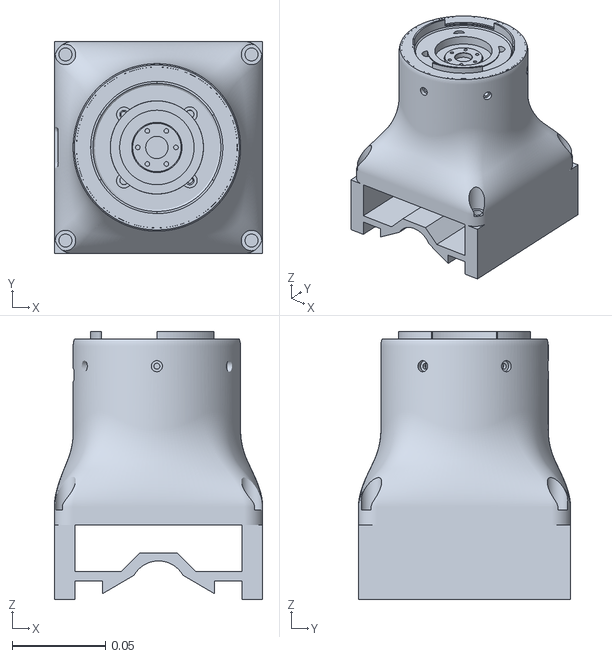
[picture p12: CAD file, 2026-10-13]
Dummy上位机/resources/models/DummyRobot_URDF/meshes/base_link.STL
0.112 x 0.114 x 0.144
