Liu3Beng-A/Dummy/DummyRobot_URDF/meshes/Link2.STL

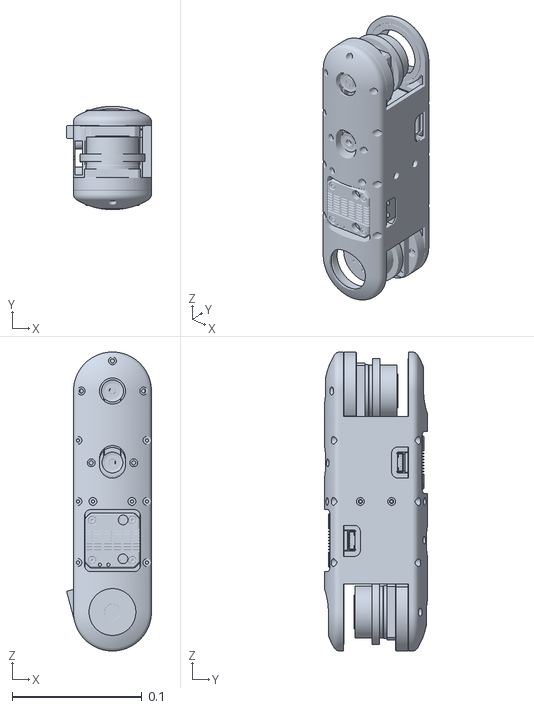
[picture p13: CAD file, 2026-10-11]
DummyRobot_URDF/meshes/Link2.STL
0.0653 x 0.0795 x 0.23
