Liu3Beng-A/Dummy/Dummy上位机/resources/models/DummyRobot_URDF/meshes/Hand_L.STL

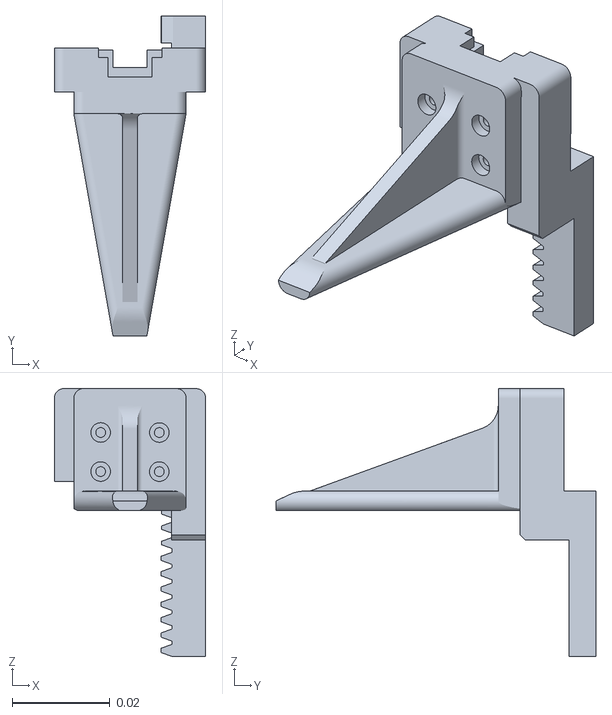
[picture p14: CAD file, 2026-10-11]
Dummy上位机/resources/models/DummyRobot_URDF/meshes/Hand_L.STL
0.031 x 0.0655 x 0.0549
