Liu3Beng-A/Dummy/DummyRobot_URDF/meshes/base_link.STL

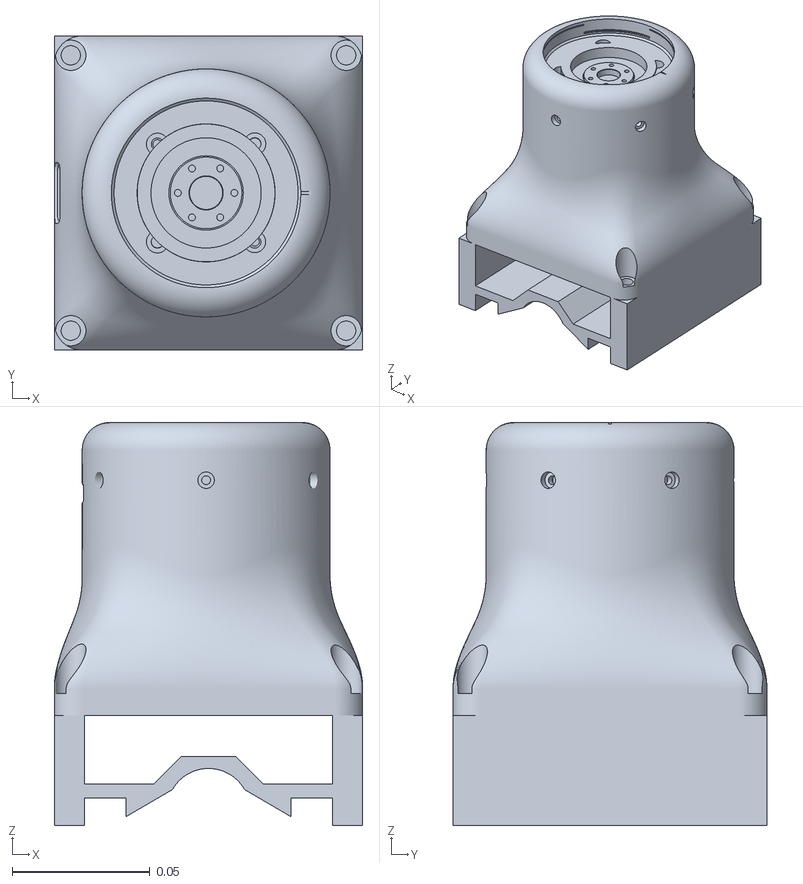
[picture p15: CAD file, 2026-10-11]
DummyRobot_URDF/meshes/base_link.STL
0.112 x 0.114 x 0.146
