Liu3Beng-A/Dummy/DummyRobot_URDF/meshes/Link3.STL

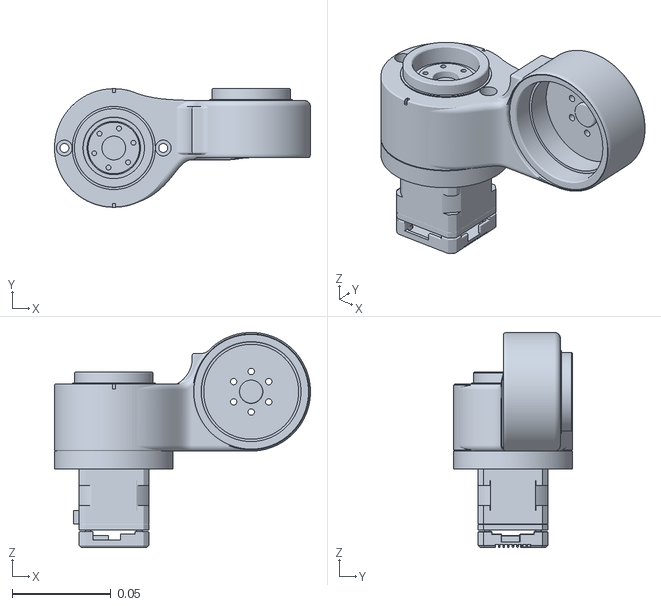
[picture p16: CAD file, 2026-10-11]
DummyRobot_URDF/meshes/Link3.STL
0.129 x 0.06 x 0.109
