Liu3Beng-A/Dummy/Dummy上位机/resources/models/DummyRobot_URDF/meshes/Link4.STL

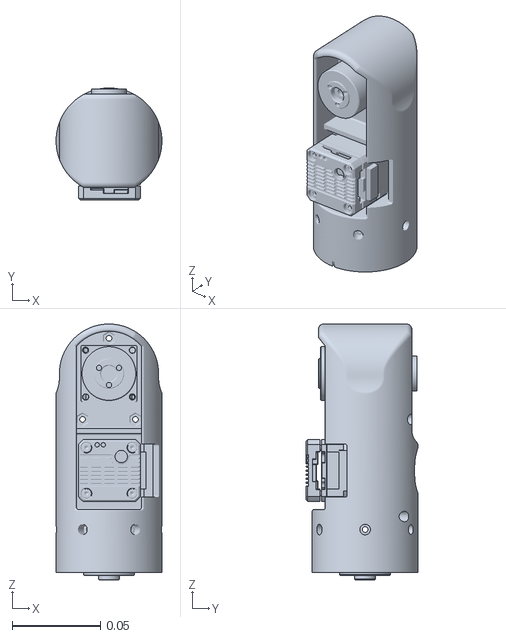
[picture p17: CAD file, 2026-10-11]
Dummy上位机/resources/models/DummyRobot_URDF/meshes/Link4.STL
0.06 x 0.0635 x 0.145
