Liu3Beng-A/Dummy/DummyRobot_URDF/meshes/Link6.STL

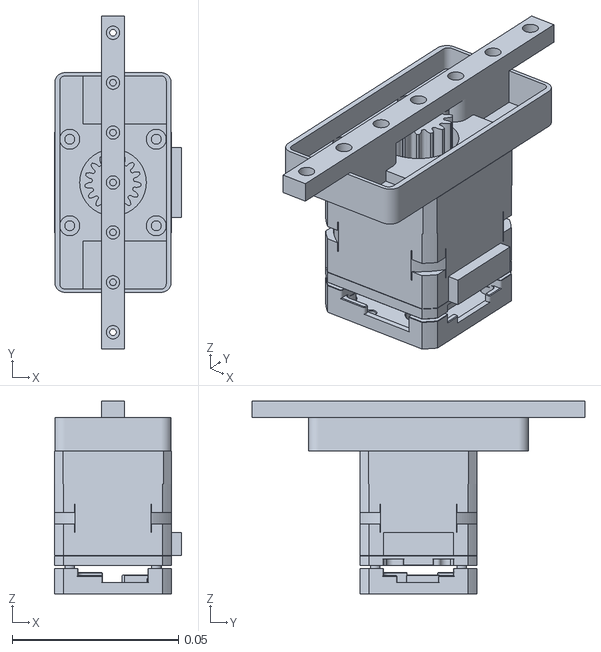
[picture p18: CAD file, 2026-10-11]
DummyRobot_URDF/meshes/Link6.STL
0.0382 x 0.1 x 0.058
