Liu3Beng-A/Dummy/DummyRobot_URDF/meshes/base_rail.STL

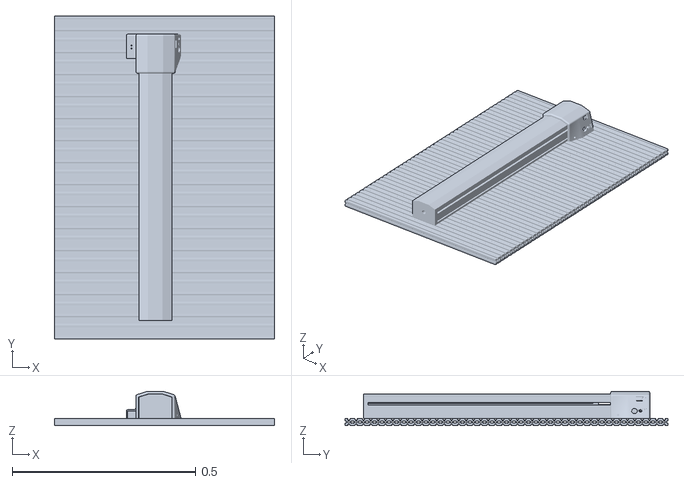
[picture p19: CAD file, 2026-10-11]
DummyRobot_URDF/meshes/base_rail.STL
0.6 x 0.88 x 0.094
