Liu3Beng-A/Dummy/DummyRobot_URDF/meshes/Link1.STL

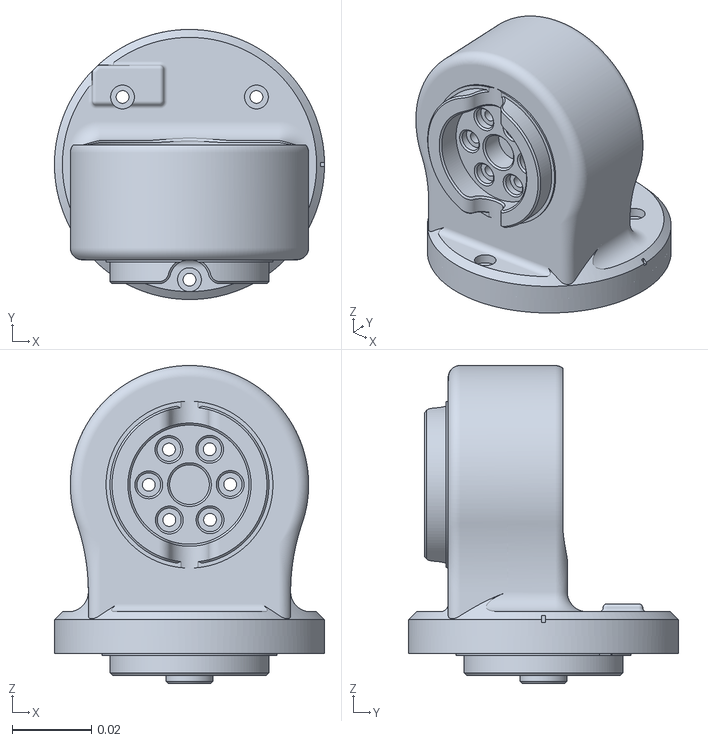
[picture p20: CAD file, 2026-10-11]
DummyRobot_URDF/meshes/Link1.STL
0.068 x 0.068 x 0.0801
