Liu3Beng-A/Dummy/(list of files, cad)

Other CAD files:
Dummy上位机/resources/models/DummyRobot_URDF/meshes/Link5.STL
DummyRobot_URDF/meshes/Hand_L.STL
Dummy上位机/resources/models/DummyRobot_URDF/meshes/Hand_R.STL
Dummy上位机/resources/models/DummyRobot_URDF/meshes/Link3.STL
DummyRobot_URDF/meshes/Link4.STL
Dummy上位机/resources/models/DummyRobot_URDF/meshes/Link2.STL
Dummy上位机/resources/models/DummyRobot_URDF/meshes/Link6.STL
Dummy上位机/resources/models/DummyRobot_URDF/meshes/Link1.STL
