Liu3Beng-A/Dummy/build_output.txt

ninja : ninja: warning: premature end of file; recovering
所在位置 C:\Users\Liu3Beng\AppData\Local\Temp\ps-script-1a312636-63df-404e-88ae-8156c218855e.ps1:119 字符: 60
+ ... tion 'E:\Dummy-code\firmware\ref_core_f405\build'; ninja 2>&1 | Tee-O ...
+                                                        ~~~~~~~~~~
    + CategoryInfo          : NotSpecified: (ninja: warning:...ile; recovering:String) [], RemoteException
    + FullyQualifiedErrorId : NativeCommandError
 
[1/48] Building C object CMakeFiles/Core-STM32F4-fw.elf.dir/Middlewares/Third_Party/FreeRTOS/Source/list.c.obj
[2/48] Building C object CMakeFiles/Core-STM32F4-fw.elf.dir/Middlewares/Third_Party/FreeRTOS/Source/portable/GCC/ARM_CM4F/port.c.obj
[3/48] Building C object CMakeFiles/Core-STM32F4-fw.elf.dir/Middlewares/Third_Party/FreeRTOS/Source/croutine.c.obj
[4/48] Building C object CMakeFiles/Core-STM32F4-fw.elf.dir/Middlewares/Third_Party/FreeRTOS/Source/portable/MemMang/heap_4.c.obj
[5/48] Building C object CMakeFiles/Core-STM32F4-fw.elf.dir/Middlewares/Third_Party/FreeRTOS/Source/event_groups.c.obj
[6/48] Building C object CMakeFiles/Core-STM32F4-fw.elf.dir/Middlewares/Third_Party/FreeRTOS/Source/queue.c.obj
[7/48] Building C object CMakeFiles/Core-STM32F4-fw.elf.dir/Middlewares/ST/STM32_USB_Device_Library/Core/Src/usbd_ioreq.c.obj
[8/48] Building C object CMakeFiles/Core-STM32F4-fw.elf.dir/Drivers/STM32F4xx_HAL_Driver/Src/stm32f4xx_hal.c.obj
[9/48] Building C object CMakeFiles/Core-STM32F4-fw.elf.dir/Drivers/STM32F4xx_HAL_Driver/Src/stm32f4xx_hal_rcc_ex.c.obj
[10/48] Building C object CMakeFiles/Core-STM32F4-fw.elf.dir/Middlewares/Third_Party/FreeRTOS/Source/stream_buffer.c.obj
[11/48] Building C object CMakeFiles/Core-STM32F4-fw.elf.dir/Drivers/STM32F4xx_HAL_Driver/Src/stm32f4xx_hal_pwr_ex.c.obj
[12/48] Building C object CMakeFiles/Core-STM32F4-fw.elf.dir/Middlewares/ST/STM32_USB_Device_Library/Core/Src/usbd_core.c.obj
[13/48] Building C object CMakeFiles/Core-STM32F4-fw.elf.dir/Middlewares/ST/STM32_USB_Device_Library/Core/Src/usbd_ctlreq.c.obj
[14/48] Building C object CMakeFiles/Core-STM32F4-fw.elf.dir/Middlewares/Third_Party/FreeRTOS/Source/timers.c.obj
[15/48] Building C object CMakeFiles/Core-STM32F4-fw.elf.dir/Drivers/STM32F4xx_HAL_Driver/Src/stm32f4xx_hal_exti.c.obj
[16/48] Building C object CMakeFiles/Core-STM32F4-fw.elf.dir/Drivers/STM32F4xx_HAL_Driver/Src/stm32f4xx_hal_flash.c.obj
[17/48] Building C object CMakeFiles/Core-STM32F4-fw.elf.dir/Drivers/STM32F4xx_HAL_Driver/Src/stm32f4xx_hal_gpio.c.obj
[18/48] Building C object CMakeFiles/Core-STM32F4-fw.elf.dir/Drivers/STM32F4xx_HAL_Driver/Src/stm32f4xx_hal_flash_ex.c.obj
[19/48] Building C object CMakeFiles/Core-STM32F4-fw.elf.dir/Middlewares/ST/STM32_USB_Device_Library/Class/CDC/Src/usbd_cdc.c.obj
[20/48] Building C object CMakeFiles/Core-STM32F4-fw.elf.dir/Drivers/STM32F4xx_HAL_Driver/Src/stm32f4xx_hal_rcc.c.obj
[21/48] Building C object CMakeFiles/Core-STM32F4-fw.elf.dir/USB_DEVICE/App/usb_device.c.obj
[22/48] Building C object CMakeFiles/Core-STM32F4-fw.elf.dir/Drivers/STM32F4xx_HAL_Driver/Src/stm32f4xx_hal_pcd.c.obj
[23/48] Building C object CMakeFiles/Core-STM32F4-fw.elf.dir/Drivers/STM32F4xx_HAL_Driver/Src/stm32f4xx_ll_usb.c.obj
[24/48] Building C object CMakeFiles/Core-STM32F4-fw.elf.dir/Drivers/STM32F4xx_HAL_Driver/Src/stm32f4xx_hal_tim_ex.c.obj
[25/48] Building C object CMakeFiles/Core-STM32F4-fw.elf.dir/Drivers/STM32F4xx_HAL_Driver/Src/stm32f4xx_hal_uart.c.obj
[26/48] Building C object CMakeFiles/Core-STM32F4-fw.elf.dir/Middlewares/Third_Party/FreeRTOS/Source/CMSIS_RTOS_V2/cmsis_os2.c.obj
[27/48] Building C object CMakeFiles/Core-STM32F4-fw.elf.dir/Middlewares/Third_Party/FreeRTOS/Source/tasks.c.obj
[28/48] Building C object CMakeFiles/Core-STM32F4-fw.elf.dir/Robot/actuators/mintasca/sca_protocol.c.obj
[29/48] Building C object CMakeFiles/Core-STM32F4-fw.elf.dir/Drivers/STM32F4xx_HAL_Driver/Src/stm32f4xx_hal_spi.c.obj
[30/48] Building C object CMakeFiles/Core-STM32F4-fw.elf.dir/UserApp/joint_reader_stub.c.obj
[31/48] Building C object CMakeFiles/Core-STM32F4-fw.elf.dir/USB_DEVICE/App/usbd_cdc_if.c.obj
[32/48] Building C object CMakeFiles/Core-STM32F4-fw.elf.dir/USB_DEVICE/App/usbd_desc.c.obj
[33/48] Building ASM object CMakeFiles/Core-STM32F4-fw.elf.dir/startup/startup_stm32f405xx.s.obj
[34/48] Building C object CMakeFiles/Core-STM32F4-fw.elf.dir/USB_DEVICE/Target/usbd_conf.c.obj
[35/48] Building CXX object CMakeFiles/Core-STM32F4-fw.elf.dir/UserApp/pose_sender_task.cpp.obj
[36/48] Building CXX object CMakeFiles/Core-STM32F4-fw.elf.dir/UserApp/comm_pose_uart.cpp.obj
[37/48] Building C object CMakeFiles/Core-STM32F4-fw.elf.dir/Drivers/STM32F4xx_HAL_Driver/Src/stm32f4xx_hal_tim.c.obj
[38/48] Building C object CMakeFiles/Core-STM32F4-fw.elf.dir/Drivers/STM32F4xx_HAL_Driver/Src/stm32f4xx_hal_i2c.c.obj
[39/48] Building C object CMakeFiles/Core-STM32F4-fw.elf.dir/Robot/actuators/mintasca/sca_api.c.obj
[40/48] Building CXX object CMakeFiles/Core-STM32F4-fw.elf.dir/Robot/algorithms/kinematic/6dof_kinematic.cpp.obj
[41/48] Building CXX object CMakeFiles/Core-STM32F4-fw.elf.dir/Robot/actuators/mintasca/sca.cpp.obj
[42/48] Building CXX object CMakeFiles/Core-STM32F4-fw.elf.dir/Robot/actuators/ctrl_step/ctrl_step.cpp.obj
[43/48] Building CXX object CMakeFiles/Core-STM32F4-fw.elf.dir/UserApp/protocols/can_protocol.cpp.obj
[44/48] Building CXX object CMakeFiles/Core-STM32F4-fw.elf.dir/UserApp/main.cpp.obj
[45/48] Building CXX object CMakeFiles/Core-STM32F4-fw.elf.dir/Robot/instances/dummy_robot.cpp.obj
[46/48] Building CXX object CMakeFiles/Core-STM32F4-fw.elf.dir/UserApp/protocols/ascii_protocol.cpp.obj
[47/48] Building CXX object CMakeFiles/Core-STM32F4-fw.elf.dir/UserApp/protocols/cmd_protocol.cpp.obj
[48/48] Linking CXX executable Core-STM32F4-fw.elf; Building E:/Dummy-code/firmware/ref_core_f405/build/Core-STM32F4-fw.hex / Building E:/Dummy-code/firmware/ref_core_f405/build/Core-STM32F4-fw.bin
C:/Program Files (x86)/Arm/GNU Toolchain mingw-w64-i686-arm-none-eabi/bin/../lib/gcc/arm-none-eabi/15.2.1/../../../../arm-none-eabi/bin/ld.exe: warning: Core-STM32F4-fw.elf has a LOAD segment with RWX permissions
Memory region         Used Size  Region Size  %age Used
             RAM:       53320 B       128 KB     40.68%
          CCMRAM:         64 KB        64 KB    100.00%
           FLASH:      385212 B         1 MB     36.74%
