Liu3Beng-A/Dummy/(commit log)

2026-05-19 Initial commit: STM32F4 Dummy robot firmware
    [stlink.cfg]
2026-05-19 同步-260803
2026-08-03 串口助手: refine pure-digit line filtering, fix !RGB_BRIGHT query response loss
    The previous logic unconditionally filtered every pure-digit RX line, which
    suppressed both !RGB_BRIGHT query response ("100") and the queue free-size
    ack ("15") alike, making the query button appear unresponsive.
    Now only pure-digit lines arriving within a 1s window after an enqueue
    command (>/@/&/$ start) are suppressed. Other queries (e.g. !RGB_BRIGHT,
    SPEED_RAIL, ACC_RAIL) show their responses normally.
    - __init__: add _expect_queue_reply / _queue_reply_deadline_ms
    - send_cmd: detect enqueue command prefix and start the suppression window
    - serial_receive_loop: suppress pure-digit only inside the active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
    [串口助手.py]
2026-08-06 docs(refactor): 加 REFACTOR_PLAN.md 任务规划
    REFACTOR_DEMANDS.md 记录了需求背景、用户决策、开放问题。
    本文档固化需求为可执行的工程任务清单：
    - 10 个有效任务（T1~T7 + T9~T11，T8 已并入 T6）
    - 每个任务有：文件、改动量、风险、依赖、回滚方式、模板代码
    - 关键风险：EEPROM 字段删除（T10）、SetAcceleration 签名变化（T3）
    - 推荐执行顺序：电机固件 → 主控底层 → ASCII → CAN → 删除字段 → 烧录测试 → 串口助手
    - 与 REFACTOR_DEMANDS.md 字段 ID 一一对应
    基于 2026-08-07 01:21 用户最终决策（最大速度和主控基础加速度留着不动）。
    Co-authored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
2026-08-12 refactor(motor-fw): 加 0x2C 处理（查询加速度）
    电机固件加 CAN 命令 0x2C：查询当前加速度值。
    - 4 份固件同步（35/42/57/gripper）
    - 返回 boardConfig.velocityAcc / MOTOR_ONE_CIRCLE_SUBDIVIDE_STEPS（圈/s²）
    - 与 REFACTOR_PLAN.md T1 对应
    - 编译验证：4 份全部 0 errors
    [interface_can.cpp]
2026-08-12 refactor(motor-fw): 加 0x2D 处理（查询电流）
    电机固件加 CAN 命令 0x2D：查询当前电流限幅值。
    - 返回 boardConfig.currentLimit / 1000.0f（A）
    - 与 REFACTOR_PLAN.md T2 对应
    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
    [interface_can.cpp]
2026-08-12 refactor(core): 加 SetAcceleration/SetCurrentLimit persist + Query 0x2C/0x2D
    底层电机封装扩展：
    - SetCurrentLimit(float) - 默认写 EEPROM（兼容 fiber 协议）
    - SetCurrentLimit_persist(float, bool) - 可控制是否写 EEPROM
    - SetAcceleration(float) - 默认不写 EEPROM
    - SetAcceleration_persist(float, bool) - 可控制是否写 EEPROM
    - QueryCurrentLimit() - 发送 CAN 0x2D
    - QueryAcceleration() - 发送 CAN 0x2C
    DummyRobot 改动：
    - SetJointAcceleration 改用 _persist 版本（不写 EEPROM）
    - 删除 railAcc_mm_s2 字段和 SetRailAcc 函数
    - MoveRail 不再用 railAcc_mm_s2/5（加速度由 #ACC_RAIL 单独下发）
    - Config 结构删除 railAcc_mm_s2
    对应 REFA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
2026-08-12 refactor(core): ASCII 加 #GETJACC/#GETI、& 持久化、CAN 响应 0x2C/0x2D
    ASCII 协议扩展：
    - 加 #GETJACC <node> - 查询节点当前加速度（发 CAN 0x2C）
    - 加 #GETI <node> - 查询节点当前电流限制（发 CAN 0x2D）
    - #ACC_J <node> <acc> [\&] - 支持 8/9 节点（夹爪/地轨）和 & 持久化
    - #I_LIMIT_J <node> <i> [\&] - 支持 & 持久化
    - #ACC_RAIL - 改用 motorJ[0]->SetAcceleration_persist，不再依赖 railAcc_mm_s2
    CAN 协议扩展：
    - 响应 0x2C: 打印 "[ACC] MOTOR [N] = X.XX"
    - 响应 0x2D: 打印 "[I_LIMIT] MOTOR [N] = X.XX"
    对应 REFACTOR_PLAN.md T5+T6+T7+T9
    编译验证：主控 0 errors
    [ascii_protocol.cpp, can_protocol.cpp]
2026-08-12 refactor(serial-assistant): 加 UI1~UI4 - 智能查询、状态指示、失能检查
    UI1+UI2 - 自动查询:
    - 发 #ACC_J/#I_LIMIT_J 后，自动记节点
    - 收到 [ACC]/[I_LIMIT] 后 0.5s 自动发 #GETJACC/#GETI
    - 无需手动查回，UI 流直接反馈设置值
    UI3 - 按钮改新命令:
    - "查加速度" 改用 #GETJACC（之前用 #ACC_BASE_J 错误）
    - "查电流" 改用 #GETI（之前用 #I_LIMIT_J 错误）
    - query_rail_acc/current 改用 #GETJACC 9/#GETI 9
    UI4 - 安全保护:
    - 系统栏加电机使能状态指示（绿色=已使能/灰色=已失能）
    - 启动/失能按钮同步状态
    - 设置电流限制（send_i_limit）时若已使能则弹窗警告并阻止
    对应 REFACTOR_PL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
2026-08-12 fix(gripper): 夹爪id=8补全CAN回包case + ASCII命令支持
    - can_protocol.cpp: 夹爪id==8分支补全0x2C/0x2D/0x28~0x2B/0x7C case
    (此前只有0x23/0x25，其他全部default丢弃)
    - ascii_protocol.cpp: #GET_PID 和 #SET_DCE_KV/KP/KI/KD 加 node==8 分支
    (此前不发起CAN请求)
    - 串口助手.py: send_acc_base/send_i_limit 放开 8/9 限制
    (此前UI只允许1~6)
    关联硬件故障：原夹爪控制板(MT6816磁编/TB67H450)损坏，
    物理替换为J6控制板后功能正常。
    [ascii_protocol.cpp, can_protocol.cpp, 串口助手.py]
2026-08-13 fix(core): PID 设置/查询重构 - 合并回包、SET_PID 新命令、node=9 修复
    [ascii_protocol.cpp, can_protocol.cpp, 串口助手.py]
2026-08-13 fix(serial-assistant): PID 窗口增加默认参数说明标签
2026-08-13 fix(serial-assistant): 更新实测 PID 参数（节点3/4/5/6/8/9）
    [串口助手.py]
2026-08-13 地轨重构：5:1减速箱适配 + 速度上限30mm/s
    - motorJ[0] 增加减速比参数 1→5（5:1减速箱）
    - RAIL_STEPS_PER_MM 改 204800（200×256×5 / 5mm）
    - railSpeed_mm_s 默认 50→15，限幅上限 100→30
    - MoveRail 注释更新：mm→电机圈数 = _railPos_mm（数值不变，但单位语义修正）
    - 串口助手 UI 速度范围 0.5~100 改 0.5~30，默认 50 改 15
    [dummy_robot.cpp, dummy_robot.h, 串口助手.py]
2026-08-13 fix(rail): MoveRail 不再每帧覆盖用户设定的加速度
    问题：MoveRail() 每次都下发 CAN 0x14 (acc=100 圈/s²)，
    导致用户通过 #ACC_RAIL 设置的加速度被覆盖回 100，
    #ACC_RAIL 实际只在下发当帧生效。
    修复：删除 MoveRail() 中的 SetAcceleration(100) 调用，
    让电机固件使用 #ACC_RAIL 时持久化到 ratedVelocityAcc 的值。
    行为对照：
    - #ACC_RAIL X → 电机0x14 立即更新 tracker（RAM）
    - #ACC_RAIL X & → 电机0x14 立即更新 + 写 EEPROM
    - 后续 MoveRail() 不再覆盖，电机按已保存值加减速
    [dummy_robot.cpp]
2026-08-18 fix(rail): 回退5:1减速箱适配，恢复地轨直驱配置
    地轨改回直驱（去掉5:1减速箱），撤销 27e28d1 的所有改动：
    - motorJ[0] 减速比参数 5→1（直连丝杆1605）
    - RAIL_STEPS_PER_MM 改回 40960
    - railSpeed_mm_s 默认 15→50，上限 30→100
    - MoveRail 注释和公式简化：mm → 圈 改回直驱版（/5.0f）
    - SetRailSpeed 限幅上限 30→100
    - 串口助手 UI 速度范围 0.5~30 改回 0.5~100，默认 15 改回 50
    保留 b91220f 的加速度修复（MoveRail 不再每帧下发 0x14 覆盖用户设定的加速度），
    该修复与减速比无关，仅作用于加速度下发逻辑。
    C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
    [dummy_robot.cpp, dummy_robot.h, 串口助手.py]
2026-08-19 chore: 地轨推荐值表+说明横排, 滑块默认30, 夹爪固件更新, 合并md文档
    - 串口助手.py: 电流/加速度推荐值表调整为紧凑版,右侧说明横排;地轨加速度默认30,范围1~200
    - 夹爪独立固件(motor_fw_f103_gripper): CAN回包补全, ASCII命令支持
    - 合并冗余md: 7DOF冗余机械臂逆解方案.md, 重构方案系列(ROS2/参数重构经验/需求)
    - 删除: REFACTOR_DEMANDS.md, REFACTOR_PLAN.md, docs/UART_TIMEOUT_INVESTIGATION.md, dummy_robot.cpp.diff, 地轨扩展与CAN广播协议修改说明.md, firmware/ref_core_f405/doc/rail_sync_plan_B.md
    - PROJECT_CONTEXT.md: 更新rail_sync_plan_B.md已合并提示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
    [configurations.h]
2026-08-22 docs: 堵转重构需求方案 + source code 排除入库
    - .gitignore: source code/（二次开发参考源码备份，不入库）
    - ISSUES.md: +5.5 节 堵转重构专项遗漏 C-1~C-21
    - 新增 重构方案—堵转检测重构需求.md（2759 行）
    · 60 项决策（Q1-Q10 + #1-#60）
    · 50 项遗漏（附录 E.1-E.25）
    · 19 项测试清单
    · 附录 F 远程控制堵转开关功能（12 子节，7 测试项）
    - 新增 重构方案—MoveJ速度与同步抵达—重构需求.md（下一阶段）
    回退说明：之前未提交的 11 个文件改动（0x1C + isStallMode + 串口助手 UI）
    属于本次重构前的初步尝试，不符合重构目标，已 restore。
    新方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
2026-08-22 fix(stall-protect): 上电默认开启 + 不写 EEPROM + SetEnable 自动恢复 (F.6)
    - main.cpp ×3: stallProtectSwitch 强制设为 true（覆盖 EEPROM 默认值）
    - interface_can.cpp ×3: 0x1B 处理默认不写 EEPROM（仅 _data[4]==1 才持久化）
    - ctrl_step.cpp: SetEnableStallProtect 默认 canBuf[4]=0（不持久化）
    - dummy_robot.cpp: SetEnable(true) 末尾自动发 !STALL_EN（重启后自动恢复）
    - 串口助手.py: 加 toggle 按钮（默认开启、不持久化）
    行为说明（F.6 temp_until_restart）：
    - 上电默认开启堵转保护
    - !STALL_DIS 仅本次会话有效
    - 重启或 !START 后自动恢复开启
    - 不写 EEPROM（除非显式 _data[4]==1）
    编译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
    [ctrl_step.cpp, dummy_robot.cpp, interface_can.cpp, main.cpp, 串口助手.py]
2026-08-22 docs: 记录阶段1完成 + 后续阶段计划（G.1-G.5）
    - G.1 实施阶段划分（4 个阶段）
    - G.2 阶段1完成记录（commit 2ed176a，9 文件改动，4 份固件编译通过）
    - G.3-G.5 后续阶段计划（待开始）
    用户决定暂不测试阶段1（"我暂时测试不了"），下次上电时再验证。
    继续推进阶段 2：电机端状态机（IDLE/RETREATING/LOCKED + 回退逻辑）。
2026-08-22 refactor(motor-h): 新增堵转状态机 StallConfig_t + StallMode_t enum (阶段2.1)
    - motor.h ×3: 新增 StallMode_t enum（IDLE/RETREATING/LOCKED）
    - motor.h ×3: 新增 StallConfig_t 结构（运行时 RAM，不进 EEPROM）
    - motor.h ×3: Motor 类新增 stallState 成员（默认 IDLE + enabled=true）
    - Controller::isStalled 保留作为兼容（指向 stallState.stallMode == STALL_LOCKED）
    为什么分两步：
    - 阶段2.1：仅添加字段，兼容现有逻辑（编译通过即可）
    - 阶段2.2-2.6：重写 stall 检测 + RETREATING 状态机 + LOCKED 分支
    编译验证（3 份电机固件）：
    - 35: RAM 39.88% / FLASH 54.64%
    - 42: RAM 39.88% / FLASH 54.64%
    - 57: RAM 39.88%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
    [motor.h]
2026-08-22 docs: 阶段2.1完成 + 阶段2.2-4计划（G.3细化）
    - G.3 阶段2 已开始
    - G.3.1 阶段2.1 完成（commit 4d98704，3 文件）
    - G.3.2 阶段2.2 待开始（motor.cpp 状态机实现）
    - G.3.3 阶段2.3 待开始（interface_can.cpp 命令处理）
    - G.3.4 阶段2.4 待开始（configurations + main 默认值）
    阶段2.2-2.4 工作量约 900+ 行新代码，超出本次会话空间。
    下次轮回继续推进。
2026-08-22 feat(stall-state-machine): 重写电机端堵转检测为 IDLE/RETREATING/LOCKED 状态机 (阶段2.2)
    替换原 if-switch 单段检测（~50 行），实现完整三态状态机：
    状态机流转：
    - STALL_IDLE: 电流 >= 阈值 && |vel| < 阈值 持续 200ms → 进入 RETREATING
    - STALL_RETREATING: 强制位置指令 = lastGoalPosition - direction × retreatSteps
    · 触发 LOCKED 条件：超时 2s 或 已回退到位（距离 < 1/10 圈）
    · 上报 0x7C data[1] = STALL_RETREATING
    - STALL_LOCKED: 保持位置，不发新指令
    · ClearIntegral 在 Ctrl Loop 入口处理（已有逻辑）
    · 上报 0x7C data[1] = STALL_LOCKED（一次性）
    新增字段（StallConfig_t 扩展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
    [main.cpp, motor.cpp, motor.h]
2026-08-22 feat(stall-state-machine): LOCKED 时拒绝新指令（阶段2.3）
    改造 interface_can.cpp OnCanCmd 入口：增加 LOCKED 状态拒绝检查
    拒绝规则：
    - stallState.stallMode == STALL_LOCKED 时
    - 除以下命令外全部拒绝（return 不处理）：
    · 0x01 Enable Motor（会清 stall flag）
    · 0x02 Do Calibration（用户主动触发）
    · 0x7E Erase Configs
    · 0x7F Reboot
    · 0x89 Broadcast Emergency Stop（急停优先）
    · 0x1B Set Stall Protect（用户开/关 stall 功能）
    含义：
    - 堵转后电机保持当前位置，不再响应任何位置/速度/电流指令
    - 用户可通过 0x01（enable）或 0x1B（关闭 stall）解锁
    - 急停命令（0x89）总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
    [interface_can.cpp]
2026-08-22 feat(stall-config): EEPROM 持久化堵转阈值参数 + 0x1D/0x1E 配置命令 (阶段2.4)
    新增 EEPROM 字段（configurations.h ×3）：
    - stallCurrentThreshold (int32_t, mA): 电流阈值，0 表示自动计算（ratedCurrent * 95%）
    - stallRetreatSteps (int32_t, 步数): 回退距离（35/42=711=5°, 57=40960=5mm）
    - stallDetectTimeMs (uint16_t, ms): 触发延迟（默认 200）
    - stallRetreatTimeMs (uint16_t, ms): 回退超时（默认 2000）
    main.cpp ×3 改造：
    - enableStallProtect 默认 true
    - 新增 4 个字段的初始化默认值
    - motor.stallState 从 boardConfig 读取配置
    interface_can.cpp ×3 新增命令：
    - 0x1D Set Stall Threshold (int32_t mA, _data[4]=1 写 E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
    [configurations.h]
2026-08-22 feat(stall-protect): 主控端 motorStallMask 管理 + ClearStallMode (阶段3)
    主控 dummy_robot.h 新增字段 + 方法：
    - motorStallMask[7]: 第 i 个电机当前是否 LOCKED（含地轨 motorJ[0]）
    - ClearStallMode(int idx = -1): 清除指定/全部电机 LOCKED
    - IsAnyMotorStalled(): 检查任一电机 LOCKED
    dummy_robot.cpp 改造：
    - SetStallMode(int) 支持单独电机 + 维护 mask
    - ClearStallMode 实现：清 mask 后若无任何电机 LOCKED → 恢复 RGB CYBER_BREATH
    - IsAnyMotorStalled 实现：循环检查 mask
    can_protocol.cpp 0x7C 三处改造：
    - nodeID=9 (地轨): data[1]==2 (STALL_LOCKED) → SetStallMode(0) / ClearStallMode(0)
    - nodeID=1~6 (关节): data[1]==2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
    [can_protocol.cpp, dummy_robot.cpp, dummy_robot.h]
2026-08-22 feat(stall-protect): 主控 stallProtectMask + !STALL_STATUS 查询 + 串口助手查询按钮 (阶段4)
    主控 dummy_robot.h 新增：
    - stallProtectMask[7]: 堵转保护启用配置（默认 true，不含夹爪）
    - SetStallProtect(int idx, bool enable): 设置单个电机堵转保护开关
    - QueryStallStatus(): 打印全部电机 enabled + LOCKED 状态
    dummy_robot.cpp 实现：
    - SetStallProtect: 更新 mask + 调用 CtrlStepMotor::SetEnableStallProtect
    - QueryStallStatus: 打印 ok STALL_STATUS rail_en=... ... rail_lock=...
    - SetEnable(true) 末尾同时更新 stallProtectMask
    ascii_protocol.cpp 新增命令：
    - !STALL_EN [idx] / !STALL_DIS [idx]: 支持单电机（idx: rail/j1~j6）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
    [ascii_protocol.cpp, dummy_robot.cpp, dummy_robot.h, 串口助手.py]
2026-08-22 docs: 标记重构全部完成（10 个 commit, 2026-08-23）
    完整 commit 历史：
    - eebb888 docs: 备份方案
    - 2ed176a feat: 阶段1 (F.6)
    - 783391c docs: 阶段1完成
    - 4d98704 refactor: 阶段2.1 (motor.h)
    - 72aae74 docs: 阶段2.1完成
    - c6b2423 feat: 阶段2.2 (motor.cpp 状态机)
    - 3a3213b feat: 阶段2.3 (LOCKED 拒绝指令)
    - e568556 feat: 阶段2.4 (EEPROM + 0x1D/0x1E)
    - e5ce78b feat: 阶段3 (主控 motorStallMask)
    - a817517 feat: 阶段4 (!STALL_STATUS + 串口助手)
    完整功能 16 项全部完成 ✅
    代码改动：电机 9 文件 / 主控 5 文件 / 串口助手 1 文件 / 文档 2 文件
    编译产物：4 份电机 + 主控 全部生成
    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
2026-08-23 fix(stall-protect): 修复 STALL_STATUS 阻塞 + 同步地轨不触发问题文档
    重构尾声 bug 修复：
    - interface_usb.cpp: process_packet 传 chunk 而非 length，避免后续分块
    重复处理整段
    - dummy_robot.{h,cpp}: QueryStallStatus 接受 StreamSink* 参数，走异步
    process_bytes 队列，避免 printf 同时写 USB + UART4 导致 RS485 总线
    半双工冲突，并消除 osDelay(20) 阻塞引起 OLED/RGB 看似卡住
    - ascii_protocol.cpp: 传 _responseChannel 给 QueryStallStatus
    - 串口助手.py: 查询堵转状态按钮改用 tk.Button(ttk.Button 不支持
    font 参数，保持与其他系统按钮风格一致)
    现象文档(用于下一阶段 D4 实施):
    - 重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
    [ascii_protocol.cpp, dummy_robot.cpp, dummy_robot.h, interface_usb.cpp, 串口助手.py]
2026-08-23 重构堵转检测：硬编码 D4 三件套 + 修复 LOCKED 自由坠落等 8 项问题
    按《重构方案—堵转检测重构需求.md》第17章 D4 方案 + Bug 全修思路，对
    35/42/57 三套电机固件与主控 ref_core_f405 实施一次性重构。
    ## 电机固件 (×3)
    ### 简化 StallConfig_t 字段
    - 删除: stallProtectSwitch, stalledTime, overloadTime, overloadFlag,
    enableTimestamp, everEnabled, lockEntryCleared, detectThresholdTime,
    retreatTimeoutTime, stallCurrentThreshold, stallVelocityThreshold,
    d4_pErrorThreshold, d4_isPoweringRatio, d4_commandingCurRatio,
    d4_startupGraceMs, useD4Logic
    - 保留 7 字段: enabled / stallMode / stallDetectTime / stallRetreatTime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
2026-08-23 重构堵转检测（firmware/ 5 套固件 + 1 个重构文档）
    - 保留 7 字段: enabled / stallMode / stallDetectTime / stallRetreatTime
    / lastGoalPosition /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
    [configurations.h]
2026-08-23 docs(stall): 修复 RAIL_STEPS_PER_MM 40960→10240 + 重构文档 v2.1 (Q1/Q2 决策)
    - PROJECT_CONTEXT.md: 修正 1mm 步数（40960 → 10240）
    用户实测 5mm 移动 = 1 圈 = 51200 步，1mm = 10240 步
    - 重构方案—堵转检测重构需求.md: v2.1 增量
    - Q1 决策 A1（用户拍板）：LOCKED 入口 ClearIntegral（替代早期 A2 草案）
    - Q2 决策：RETREATING→LOCKED 阈值 5120 步 → 5 步
    - 偏差-10/19/26：标记待实施（Q1 A1）
    - 1.3 节 Q7 + 2.3 时序图 + 2.4 保位机制 + 4.x 60 项表 同步更新
    - v2.1 变更日志
    🤖 Generated with Cursor
2026-08-23 feat(stall): LOCKED 入口 ClearIntegral (Q1 A1) + 5步阈值 (Q2) + 启动豁免期 100ms
    电机端 (35/42/57 三套同步)：
    - motor.cpp 顶部常量：
    - D4_IS_POWERING_RATIO: 25 → 75（1A 限幅场景自适应）
    - D4_STARTUP_GRACE_MS: 500 → 100
    - 新增 STALL_RETREAT_DONE_THRESHOLD = 5（Q2 决策）
    - StallConfig_t 新增 enableTimestamp 字段
    - LOCKED 入口一次性 ClearIntegral 清 RETREATING 累积的脏 I 项（Q1 A1 用户拍板）
    - RETREATING 阈值：1/10 圈 (5120 步) → 5 步（Q2 用户拍板）
    - RETREATING 期间每周期 STOP→POSITION 强制软重启 motion planner（决策 #18）
    - 启动豁免期判定：ClearStallFlag / enable 后 100ms 内不检测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
    [can_protocol.cpp, ctrl_step.cpp, ctrl_step.hpp, dummy_robot.cpp, interface_can.cpp, main.cpp, motor.cpp, motor.h]
2026-08-23 fix(stall): 全面审查+修复 13 个 Bug（偏差表 28/28 ✅）
    依据用户对固件的全面审查反馈，修复以下功能 Bug：
    P0（影响功能正确性）：
    - #1 ClearStallFlag 不发 0x7C IDLE 上报（偏差-24）：末尾主动发 CAN 帧，让主控 mask 立即清零
    - #7 RETREATING 软重启 motion planner 无效（偏差-18）：新增 ResetMotionPlanner() public 方法
    - #22 0x01 LOCKED 永久覆盖 ratedVelocity：移除该行，避免破坏 EEPROM
    P1（影响稳定性）：
    - #6 RETREATING 未拦截 0x03~0x07：与 LOCKED 同样策略
    - #19 DISABLE 不调 ClearStallFlag：0x01 false 分支补上
    - #24+#27 ClearStallMode 无条件发 SetEnable(true)：先检查电机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
    [ctrl_step.cpp, dummy_robot.cpp, interface_can.cpp, motor.cpp, motor.h]
2026-08-25 feat(stall): 完成堵转检测重构 — 三套电机固件 + 主控
    电机端:
    - 删除 isStalled/stalledTime/ClearStallFlag()/STATE_STALL
    - 新增 stallMode 枚举(IDLE/RETREATING/LOCKED) + 回退状态机
    - 堵转条件: 电流>75%限幅 AND 速度<10step/s AND 误差>50步 持续200ms
    - 回退: 35556步(关节)/51200步(地轨) → LOCKED → enable解除
    - CAN: 0x8A广播STALL, 0x8B广播UNLOCKED, 0x8C查询状态
    - 100Hz周期性广播(250ms间隔) + 2s超时兜底
    主控端:
    - can_protocol: 替换旧0x7C为0x8A(TRIGGER/DONE/TIMEOUT)
    - ascii_protocol: 新增!STALL_DIS/EN/STATUS/UNLOCK命令
    - dummy_robot: 重构SetStallMode() + 新增BroadcastUnlock()
    - SetStallMode(motorIndex)支持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
    [configurations.h]
2026-08-25 feat(stall): 修复 Bug-11 地轨反复堵转 + 0x5A 接收一致性
    主控 dummy_robot.cpp:
    - SetStallMode(motorIndex): 同步 targetRailPos = currentRailPos,
    避免 enable 退出 LOCKED 后主循环 500ms MoveRail 仍按堵转前目标下发,
    覆盖电机端 ResetGoalsToCurrentPosition() 设置, 导致再次堵转死循环
    电机固件 (35/42/57) UserApp/protocols/interface_can.cpp:
    - 0x5A 接收补充读取 stallNodeId (data[0]), 与 42 电机保持一致
    - 注释明确"本节点不检查(自己广播也可能收到回环)"
    文档:
    - 重构方案—堵转检测重构需求.md: Bug-11 完整记录
    - 重构方案—MoveJ速度与同步抵达—重构需求.md: §6 待办登记 T-1/T-2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
    [ascii_protocol.cpp, can.c, can_protocol.cpp, common_inc.h, ctrl_step.cpp, ctrl_step.hpp, dummy_robot.cpp, dummy_robot.h]
2026-08-25 fix(stall): 57 电机 250ms 周期广播改回 1=TRIGGER
    问题: 之前有人擅自将 57 motor main.cpp 第 130 行的 txData[1]
    从 1 (TRIGGER) 改成 4 (HEARTBEAT), 而 42/35 电机仍在发 1 (TRIGGER).
    后果:
    - 主控 can_protocol.cpp 仅在 stallCmd==1/2/3 时调 SetStallMode,
    4 (HEARTBEAT) 被忽略 (L185)
    - Bug-11 修复依赖 SetStallMode() 内同步 targetRailPos = currentRailPos
    每次收到 TRIGGER 时重置, 避免 enable 退出 LOCKED 后主循环 500ms
    MoveRail 按堵转前目标下发, 覆盖电机端 ResetGoalsToCurrentPosition()
    - 57 改为 HEARTBEAT 后该同步点不再触发 → Bug-11 死循环回归
    修复: 57 电机 250ms 周期广播发回 1=TRIGGER, 与 42/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
    [main.cpp]
2026-08-25 docs(stall): 补重构文档 §7 评估 + §8 未来工作，给 Bug-1~11 加修复状态标记
2026-08-27 chore: 添加 CMake 配置和重构 MoveJ 接口
2026-08-27 refactor(movej): v2.4 速度单位统一为电机轴 r/s + 7 轴迭代收敛同步
    核心改动：
    - 速度单位从 deg/s 改为电机轴 r/s，与电机端 CAN 0x07 ratedVelocity 一致
    - 新增 7 轴迭代收敛同步算法 ComputeSyncSpeeds，处理 slider + 轴上限钳制
    - 命名规范化：SetPositionWithVelocityLimit -> SetPositionWithMotorRps
    - MoveJ 新增 _slider 参数，移除 MoveRail/SetRailSpeed 旧路径
    - 删除 4 个电机固件 rail_motor.h，v2.4 不再依赖电机端地轨抽象层
    - 删除 #SPEED_RAIL 协议，统一通过 slider 控制
    新增常量：
    - SLIDER_TO_RPS = 0.30f，slider 1-100 -> r/s
    - AXIS_MAX_RPS[7]：地轨 30、关节 20
    - MOTOR_REDUCTION[7]：地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
2026-08-27 chore(serial-asst): 同步 v2.4 — 删除地轨速度 UI（#SPEED_RAIL 已废弃）
    v2.4 后地轨速度由 MoveJ slider 统一控制，不再需要独立
    地轨速度面板。保留地轨加速度（#ACC_RAIL）独立入口。
2026-08-31 v2.6: 加速度单位统一 + #GETJACC返回值修复 + 命令队列加固
    重构:
    - 删除 jointAccBases 双层语义(基准×百分比)，改用电机轴 r/s² 直通
    - EepromConfig 删除 jointAccBases[6]，EEPROM 结构缩小24字节
    - 新增 jointAccRuntime[8] 缓存，Init()末尾调用 SyncAllMotorAcceleration() 从电机读真实值
    - 新增 #SYNC_ACC 命令，向8个电机发CAN 0x2C查询，异步刷新runtime缓存
    - 删除 #ACC_BASE_J 和 #ACC_RAIL 旧命令，#ACC_J 统一为1~9节点的入口
    - SetCommandMode 不再自动改加速度，由 SyncAllMotorAcceleration 接管
    Bug修复:
    - can_protocol.cpp 三处 0x2C 回包(地轨/J1~J6/夹爪)原只写缓存不打印
    现同时 p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
    [ascii_processor.hpp, ascii_protocol.cpp, can_protocol.cpp, dummy_robot.cpp, dummy_robot.h, main.cpp, motor.h, 串口助手.py]
2026-08-31 refactor: v2.7 加速度感知同步抵达算法
    - ComputeSyncSpeeds：复刻电机端梯形曲线模型，按 jointAccRuntime[] 算时间预算
    - 迭代收敛 7 轴同步抵达，cap 钳制保持物理上限
    - AXIS_MAX_RPS 关节 cap 20->30，与电机端 boardConfig.velocityLimit 对齐
    - 消除 slider>=67 后所有关节档位饱和的非线性
2026-08-31 fix: ComputeSyncSpeeds 修复 disc<0 临界跳速 + sliderSpeed 软上限
    Bug1: disc = T²-4d/a 在距离/时间临界时浮点偶发为负，原代码直接给 cap
    导致短距离运动突然飙到物理上限。改为钳到 0，让反推公式自然算出
    '刚好够用'的速度。
    Bug2: 反推出的 v_needed 只检查物理上限 (vc)，不检查用户意图 (sliderSpeed)。
    加一道钳制，让 slider 设的小档位真正生效，slider=50 不会跑出
    slider=100 的速度。
    实测场景：除 J2/J3 外其他电机转 180° 来回，体感速度时快时慢。
    根因是 Bug1 临界 + Bug2 sliderSpeed 没参与钳制。
    [dummy_robot.cpp]
2026-08-31 feat: unify firmware echo + GETJPOS 7 vals + slimmer UI logs
    ascii_protocol.cpp:
    - !START / !DISABLE / !STOP / !HOME / !RESET 统一返回 ok
    - GETJPOS / PRINTPOSE: 6 值 -> 7 值，首位 Rail(mm) + J1~J6(deg)，与 MoveJ 对齐
    串口助手.py:
    - 存储 / 加载点位日志显示完整 7 值（原来只显示前 3 个）
    - listbox 用短名 #N，日志用全名
    - 精简 14 条与 TX / 固件回显重复的 INFO 日志
    TODO.md:
    - 新建待优化清单：OPT-1 串口 ok 响应处理算法优化
    [ascii_protocol.cpp, 串口助手.py]
2026-08-31 docs: BUG-1 !START 不自动归位 + STALL_STATUS 限流 500ms + 0x5C 单播排除广播
    [ascii_protocol.cpp, can.c]
2026-08-31 stall: 调参 (vel>100 step/s, current*60%, duration=50ms, clear>200)
    [interface_can.cpp, motor.cpp, motor.h]
2026-08-31 stall: 激进放宽 (vel<50, cur*40%, err>15, dur=30ms, clear>150)
    [interface_can.cpp, motor.cpp, motor.h]
2026-08-31 docs: 同步堵转检测 v3 激进方案 (40%/50/15/30ms + Recheck)
2026-09-01 新增FEAT-1回位指令需求；清理!START误加的Resting调用
2026-09-01 docs+feat: 堵转检测重构 + slider 速度调查 (BUG-3/4/5/6)
    TODO.md: 新增 4 条条目
    - BUG-3 (P0): !STALL_STATUS 响应硬编码、与电机端 printf 格式/通道不一致
    - BUG-4 (P1): !STALL_STATUS 查询时节点 5、6 不回包
    - BUG-5 (P1): 串口 ClearCommError failed 卡死 (PermissionError 22)
    - BUG-6 (P1): slider 1-100 速度变化不明显; Homing/Resting 速度含义不清
    dummy_robot.{h,cpp}: 添加 isStalled 标志 + IsStalled() 查询接口
    - SetStallMode() 标记 isStalled=true 拦截运动指令
    - SetEnable(true/false) 清除 isStalled 标志
    - 头文件新增 bool isStalled = false; 成员变量
    ascii_protocol.cpp: 堵转状态下的指令处理 (~15 行)
    串口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
    [ascii_protocol.cpp, dummy_robot.cpp, dummy_robot.h, 串口助手.py]
2026-09-01 删除MoveJ界面的Rail左右移动箭头功能，地轨移动已融入MoveJ命令
2026-09-02 chore: 清理 TODO.md BUG-4~6 + 修正夹爪开度注释 + 新增 BACKHOME 设计文档
    - TODO.md: 删除已归档的 [BUG-4] [STALL_STATUS 节点5不回复]、[BUG-5] [串口 ClearCommError 卡死]、[BUG-6] [slider 速度不明] 三个 BUG 章节
    - dummy_robot.h: StepHand::OpenedAngle/ClosedAngle 注释澄清电机角与夹爪物理状态的实际对应关系，修正 SetAngleWithSpeedLimit 的 _angle 注释 (0=完全闭合, 100=完全张开)
    - 新增功能—回位指令BACKHOME设计.md: 7 轴机械臂自动回零 (BACKHOME) 指令设计文档
    [dummy_robot.h]
2026-09-02 fix: !START 抖动修复 + ApplyPosAsHomeOffset 同步 + ascii 乐观同步清理
    1. **P1-2 (!START 抖动)**: ResetGoalsToCurrentPosition() 通过 SetPositionSetPoint()
    间接给 goalPosition 加上了 encoderHomeOffset,导致每次 !START 后电机走 offset 步
    - 修复: 42/35/57 motor.cpp 中直接 goalPosition = estPosition,绕过 +offset
    - gripper 无此函数,无需修改
    2. **Bug1 (ApplyPosAsHomeOffset 失同步)**: 归零后 realPosition 未与
    encoderHomeOffset 同步,导致 #GETJPOS 跳变
    - 修复: 4 份 motor.cpp 都加上 realPosition = encoderHomeOffset
    3. **Bug2 (ascii_protocol 乐观同步竞争)**: 主控在发 0x23 命令后立即
    乐观更新状态,与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
    [ascii_protocol.cpp, motor.cpp, 串口助手.py]
2026-09-02 fix: !RGB_BRIGHT 查询回复改为带前缀格式，避免被 Python 工具 isdigit() 过滤
    原回复为纯数字（如 80），与固件入队回执的队列剩余空间数字冲突，被串口助手.py 的 line.isdigit() 过滤丢弃。改为 RGB_BRIGHT <数字> 格式后既可通过过滤，日志也更具可读性。
    [ascii_protocol.cpp]
2026-09-02 fix: 夹爪回零语义修正 + 串口助手阻塞切换 + 按钮 toggle 化
    1. 夹爪回零 (firmware)
    - dummy_robot.h: StepHand 构造 inversion=true；OpenedAngle/ClosedAngle 重命名为 OpenMotorAngle/ClosedMotorAngle，明确 pos0=闭合、pos100=正方向 100 圈撞限位张开
    - ascii_protocol.cpp: !HAND_ZERO 增加阻塞等待电机 AllAtTarget(2°/10s)，避免标定时电机还撞限位就把当前脏位置写入零点
    - 文档注释更新：!HAND_O/HAND_C 方向反转说明清理
    2. 串口助手 (Python UI)
    - 新增'阻塞(等ok)/非阻塞' toggle 按钮，绑定 #CMDMODE 1/2 命令
    - 抽 _make_toggle_button 通用工厂，替换所有 Checkbutton 为 toggle 风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
    [ascii_protocol.cpp, dummy_robot.h, 串口助手.py]
2026-09-02 fix: 去除 SEQUENTIAL 模式 MoveJ/MoveL 阻塞，解决后台单线程卡顿
    问题：
    - 在 COMMAND_TARGET_POINT_SEQUENTIAL (CMDMODE=1) 模式下，ParseCommand
    的 '>'/'&' MoveJ 和 '@' MoveL 分支里有 while(context->IsMoving()) osDelay(5)
    - 后台消费者是单线程（CommandHandler::ThreadFunc），被电机运行时间整个卡住
    - 同帧到达的几条命令全堆在 FIFO 队列，表现为'每条运动完才回 ok'的一卡一卡
    修复方案：
    - 删除两处 while(IsMoving) 阻塞（FIFO 不再被堵）
    - SEQUENTIAL 模式下若电机还在动，新指令按设计意图直接丢弃，回 ok
    - 保留'上一条做完再做下一条'的用户语义，但任务路径不再 sl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
    [dummy_robot.cpp]
2026-09-02 反向57电机
2026-09-02 chore: 重命名 BACKHOME 设计文档（新增→新功能）
2026-09-02 删除主控固件中 !RAIL_L/!RAIL_R 左右移动指令及 MoveRailRelative 函数，地轨移动已整合入 MoveJ 命令
2026-09-03 修复 dummy_robot.cpp 和 ascii_protocol.cpp 编译错误：补上 MoveJoints for 循环闭合括号，删除 ascii_protocol.cpp 中残缺的 else if 行
    [ascii_protocol.cpp, dummy_robot.cpp]
2026-09-03 docs: 新增 IsMoving() 重设计分析文档
2026-09-04 docs: 迁移到 docs/ 目录，合并 rules，并记录 [BUG-4] 急停延迟
2026-09-04 fix: mt6816_base.h add missing return 0 in virtual stub function
    SpiTransmitAndRead16Bits() declared returning uint16_t but base class
    stub had no return statement, causing compiler warning. Added { return 0; }
    to all 4 motor firmware copies (35/42/57/gripper).
    Also moved 主控助手.py from docs/ to project root.
2026-09-04 docs: 新增主控固件回归分析报告（旧版基础逻辑 vs v2.7/v2.8 新功能）
    完整对比 source code/dummy-ref-core-fw/ 旧版与 firmware/ref_core_f405/ 新版，识别 6 个用户痛点对应的根因：
    - U1/U3: UpdateJointAnglesCallback 不再写 jointsStateFlag，OLED */_ 永为 _
    - U2: DEFAULT_COMMAND_MODE 从 INTERRUPTABLE 改为 SEQUENTIAL，上电模式变了
    - U4: UpdateJointAngles() 改为 4 组轮询，关节角度同步降到 25Hz/关节
    - U5/U6: IsMoving() 用位置误差判定导致 !STOP 失效、!DISABLE 死循环
    明确划分：保留 9 大类新增功能（堵转协议 v3、同步抵达、加速度缓存、SERVO_J/TRQ 模式、力矩 100Hz 重发等）与 6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
2026-09-04 chore: 清理临时分析产物，gitignore 增加 diff_*.txt/temp_*.txt 规则
    删除 26 个 .txt 工作草稿（diff_*.txt 4 个 + temp_*.txt 21 个 + git_log.txt 1 个，共 6,637 行），
    全部是回归分析期间的中间产物（diff 输出 / 旧版新代码快照 / git log 导出），
    已无保留价值，正式交付物为 docs/主控固件回归分析_2026-09-04.md。
    .gitignore 新增两条规则防止再次积累。
2026-09-04 docs: 删除 IsMoving 分析文档，新增主控固件退化修复和固件对比分析文档
2026-09-04 删除临时分析文档：主控固件回归分析_2026-09-04.md
2026-09-14 fix: 主控固件回归分析 - 实测根因复盘及恢复规划
    - 添加实测回归文档 (2026-09-14)
    - 添加恢复ALL代理详细规划
    - 添加电机固件对比分析 (当前vs旧版 2026-09-05)
    - 更新主控固件退化修复需求文档
    - 更新 ctrl_step 驱动 (cpp/hpp)
    - 更新 dummy_robot 实例
    - 更新 PROJECT_GUIDANCE 规则
2026-09-14 docs: 更新主控回归分析文档
    - 更新实测根因复盘文档 (2026-09-14)
    - 更新恢复ALL代理详细规划
    - 删除 START启动bug 文档 (已废弃)
    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
2026-09-15 refactor: 主控固件重构 - ALL代理统一规划与分步执行
    - 添加 ALL代理统一规划文档 (2026-09-15)
    - 添加 ALL代理分步执行文档
    - 添加 ALL代理统一执行规划 (全面实施)
    - 添加 地轨改为J7(CAN_ID7) 重构设计
    - 添加 连续指令执行ALL代理机制设计
    - 更新 TODO.md
    - 清理旧测试脚本
    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
2026-09-15 refactor: 更新 PROJECT_GUIDANCE 和 dummy_robot.h
    - 精简 PROJECT_GUIDANCE 规则
    - 更新 dummy_robot.h 头文件
2026-09-15 refactor: 地轨CAN_ID从9改为7 (J7)
    - 地轨CAN_ID改为7，与J7统一
    - 更新dummy_robot.cpp/h 地轨配置
    - 更新motor_fw_f103_57配置
    - 更新ascii_protocol.cpp命令解析
    - 更新can_protocol.cpp协议处理
    - 更新main.cpp初始化
    - 更新相关文档
2026-09-16 docs: ALL代理文档整合为单一方案
    - 删除旧版ALL代理分散文档
    - 新增ALL代理整合方案 (2026-09-16)
2026-09-16 refactor: CAN通信层统一重构
    - 更新所有电机固件(motor_fw_f103_35/42/57/gripper)的CAN接口
    - 更新主控ref_core_f405的CAN通信层
    - 更新dummy_robot.cpp/h地轨J7配置
    - 更新ctrl_step.cpp电机控制接口
    - 更新docs/README.md文档
    - 新增build_output.txt构建输出
    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
2026-09-16 refactor: 主控固件核心模块更新
    - 更新dummy_robot.cpp地轨J7配置
    - 更新main.cpp初始化逻辑
    - 新增9-14真凶收尾详细规划文档
    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
2026-09-16 refactor: 主控协议更新及文档完善
    - 更新9-14真凶收尾规划文档
    - 新增机械臂连续动作追踪记录文档
    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
2026-09-16 docs/refactor: 主控固件注释清理（仅注释，不影响行为）
    清理 firmware/ref_core_f405/ 下 6 个 .cpp 文件中的冗余注释：
    - 翻译型 / 复述型（// Int to Bytes, // Float to Bytes, // Need ACK 等）
    - 调试残留（// AN test, /* 调试用 */, // XXX 临时）
    - 旧实现备忘 / 过期 FIXME / 显而易见字面翻译（// 关闭电机 紧跟 MotorOff()）
    保留所有决策链：
    - [F1-5 修复] [A1-7] [PID 修复] 等决策标签（22 处全部保留）
    - 行为约束 / 副作用警告 / ISR 共享变量访问顺序约束
    - .h/.hpp 公开 API Doxygen 注释 / 文件顶部 banner / 解释 'why' 关键注释
    - 物理参数公式（如 angle = 圈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
2026-09-16 docs: 重命名追踪文档并更新TODO
    - 重命名机械臂连续动作追踪记录文档(9-16日期命名)
    - 更新docs/TODO.md
2026-09-16 fix: 主控固件修复及诊断日志完善
    - 更新ascii_processor.cpp通信处理
    - 更新dummy_robot.cpp机器人控制
    - 更新ascii_protocol.cpp命令协议
    - 新增心跳定位排查文档
    - 新增35电机stall保护分析文档
    - 新增构建诊断日志
    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
2026-09-16 chore: 删除临时诊断文件，新增实测描述
2026-09-16 chore: 整理分析文档到docs/fixbug目录，删除临时构建日志
2026-09-17 docs: 新增answer.md分析文档，更新实测描述
2026-09-17 添加回归测试9-17.txt
2026-09-21 chore: 重构分析文档及旧版固件备份入库
    - docs/refactor/: 新增firmware与firmware_old对比分析、重构需求文档
    - firmware_old/: 旧版固件备份(dummy-35motor-fw/dummy-42motor-fw/dummy-ref-core-fw)
    - .gitignore: 移除source code排除规则
    - 删除旧分散的分析文档(answer.md/docs/README.md等)
2026-09-21 docs: 移动部分文档到 another 子目录
2026-09-21 feat: 新增 firmware_new 目录及重构文档，重建固件开发结构
    - 新增 firmware_new/ 目录（dummy-35motor-fw, dummy-42motor-fw, dummy-ref-core-fw）
    - 新增 docs/refactor/电机固件重构—firmware_old到firmware_new—2026-09-21.md
    - 新增 docs/refactor/重建需求草稿—firmware_new—2026-09-21.md
    - 更新 docs/refactor/电机固件对比—firmware_old迁移到firmware—2026-09-21.md
    - 更新 .cursor/rules/PROJECT_GUIDANCE.mdc
2026-09-21 docs: 更新电机固件对比文档，补充 Set Position/Set Pos w/ VelLimit 重构说明
2026-09-21 docs: 更新主控固件对比文档，完善 v3.0 变更细节
2026-09-21 docs: 完善主控固件对比文档
2026-09-22 docs: 重构 firmware_new 电机固件决策文档，更新对比文件命名
2026-09-23 docs: 新增 firmware_new 电机固件决策与实施文档
2026-09-23 docs: 更新 firmware_new 电机固件实施文档
2026-09-23 feat(motor): 初步重构 dummy-motor-fw，统一电机固件架构
    - 统一目录结构: Ctrl/Driver, Ctrl/Motor, Ctrl/Sensor, Port/Platform
    - 抽象驱动层: TB67H450, MT6816 编码器, 按钮/LED
    - 统一构建: CMake 多目标 (motor-35/42/57/gripper)
    - 新增配置层: configurations.h, stockpile 参数存储
2026-09-23 fix: motor.h static constexpr + CMake add_link_options 累积 bug 修复
2026-09-23 docs: 新增 firmware_new 主控固件决策与实施文档
2026-09-23 refactor: dummy-ref-core-fw 重构主控固件
    - 新增 CMake 构建系统 (cmake/, build/)
    - 精简 ascii_processor/communication/interface_* 通信层
    - 重构 dummy_robot 机器人实例
    - 重构 ctrl_step 执行器接口
    - 重构 FreeRTOS 任务架构与协议层
    - 清理冗余配置文件与旧文件
2026-09-24 feat(ref_core_f405): 删除主控 stall 堵转检测逻辑 v3
    - 删除 SetEnableStallProtect() 方法及 Fibre 协议暴露
    - 删除 SetDceKp/Kv/Ki/Kd() / QueryDceKp/Kv/Ki/Kd() PID 调参接口
    - 清理 Homing/Resting 超时调试输出中的 STALL state 注释
    - 删除 dummy_robot.h 中关于堵转的注释
    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
2026-09-24 feat(串口助手): 删除 stall 堵转相关 UI 与命令
    - 删除堵转检测保护 Checkbutton (stall_row)
    - 删除查询堵转状态按钮
    - 删除 _cmd_stall_protect() / _cmd_stall_status() 回调
    - 删除 _update_stall_status_from_response() 响应解析
    - 删除 STALL_STATUS 响应拦截分支
2026-09-24 feat(docs): 新增主控固件重构模块文档
    - 新增 16 个模块文档 (01~16)
    - 更新 firmware_new主控固件决策.md
    - 删除旧版 firmware_new主控固件实施.md
2026-09-24 docs(refactor): 更新主控固件模块文档
    - 补充修复记录文档(阻塞回OK与OLED同步)
    - 完善 01_运动指令-MoveJ&MoveL.md (新增内容较多)
    - 完善 02_运动完成判断-IsMoving.md
    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
2026-09-24 feat(01-module): 完成 MoveJ/MoveL 模块改造
    - 01_运动指令-MoveJ&MoveL.md 完善 MoveJ/MoveL 设计
    - 决策文档同步刷新
    - 阻塞回OK/OLED同步修复记录
    实现:
    - Robot/instances/dummy_robot.{h,cpp}: 重构运动指令接口 (-116/+80)
    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
2026-09-27 feat(02-03-module): 退回 UpdateJointAngles 广播策略与 IsMoving 严格公式
    - dummy_robot.cpp
    - UpdateJointAngles() 改回 ALL 单帧广播（OLD 策略，无丢包）
    - 删除 SetEnable 后预发 UpdateAngle
    - IsMoving() 改回严格 OLD 公式 0b01111110（不做失能短路，依赖 EmergencyStop 兜底）
    - main.cpp
    - 移除各模式分支的 UpdateJointAngles() 调用，整合到默认分支统一刷新
    - 02_运动完成判断-IsMoving.md 更新（严格 OLD 公式 + 失能短路说明）
    - 03_关节角度同步-UpdateAngle.md 更新（广播策略与 CAN 路由说明）
    - 修复记录（阻塞回OK/OLED同步）归档至模块目录
    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
2026-09-27 docs(another): 更新 TODO 进度（2026-09-27）
    更新 Dummy 7轴机械臂项目待开发项状态。
2026-09-27 feat(04-05-06-module): 完成 EStop / CommandMode / OLED 模块文档与实现
    - OLED 第 6 行 F3 恢复 OLD 样式 [CMD] __*_*__ 状态横幅
    - 使能时按 bit 渲染 '*' (FINISH) / '_' (RUNNING/STOP)
    - 失能时显示 ======
    - ascii_protocol.cpp
    - CMDMODE UART4 路径补 'ok ' 前缀，与 USB 路径回包格式统一
    - 04_急停-EStop.md
    - 决策 #3/#5 补充：F5 决策后 EmergencyStop 第 2 步 flag = ALL_FINISH_FLAG
    是释放 SEQUENTIAL 阻塞循环的唯一手段
    - 2026-09-27 审查记录 + 禁止事项强化
    - 05_命令模式-CommandMode.md
    - 6 模式 cmdModeNames 列表与 5kHz 实时环频率策略补充
    - SERVO_J 入口暂关 / TO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
2026-09-28 fix(ascii): 修复 USB/UART4 协议命令缺失（双串口bug）
    BUG 1（USB 路径 OnUsbAsciiCmd）:
    - 缺失 !HAND_I 命令: 夹爪无法通过 USB 接收电流透传
    - 新增 !HAND_I <A> 分支: SetCurrentSetPoint + 'ok hand current' 回包
    - 注释: <A> 正值闭合 / 负值张开 / 0 解除, 不修改 StepHand::current 幅值
    BUG 2（UART4 路径 OnUart4AsciiCmd）:
    - 缺失 !START 命令: 上位机无 UART4 唤醒接口（与 !DISABLE 不对称）
    - 新增 !START 分支: dummy.SetEnable(true) + 'ok' 回包
    - 同步新增 !HAND_I 分支, 与 USB 协议保持双通道一致
    影响: 双串口 ASCII 协议命令集对齐, USB 支持夹爪电流调试, UART4 支持热启动。
2026-09-28 feat(串口助手): v3.5 同步新固件 CMDMODE 与顺序发送策略
    重构点:
    - 删除旧的 cmd_block_mode_var / _make_cmd_block_toggle 阻塞切换按钮
    - 新增 current_cmdmode 本地缓存, 与固件 CMDMODE 单向同步 (默认 INT=2)
    - 「模式」按钮回调改用 _set_cmdmode, 模式日志显示中文别名
    顺序发送 (send_all_positions) 重写:
    - 新增 _pos_queue_strategy: 'step' (旧, INT 等覆盖式模式用)
    : 'batch' (新, SEQ/TRJ 用, 固件阻塞串行消费)
    - SEQ(1)/TRJ(3) 模式: 批量 FIFO 推送全部点位, 不在 PC 端逐条等 ok
    改由串口接收线程累计 ok 数到 total 判定完成
    - 其他模式: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
2026-09-28 fix(串口助手): 串口发送改为单写线程 + 波特率硬编码 115200
    并发写入:
    - 新增 _tx_queue (queue.Queue) + _serial_write_lock + 守护发送线程
    _serial_write_loop, send_cmd 改为入队由该线程统一写出
    修复 UI 线程与拖发线程并发 write 同一串口导致的指令交叉/帧损坏
    - MoveJ 拖发路径 (50Hz) 复用 _serial_write_lock, 与队列发送互斥
    - 停止顺序: 先排空队列残留, 再投 None 哨兵, 最后 join(2.0)
    (反序会让哨兵被清空吞掉, 线程收不到停止信号而永久泄漏)
    - 写失败统一走 root.after(0, ...) 回主线程打日志, 避免跨线程操作 Tk
    波特率:
    - 新增模块级 BAUDRATE = 115200, 与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
2026-09-28 docs: 删除已被 firmware_new 重构路线取代的过程文档
    清理 14 份过期中间稿，合计 6707 行。
    docs/fixbug/ (10 份，2026-09-14~16):
    - 63b4b16版本-5问题形式分析
    - 9-16-23-30问题分析
    - 主控固件回归—2026-09-14实测根因复盘
    - 主控固件回归—9-14真凶收尾详细规划
    - 主控固件退化修复—全面重构需求
    - 主控固件重构—ALL代理整合方案
    - 主控固件重构—地轨改为J7(CAN_ID7)
    - 发送就卡死—心跳定位排查方案
    - 注释清理—候选清单 / 注释清理—执行报告
    以上均围绕 firmware_old 主控固件的一次回归定位展开，其结论已被
    docs/refactor/firmware_new主控固件模块/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
2026-09-28 docs(校准与归零): 重写为 #OFFSET_J 卡死 OLED/RGB 根因分析
    原文 94 行的模块说明扩写为 457 行根因分析，标题改为
    「#OFFSET_J 卡死 OLED/RGB — 根因分析与恢复 CalibrateHomeOffset 语义」。
    现象:
    enabled 态下发 #OFFSET_J all / #OFFSET_J 1 后, RGB 灯效与 OLED
    显示卡死不刷新, 但机械臂仍可运动 —— 系统未真正死机, 仅 UI 线程被饿死。
    根因:
    新版 #OFFSET_J 只下发 ApplyPositionAsHome() (一帧 0x15) 后立即返回,
    而 5kHz 实时环仍处 enabled 分支, 每 20ms 向 7 路电机发 MoveJoints,
    与归零回包争抢 CAN mailbox。旧版 !CALIBRATION 走 CalibrateHomeOffset(),
    先把 isEnabled 置 false 让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
2026-09-28 feat(串口助手): 新增旧固件版串口调试工具 串口助手_old.py
    面向 firmware_old/dummy-ref-core-fw 的精简调试工具，与新版 串口助手.py
    配套，界面风格与线程模型保持一致，但只暴露旧固件 ASCII 协议真正支持的
    指令，避免下发新版命令后干等超时。
    指令集（旧协议）:
    - !START / !DISABLE / !HOME / !RESET / !CALIBRATION / !STOP
    - #CMDMODE <1|2|3>
    - #GETJPOS（6 个数）/ #GETLPOS（6 个数）
    - #REBOOT <1..6>
    - >j1..j6,speed / @X,Y,Z,A,B,C,speed
    与新版的行为差异:
    - 波特率固定 115200
    - #OFFSET_J 系列不支持（旧固件用 !CALIBRATION），故本工具不提供
    - 彩灯、参数整定、电流设定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
2026-09-28 chore(rules): 项目指南标题更正为 6轴 + 地轨 + 夹爪
    机械臂本体已去掉 J7（6 个关节），标题仍写「7轴」与实际架构不符。
    正文其余内容保持不变，本次仅更正标题一行。
2026-09-28 chore: 删除根目录 !Start 卡死问题的实测草稿
    回归测试9-17.txt（224 行）与 实测描述.txt（43 行）是 2026-9-16/17 排查
    「发 !Start 不返回 ok 且卡死、RGB 与 OLED 不刷新」时写的现场记录，内容为
    逐次实测日志、固件 commit 哈希比对，以及 A~D 四种形式的排查设想。
    结论已沉淀到 docs/refactor/firmware_new主控固件模块/12_校准与归零.md
    （#OFFSET_J 卡死 OLED/RGB 根因分析），草稿无保留价值，故删除。
2026-09-28 chore: .gitignore 忽略 *.log 构建日志
    build/ 已被忽略，但 CMake/Ninja 的 build.log 与 configure.log 写在各固件
    工程根目录（firmware_old/*/），一直没被覆盖到，每次编译都会重写，且含本机
    绝对路径，提交后只会产生无意义 diff。
    补充 *.log 到 Build outputs 段。
2026-10-01 wip: 关节角度更新机制与J2-J6卡顿问题分析（待解决）
2026-10-01 fix(ref-core-fw): replace ALL angle query with 6 individual queries
    §8.10 落地。UpdateJointAngles() 改为循环发送 6 条个体 0x23 查询，
    消除广播应答撞车丢帧问题（J1 必赢 + 1 随机赢，其余 4 条永久丢）。
    改前：50Hz ALL → ACK 100/s（5/6 丢）
    改后期望：50Hz × 6 个体 → ACK 300/s（6/6 全收）
    修改：
    - Robot/instances/dummy_robot.cpp:160-163 UpdateJointAngles 循环 6 个体
    - docs/SESSION_STATUS.md 记录 §8.10 落地状态
    总线负载 1.7% → 6.7%，不影响 MoveJ 路径（§8.9 防御逻辑保留）。
    夹爪 (id=8) 不参与此函数；地轨 (id=7) 后续扩展时单独加。
2026-10-01 fix: 关节角度更新机制与J2-J6卡顿问题修复完成
2026-10-02 feat: 地轨(id=7)电机驱动与主控集成（方案文档+ctrl_step执行器+dummy_robot+电机/主控固件+串口助手同步）
2026-10-02 地轨电机加入oled
2026-10-02 地轨加入GETJPOS和REBOOT方案
2026-10-03 Step1: 夹爪加入主控 - 修DummyHand致命bug
2026-10-03 Step2: handcode夹爪实现对比与迁移方案
2026-10-03 Step2: handcode夹爪实现对比迁移 - 补全can_protocol/handcode
2026-10-03 Step3: ascii_protocol补全夹爪节点支持
2026-10-03 Step4: ascii_protocol夹爪节点支持完善
2026-10-03 Step6: 串口助手_old.py夹爪节点支持
2026-10-03 Complete: hand夹爪加入全部工作 - ctrl_step/dummy_robot/ascii_protocol/串口助手_old
2026-10-04 Feat: 查询端补齐方案初步落地 - 主控/电机端CAN协议查询支持（待修bug）
2026-10-04 Feat: 查询端补齐方案优化，部分bug待修复
    - 补齐查询端逻辑优化（位置/速度/加速度/力矩查询）
    - 主控协议增强（支持 ?POS/?VEL/?ACC/?TRQ 命令）
    - 电机端 ctrl_step 补齐状态响应
    - 串口助手_old.py 同步更新查询指令
    - 部分逻辑仍有待调试修复
2026-10-04 完成- PID、加速度、最大电流的查询与设置
2026-10-04 完成- 加速度/速度单位统一：r/s、r/s²
    - 速度 1-100 逻辑：满速 30 r/s
    - 最大时间 + 加速度梯度算法：真实同步抵达
2026-10-05 完成stop软停方案
2026-10-05 feat: 增加八节点异步加速度同步及完成回执
    将串口助手的加速度同步按钮改为发送独立的 #SYNC_ACC 指令，让用户能明确判断同步是否完成。
    - 主控后台分批查询八节点，通过请求编号识别本次回复，避免旧回包被计入。
    - 接受请求后返回 pending，八节点有效回复齐全并更新主控缓存后返回 finish；支持超时缺失节点、非法值、重复请求和STOP取消回执。
    - 串口助手支持回执分段拼接、等待期间禁用重复点击及超时恢复，并提示建议在失能状态下同步。
    - 更新 SESSION_STATUS，记录实现、验证结果及实机反馈。
2026-10-06 为堵转检测和自动退回做准备
2026-10-06 feat: 实现堵转自动回退与校准，记录实机待修问题
    完成 firmware_new 主控、电机与串口助手_old 的堵转保护、自动回退、STOP 融合及 CALIBRATION 基线实现。
    主控和 35/42/57/gripper 四种电机固件已编译，离线验证通过；本提交保存实机修复前基线，不代表实机验收通过。
    实机日志确认的待修问题：
    - 七次 NODE_OFFLINE_OR_RESTART 被统一打印为 STALL，不能区分探针超时与范围配置失效，静止 J7 也会触发。
    - START 范围下发阶段未刷新健康探针；普通角度回包不计入在线时间，健康检查与新探针使用不同 flags 缓存。
    - 两端 CAN 关闭自动重传，进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
2026-10-06 chore: 保存普通运动完成确认修复前基线
    保存堵转通信、CAN可靠回包及第一轮普通运动完成确认实现，供后续修复回退。
    实机待修问题：
    - HOME完成后OLED完成标记反复切换，手动扰动也会撤销已完成状态。
    - 普通FINISH判稳过细及逐轴查询使完成回复延迟。
    - 用户已确认SEQ模式，新目标尚未到位时仍出现同秒ok；具体回复出口尚未逐次定位。
    - 当前完成资格、最新位置、任务结果和裸ok回复归属尚未完整分离。
    后续按用户批准的任务状态、目标代次、实时确认和编号回执方案修复；本提交不宣称实机问题已解决。
2026-10-06 fix: 完成普通运动任务确认并记录七轴同步待修问题
    上一轮已完成：
    - 普通运动分配任务编号，隔离任务代次、模式和回复来源，原子发布七轴目标及速度快照。
    - 目标READY与同轮实际停稳共同确认完成，拒绝过期反馈；SEQ按本条任务完成推进。
    - 电机本地FINISH历史与实时SETTLED分离，OLED进度锁存；保留50ms实际判稳及0.1度/0.1mm容差。
    - HOME/RESET/MOVEJ回执明确任务编号与接受/完成/取消语义，串口助手old匹配编号并确认真实模式。
    - 完成五类固件编译及源码回归；用户实机复测未再出现此前提前ok及OLED反复跳动问题。
    已知待修：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
2026-10-06 fix: 修复七轴普通目标发送并记录完成回执延迟
    已完成：
    - 主控普通0x07目标关联节点、epoch/generation和硬件邮箱，区分HAL入邮箱与实际TXOK。
    - ALST/TERR/abort后5/10/15ms错相重试，轮换首发节点；TXOK后使用新nonce确认目标READY。
    - 取消、STOP、DISABLE及新任务撤销旧在途目标；结果回调独占释放发送令牌，避免旧结果污染新任务。
    - 目标建立采用100ms首次TXOK/300ms READY/16次入邮箱预算，失败复用七轴软停保持并明确报错。
    - MOTION_STATUS增加分轴发送、READY、规划完成、实际位置和停稳观察时间及规划参数、重试计数。
    - 同步公式、电机固件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
2026-10-06 fix(rail): adopt validated J7 DCE defaults and allow 3A current setting
    Set the MOTOR_TYPE=57 default DCE gains to KP=300, KV=50, KI=30, KD=100
    after the user's bidirectional 100-speed rail test removed the observed tail.
    Three SEQ round trips now differ by 16, 25 and 23ms. Reducing KD alone had
    left a 547ms direction difference; do not attribute the result to one gain.
    Keep valid EEPROM settings and other motor defaults unchanged.
    Include the previously authorized 57 current-setting cap increase to 3.0A
    (35/42/gripper remain 2.5A) and the old serial assistant's MOTION_STATUS button.
    Update the rail design document and session record with measured results,
    default activation rules, build ar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
2026-10-07 feat(encoder): add per-node CAN calibration control
2026-10-07 fix(protection): 修复堵转接管与末端误报并确定日常默认值
    普通目标采纳确认与电流命令饱和分开，避免低限流时以
    TARGET_READY_TIMEOUT打断真实堵转保护；饱和只作为独立诊断。
    首次保护事件在CAN中断仅锁定和记录，清队列及取消运动由任务接管。
    STOP确认公平轮询并仅对实际提交成功的帧计预算，首个回退GO获得
    一次发送机会；已有固定保持可安全绑定确认，STOP/CANCEL重试幂等，
    失败原因不被迟到CONTEXT响应覆盖，保留七轴停稳和串行回退。
    普通位置运动以实际和参考共同进入普通容差暂停堵转候选，实际完成
    后清运动意图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
2026-10-07 fix(calibration): 修复并行校准确认并采用实测默认参数
    J1～J6 坐标修正确认后等待 1 秒，再并行启动地轨与夹爪校准；只有两轴实际完成，才失能八轴并保存 EEPROM。
    修复搜索参考微过冲抢先触发行程保护，固定既定搜索边界；接触证明期限改为 1000ms 收敛余量加配置的连续触发时间，保留三条件连续判定、实际行程限制和 STOP/DISABLE 中断。
    新增 CAL_STATUS 运行与首次失败冻结快照，支持保护锁定后只读查询，并同步旧串口助手入口。
    将 J7/J8 校准默认值及旧助手编辑初值更新为最终实测回读值；合法 EEPROM 配置仍优先，不更改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
2026-10-08 feat(rgb): 实现灯环功能、独立AUTO颜色及old助手同步
2026-10-09 新增urdf相关文件和修改地轨默认pid
2026-10-09 feat: add selected motor default parameter restore
    Add disabled-state guards, verified erase/reboot completion and automatic
    parameter readback for the selected motor in the serial assistant. Restore
    base settings, STALL/CAL settings and zero offset while preserving the
    magnetic encoder calibration table. Honor node-specific CAL defaults and
    reset the J8 HAND_I current cap.
    Validated all five firmware builds, native protection regressions and
    65 Tkinter checks; BIN/HEX contents and application boundaries verified.
    Hardware flashing and validation remain pending.
2026-10-09 feat: add Dummy desktop controller with offline URDF visualization
    Add the standalone PySide6 control UI, migrated serial business logic, teaching storage, parameter handling, themes, offline robot models and viewer resources. Include 47 passing offline tests and packaging configuration; EXE validation remains paused with the QtCore loading issue documented.
2026-10-10 feat(firmware): 增加版本与 CAN 诊断并关闭 ADC 空通知
    加入九板构建身份、CAN 收发与控制时序诊断，同步 old 串口助手，并允许 STOP/CAL 中读取 MOTION_STATUS。关闭电机 ADC DMA 无业务用途的 HT/TC 通知，保留采样、循环传输和 TE。
    保留调查及交接历史文档。后续用户日志确认 J6 原运行 .02，补齐 .03 后，开启普通检测的 HOME、MoveJ 完成状态及 RESET 复测正常；前后时基差未再增加约一秒。具体中断阻塞机制未单独定案。
    本次仅提交已有改动，未实现请求号冲突修复或拟议 .04 优化。差异检查及 old 助手 Python AST 语法检查通过；未重新构建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
2026-10-10 chore: snapshot current gamepad and desktop development before stop fixes
2026-10-11 fix(firmware): isolate newlib state and align acceleration defaults
    Give FreeRTOS tasks separate newlib reentrancy state and serialize the shared
    allocator across task and USB interrupt contexts. Bound sbrk to the linker
    heap region, preserve MSP space, and handle allocation errors per task.
    Default all eight motor acceleration caches and seven planning fallbacks to
    30 r/s^2 while retaining actual-value readback.
    Validation: Ninja Release build, 37053 allocator checks, linked-hook and
    heap-bound verification. User reports no freeze on repeated MoveL and
    combined polling; supplied log has 1234 MoveL commands and 1140 complete
    MOTION_STATUS responses, followed by successful RESET and DISABLE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
2026-10-11 chore: snapshot current work before seven-axis host IK
2026-10-13 fix: reverse rail calibration toward -250mm endpoint
2026-10-13 fix(rgb): match STOP pulse timing to fault heartbeat
    Keep the default STOP color yellow while using the same fixed 1800ms
    heartbeat as FAULT. Migrate old default STOP bindings from valid v1/v2
    records in RAM and save v3 records so future custom bindings survive reload.
    Update RGB documentation and only the new RGB session status section.
    Validation: 31439 native assertions, all five ARM Release targets, and
    firmware identity, HEX/BIN, and linker partition checks passed.
2026-10-14 chore: snapshot native-only host and visuals before controller TCP rail work
2026-10-14 chore: snapshot native MoveL and preserved visuals before motor timing repair
2026-10-15 chore: snapshot F405 compute diagnostics and preserved work
    Add USB CBENCH v1 bounded computation with local DWT timing, an independent
    kinematic solver, fixed results, cancellation and disabled-only admission.
    Reuse the command task; block START and serialize calibration admission.
    No benchmark motor output, device connection, flashing or motion.
    Build all five targets as 2026101506 / A44FF1D6374E4FE0. Check linked
    resources and preserve motor bytes outside identity plus 20 kHz hot paths.
    Retain component, adapter, collector and native-motion host regressions.
    These tests are not F405 timing or hardware acceptance.
    Preserve rollback, RGB and viewer changes present at task start. Leave lat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
2026-10-19 fix(motor57): 调整地轨工厂默认 PID 为 150/180/25/50
2026-10-19 perf(start): 增加使能查询与配置推进的发送机会
2026-10-19 fix(rgb): 保留使能确认期间灯效并平滑双向汇聚
2026-10-19 fix(legacy-host): 完善 RGB 保存事务与安全请求等待
2026-10-19 feat(diag): 扩展主控纯计算诊断与 OLED 任务剖析
    包含诊断测试必需的冻结 bounded_cartesian_follow.h 对照头；独立 MoveL 研究入口与研究记录留在工作区。
    仅纳入现有纯计算诊断，不解除运动门禁。
    保留矩阵采集器原有CRLF字节哈希契约；LF导出及Windows字节表示复验记录均保留。采集器238个用例中226通过、2跳过；10个用例产生11个错误，均因固定16.06产物守护拒绝当前17.03；未放宽守护。现有正式产物manifest与主控UserApp/main.cpp不一致，本轮未重建，不将本提交绑定该产物。
2026-10-19 feat(host): 重构工作站界面、窗口交互与三维绘制
    仅整理现有界面和绘制内容，串口轮询接入留至下一提交。Node三维回归54项通过。Qt回归155个用例中3个用例产生4处失败：浅色布局边界1px差异、夹爪发送按钮高度30/34、快捷点旧父容器断言。未为整理修改实现或放宽测试，日志保留于firmware_artifacts/.qa/git-organize-20261019-204909/host-ui.log。
2026-10-19 perf(host): 解耦位置轮询、串口接收与界面刷新
    独立候选树的遥测、轴轮询、传输和控制器71项离线回归通过，208份上位机blob与暂存树逐份一致。首轮手动同步计数断言失败的记录保留，原因未确定，未修改实现或测试；不将独立复验通过解释为该潜在竞态已修复。所有物理串口入口默认禁止。
2026-10-19 chore(models): 同步根目录地轨拆分模型源文件
